Adept666/stompboxes/graphics/source_images/denis_belov.jpg

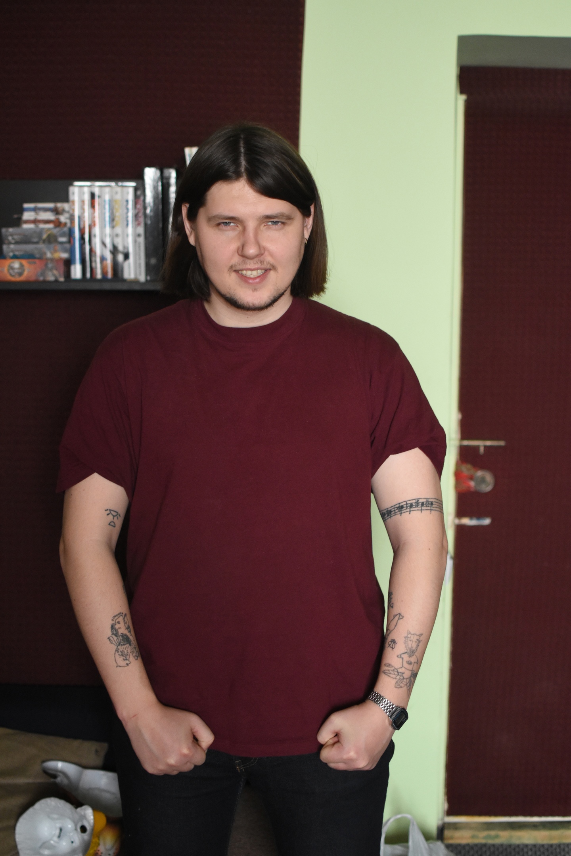
graphics/source_images/denis_belov.jpg
