Adept666/stompboxes/graphics/source_images/sasha_ogorodnikov.jpg

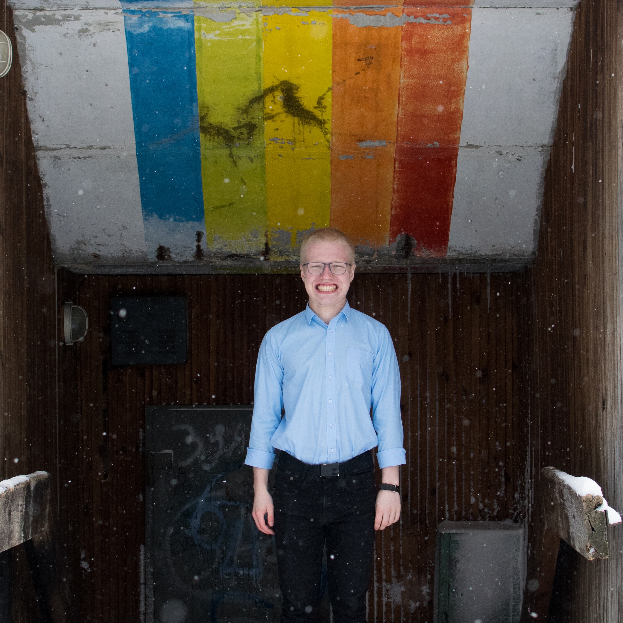
graphics/source_images/sasha_ogorodnikov.jpg
