Adept666/stompboxes/README.md

# -ТТКРЧПДЛ- / Тут короче педали

Здесь хранятся схемы и чертежи гитарных педалек *-ТТКРЧПДЛ-* (штаб-квартира: Омск, Сибирь). Купить педальки и задать вопросы можно через группу [ВКонтакте](https://vk.com/stompboxes), [Telegram-канал](https://t.me/stompboxes) или [Авито](https://www.avito.ru/brands/177f59860cf553edd7d790a341953521). Заценить звук можно на [YouTube-канале](https://youtube.com/channel/UCtStMn9qLL_V5MzlzgSMkUA). Поддержать можно с помощью [Boosty](https://boosty.to/stompboxes). Проект катастрофически убыточен и за семь лет съел тонну моих личных средств.

Distortion + PCBs

## Big Muff [REV3]

[Gerber](/PCBS-PCAS/ТКП-3.30.A/output/big_muff_r3a_gerber.zip)

### Bass

[Schematic](/PCBS-PCAS/ТКП-3.30.A/ТКП-1.30.A-2/output/ТКП-1.30.A-2-SCH.pdf)

[F_Fab](/PCBS-PCAS/ТКП-3.30.A/ТКП-1.30.A-2/output/ТКП-1.30.A-2-FAB-TOP.pdf)

[B_Fab](/PCBS-PCAS/ТКП-3.30.A/ТКП-1.30.A-2/output/ТКП-1.30.A-2-FAB-BOTTOM.pdf)

### Bass SM

[Schematic](/PCBS-PCAS/ТКП-3.30.A/ТКП-1.30.A-4/output/ТКП-1.30.A-4-SCH.pdf)

[F_Fab](/PCBS-PCAS/ТКП-3.30.A/ТКП-1.30.A-4/output/ТКП-1.30.A-4-FAB-TOP.pdf)

[B_Fab](/PCBS-PCAS/ТКП-3.30.A/ТКП-1.30.A-4/output/ТКП-1.30.A-4-FAB-BOTTOM.pdf)

### NYC

[Schematic](/PCBS-PCAS/ТКП-3.30.A/ТКП-1.30.A-1/output/ТКП-1.30.A-1-SCH.pdf)

[F_Fab](/PCBS-PCAS/ТКП-3.30.A/ТКП-1.30.A-1/output/ТКП-1.30.A-1-FAB-TOP.pdf)

[B_Fab](/PCBS-PCAS/ТКП-3.30.A/ТКП-1.30.A-1/output/ТКП-1.30.A-1-FAB-BOTTOM.pdf)

### NYC SM

[Schematic](/PCBS-PCAS/ТКП-3.30.A/ТКП-1.30.A-3/output/ТКП-1.30.A-3-SCH.pdf)

[F_Fab](/PCBS-PCAS/ТКП-3.30.A/ТКП-1.30.A-3/output/ТКП-1.30.A-3-FAB-TOP.pdf)

[B_Fab](/PCBS-PCAS/ТКП-3.30.A/ТКП-1.30.A-3/output/ТКП-1.30.A-3-FAB-BOTTOM.pdf)

## Big Muff [REV2]

[Gerber](/PCBS-PCAS/ТКП-3.13.A/output/big_muff_r2a_gerber.zip)

### Bass

[Schematic](/PCBS-PCAS/ТКП-3.13.A/ТКП-1.13.A-2/output/ТКП-1.13.A-2-SCH.pdf)

[F_Fab](/PCBS-PCAS/ТКП-3.13.A/ТКП-1.13.A-2/output/ТКП-1.13.A-2-FAB-TOP.pdf)

[B_Fab](/PCBS-PCAS/ТКП-3.13.A/ТКП-1.13.A-2/output/ТКП-1.13.A-2-FAB-BOTTOM.pdf)

### NYC

[Schematic](/PCBS-PCAS/ТКП-3.13.A/ТКП-1.13.A-1/output/ТКП-1.13.A-1-SCH.pdf)

[F_Fab](/PCBS-PCAS/ТКП-3.13.A/ТКП-1.13.A-1/output/ТКП-1.13.A-1-FAB-TOP.pdf)

[B_Fab](/PCBS-PCAS/ТКП-3.13.A/ТКП-1.13.A-1/output/ТКП-1.13.A-1-FAB-BOTTOM.pdf)

## Crumbwave Multiplexer [REV1]

[Schematic](/PCBS-PCAS/ТКП-3.32.A/ТКП-1.32.A-1/output/ТКП-1.32.A-1-SCH.pdf)

[F_Fab](/PCBS-PCAS/ТКП-3.32.A/ТКП-1.32.A-1/output/ТКП-1.32.A-1-FAB-TOP.pdf)

[B_Fab](/PCBS-PCAS/ТКП-3.32.A/ТКП-1.32.A-1/output/ТКП-1.32.A-1-FAB-BOTTOM.pdf)

[Gerber](/PCBS-PCAS/ТКП-3.32.A/output/crumbwave_multiplexer_r1a_gerber.zip)

## Deep Blue Delay [REV3]

### [REV3C]

[Gerber](/PCBS-PCAS/ТКП-3.17.C/output/deep_blue_delay_r3c_gerber.zip)

### [C]

[Schematic](/PCBS-PCAS/ТКП-3.17.C/ТКП-1.17.C-1/output/ТКП-1.17.C-1-SCH.pdf)

[F_Fab](/PCBS-PCAS/ТКП-3.17.C/ТКП-1.17.C-1/output/ТКП-1.17.C-1-FAB-TOP.pdf)

### [C] SM

[Schematic](/PCBS-PCAS/ТКП-3.17.C/ТКП-1.17.C-2/output/ТКП-1.17.C-2-SCH.pdf)

[F_Fab](/PCBS-PCAS/ТКП-3.17.C/ТКП-1.17.C-2/output/ТКП-1.17.C-2-FAB-TOP.pdf)

### [REV3B]

[Gerber](/PCBS-PCAS/ТКП-3.17.B/output/deep_blue_delay_r3b_gerber.zip)

### [B]

[Schematic](/PCBS-PCAS/ТКП-3.17.B/ТКП-1.17.B-1/output/ТКП-1.17.B-1-SCH.pdf)

[F_Fab](/PCBS-PCAS/ТКП-3.17.B/ТКП-1.17.B-1/output/ТКП-1.17.B-1-FAB-TOP.pdf)

[B_Fab](/PCBS-PCAS/ТКП-3.17.B/ТКП-1.17.B-1/output/ТКП-1.17.B-1-FAB-BOTTOM.pdf)

### [B] SM

[Schematic](/PCBS-PCAS/ТКП-3.17.B/ТКП-1.17.B-2/output/ТКП-1.17.B-2-SCH.pdf)

[F_Fab](/PCBS-PCAS/ТКП-3.17.B/ТКП-1.17.B-2/output/ТКП-1.17.B-2-FAB-TOP.pdf)

[B_Fab](/PCBS-PCAS/ТКП-3.17.B/ТКП-1.17.B-2/output/ТКП-1.17.B-2-FAB-BOTTOM.pdf)

## Distortion + [REV2]

[Schematic](/PCBS-PCAS/ТКП-3.11.A/ТКП-1.11.A-1/output/ТКП-1.11.A-1-SCH.pdf)

[F_Fab](/PCBS-PCAS/ТКП-3.11.A/ТКП-1.11.A-1/output/ТКП-1.11.A-1-FAB-TOP.pdf)

[Gerber](/PCBS-PCAS/ТКП-3.11.A/output/distortion_+_r2a_gerber.zip)

## Edamamer [REV1]

[Schematic](/PCBS-PCAS/ТКП-3.28.A/ТКП-1.28.A-1/output/ТКП-1.28.A-1-SCH.pdf)

[F_Fab](/PCBS-PCAS/ТКП-3.28.A/ТКП-1.28.A-1/output/ТКП-1.28.A-1-FAB-TOP.pdf)

[B_Fab](/PCBS-PCAS/ТКП-3.28.A/ТКП-1.28.A-1/output/ТКП-1.28.A-1-FAB-BOTTOM.pdf)

[Gerber](/PCBS-PCAS/ТКП-3.28.A/output/edamamer_r1a_gerber.zip)

## Fishtaur [REV1]

### [REV1A]

[Gerber](/PCBS-PCAS/ТКП-3.21.A/output/fishtaur_r1a_gerber.zip)

### [A]

[Schematic](/PCBS-PCAS/ТКП-3.21.A/ТКП-1.21.A-1/output/ТКП-1.21.A-1-SCH.pdf)

[F_Fab](/PCBS-PCAS/ТКП-3.21.A/ТКП-1.21.A-1/output/ТКП-1.21.A-1-FAB-TOP.pdf)

### [A] SM

[Schematic](/PCBS-PCAS/ТКП-3.21.A/ТКП-1.21.A-2/output/ТКП-1.21.A-2-SCH.pdf)

[F_Fab](/PCBS-PCAS/ТКП-3.21.A/ТКП-1.21.A-2/output/ТКП-1.21.A-2-FAB-TOP.pdf)

## Fuzz Factory [REV1]

### Main Board [REV1D] / Potentiometer Board [REV1C]

[Schematic](/PCBS-PCAS/ТКП-3.14.D-ТКП-3.15.C/ТКП-1.14.D-1-ТКП-1.15.C-1/output/ТКП-1.14.D-1-ТКП-1.15.C-1-SCH.pdf)

[F_Fab](/PCBS-PCAS/ТКП-3.14.D-ТКП-3.15.C/ТКП-1.14.D-1-ТКП-1.15.C-1/output/ТКП-1.14.D-1-ТКП-1.15.C-1-FAB-TOP.pdf)

[Gerber (Main Board)](/PCBS-PCAS/ТКП-3.14.D-ТКП-3.15.C/output/fuzz_factory_main_board_r1d_gerber.zip)

[Gerber (Potentiometer Board)](/PCBS-PCAS/ТКП-3.14.D-ТКП-3.15.C/output/fuzz_factory_potentiometer_board_r1c_gerber.zip)

### Main Board [REV1C] / Potentiometer Board [REV1B]

[Schematic](/PCBS-PCAS/ТКП-3.14.C-ТКП-3.15.B/ТКП-1.14.C-1-ТКП-1.15.B-1/output/ТКП-1.14.C-1-ТКП-1.15.B-1-SCH.pdf)

[F_Fab](/PCBS-PCAS/ТКП-3.14.C-ТКП-3.15.B/ТКП-1.14.C-1-ТКП-1.15.B-1/output/ТКП-1.14.C-1-ТКП-1.15.B-1-FAB-TOP.pdf)

[Gerber (Main Board)](/PCBS-PCAS/ТКП-3.14.C-ТКП-3.15.B/output/fuzz_factory_main_board_r1c_gerber.zip)

[Gerber (Potentiometer Board)](/PCBS-PCAS/ТКП-3.14.B-ТКП-3.15.B/output/fuzz_factory_potentiometer_board_r1b_gerber.zip)

### Main Board [REV1B] / Potentiometer Board [REV1B]

[Schematic](/PCBS-PCAS/ТКП-3.14.B-ТКП-3.15.B/ТКП-1.14.B-1-ТКП-1.15.B-1/output/ТКП-1.14.B-1-ТКП-1.15.B-1-SCH.pdf)

[F_Fab](/PCBS-PCAS/ТКП-3.14.B-ТКП-3.15.B/ТКП-1.14.B-1-ТКП-1.15.B-1/output/ТКП-1.14.B-1-ТКП-1.15.B-1-FAB-TOP.pdf)

[B_Cuts](/PCBS-PCAS/ТКП-3.14.B-ТКП-3.15.B/ТКП-1.14.B-1-ТКП-1.15.B-1/output/ТКП-1.14.B-1-ТКП-1.15.B-1-CUTS-BOTTOM.pdf)

[B_Jumpers](/PCBS-PCAS/ТКП-3.14.B-ТКП-3.15.B/ТКП-1.14.B-1-ТКП-1.15.B-1/output/ТКП-1.14.B-1-ТКП-1.15.B-1-JUMPERS-BOTTOM.pdf)

[Gerber (Main Board)](/PCBS-PCAS/ТКП-3.14.B-ТКП-3.15.B/output/fuzz_factory_main_board_r1b_gerber.zip)

[Gerber (Potentiometer Board)](/PCBS-PCAS/ТКП-3.14.B-ТКП-3.15.B/output/fuzz_factory_potentiometer_board_r1b_gerber.zip)

## Good Grief Overdrive [REV1]

### [REV1B]

[Gerber](/PCBS-PCAS/ТКП-3.19.B/output/good_grief_overdrive_r1b_gerber.zip)

### [B]

[Schematic](/PCBS-PCAS/ТКП-3.19.B/ТКП-1.19.B-1/output/ТКП-1.19.B-1-SCH.pdf)

[F_Fab](/PCBS-PCAS/ТКП-3.19.B/ТКП-1.19.B-1/output/ТКП-1.19.B-1-FAB-TOP.pdf)

### [B] SM

[Schematic](/PCBS-PCAS/ТКП-3.19.B/ТКП-1.19.B-2/output/ТКП-1.19.B-2-SCH.pdf)

[F_Fab](/PCBS-PCAS/ТКП-3.19.B/ТКП-1.19.B-2/output/ТКП-1.19.B-2-FAB-TOP.pdf)

### [REV1A]

[Schematic](/PCBS-PCAS/ТКП-3.19.A/ТКП-1.19.A-1/output/ТКП-1.19.A-1-SCH.pdf)

[F_Fab](/PCBS-PCAS/ТКП-3.19.A/ТКП-1.19.A-1/output/ТКП-1.19.A-1-FAB-TOP.pdf)

[Gerber](/PCBS-PCAS/ТКП-3.19.A/output/good_grief_overdrive_r1a_gerber.zip)

## Great Depression Phaser [REV1]

[Schematic](/PCBS-PCAS/ТКП-3.40.A/ТКП-1.38.A-1/output/ТКП-1.38.A-1-SCH.pdf)

[F_Fab](/PCBS-PCAS/ТКП-3.40.A/ТКП-1.38.A-1/output/ТКП-1.38.A-1-FAB-TOP.pdf)

[B_Fab](/PCBS-PCAS/ТКП-3.40.A/ТКП-1.38.A-1/output/ТКП-1.38.A-1-FAB-BOTTOM.pdf)

[Gerber](/PCBS-PCAS/ТКП-3.40.A/output/phaser_a_r1a_gerber.zip)

## Little Angel Chorus [REV1]

[Schematic](/PCBS-PCAS/ТКП-3.12.A/ТКП-1.12.A-1/output/ТКП-1.12.A-1-SCH.pdf)

[F_Fab](/PCBS-PCAS/ТКП-3.12.A/ТКП-1.12.A-1/output/ТКП-1.12.A-1-FAB-TOP.pdf)

[B_Fab](/PCBS-PCAS/ТКП-3.12.A/ТКП-1.12.A-1/output/ТКП-1.12.A-1-FAB-BOTTOM.pdf)

[Gerber](/PCBS-PCAS/ТКП-3.12.A/output/little_angel_chorus_r1a_gerber.zip)

## Salty Phaser [REV1]

[Schematic](/PCBS-PCAS/ТКП-3.23.A/ТКП-1.23.A-1/output/ТКП-1.23.A-1-SCH.pdf)

[F_Fab](/PCBS-PCAS/ТКП-3.23.A/ТКП-1.23.A-1/output/ТКП-1.23.A-1-FAB-TOP.pdf)

[B_Fab](/PCBS-PCAS/ТКП-3.23.A/ТКП-1.23.A-1/output/ТКП-1.23.A-1-FAB-BOTTOM.pdf)

[F_Cuts](/PCBS-PCAS/ТКП-3.23.A/ТКП-1.23.A-1/output/ТКП-1.23.A-1-CUTS-TOP.pdf)

[B_Cuts](/PCBS-PCAS/ТКП-3.23.A/ТКП-1.23.A-1/output/ТКП-1.23.A-1-CUTS-BOTTOM.pdf)

[F_Jumpers](/PCBS-PCAS/ТКП-3.23.A/ТКП-1.23.A-1/output/ТКП-1.23.A-1-JUMPERS-TOP.pdf)

[B_Jumpers](/PCBS-PCAS/ТКП-3.23.A/ТКП-1.23.A-1/output/ТКП-1.23.A-1-JUMPERS-BOTTOM.pdf)

[Gerber](/PCBS-PCAS/ТКП-3.23.A/output/salty_phaser_r1a_gerber.zip)

## Копка Земли [REV1]

### [REV1B]

[Gerber](/PCBS-PCAS/ТКП-3.24.B/output/копка_земли_r1b_gerber.zip)

### [B] Down-Tuned

[Schematic](/PCBS-PCAS/ТКП-3.24.B/ТКП-1.24.B-1/output/ТКП-1.24.B-1-SCH.pdf)

[F_Fab](/PCBS-PCAS/ТКП-3.24.B/ТКП-1.24.B-1/output/ТКП-1.24.B-1-FAB-TOP.pdf)

### [B] Down-Tuned SM

[Schematic](/PCBS-PCAS/ТКП-3.24.B/ТКП-1.24.B-3/output/ТКП-1.24.B-3-SCH.pdf)

[F_Fab](/PCBS-PCAS/ТКП-3.24.B/ТКП-1.24.B-3/output/ТКП-1.24.B-3-FAB-TOP.pdf)

### [B] Standard-Tuned

[Schematic](/PCBS-PCAS/ТКП-3.24.B/ТКП-1.24.B-2/output/ТКП-1.24.B-2-SCH.pdf)

[F_Fab](/PCBS-PCAS/ТКП-3.24.B/ТКП-1.24.B-2/output/ТКП-1.24.B-2-FAB-TOP.pdf)

### [B] Standard-Tuned SM

[Schematic](/PCBS-PCAS/ТКП-3.24.B/ТКП-1.24.B-4/output/ТКП-1.24.B-4-SCH.pdf)

[F_Fab](/PCBS-PCAS/ТКП-3.24.B/ТКП-1.24.B-4/output/ТКП-1.24.B-4-FAB-TOP.pdf)

### [REV1A]

[Gerber](/PCBS-PCAS/ТКП-3.24.A/output/копка_земли_r1a_gerber.zip)

### [A] Down-Tuned

[Schematic](/PCBS-PCAS/ТКП-3.24.A/ТКП-1.24.A-1/output/ТКП-1.24.A-1-SCH.pdf)

[F_Fab](/PCBS-PCAS/ТКП-3.24.A/ТКП-1.24.A-1/output/ТКП-1.24.A-1-FAB-TOP.pdf)

### [A] Standard-Tuned

[Schematic](/PCBS-PCAS/ТКП-3.24.A/ТКП-1.24.A-2/output/ТКП-1.24.A-2-SCH.pdf)

[F_Fab](/PCBS-PCAS/ТКП-3.24.A/ТКП-1.24.A-2/output/ТКП-1.24.A-2-FAB-TOP.pdf)

## Крыса [REV1]

[Schematic](/PCBS-PCAS/ТКП-3.44.A/ТКП-1.40.A-1/output/ТКП-1.40.A-1-SCH.pdf)

[F_Fab](/PCBS-PCAS/ТКП-3.44.A/ТКП-1.40.A-1/output/ТКП-1.40.A-1-FAB-TOP.pdf)

[Gerber](/PCBS-PCAS/ТКП-3.44.A/output/clipper_a_r1a_gerber.zip)

## Тремоло Саши Огородникова [REV1]

### [REV1B]

[Schematic](/PCBS-PCAS/ТКП-3.25.B/ТКП-1.25.B-1/output/ТКП-1.25.B-1-SCH.pdf)

[F_Fab](/PCBS-PCAS/ТКП-3.25.B/ТКП-1.25.B-1/output/ТКП-1.25.B-1-FAB-TOP.pdf)

[B_Fab](/PCBS-PCAS/ТКП-3.25.B/ТКП-1.25.B-1/output/ТКП-1.25.B-1-FAB-BOTTOM.pdf)

[Gerber](/PCBS-PCAS/ТКП-3.25.B/output/тремоло_саши_огородникова_r1b_gerber.zip)

### [REV1A]

[Schematic](/PCBS-PCAS/ТКП-3.25.A/ТКП-1.25.A-1/output/ТКП-1.25.A-1-SCH.pdf)

[F_Fab](/PCBS-PCAS/ТКП-3.25.A/ТКП-1.25.A-1/output/ТКП-1.25.A-1-FAB-TOP.pdf)

[B_Fab](/PCBS-PCAS/ТКП-3.25.A/ТКП-1.25.A-1/output/ТКП-1.25.A-1-FAB-BOTTOM.pdf)

[F_Cuts](/PCBS-PCAS/ТКП-3.25.A/ТКП-1.25.A-1/output/ТКП-1.25.A-1-CUTS-TOP.pdf)

[B_Cuts](/PCBS-PCAS/ТКП-3.25.A/ТКП-1.25.A-1/output/ТКП-1.25.A-1-CUTS-BOTTOM.pdf)

[B_Jumpers](/PCBS-PCAS/ТКП-3.25.A/ТКП-1.25.A-1/output/ТКП-1.25.A-1-JUMPERS-BOTTOM.pdf)

[Gerber](/PCBS-PCAS/ТКП-3.25.A/output/тремоло_саши_огородникова_r1a_gerber.zip)

## Требования

Работа с исходными файлами осуществляется в программе [KiCad](https://kicad.org).

Для просмотра и редактирования принципиальных схем необходимо подключить следующие библиотеки символов:
* [KCL](https://github.com/Adept666/KCL)
* [SBKCL](/SBKCL)

Для работы с чертежами печатных узлов подключение библиотек не требуется, так как все использованные футпринты вшиты в файлы *.kicad_pcb. При необходимости футпринты могут быть найдены в библиотеках [KCL](https://github.com/Adept666/KCL) и [SBKCL](/SBKCL).

## Авторы

Основной разработчик: *Igor Ivanov* (*Игорь Иванов*).  
Связь: adept.666.1993@gmail.com • [Telegram](https://t.me/adept666_2) • [ВКонтакте](https://vk.com/igor_ivanov_93) • [Google Scholar](https://scholar.google.com/citations?user=dhN1LfkAAAAJ).

Репозиторий также содержит сторонние открытые изображения и шрифты, использованные при создании макетов рисунков, наносимых на корпуса педалей. Информация об авторах и лицензиях представлена в сопроводительных текстовых файлах, размещённых в соответствующих директориях.

## Лицензии

Настоящий репозиторий использует раздельное лицензирование:

* Основная часть файлов распространяется на условиях *GNU General Public License v3.0 or later*, если не указано иное.

* Проекты печатных плат [Clipper A](/PCBS-PCAS/ТКП-3.44.A) и [OCD](/PCBS-PCAS/ТКП-3.45.A) распространяются на условиях *CERN Open Hardware Licence Version 2 - Strongly Reciprocal*.

* Сторонние [изображения](/graphics/source_images) и [шрифты](/graphics/source_fonts) распространяются на условиях иных лицензий, указанных в соответствующих файлах.
