Adept666/stompboxes/SILKSCREEN/pdf_clean_white/big_muff_r2_bass_1.pdf

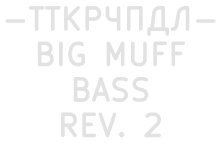
[picture p3: figure]
