Adept666/stompboxes/SILKSCREEN/pdf_clean_white/big_muff_r2_nyc_1.pdf

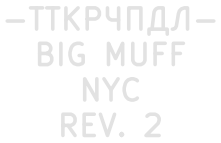
[picture p4: figure]
