Adept666/stompboxes/graphics/source_images/dima.jpg

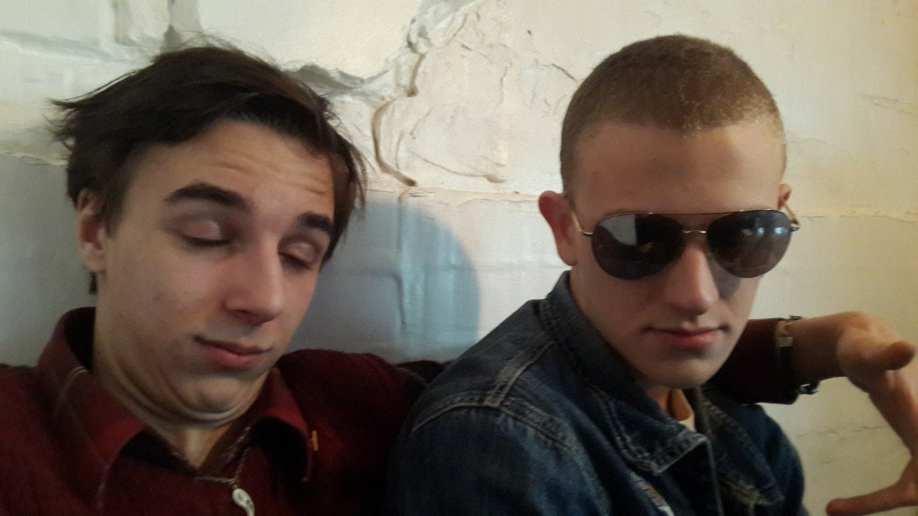
graphics/source_images/dima.jpg
