Adept666/stompboxes/graphics/source_images/dima_crumb.jpg

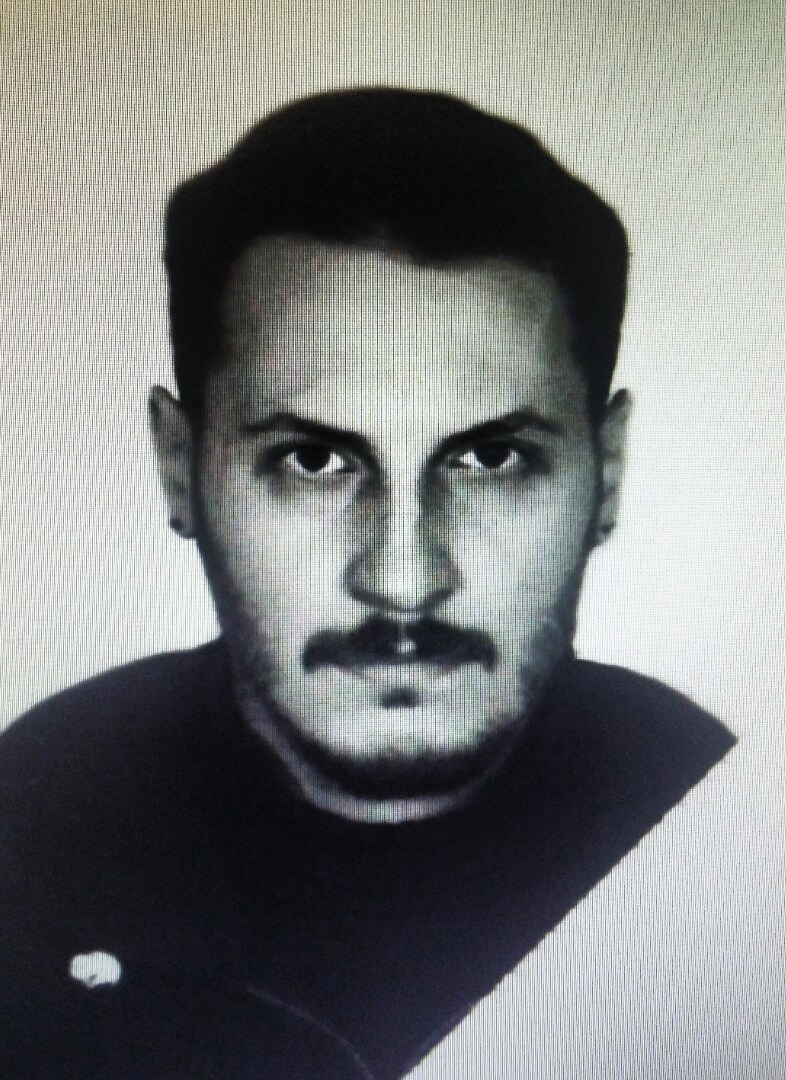
graphics/source_images/dima_crumb.jpg
