Adept666/stompboxes/graphics/source_images/dima_osipkin.jpg

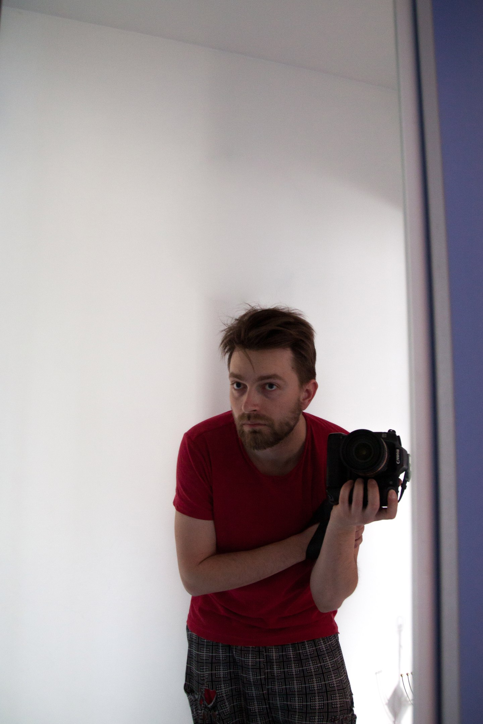
graphics/source_images/dima_osipkin.jpg
