Adept666/stompboxes/graphics/source_images/egor.jpg

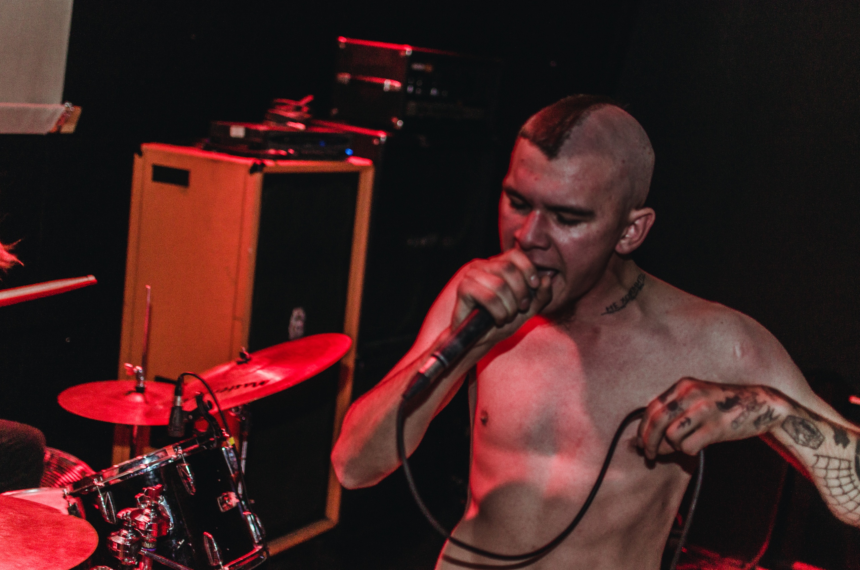
graphics/source_images/egor.jpg
