Adept666/stompboxes/graphics/source_images/gosha.jpg

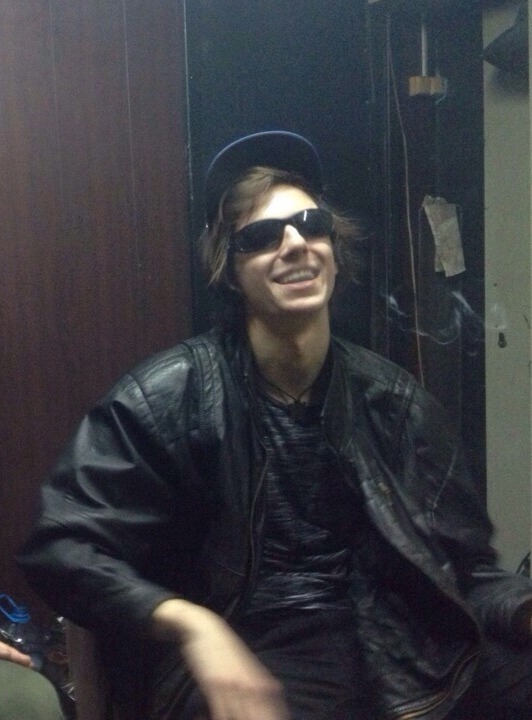
graphics/source_images/gosha.jpg
