Adept666/stompboxes/graphics/source_images/mole.png

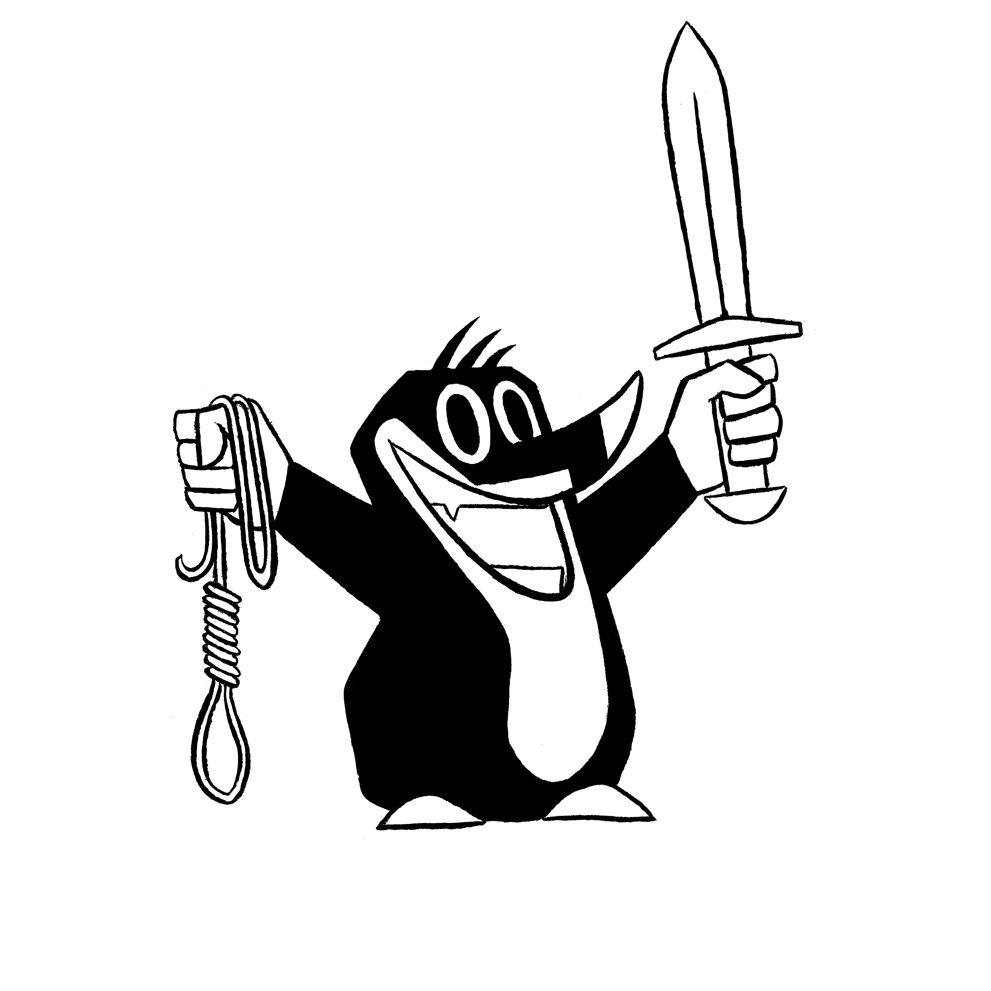
graphics/source_images/mole.png
