Adept666/stompboxes/graphics/source_images/salty_cracker.jpg

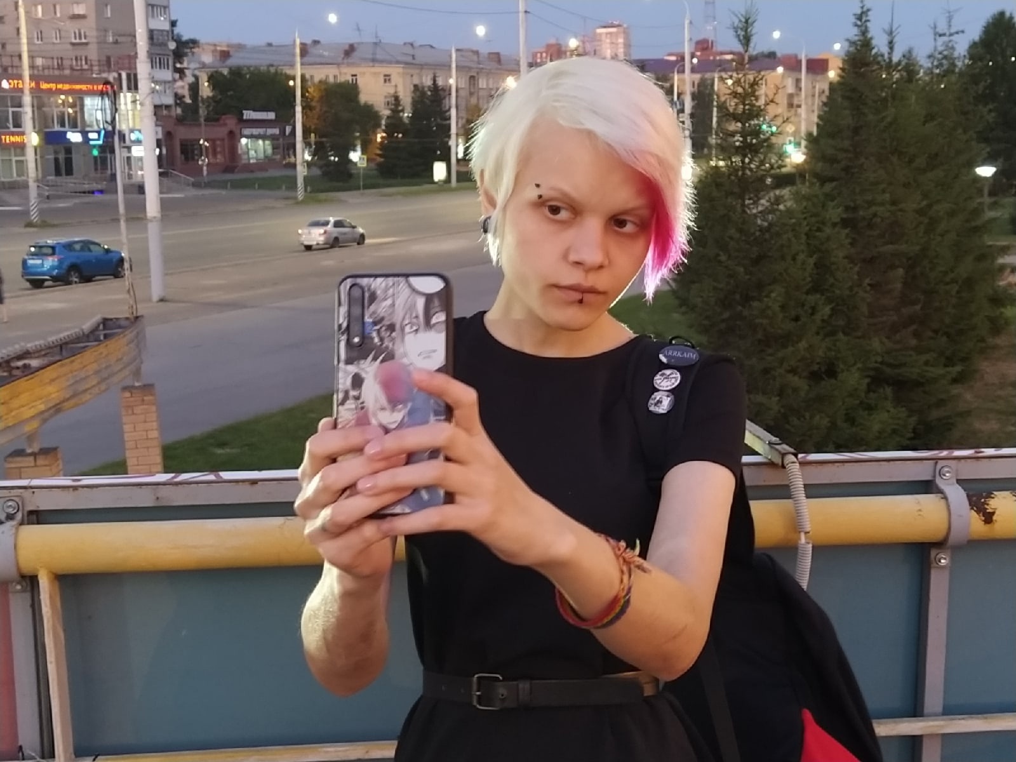
graphics/source_images/salty_cracker.jpg
