Adept666/stompboxes/graphics/source_images/stargazer.jpg

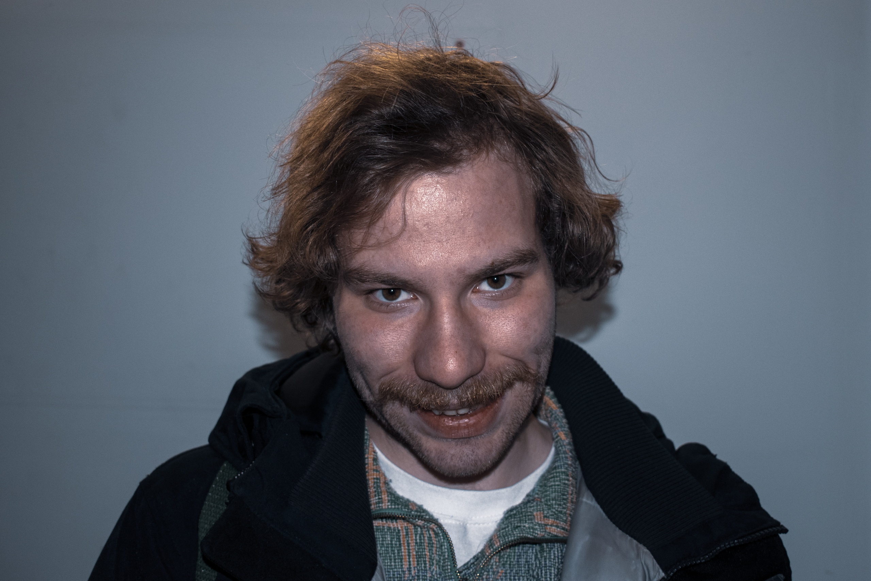
graphics/source_images/stargazer.jpg
