Adept666/stompboxes/ENCLOSURE_PARTS/ТКП-6.1.1.A1/ТКП-6.1.1.A1_1590BB_Box_A_V1.FCStd

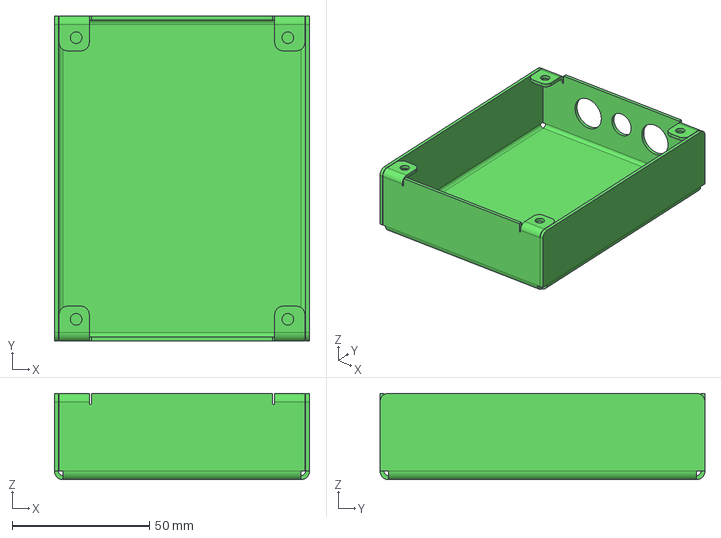
[picture p13: CAD file, 2023-07-02]
ENCLOSURE_PARTS/ТКП-6.1.1.A1/ТКП-6.1.1.A1_1590BB_Box_A_V1.FCStd
93.0 x 118.5 x 31.5 mm
