Adept666/stompboxes/ENCLOSURE_PARTS/ТКП-6.1.2.A1/ТКП-6.1.2.A1_1590BB_Spacer_A_V1.FCStd

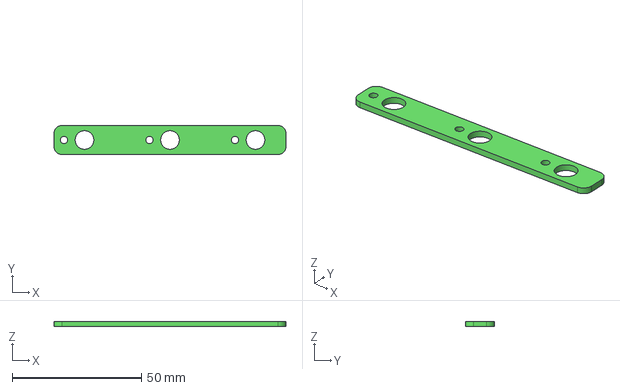
[picture p14: CAD file, 2023-07-02]
ENCLOSURE_PARTS/ТКП-6.1.2.A1/ТКП-6.1.2.A1_1590BB_Spacer_A_V1.FCStd
89.6 x 11.2 x 2.00 mm
