Adept666/stompboxes/ENCLOSURE_PARTS/ТКП-6.1.3.A1/ТКП-6.1.3.A1_1590BB_Panel_A_V1.FCStd

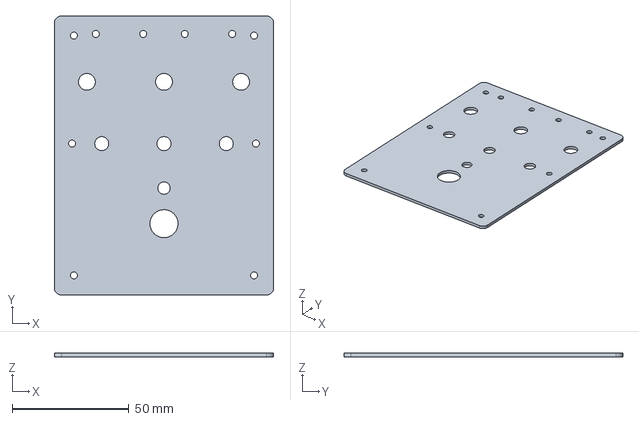
[picture p15: CAD file, 2023-07-02]
ENCLOSURE_PARTS/ТКП-6.1.3.A1/ТКП-6.1.3.A1_1590BB_Panel_A_V1.FCStd
94.0 x 119.5 x 1.50 mm
