Adept666/stompboxes/ENCLOSURE_PARTS/ТКП-6.1.4.A1/ТКП-6.1.4.A1_1590BB_Plate_A_V1.FCStd

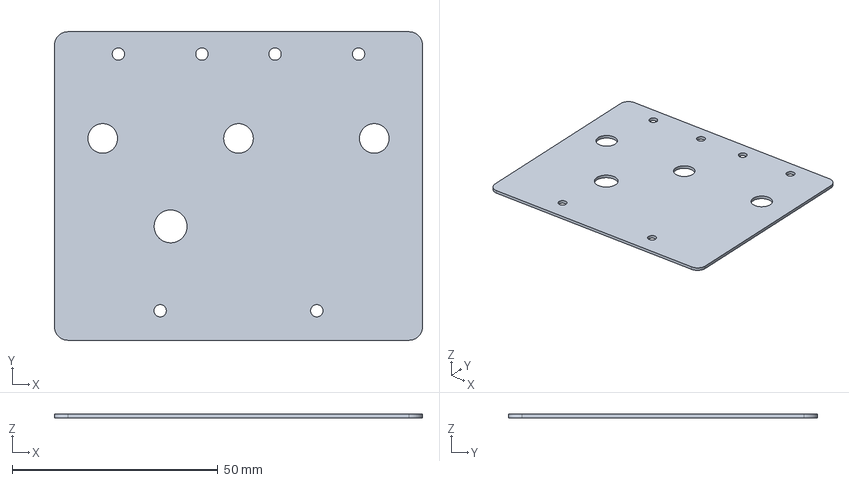
[picture p16: CAD file, 2023-07-02]
ENCLOSURE_PARTS/ТКП-6.1.4.A1/ТКП-6.1.4.A1_1590BB_Plate_A_V1.FCStd
89.5 x 75.0 x 1.00 mm
