Adept666/stompboxes/ENCLOSURE_PARTS/ТКП-6.2.1.A1/ТКП-6.2.1.A1_1590N1_Box_A_V1.FCStd

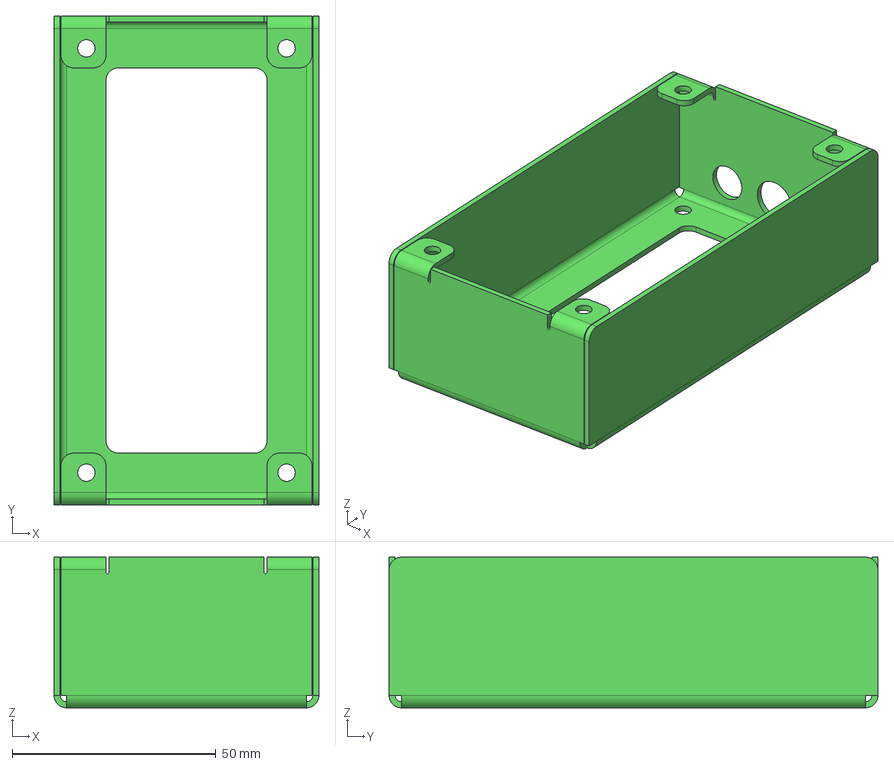
[picture p17: CAD file, 2023-07-02]
ENCLOSURE_PARTS/ТКП-6.2.1.A1/ТКП-6.2.1.A1_1590N1_Box_A_V1.FCStd
65.0 x 120.0 x 37.0 mm
