Adept666/stompboxes/ENCLOSURE_PARTS/ТКП-6.2.2.A1/ТКП-6.2.2.A1_1590N1_Panel_bottom_A_V1.FCStd

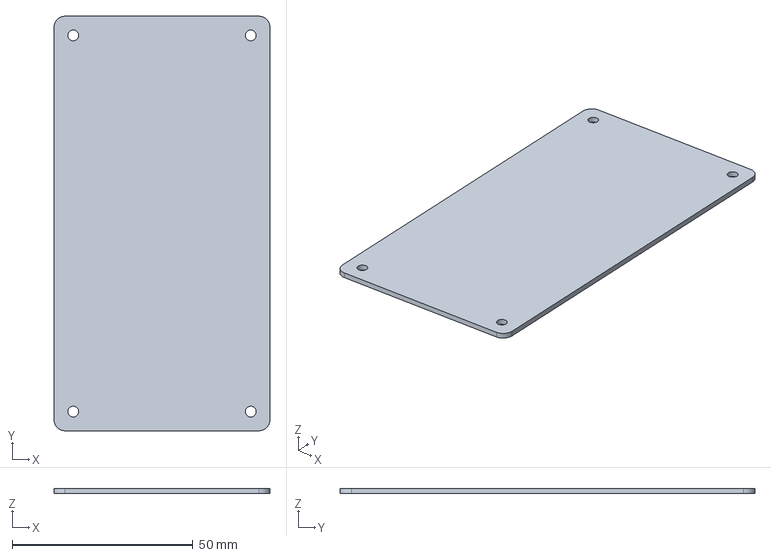
[picture p18: CAD file, 2023-07-02]
ENCLOSURE_PARTS/ТКП-6.2.2.A1/ТКП-6.2.2.A1_1590N1_Panel_bottom_A_V1.FCStd
59.8 x 114.8 x 1.50 mm
