Adept666/stompboxes/ENCLOSURE_PARTS/ТКП-6.2.3.A1/ТКП-6.2.3.A1_1590N1_Spacer_A_V1.FCStd

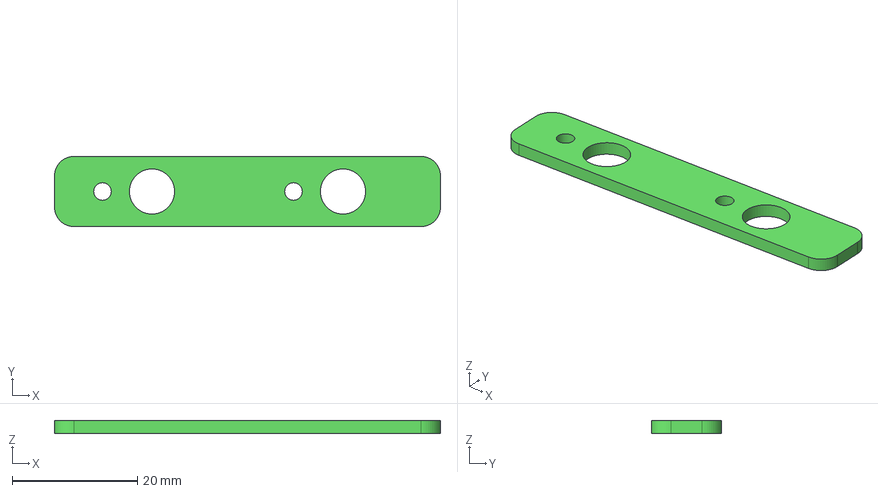
[picture p19: CAD file, 2023-07-02]
ENCLOSURE_PARTS/ТКП-6.2.3.A1/ТКП-6.2.3.A1_1590N1_Spacer_A_V1.FCStd
61.6 x 11.2 x 2.00 mm
