Adept666/stompboxes/ENCLOSURE_PARTS/ТКП-6.2.4.A1/ТКП-6.2.4.A1_1590N1_Panel_top_A_V1.FCStd

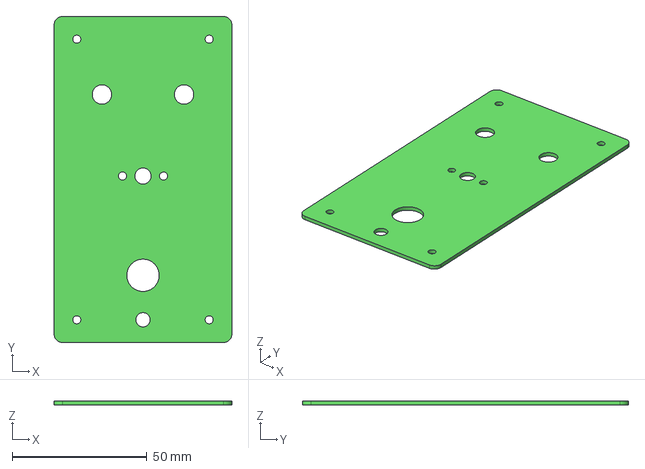
[picture p20: CAD file, 2023-07-02]
ENCLOSURE_PARTS/ТКП-6.2.4.A1/ТКП-6.2.4.A1_1590N1_Panel_top_A_V1.FCStd
66.0 x 121.0 x 1.50 mm
