Adept666/stompboxes/ENCLOSURE_PARTS/ТКП-6.3.1.A1/ТКП-6.3.1.A1_B013_Base_A_V1.FCStd

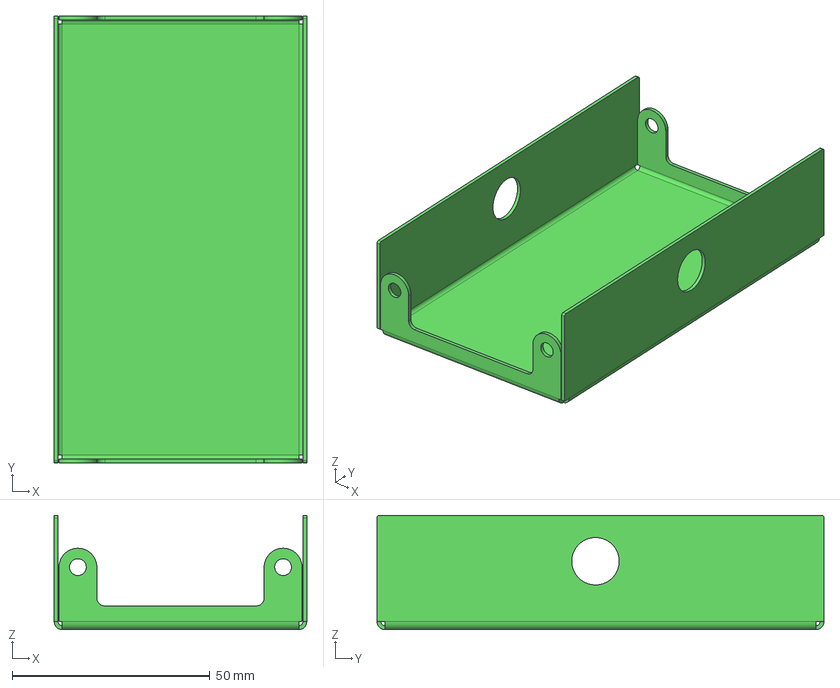
[picture p21: CAD file, 2023-09-24]
ENCLOSURE_PARTS/ТКП-6.3.1.A1/ТКП-6.3.1.A1_B013_Base_A_V1.FCStd
63.9 x 113.2 x 28.9 mm
