Adept666/stompboxes/ENCLOSURE_PARTS/ТКП-6.3.2.A1/ТКП-6.3.2.A1_B013_Spacer_A_V1.FCStd

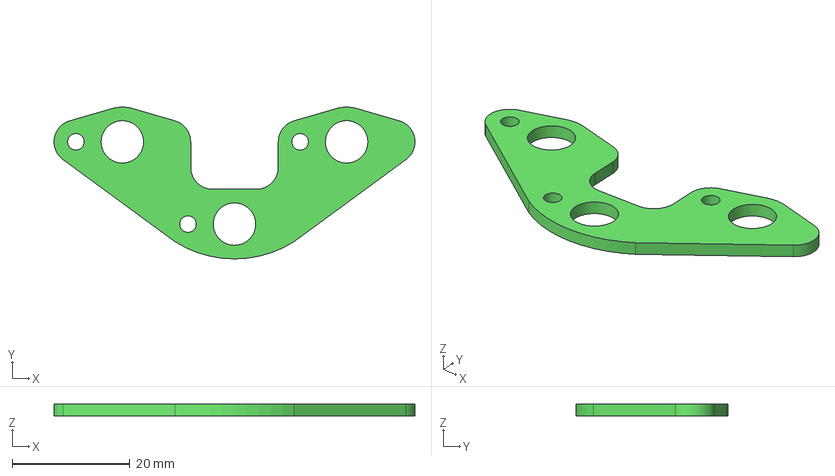
[picture p22: CAD file, 2023-09-18]
ENCLOSURE_PARTS/ТКП-6.3.2.A1/ТКП-6.3.2.A1_B013_Spacer_A_V1.FCStd
61.3 x 25.8 x 2.00 mm
