Adept666/stompboxes/ENCLOSURE_PARTS/ТКП-6.3.3.A1/ТКП-6.3.3.A1_B013_Cover_A_V1.FCStd

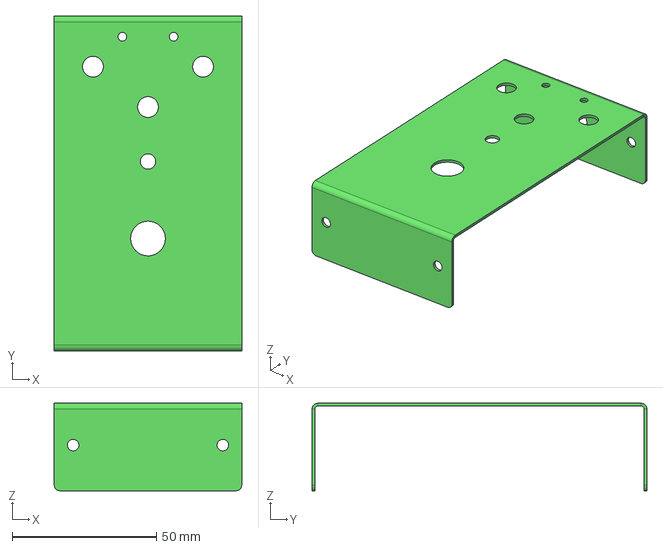
[picture p23: CAD file, 2023-11-25]
ENCLOSURE_PARTS/ТКП-6.3.3.A1/ТКП-6.3.3.A1_B013_Cover_A_V1.FCStd
64.9 x 116.0 x 30.3 mm
