Adept666/stompboxes/ENCLOSURE_PARTS/ТКП-6.4.1.A1/ТКП-6.4.1.A1_B013-H_Base_A1.FCStd

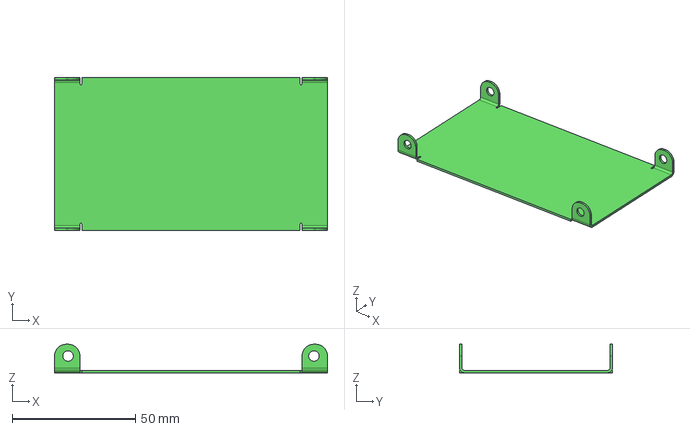
[picture p24: CAD file, 2024-03-02]
ENCLOSURE_PARTS/ТКП-6.4.1.A1/ТКП-6.4.1.A1_B013-H_Base_A1.FCStd
110.7 x 62.0 x 11.6 mm
