Adept666/stompboxes/ENCLOSURE_PARTS/ТКП-6.4.2.A1.A1/ТКП-6.4.2.A1.A1_B013-H_Box_A1-A1.FCStd

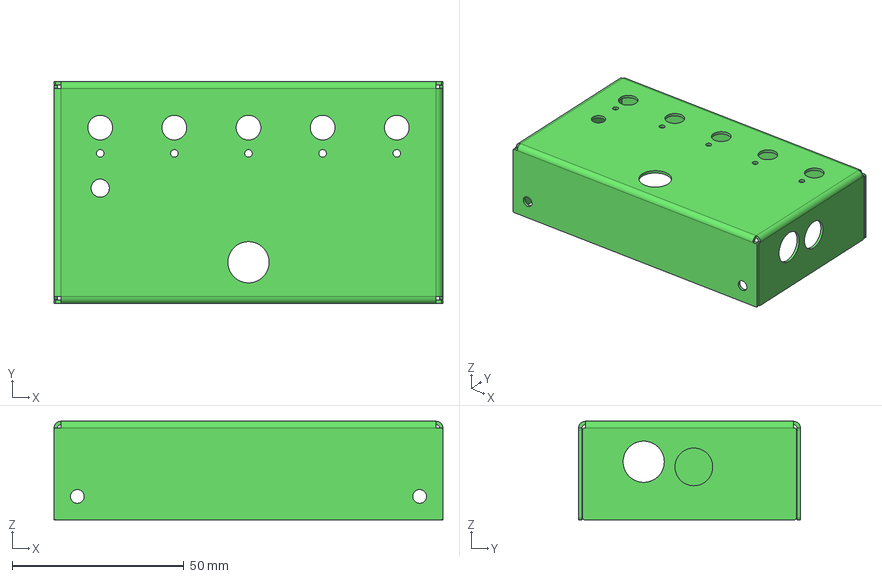
[picture p25: CAD file, 2024-03-02]
ENCLOSURE_PARTS/ТКП-6.4.2.A1.A1/ТКП-6.4.2.A1.A1_B013-H_Box_A1-A1.FCStd
113.3 x 64.6 x 28.7 mm
