Adept666/stompboxes/graphics/engraving_layouts/ТКП-6.1.3-BOTTOM/A1/ТКП-6.1.3-B-A1.3_dxf_outline.dxf

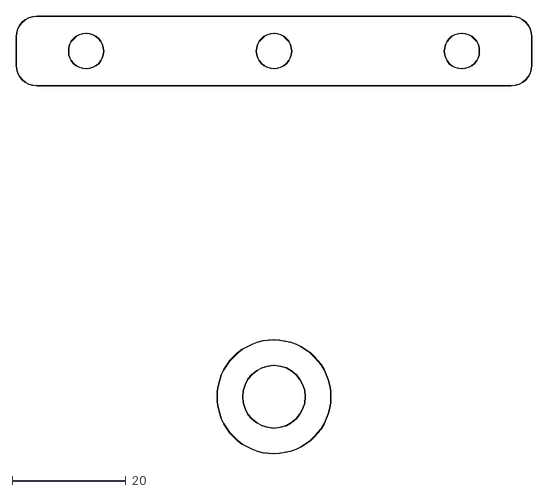
[picture p26: CAD file, 2023-06-22]
graphics/engraving_layouts/ТКП-6.1.3-BOTTOM/A1/ТКП-6.1.3-B-A1.3_dxf_outline.dxf
90.6 x 76.9
