Adept666/stompboxes/graphics/engraving_layouts/ТКП-6.1.3-BOTTOM/A2/ТКП-6.1.3-B-A2.3_dxf_outline.dxf

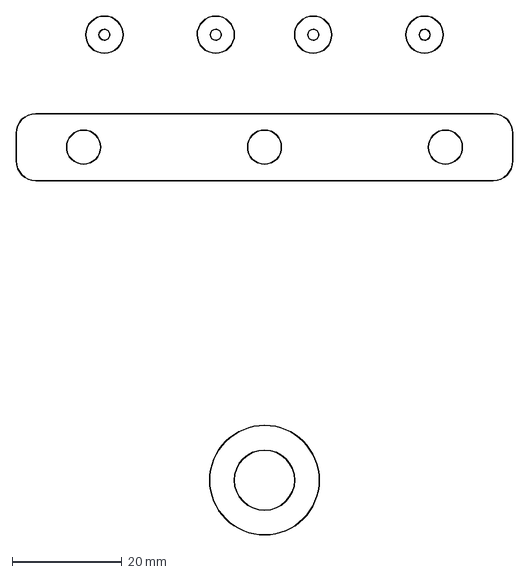
[picture p27: CAD file, 2024-08-10]
graphics/engraving_layouts/ТКП-6.1.3-BOTTOM/A2/ТКП-6.1.3-B-A2.3_dxf_outline.dxf
90.6 x 94.7 mm
