Adept666/stompboxes/graphics/engraving_layouts/ТКП-6.1.3-BOTTOM/B1/ТКП-6.1.3-B-B1.3_dxf_outline.dxf

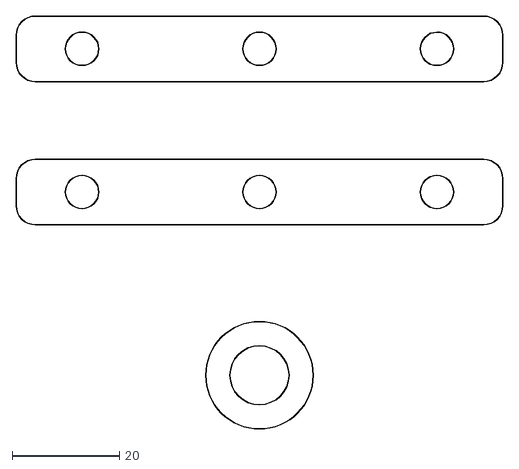
[picture p28: CAD file, 2023-06-22]
graphics/engraving_layouts/ТКП-6.1.3-BOTTOM/B1/ТКП-6.1.3-B-B1.3_dxf_outline.dxf
90.6 x 76.9
