Adept666/stompboxes/graphics/engraving_layouts/ТКП-6.1.3-BOTTOM/B2/ТКП-6.1.3-B-B2.3_dxf_outline.dxf

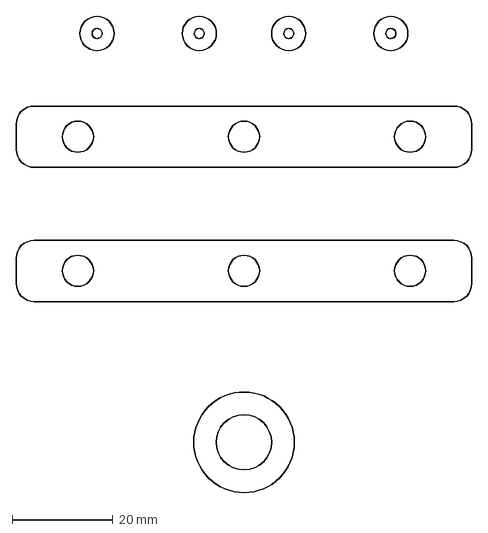
[picture p29: CAD file, 2024-06-06]
graphics/engraving_layouts/ТКП-6.1.3-BOTTOM/B2/ТКП-6.1.3-B-B2.3_dxf_outline.dxf
90.6 x 94.7 mm
