Adept666/stompboxes/graphics/engraving_layouts/ТКП-6.1.3-BOTTOM/C1/ТКП-6.1.3-B-C1.3_dxf_outline.dxf

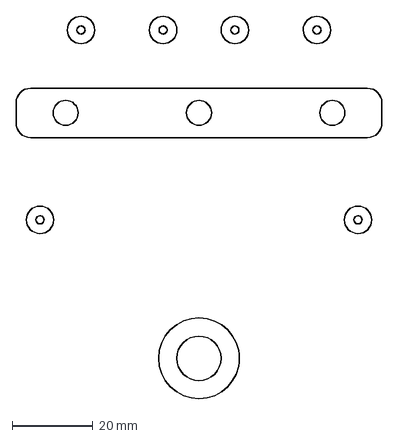
[picture p30: CAD file, 2024-06-06]
graphics/engraving_layouts/ТКП-6.1.3-BOTTOM/C1/ТКП-6.1.3-B-C1.3_dxf_outline.dxf
90.6 x 94.7 mm
