Adept666/stompboxes/graphics/engraving_layouts/ТКП-6.1.3-BOTTOM/D1/ТКП-6.1.3-B-D1.3_dxf_outline.dxf

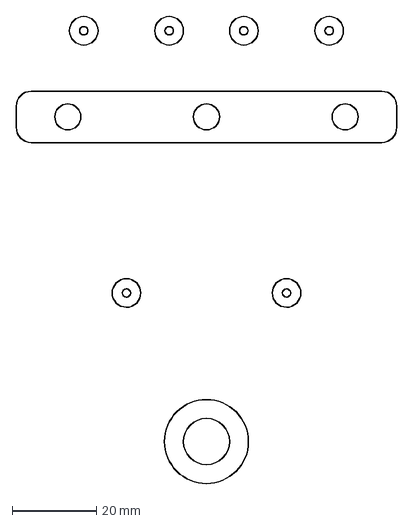
[picture p31: CAD file, 2023-12-24]
graphics/engraving_layouts/ТКП-6.1.3-BOTTOM/D1/ТКП-6.1.3-B-D1.3_dxf_outline.dxf
90.6 x 111.2 mm
