Adept666/stompboxes/graphics/engraving_layouts/ТКП-6.1.3-TOP/A1/ТКП-6.1.3-T-A1.4_dxf_outline.dxf

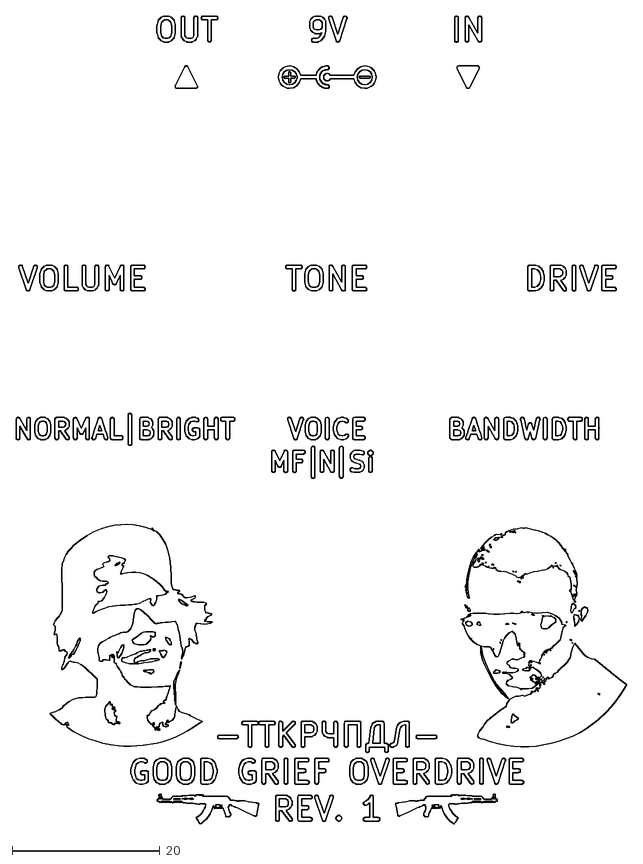
[picture p32: CAD file, 2023-06-21]
graphics/engraving_layouts/ТКП-6.1.3-TOP/A1/ТКП-6.1.3-T-A1.4_dxf_outline.dxf
82.6 x 109.2
