Adept666/stompboxes/graphics/engraving_layouts/ТКП-6.1.3-TOP/B1/ТКП-6.1.3-T-B1.4_dxf_outline.dxf

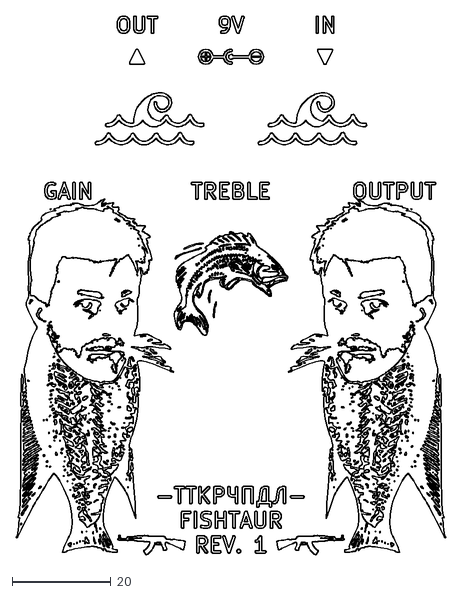
[picture p33: CAD file, 2023-06-22]
graphics/engraving_layouts/ТКП-6.1.3-TOP/B1/ТКП-6.1.3-T-B1.4_dxf_outline.dxf
87.0 x 109.2
