Adept666/stompboxes/graphics/engraving_layouts/ТКП-6.1.3-TOP/C1/ТКП-6.1.3-T-C1.4_dxf_outline.dxf

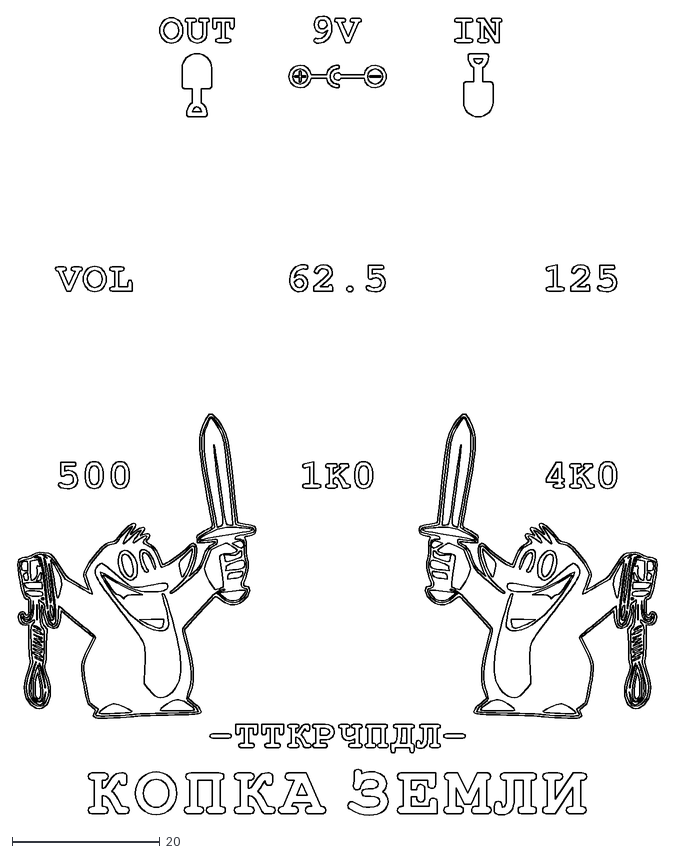
[picture p34: CAD file, 2023-06-22]
graphics/engraving_layouts/ТКП-6.1.3-TOP/C1/ТКП-6.1.3-T-C1.4_dxf_outline.dxf
87.0 x 108.2
