Adept666/stompboxes/graphics/engraving_layouts/ТКП-6.1.3-TOP/E1/ТКП-6.1.3-T-E1.4_dxf_outline.dxf

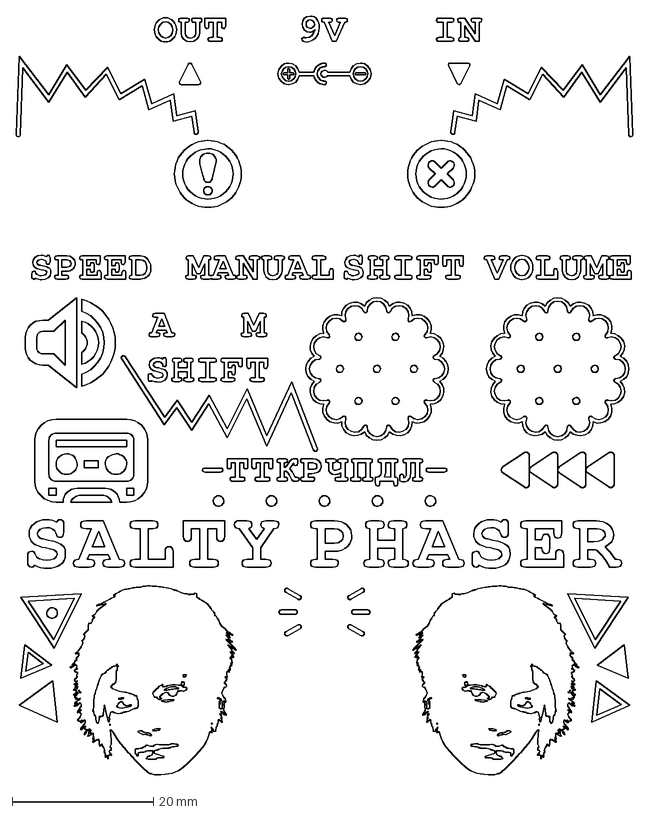
[picture p36: CAD file, 2024-02-10]
graphics/engraving_layouts/ТКП-6.1.3-TOP/E1/ТКП-6.1.3-T-E1.4_dxf_outline.dxf
87.4 x 107.5 mm
