Adept666/stompboxes/graphics/engraving_layouts/ТКП-6.1.4-TOP/A1/ТКП-6.1.4-T-A1.4_dxf_outline.dxf

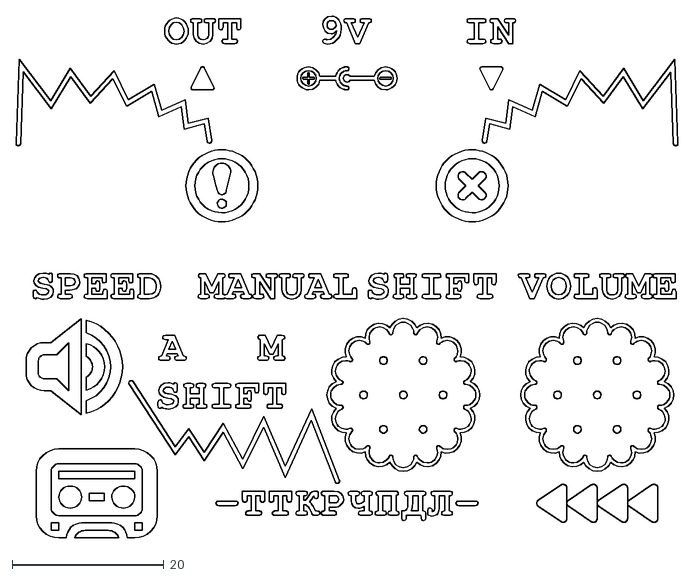
[picture p37: CAD file, 2023-06-25]
graphics/engraving_layouts/ТКП-6.1.4-TOP/A1/ТКП-6.1.4-T-A1.4_dxf_outline.dxf
87.4 x 68.8
