Adept666/stompboxes/graphics/engraving_layouts/ТКП-6.2.4-BOTTOM/A1/ТКП-6.2.4-B-A1.3_dxf_outline.dxf

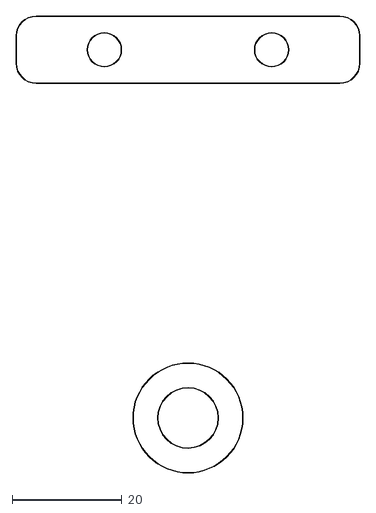
[picture p38: CAD file, 2023-06-22]
graphics/engraving_layouts/ТКП-6.2.4-BOTTOM/A1/ТКП-6.2.4-B-A1.3_dxf_outline.dxf
62.6 x 83.2
