Adept666/stompboxes/graphics/engraving_layouts/ТКП-6.2.4-BOTTOM/A2/ТКП-6.2.4-B-A2.3_dxf_outline.dxf

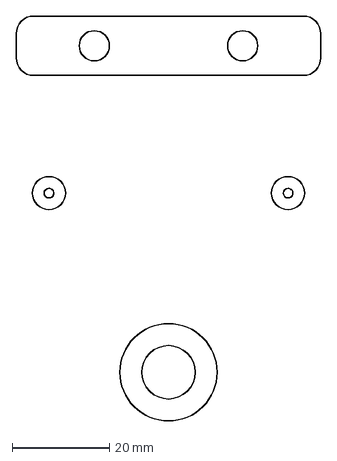
[picture p39: CAD file, 2025-01-23]
graphics/engraving_layouts/ТКП-6.2.4-BOTTOM/A2/ТКП-6.2.4-B-A2.3_dxf_outline.dxf
62.6 x 83.2 mm
