Adept666/stompboxes/graphics/engraving_layouts/ТКП-6.2.4-TOP/A1/ТКП-6.2.4-T-A1.4_dxf_outline.dxf

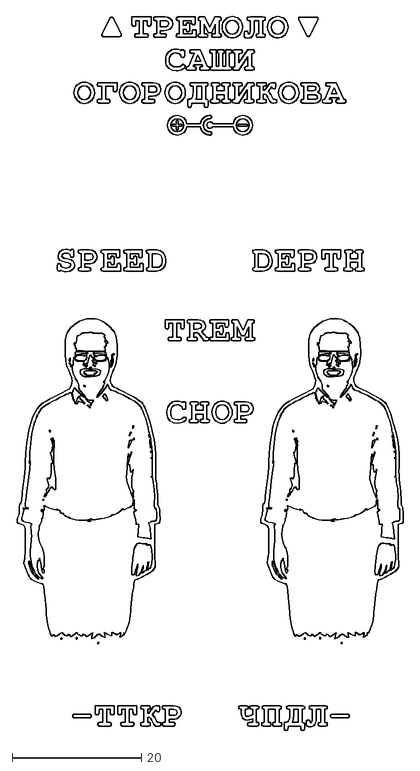
[picture p40: CAD file, 2023-06-11]
graphics/engraving_layouts/ТКП-6.2.4-TOP/A1/ТКП-6.2.4-T-A1.4_dxf_outline.dxf
60.0 x 110.6
