Adept666/stompboxes/graphics/engraving_layouts/ТКП-6.2.4-TOP/B1/ТКП-6.2.4-T-B1.4_dxf_outline.dxf

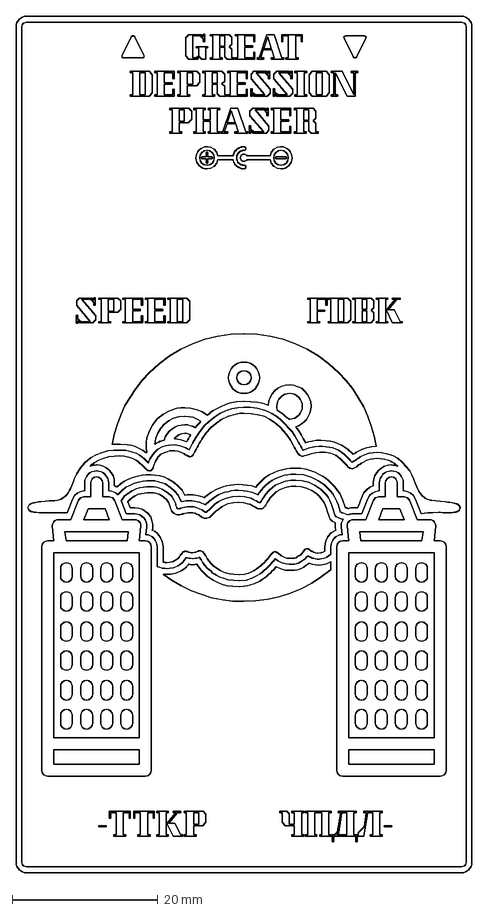
[picture p41: CAD file, 2025-02-19]
graphics/engraving_layouts/ТКП-6.2.4-TOP/B1/ТКП-6.2.4-T-B1.4_dxf_outline.dxf
62.6 x 117.6 mm
