Adept666/stompboxes/graphics/engraving_layouts/ТКП-6.3.3-BOTTOM/A1/ТКП-6.3.3-B-A1.3_dxf_outline.dxf

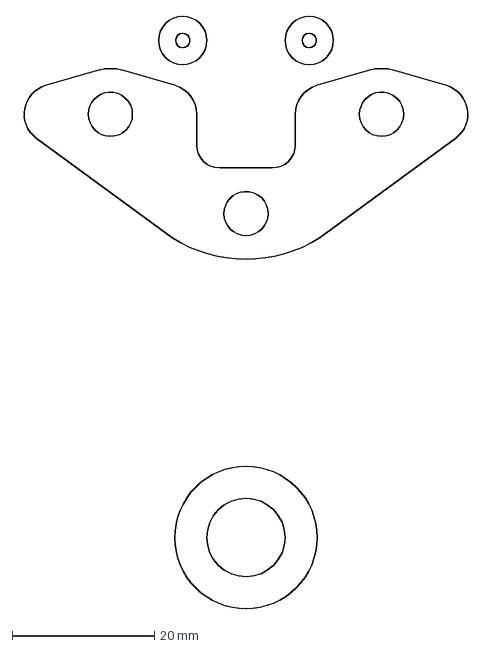
[picture p42: CAD file, 2023-11-24]
graphics/engraving_layouts/ТКП-6.3.3-BOTTOM/A1/ТКП-6.3.3-B-A1.3_dxf_outline.dxf
64.5 x 83.3 mm
