Adept666/stompboxes/graphics/engraving_layouts/ТКП-6.3.3-BOTTOM/B1/ТКП-6.3.3-B-B1.3_dxf_outline.dxf

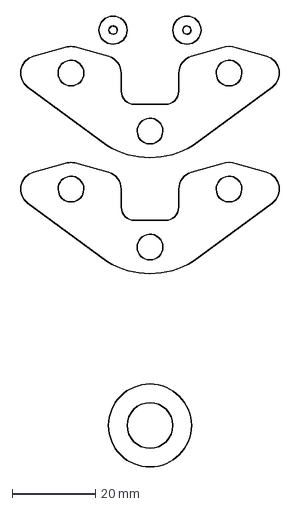
[picture p43: CAD file, 2024-08-04]
graphics/engraving_layouts/ТКП-6.3.3-BOTTOM/B1/ТКП-6.3.3-B-B1.3_dxf_outline.dxf
64.5 x 108.7 mm
