Adept666/stompboxes/graphics/engraving_layouts/ТКП-6.3.3-TOP/A1/ТКП-6.3.3-T-A1.4_dxf_outline.dxf

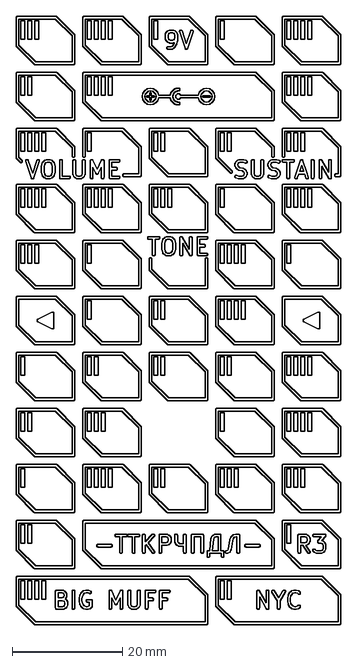
[picture p44: CAD file, 2025-06-07]
graphics/engraving_layouts/ТКП-6.3.3-TOP/A1/ТКП-6.3.3-T-A1.4_dxf_outline.dxf
58.9 x 110.4 mm
