Adept666/stompboxes/graphics/engraving_layouts/ТКП-6.3.3-TOP/B1/ТКП-6.3.3-T-B1.4_dxf_outline.dxf

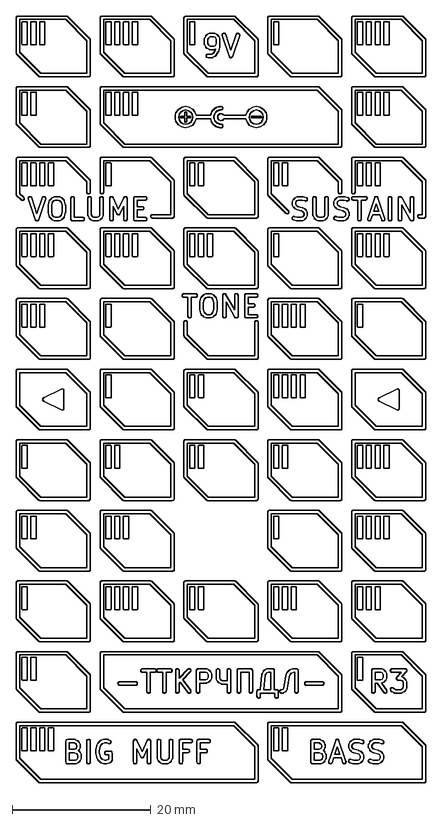
[picture p45: CAD file, 2025-06-07]
graphics/engraving_layouts/ТКП-6.3.3-TOP/B1/ТКП-6.3.3-T-B1.4_dxf_outline.dxf
58.9 x 110.4 mm
