Adept666/stompboxes/graphics/engraving_layouts/ТКП-6.3.3-TOP/C1/ТКП-6.3.3-T-C1.4_dxf_outline.dxf

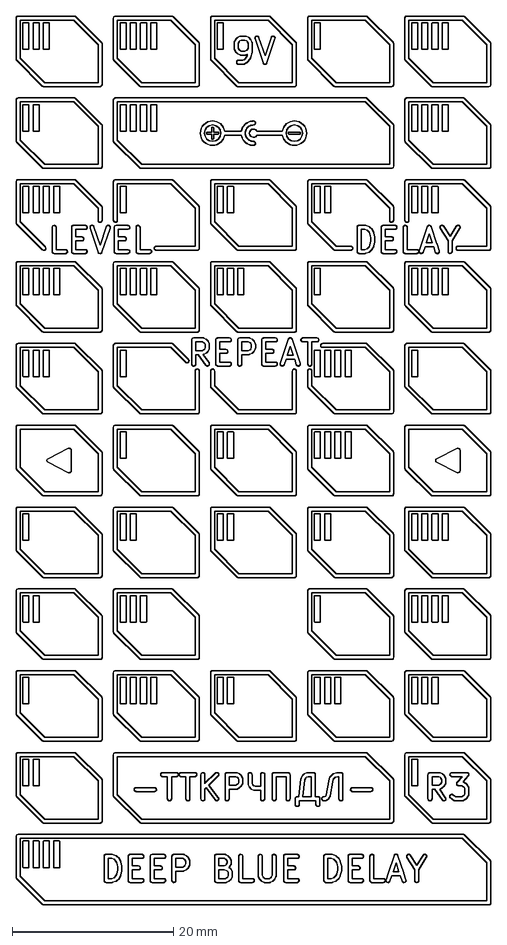
[picture p46: CAD file, 2025-06-12]
graphics/engraving_layouts/ТКП-6.3.3-TOP/C1/ТКП-6.3.3-T-C1.4_dxf_outline.dxf
58.9 x 110.4 mm
