Adept666/stompboxes/graphics/engraving_layouts/ТКП-6.3.3-TOP/D1/ТКП-6.3.3-T-D1.4_dxf_outline.dxf

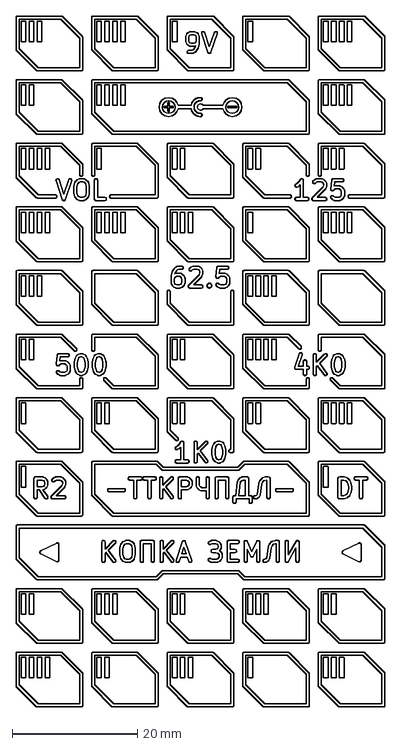
[picture p47: CAD file, 2024-08-04]
graphics/engraving_layouts/ТКП-6.3.3-TOP/D1/ТКП-6.3.3-T-D1.4_dxf_outline.dxf
58.9 x 110.4 mm
