Adept666/stompboxes/graphics/engraving_layouts/ТКП-6.4.2-BOTTOM/A1/ТКП-6.4.2-B-A1.3_dxf_outline.dxf

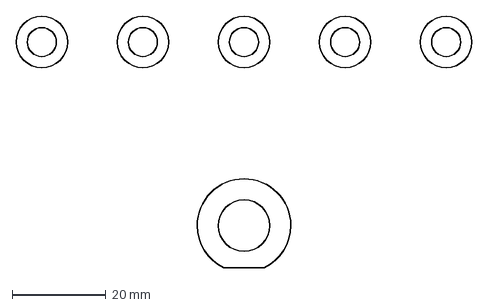
[picture p48: CAD file, 2024-02-15]
graphics/engraving_layouts/ТКП-6.4.2-BOTTOM/A1/ТКП-6.4.2-B-A1.3_dxf_outline.dxf
97.4 x 53.7 mm
