Adept666/stompboxes/graphics/engraving_layouts/ТКП-6.4.2-TOP/A1/ТКП-6.4.2-T-A1.4_dxf_outline.dxf

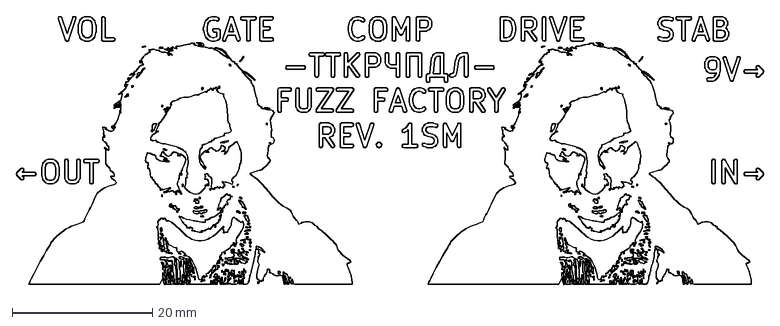
[picture p49: CAD file, 2024-02-05]
graphics/engraving_layouts/ТКП-6.4.2-TOP/A1/ТКП-6.4.2-T-A1.4_dxf_outline.dxf
106.4 x 38.4 mm
