Adept666/stompboxes/(list of files, cad)

Other CAD files:
ENCLOSURE_PARTS/ТКП-6.1.1.B1/ТКП-6.1.1.B1_1590BB_Box_B_V1.FCStd
ENCLOSURE_PARTS/ТКП-6.1.3.B1/ТКП-6.1.3.B1_1590BB_Panel_B_V1.FCStd
ENCLOSURE_PARTS/ТКП-6.1.3.C1/ТКП-6.1.3.C1_1590BB_Panel_C_V1.FCStd
ENCLOSURE_PARTS/ТКП-6.1.5.A1/ТКП-6.1.5.A1_1590BB_Panel_A_V1.FCStd
ENCLOSURE_PARTS/ТКП-6.1.5.B1/ТКП-6.1.5.B1_1590BB_Panel_B_V1.FCStd
ENCLOSURE_PARTS/ТКП-6.1.5.C1/ТКП-6.1.5.C1_1590BB_Panel_C_V1.FCStd
ENCLOSURE_PARTS/ТКП-6.1.5.D1/ТКП-6.1.5.D1_1590BB_Panel_D_V1.FCStd
ENCLOSURE_PARTS/ТКП-6.3.1.B1/ТКП-6.3.1.B1_B013_Base_B_V1.FCStd
ENCLOSURE_PARTS/ТКП-6.3.3.B1/ТКП-6.3.3.B1_B013_Cover_B_V1.FCStd
