Adept666/stompboxes/SILKSCREEN/sources_kicad/little_angel_chorus-vibrato_r2_collision.pdf

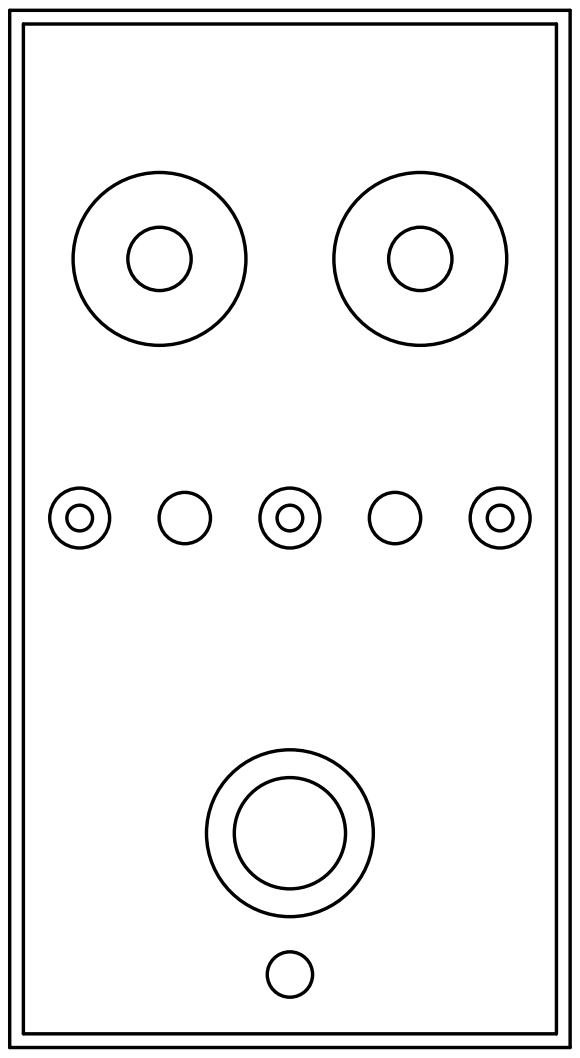
[picture p50: page 1]
