Adept666/stompboxes/SILKSCREEN/pdf_clean_white/great_depression_phaser_r1_1.pdf

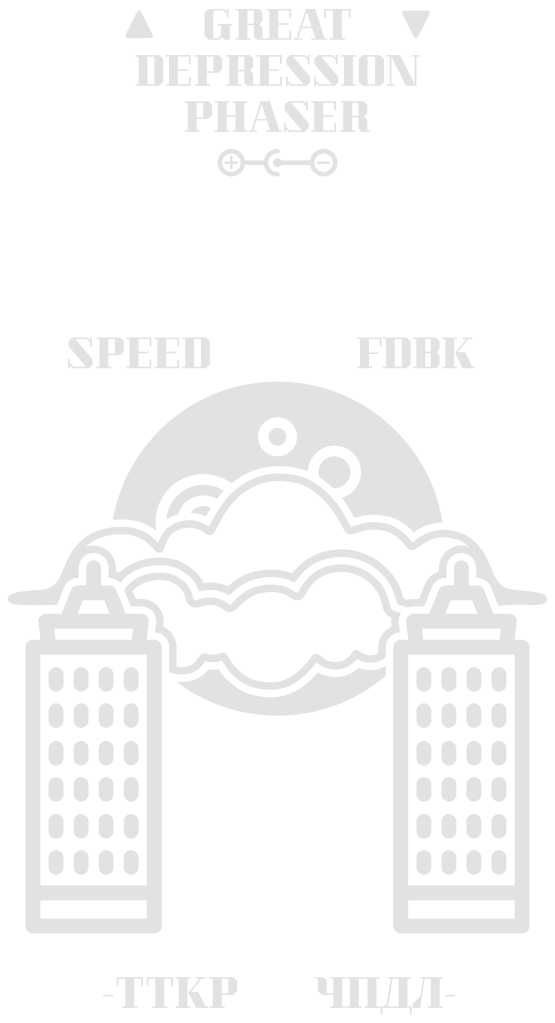
[picture p51: page 1]
