Adept666/stompboxes/SILKSCREEN/sources_kicad/great_depression_phaser_r1_collision.pdf

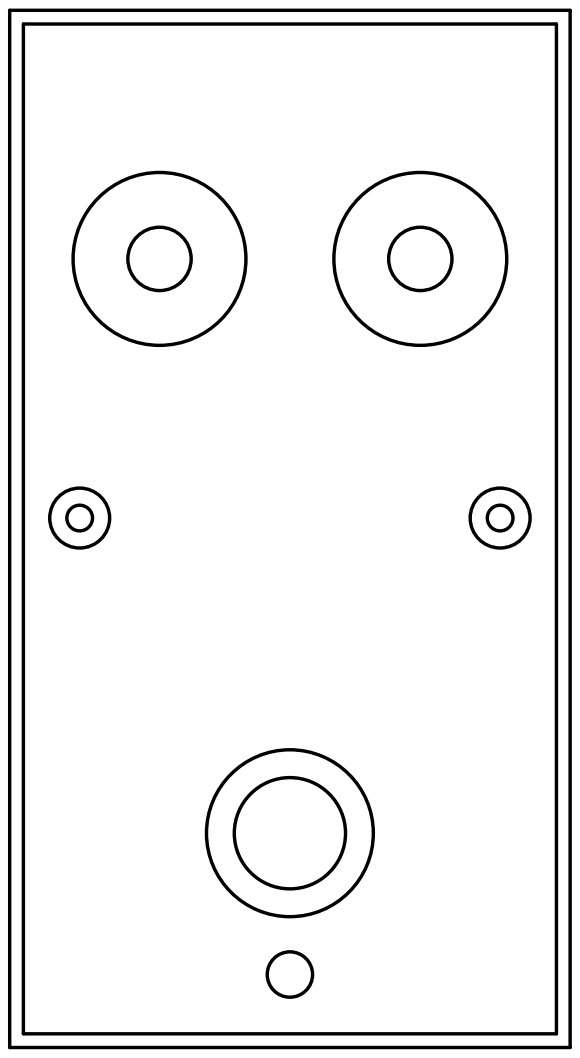
[picture p52: page 1]
