Adept666/stompboxes/SILKSCREEN/pdf_clean_white/salty_phaser_r1_1.pdf

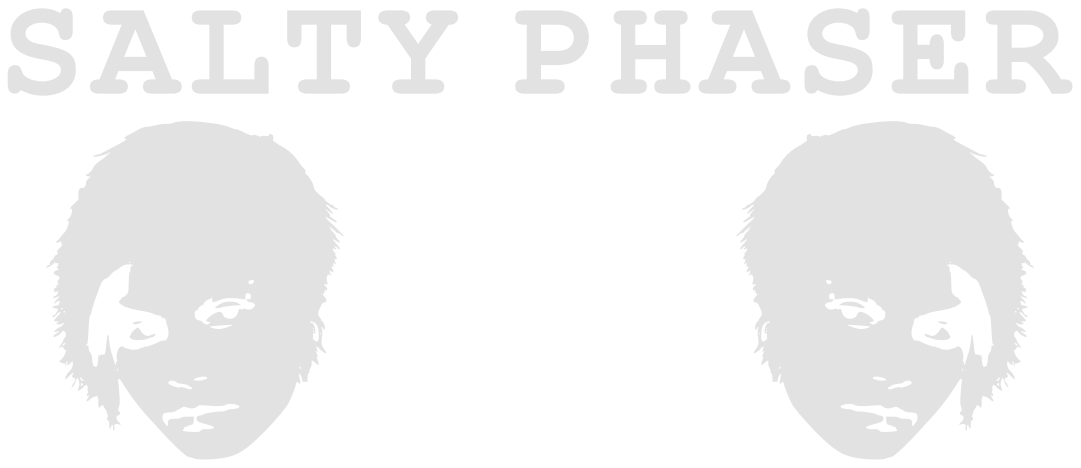
[picture p53: page 1]
