Adept666/stompboxes/SILKSCREEN/sources_kicad/salty_phaser_r1_collision.pdf

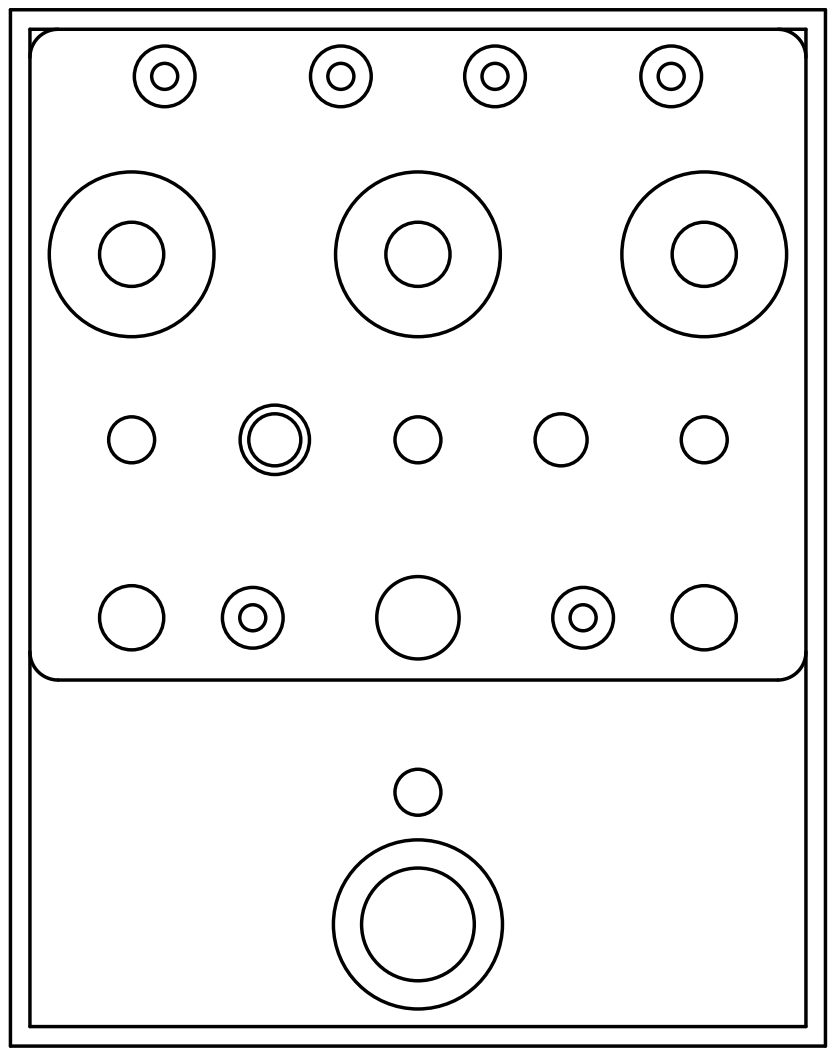
[picture p54: page 1]
