Adept666/stompboxes/SILKSCREEN/pdf_clean_multicolor/копка_земли_r2_down-tuned_1.pdf

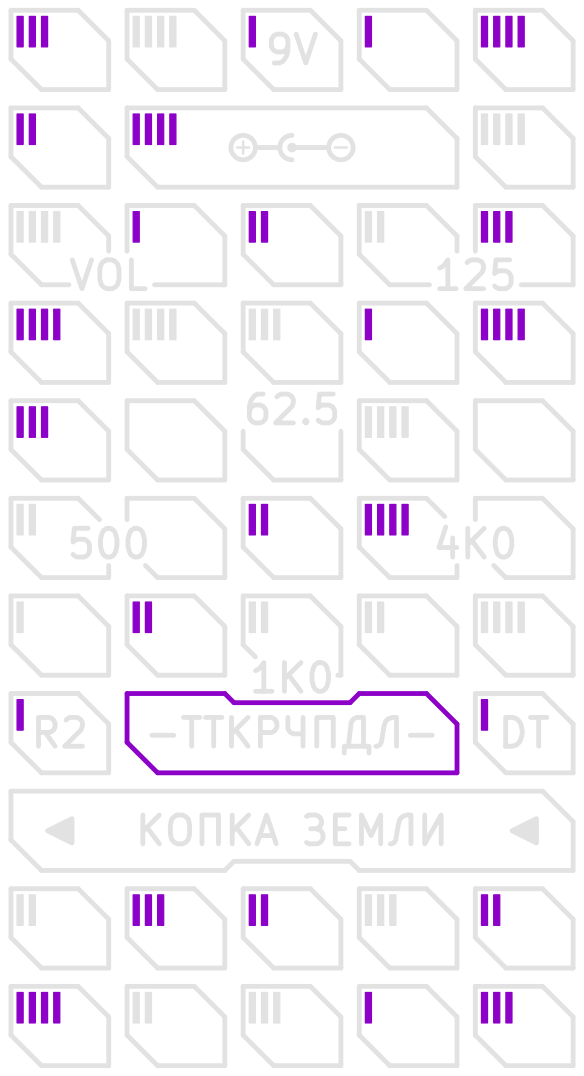
[picture p55: page 1]
