Adept666/stompboxes/SILKSCREEN/pdf_clean_multicolor/копка_земли_r2_standard-tuned_1.pdf

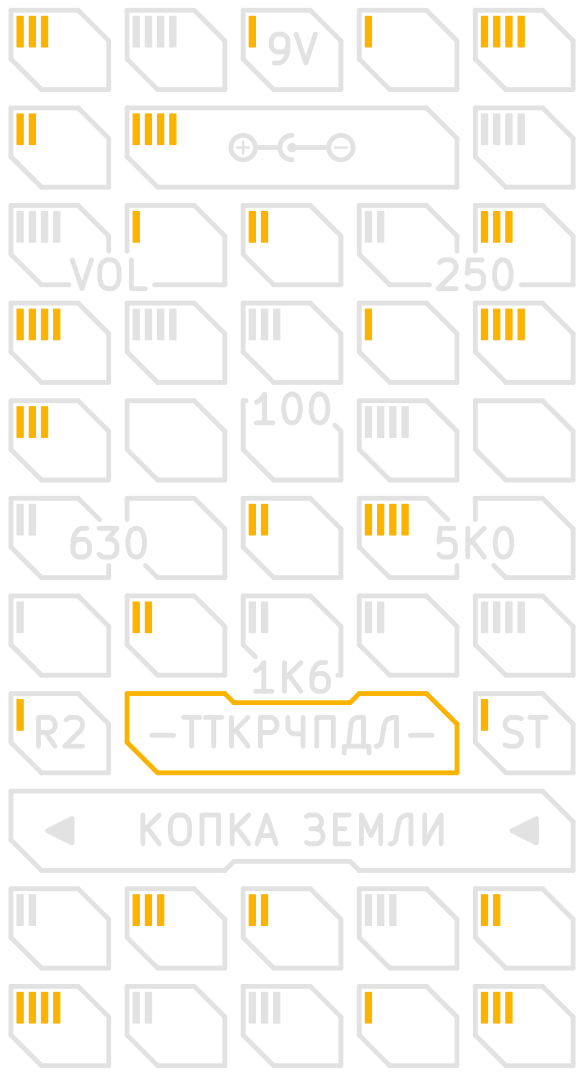
[picture p56: page 1]
