Adept666/stompboxes/SILKSCREEN/sources_kicad/копка_земли_r2_collision.pdf

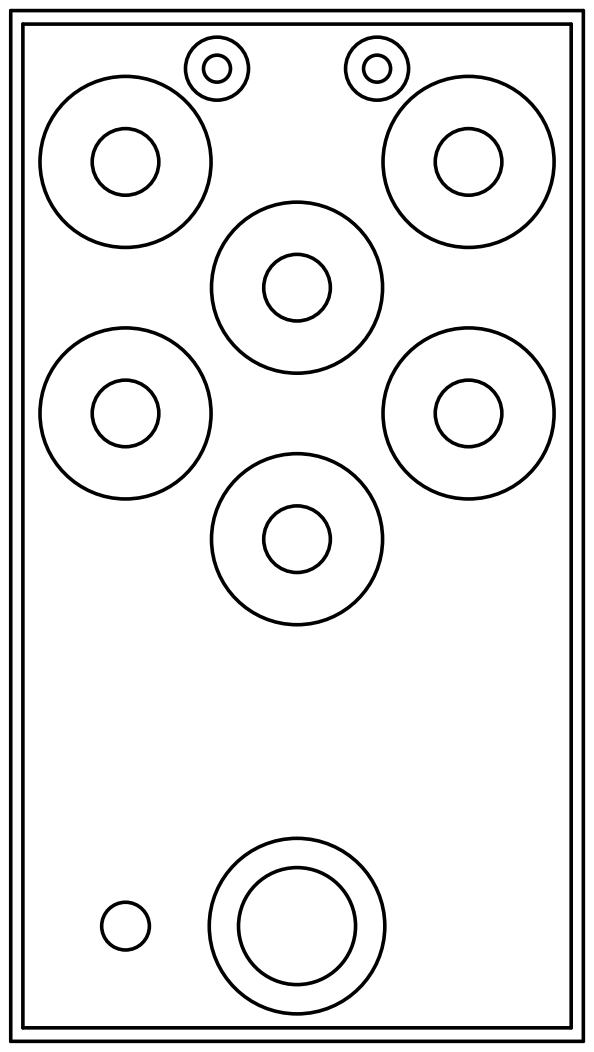
[picture p57: page 1]
