Adept666/stompboxes/SILKSCREEN/sources_kicad/копка_земли_r2_down-tuned_1_purple.pdf

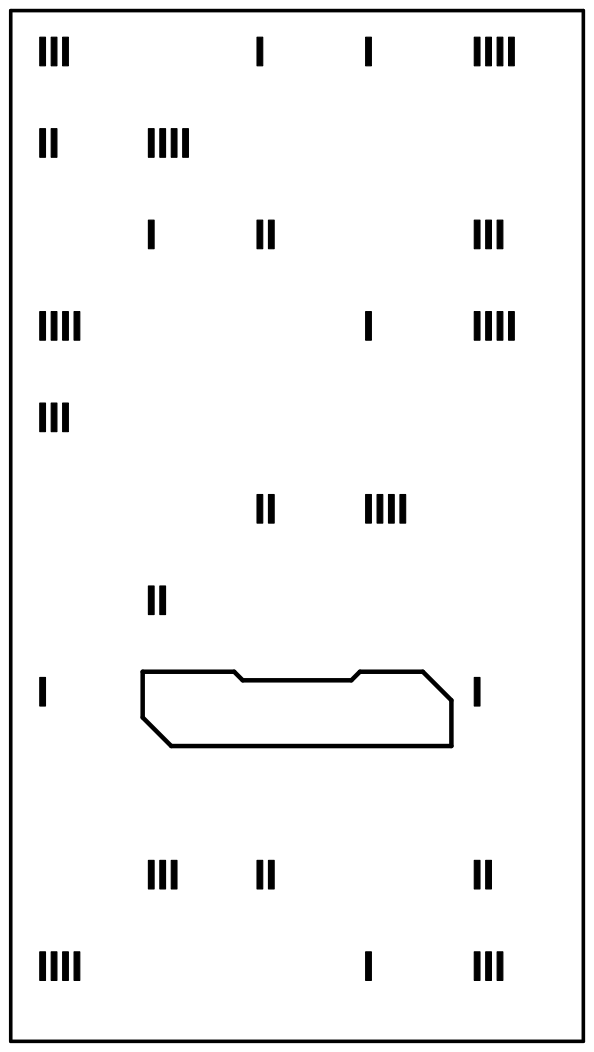
[picture p58: page 1]
