Adept666/stompboxes/SILKSCREEN/sources_kicad/копка_земли_r2_down-tuned_1_white.pdf

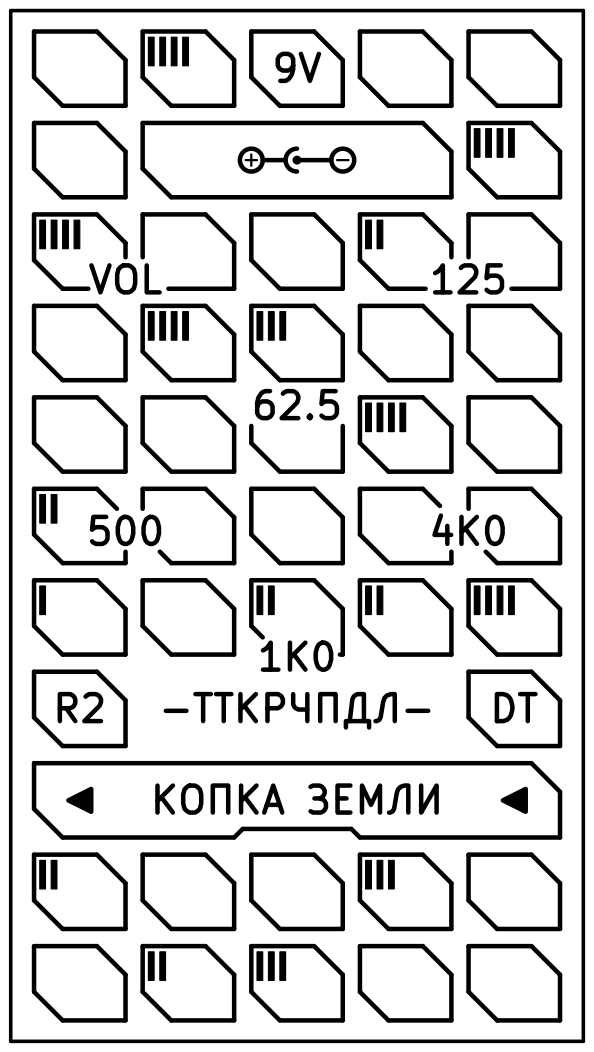
[picture p59: page 1]
