Adept666/stompboxes/SILKSCREEN/sources_kicad/копка_земли_r2_standard-tuned_1_white.pdf

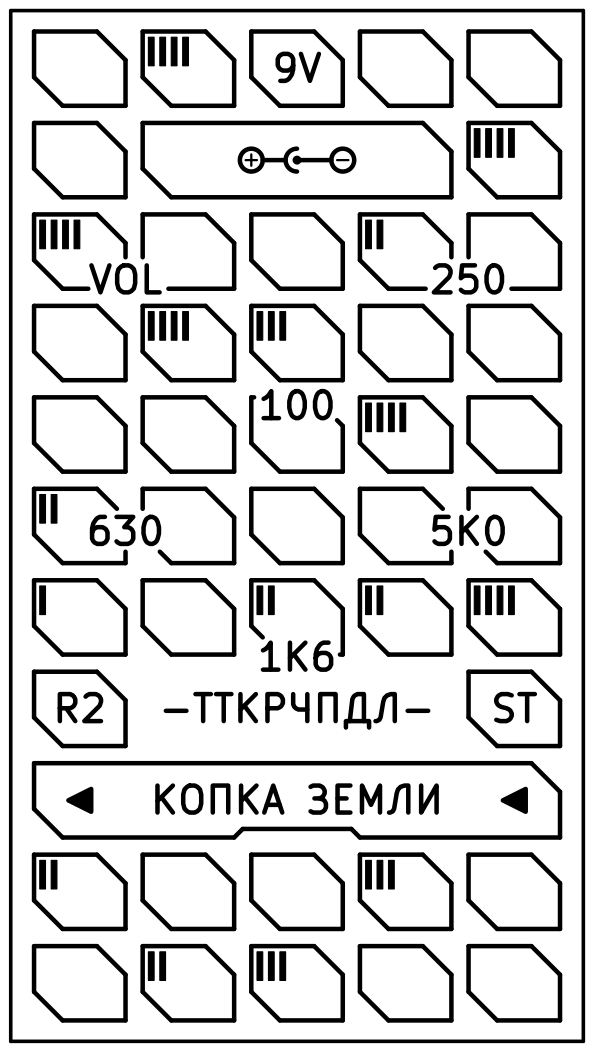
[picture p60: page 1]
