Adept666/stompboxes/SILKSCREEN/pdf_clean_black/crumbwave_multiplexer_r1_1.pdf

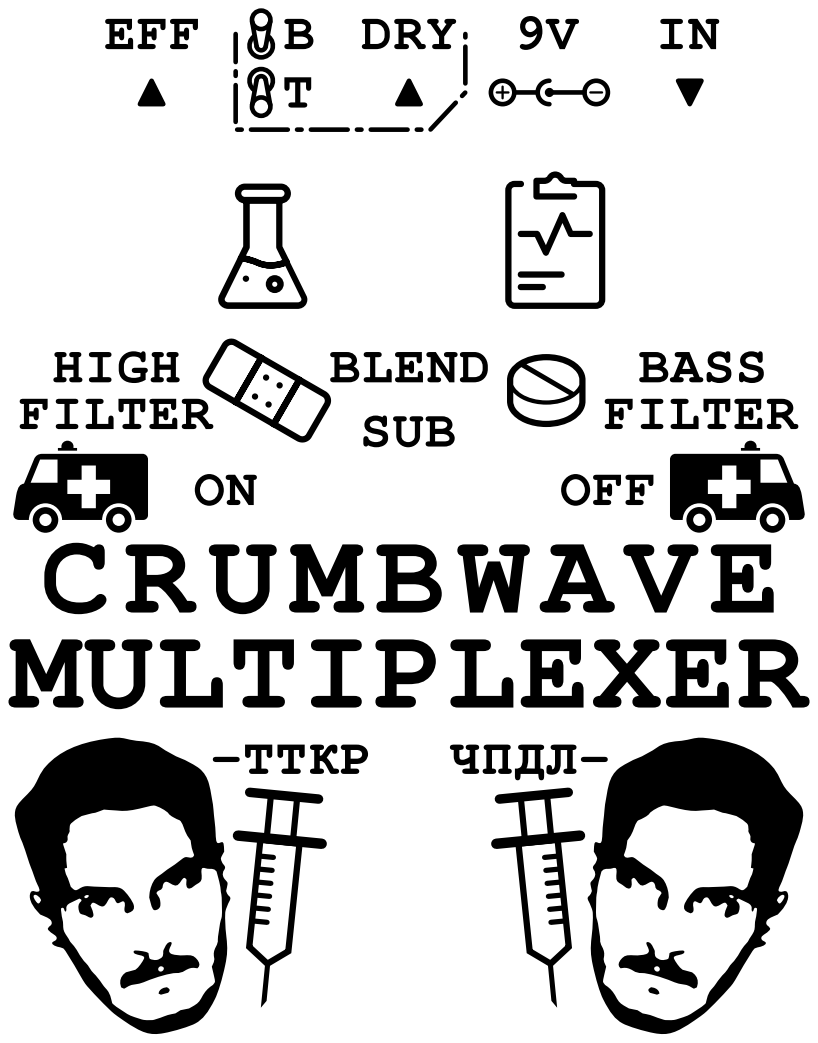
[picture p61: page 1]
