Adept666/stompboxes/SILKSCREEN/sources_kicad/crumbwave_multiplexer_r1_collision.pdf

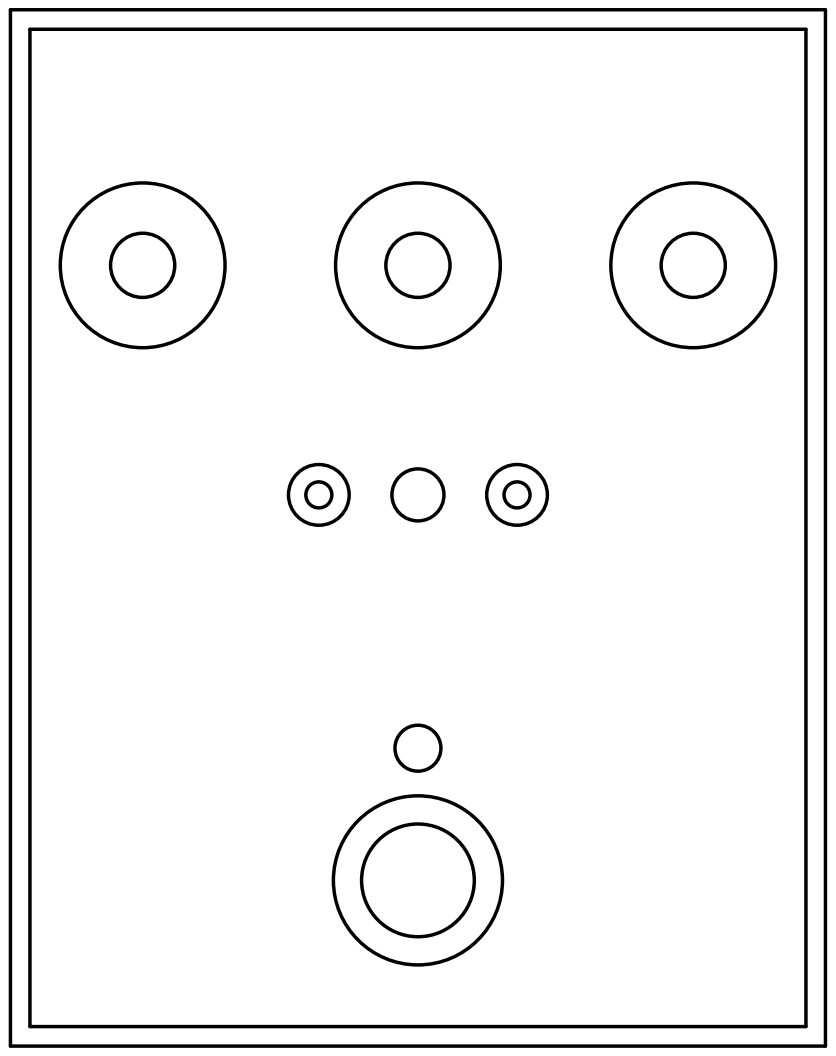
[picture p62: page 1]
