Adept666/stompboxes/SILKSCREEN/pdf_clean_multicolor/big_muff_r3_bass_1.pdf

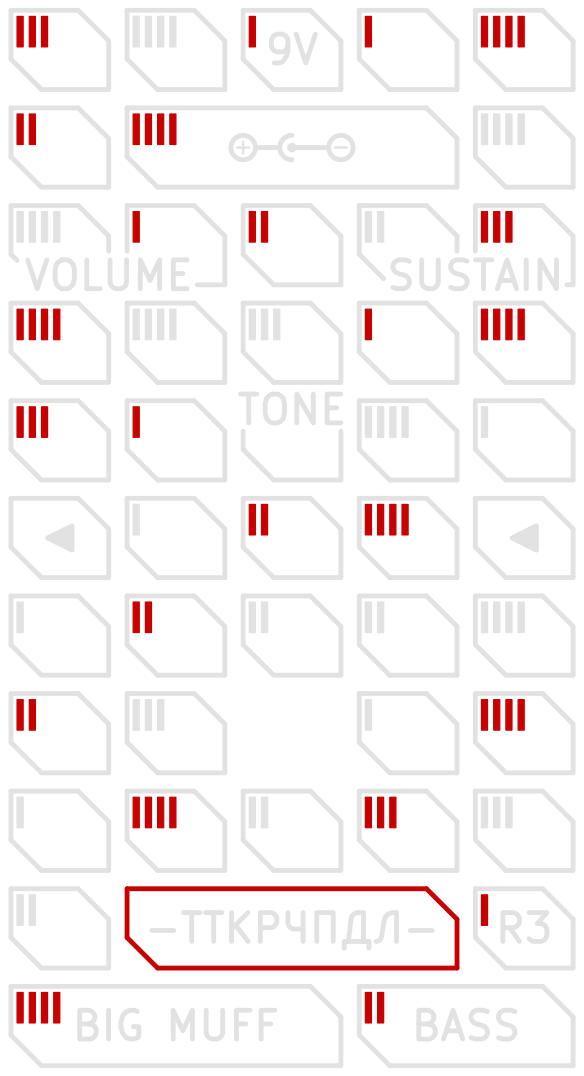
[picture p63: page 1]
