Adept666/stompboxes/SILKSCREEN/pdf_clean_multicolor/big_muff_r3_nyc_1.pdf

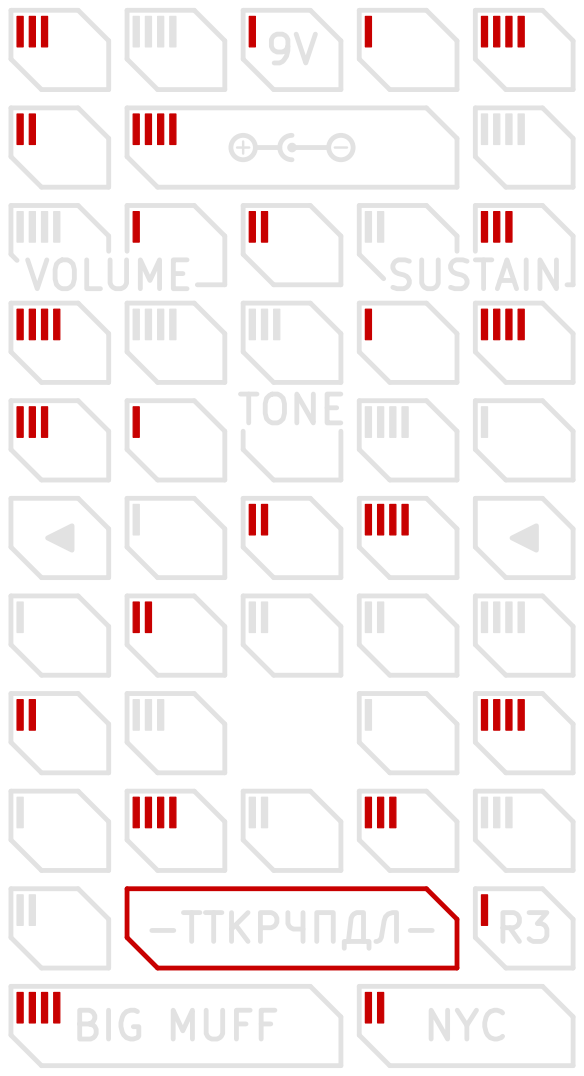
[picture p64: page 1]
