Adept666/stompboxes/SILKSCREEN/sources_kicad/big_muff_r3_bass_1_red.pdf

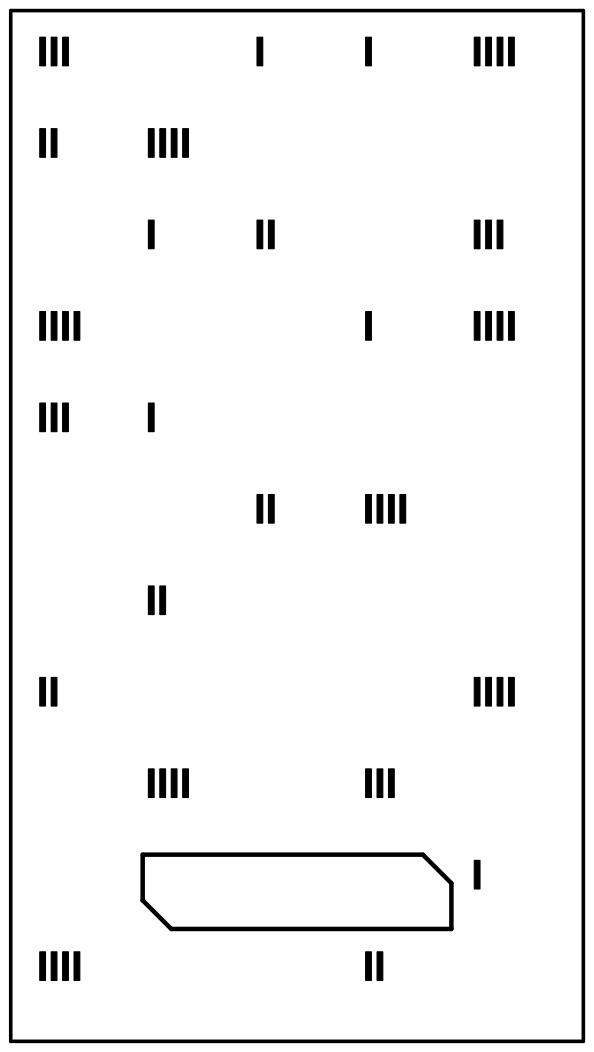
[picture p65: page 1]
