Adept666/stompboxes/SILKSCREEN/sources_kicad/big_muff_r3_bass_1_white.pdf

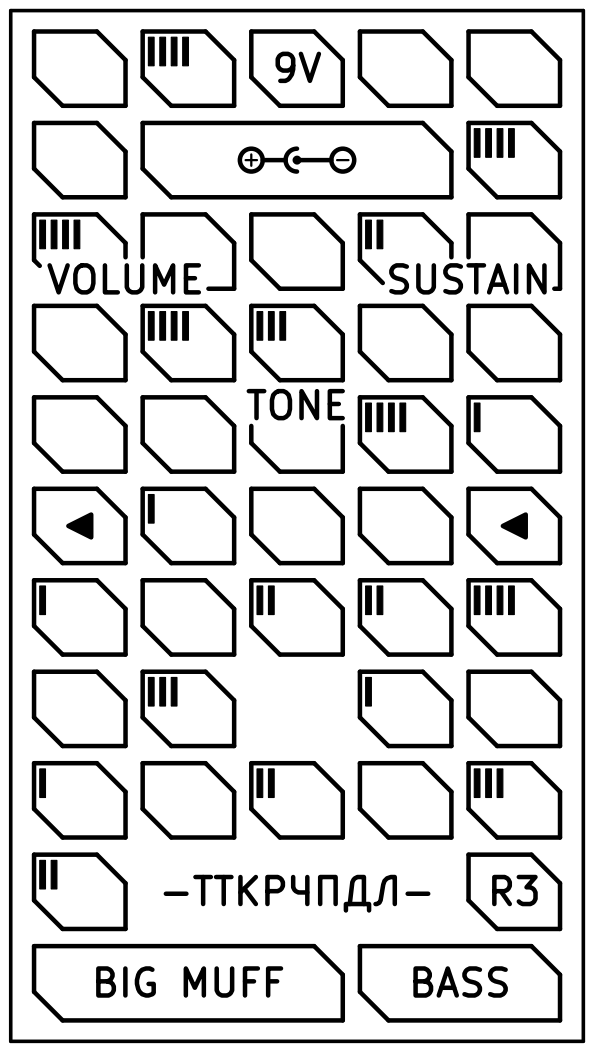
[picture p66: page 1]
