Adept666/stompboxes/SILKSCREEN/sources_kicad/big_muff_r3_collision.pdf

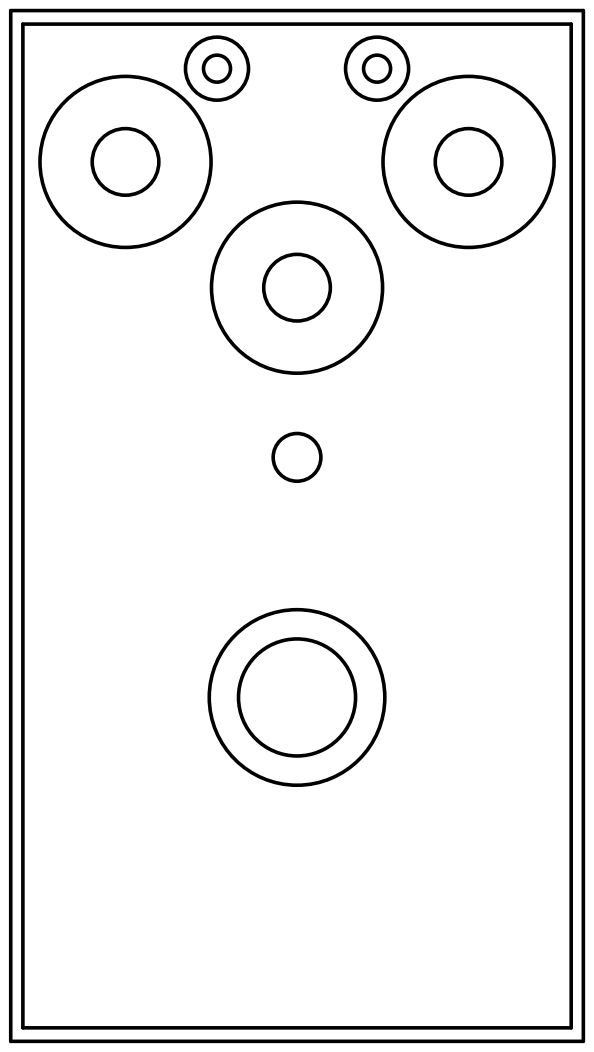
[picture p67: page 1]
