Adept666/stompboxes/SILKSCREEN/sources_kicad/big_muff_r3_nyc_1_white.pdf

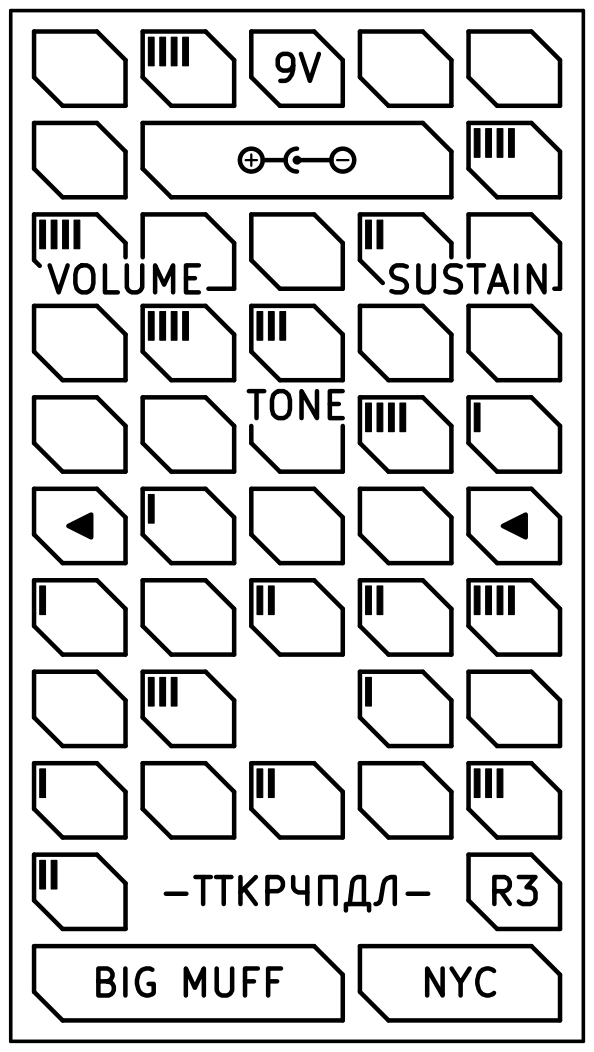
[picture p68: page 1]
