Adept666/stompboxes/SILKSCREEN/pdf_clean_multicolor/deep_blue_delay_r3_2.pdf

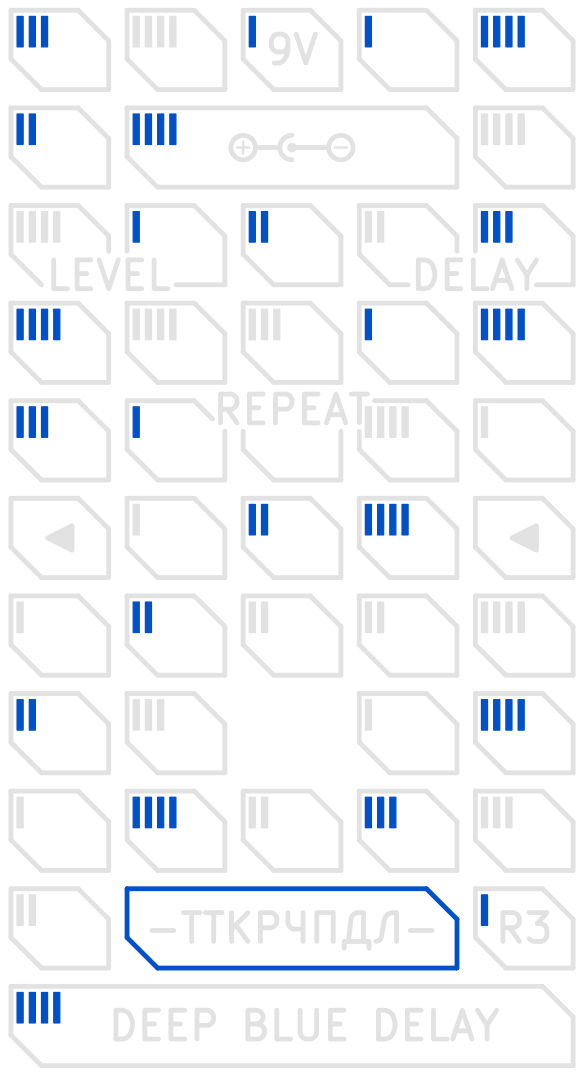
[picture p69: page 1]
