Adept666/stompboxes/SILKSCREEN/sources_kicad/deep_blue_delay_r3_2_blue.pdf

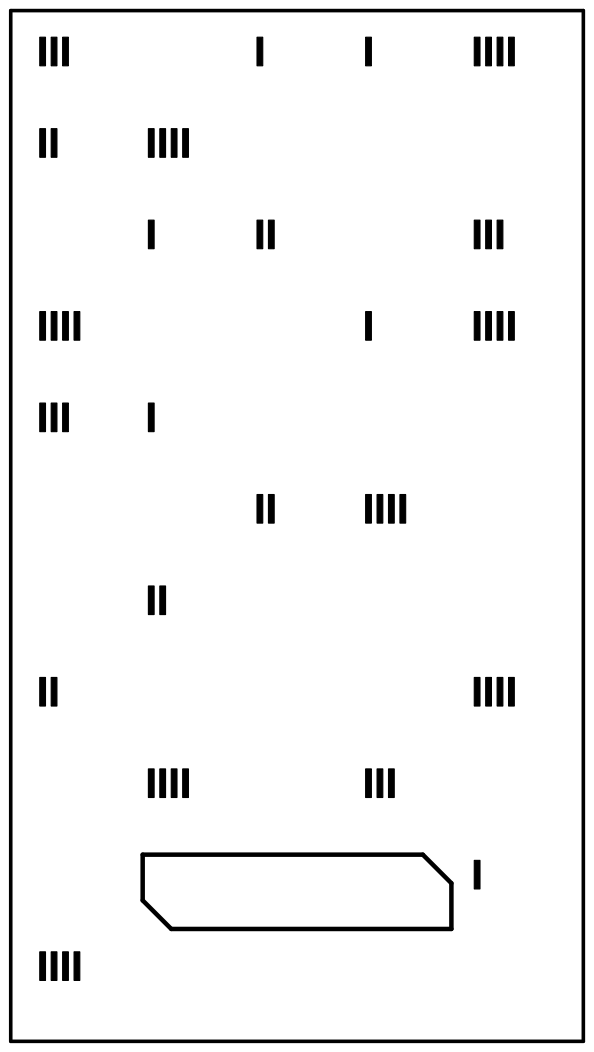
[picture p70: page 1]
