Adept666/stompboxes/SILKSCREEN/sources_kicad/deep_blue_delay_r3_2_white.pdf

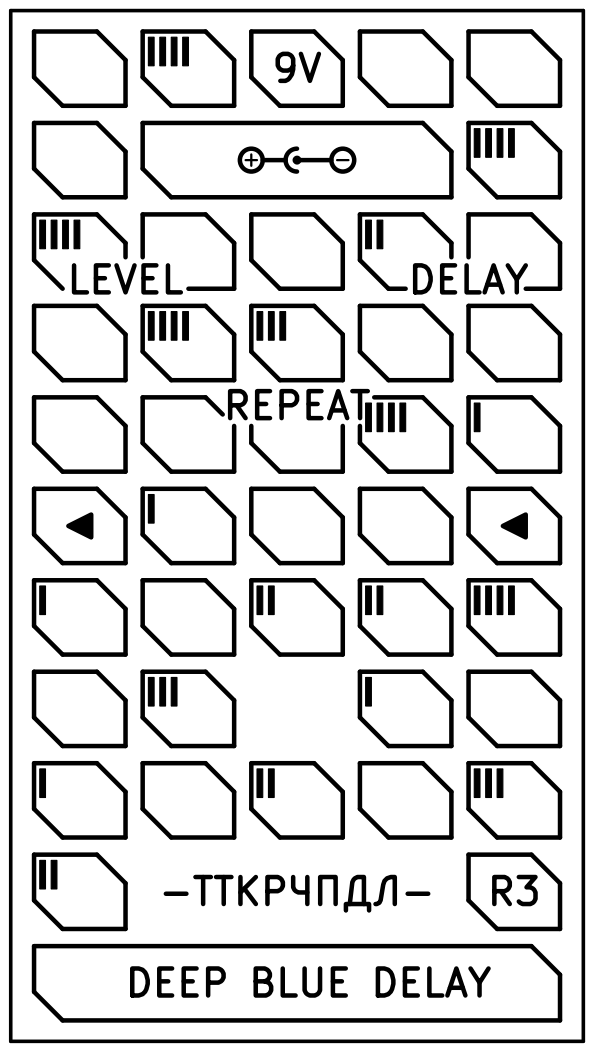
[picture p71: page 1]
