Adept666/stompboxes/SILKSCREEN/pdf_clean_multicolor/big_muff_r2_bass_2.pdf

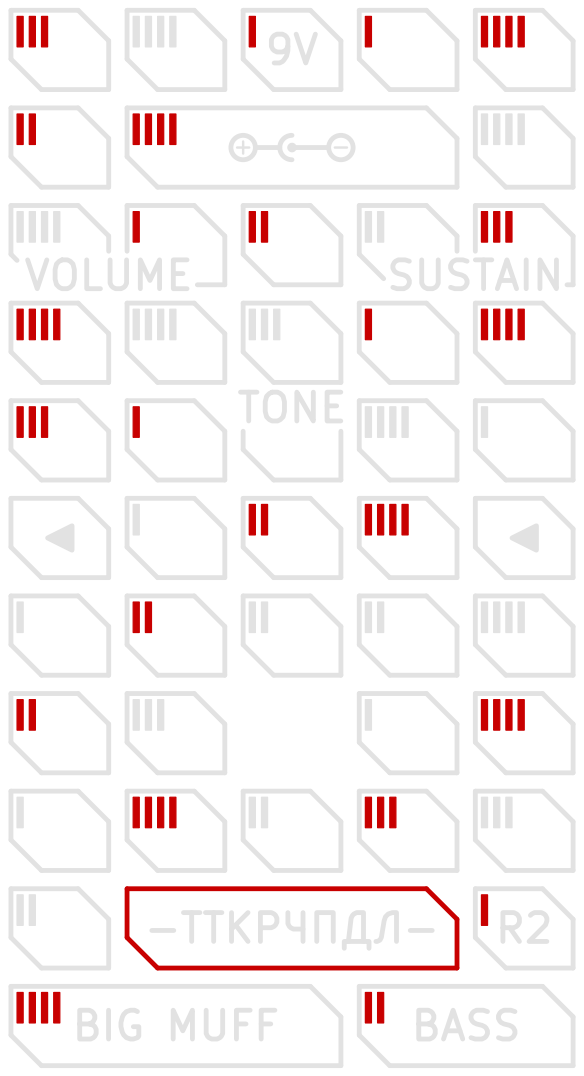
[picture p72: page 1]
