Adept666/stompboxes/SILKSCREEN/pdf_clean_multicolor/big_muff_r2_nyc_2.pdf

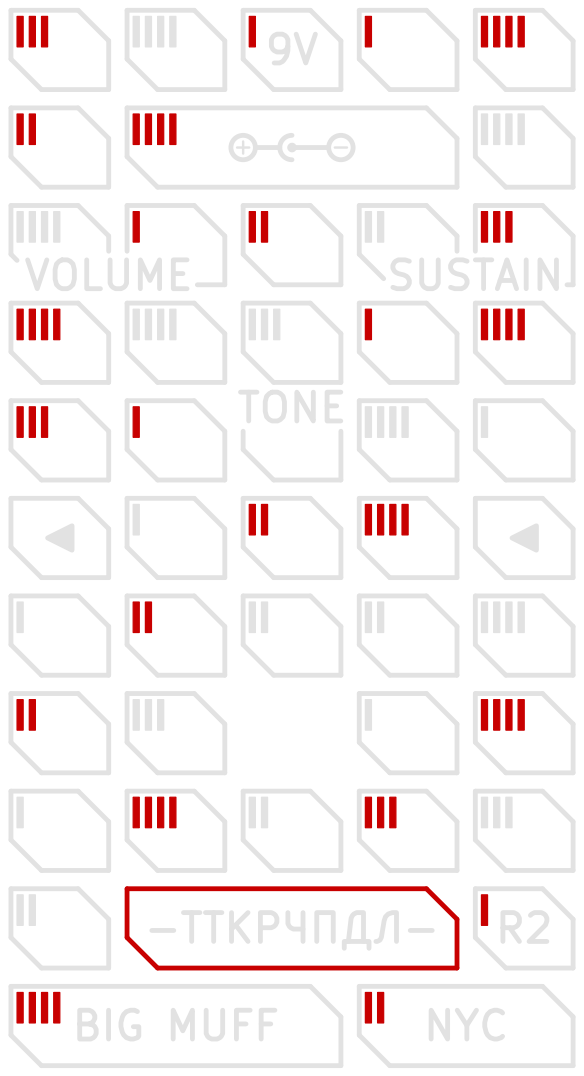
[picture p73: page 1]
