Adept666/stompboxes/SILKSCREEN/sources_kicad/big_muff_r2_bass_2_white.pdf

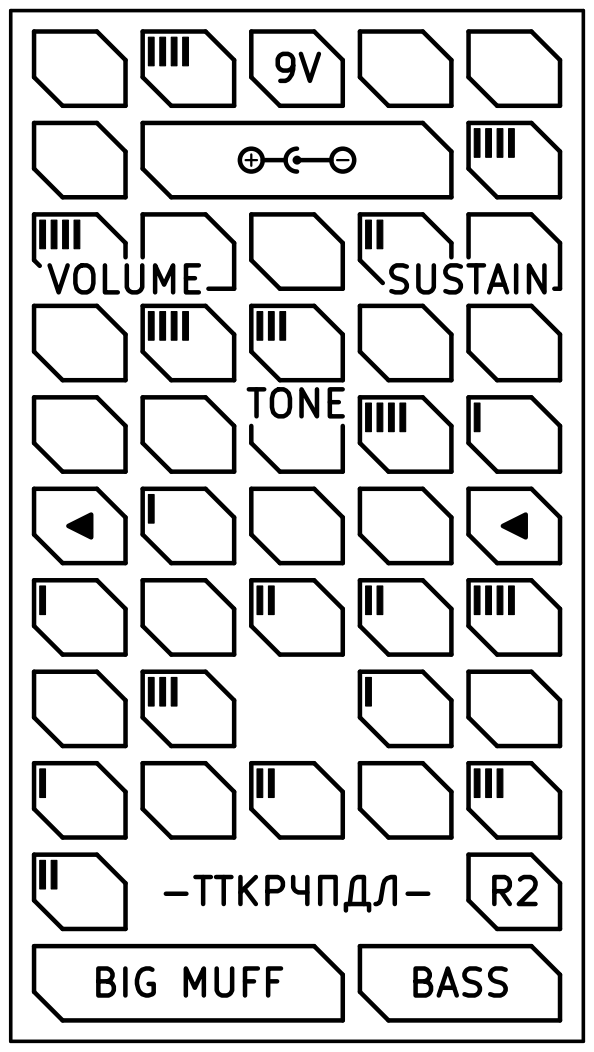
[picture p74: page 1]
