Adept666/stompboxes/SILKSCREEN/sources_kicad/big_muff_r2_nyc_2_white.pdf

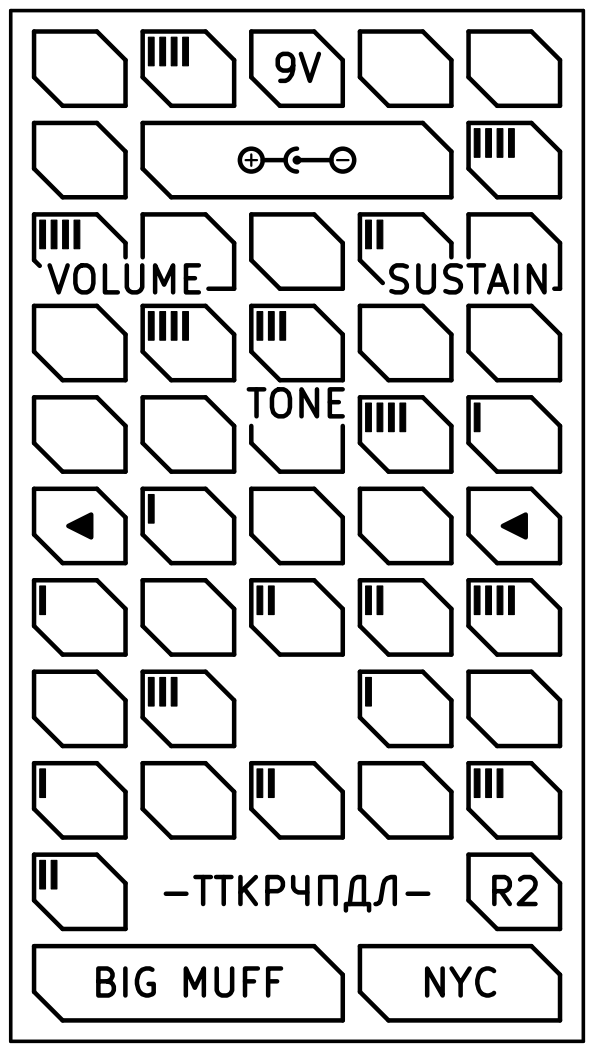
[picture p75: page 1]
