Adept666/stompboxes/SILKSCREEN/pdf_clean_black/good_grief_overdrive_r1_2.pdf

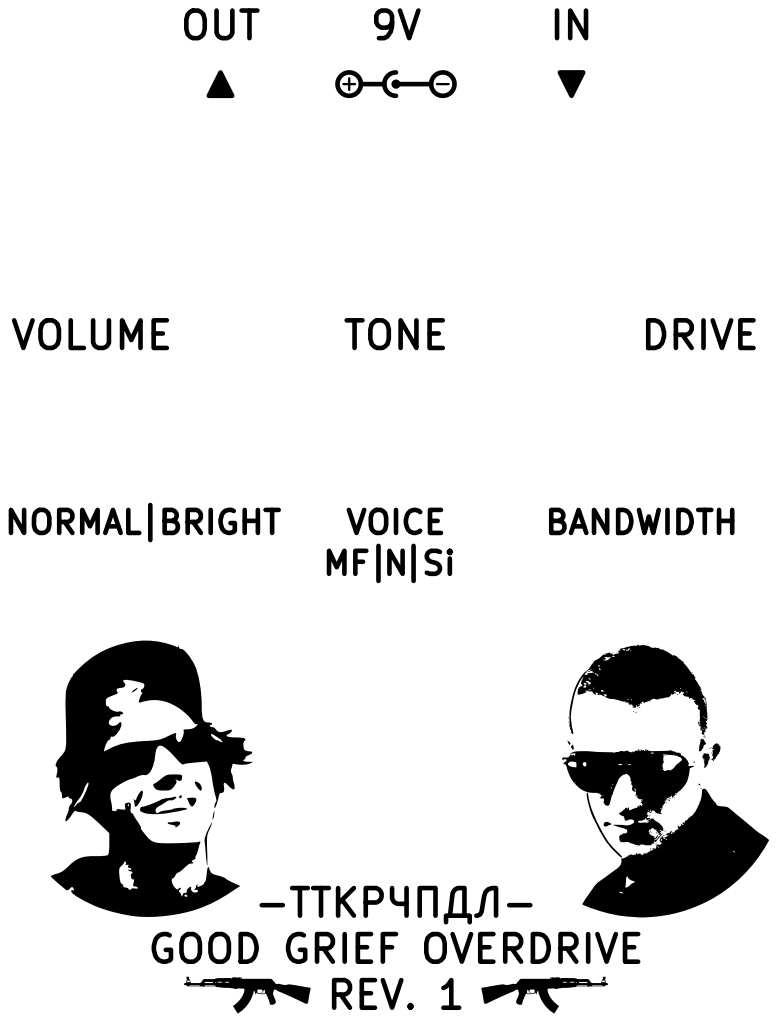
[picture p76: page 1]
