Adept666/stompboxes/SILKSCREEN/pdf_clean_black/edamamer_r1_1.pdf

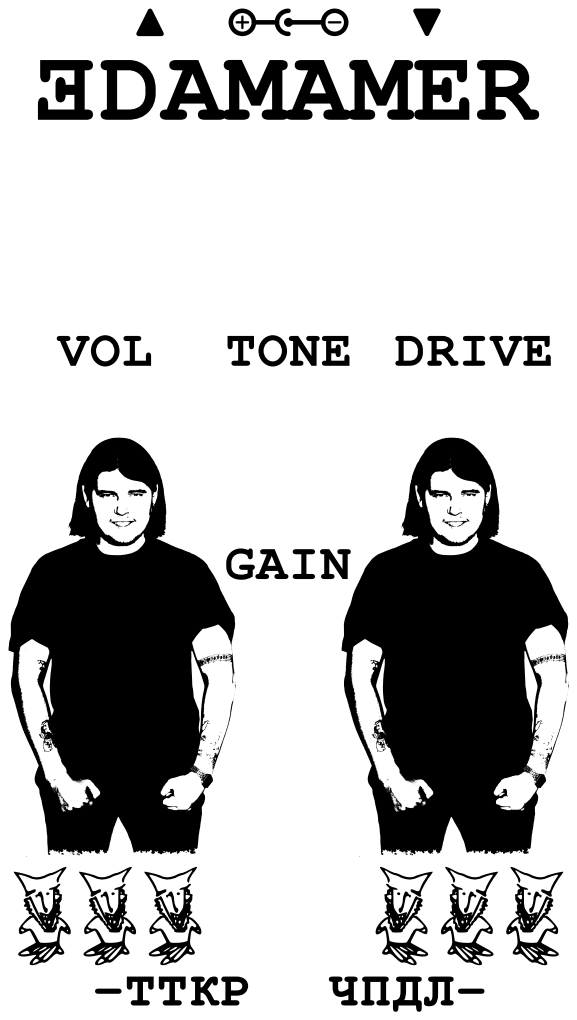
[picture p77: page 1]
