Adept666/stompboxes/SILKSCREEN/sources_kicad/edamamer_r1_1.pdf

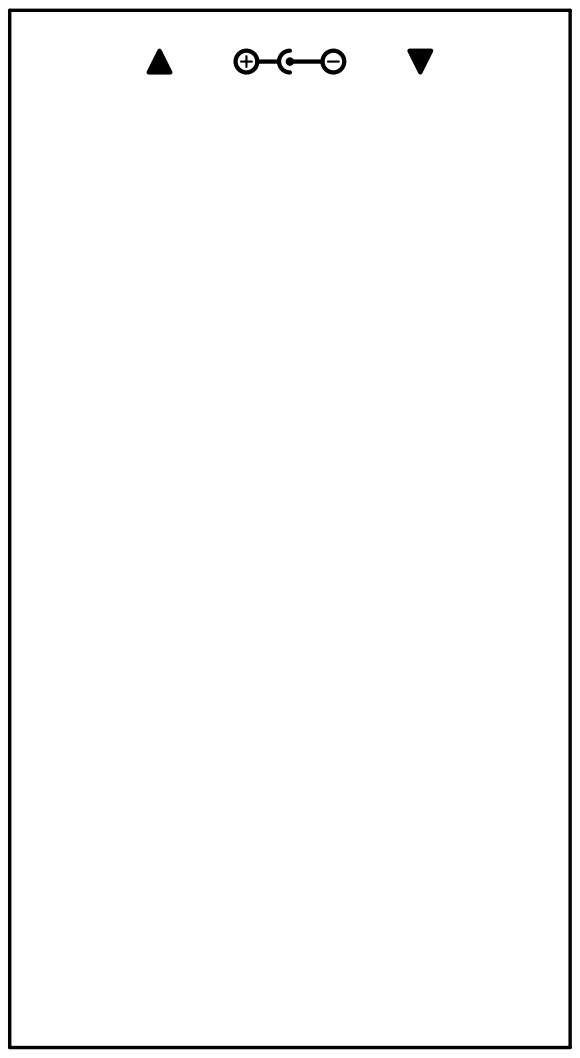
[picture p78: page 1]
