Adept666/stompboxes/SILKSCREEN/sources_kicad/edamamer_r1_collision.pdf

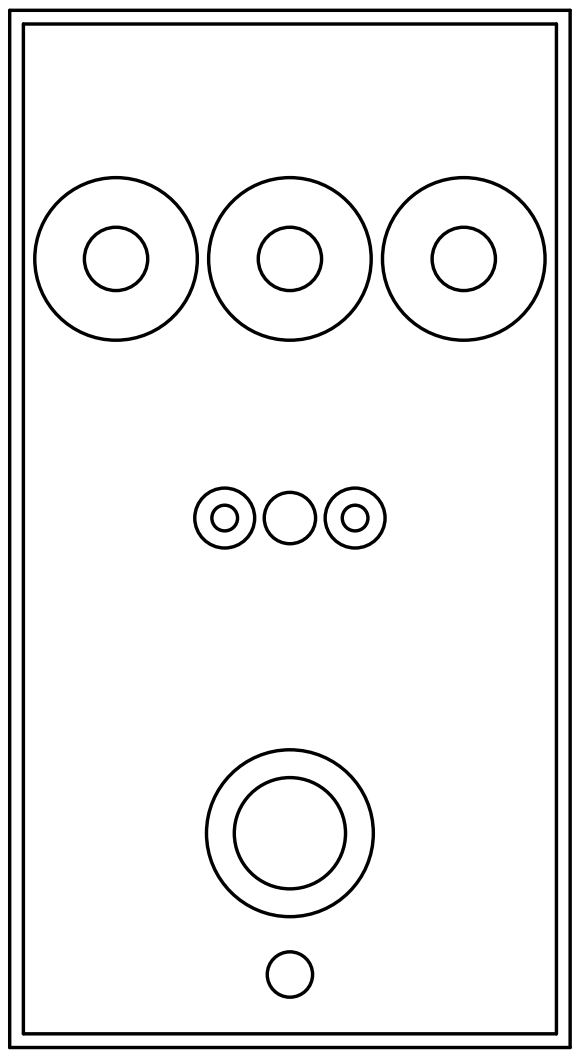
[picture p79: page 1]
