Adept666/stompboxes/SILKSCREEN/pdf_clean_black/тремоло_саши_огородникова_r1_1.pdf

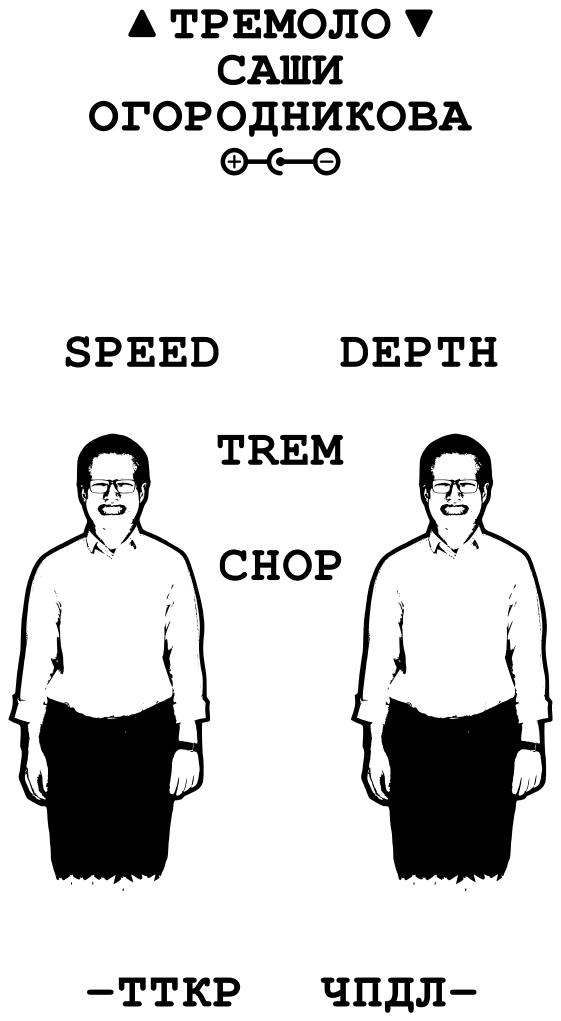
[picture p80: page 1]
