Adept666/stompboxes/SILKSCREEN/sources_kicad/тремоло_саши_огородникова_r1_1.pdf

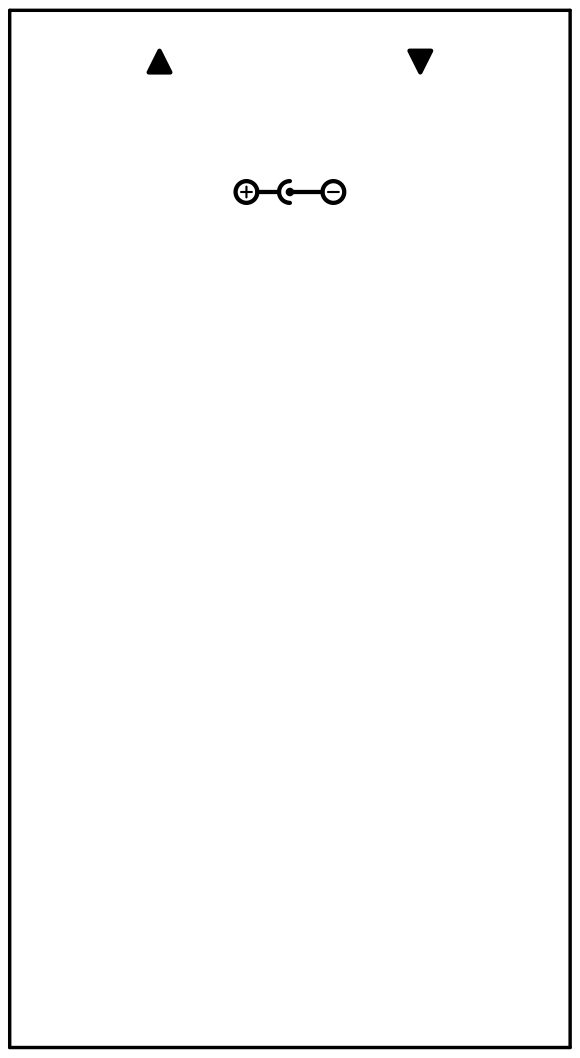
[picture p81: page 1]
