Adept666/stompboxes/SILKSCREEN/sources_kicad/тремоло_саши_огородникова_r1_collision.pdf

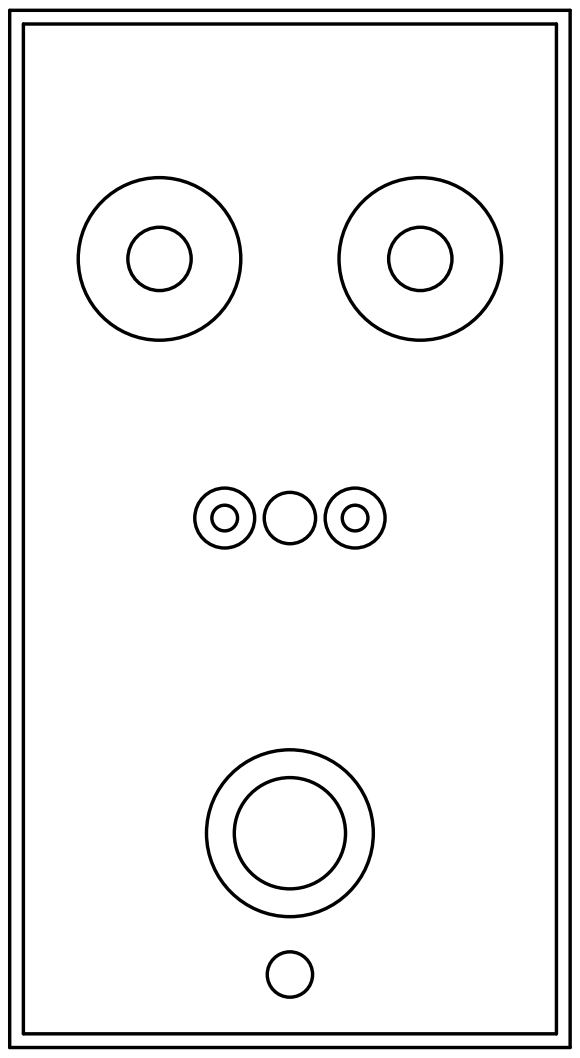
[picture p82: page 1]
