Adept666/stompboxes/SILKSCREEN/pdf_clean_white/копка_земли_r1_down-tuned_1.pdf

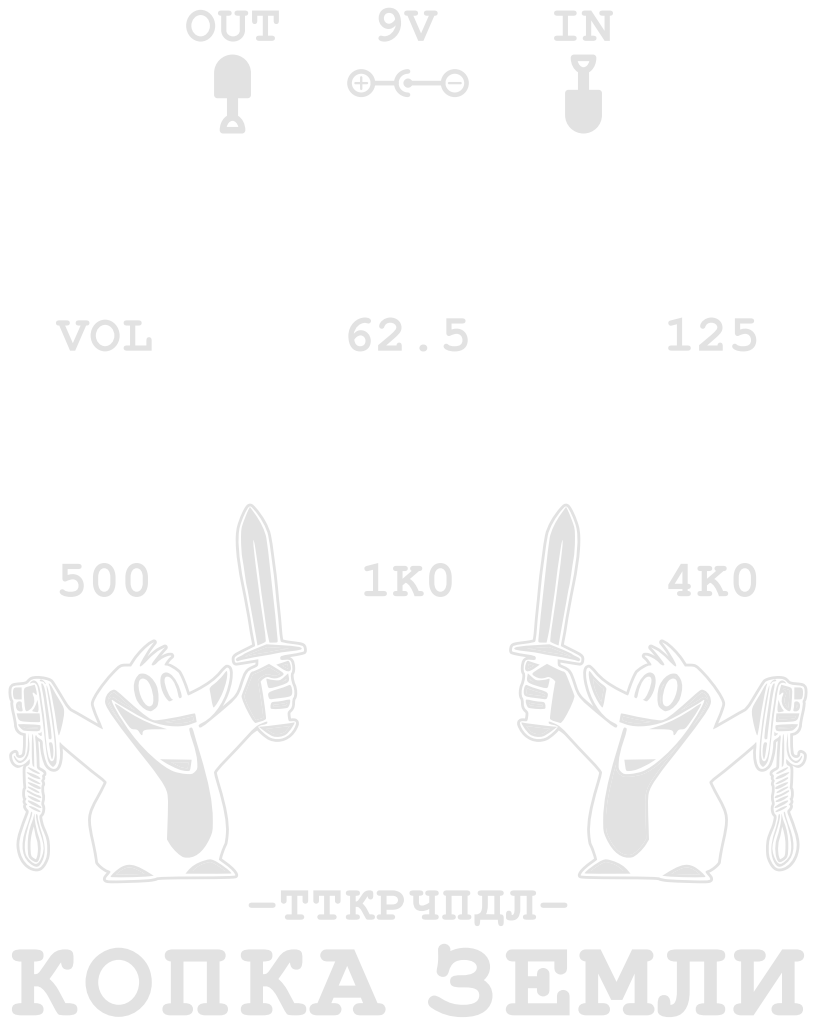
[picture p83: page 1]
