Adept666/stompboxes/SILKSCREEN/pdf_clean_white/копка_земли_r1_standard-tuned_1.pdf

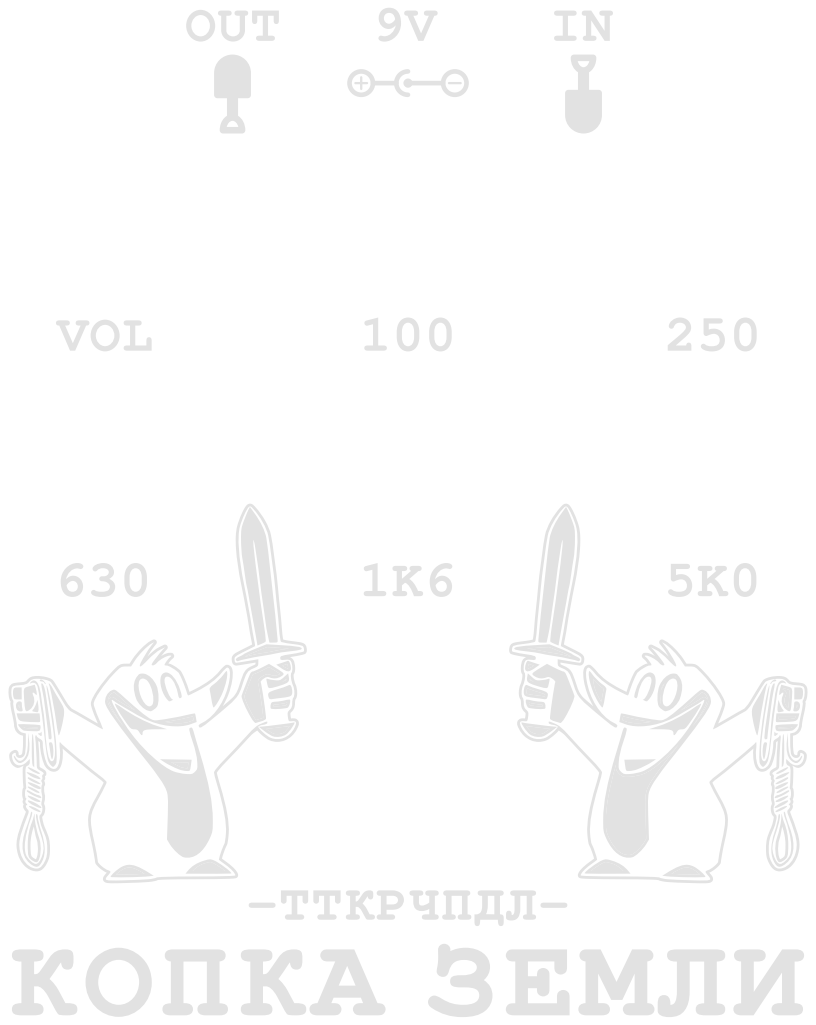
[picture p84: page 1]
