Adept666/stompboxes/SILKSCREEN/sources_kicad/копка_земли_r1_1.pdf

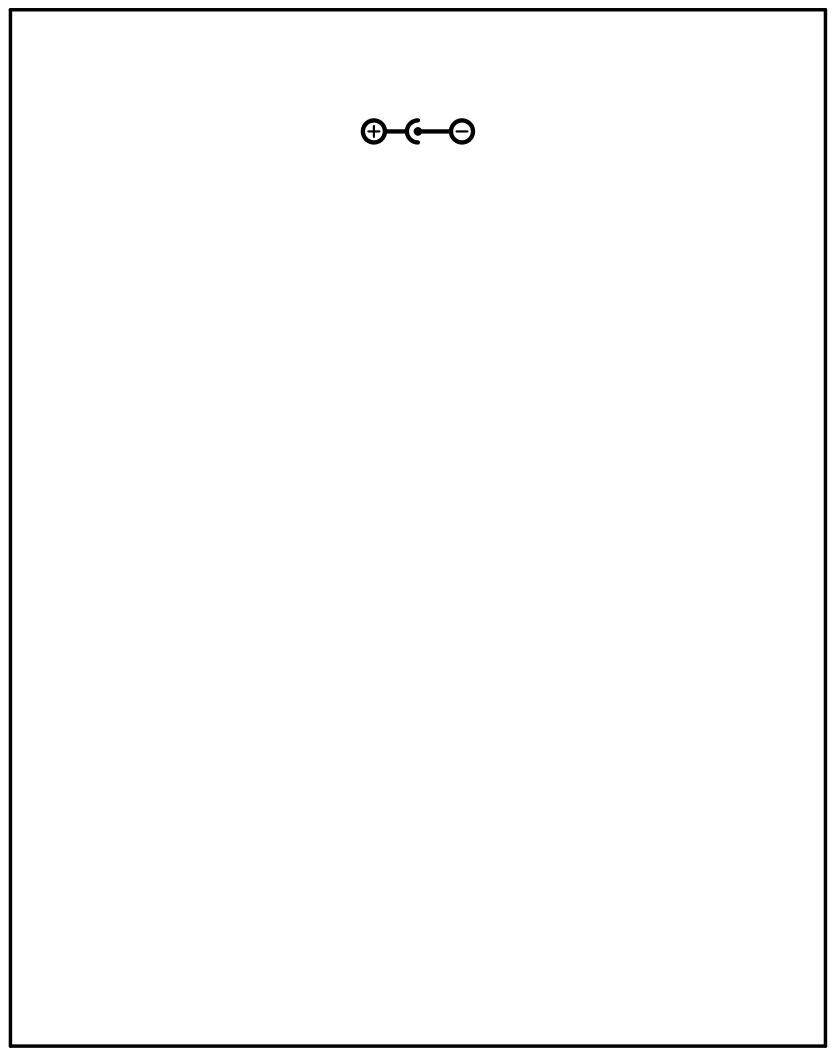
[picture p85: page 1]
