Adept666/stompboxes/SILKSCREEN/sources_kicad/копка_земли_r1_collision.pdf

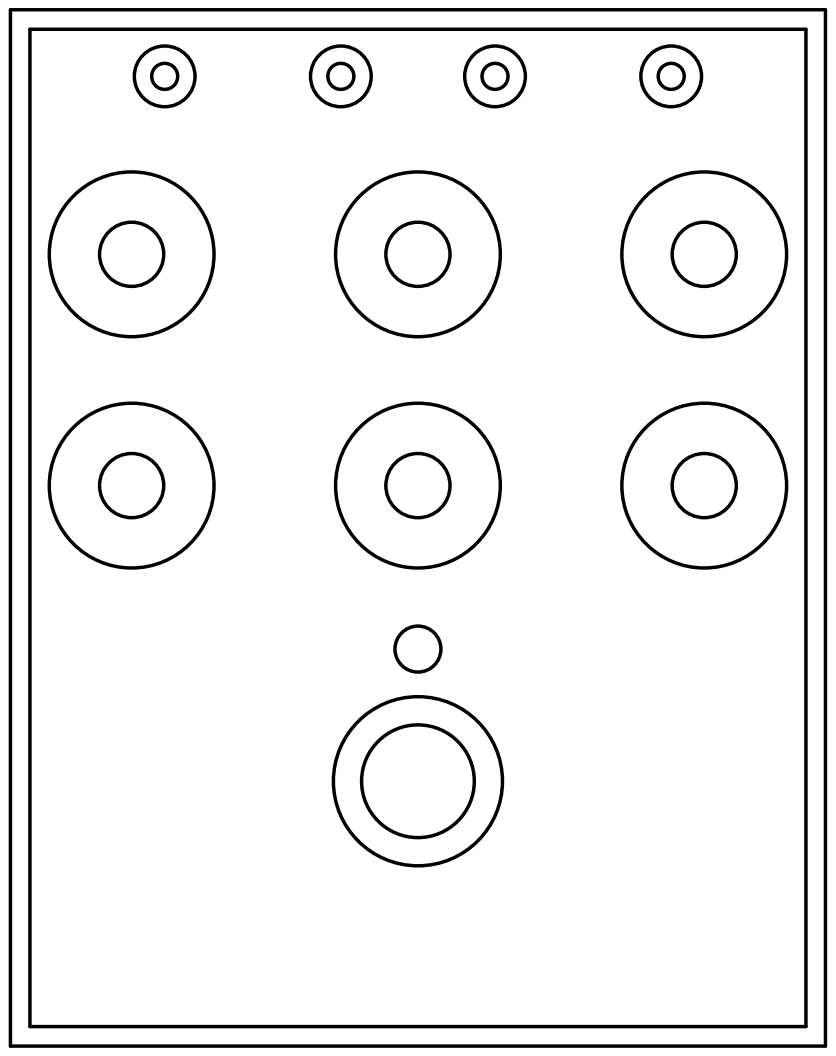
[picture p86: page 1]
