Adept666/stompboxes/SILKSCREEN/pdf_clean_white/fishtaur_r1_1.pdf

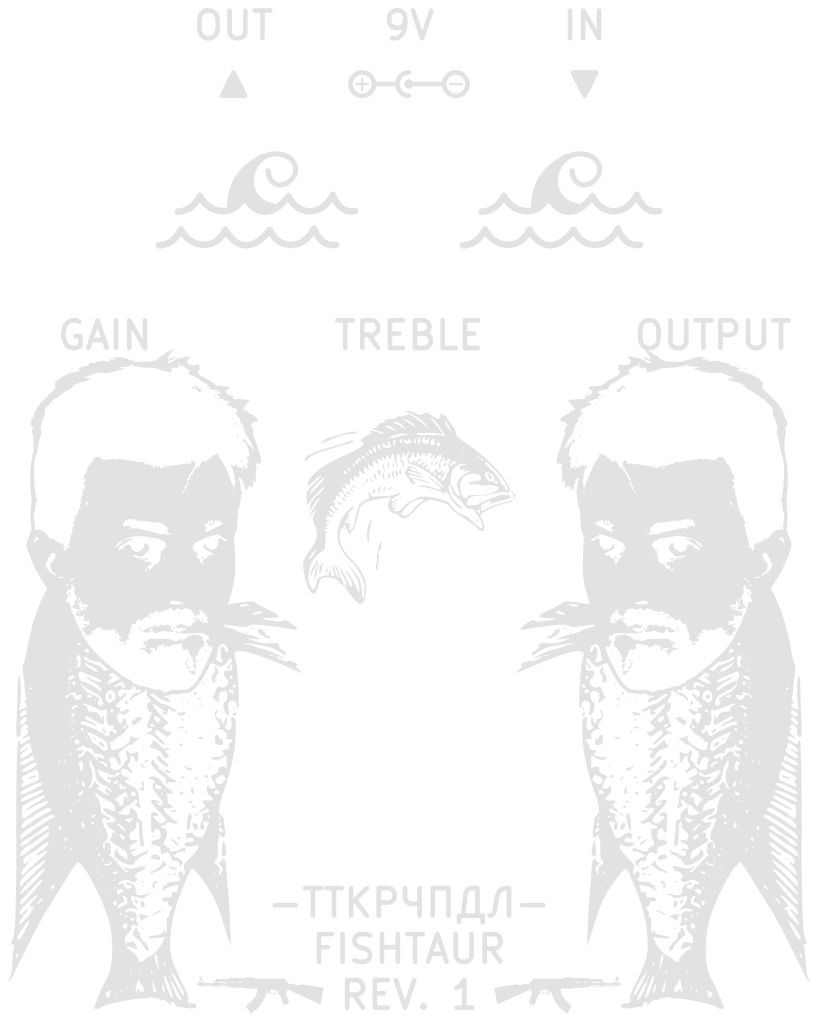
[picture p87: page 1]
