Adept666/stompboxes/SILKSCREEN/sources_kicad/fishtaur_r1_1.pdf

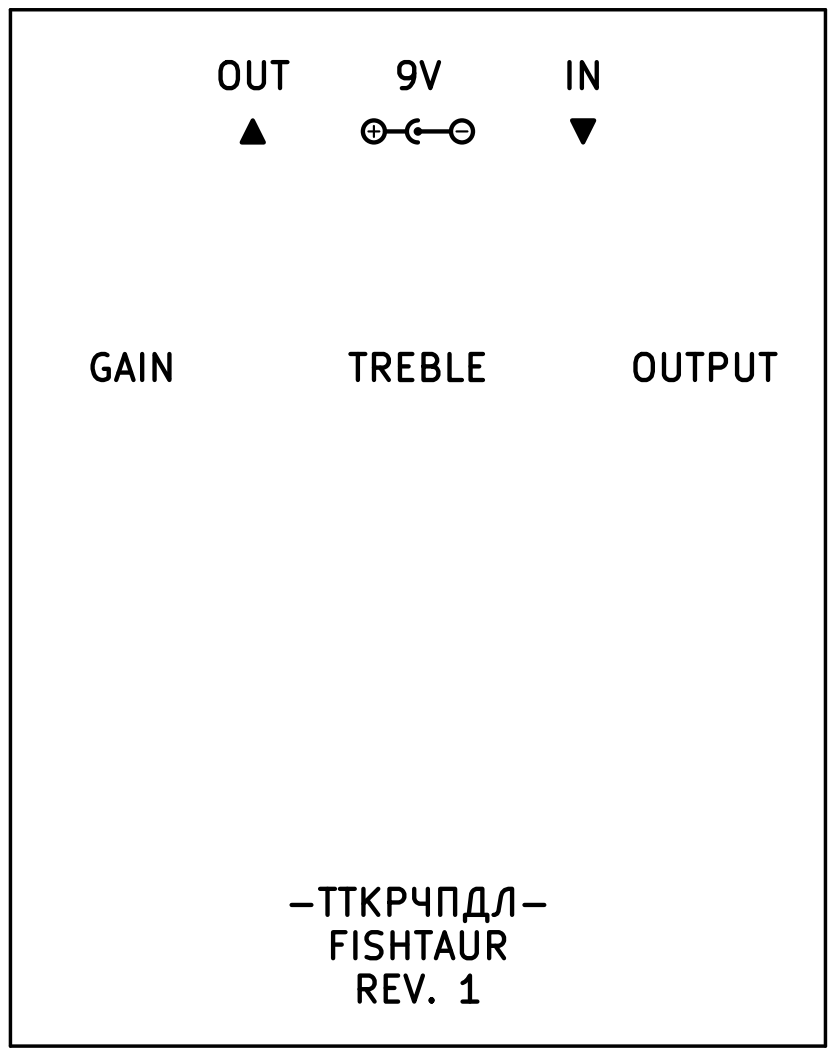
[picture p88: page 1]
