Adept666/stompboxes/SILKSCREEN/sources_kicad/fishtaur_r1_collision.pdf

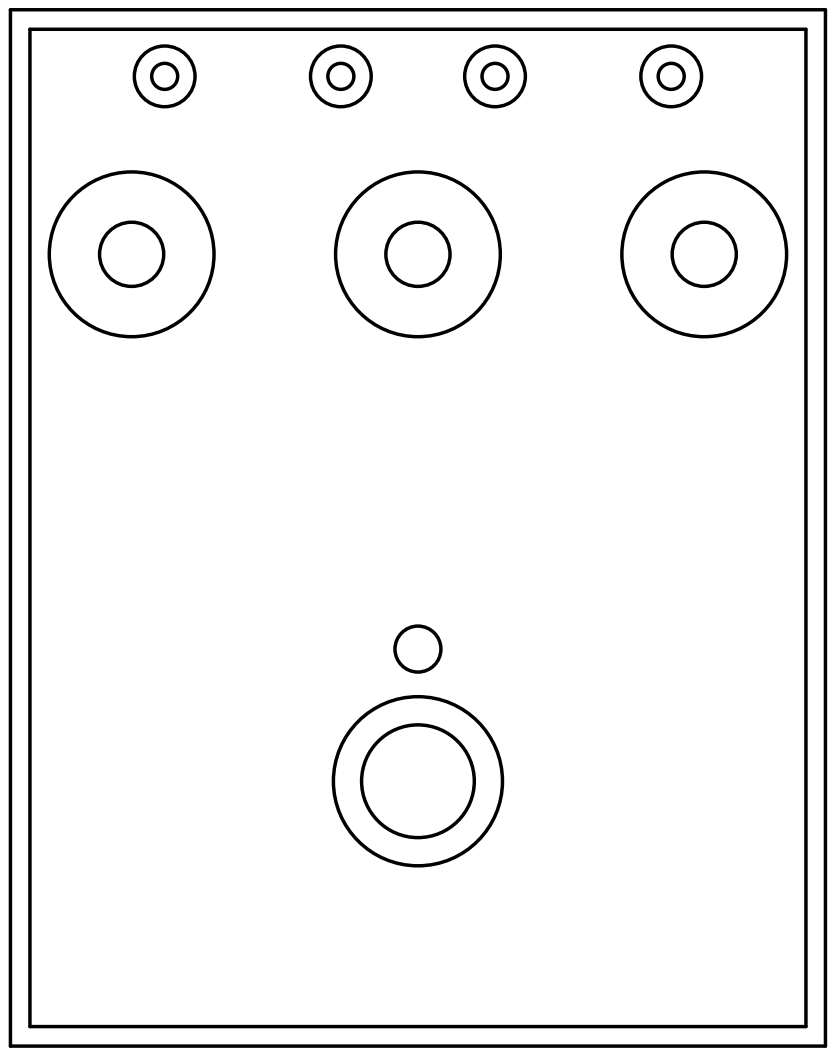
[picture p89: page 1]
