Adept666/stompboxes/SILKSCREEN/pdf_clean_white/xlr_ab_footswitch_r1_1.pdf

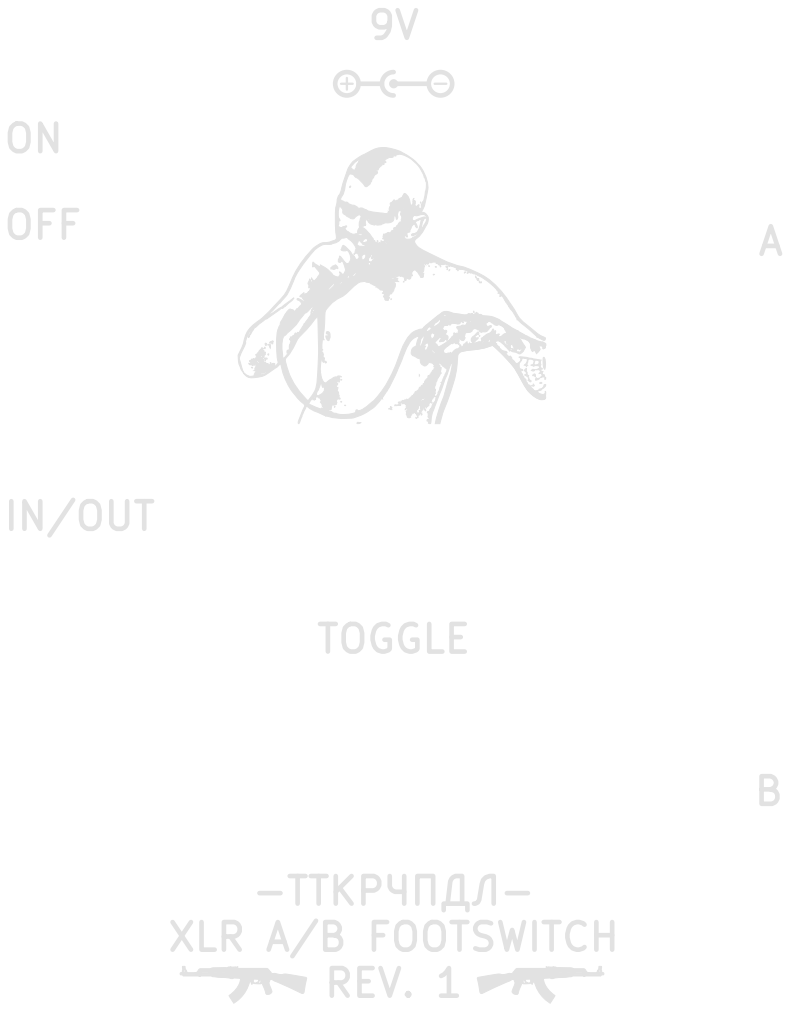
[picture p90: page 1]
