Adept666/stompboxes/SILKSCREEN/sources_kicad/xlr_ab_footswitch_r1_1.pdf

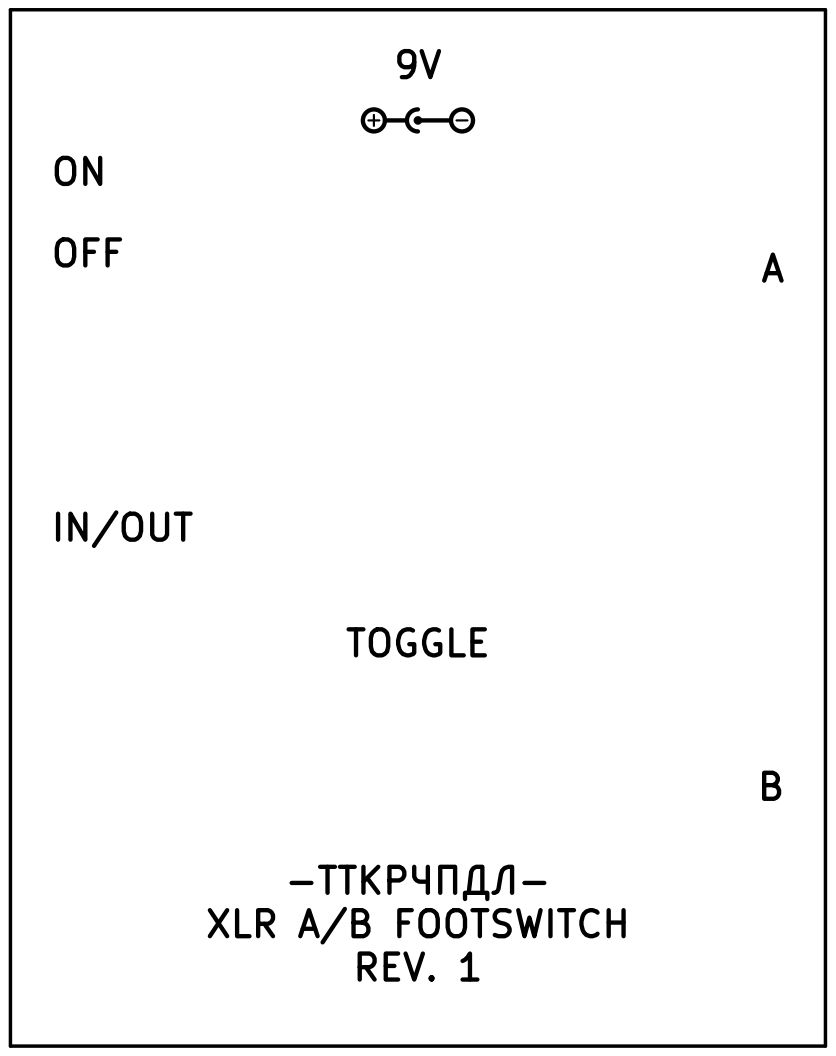
[picture p91: page 1]
