Adept666/stompboxes/SILKSCREEN/sources_kicad/xlr_ab_footswitch_r1_collision.pdf

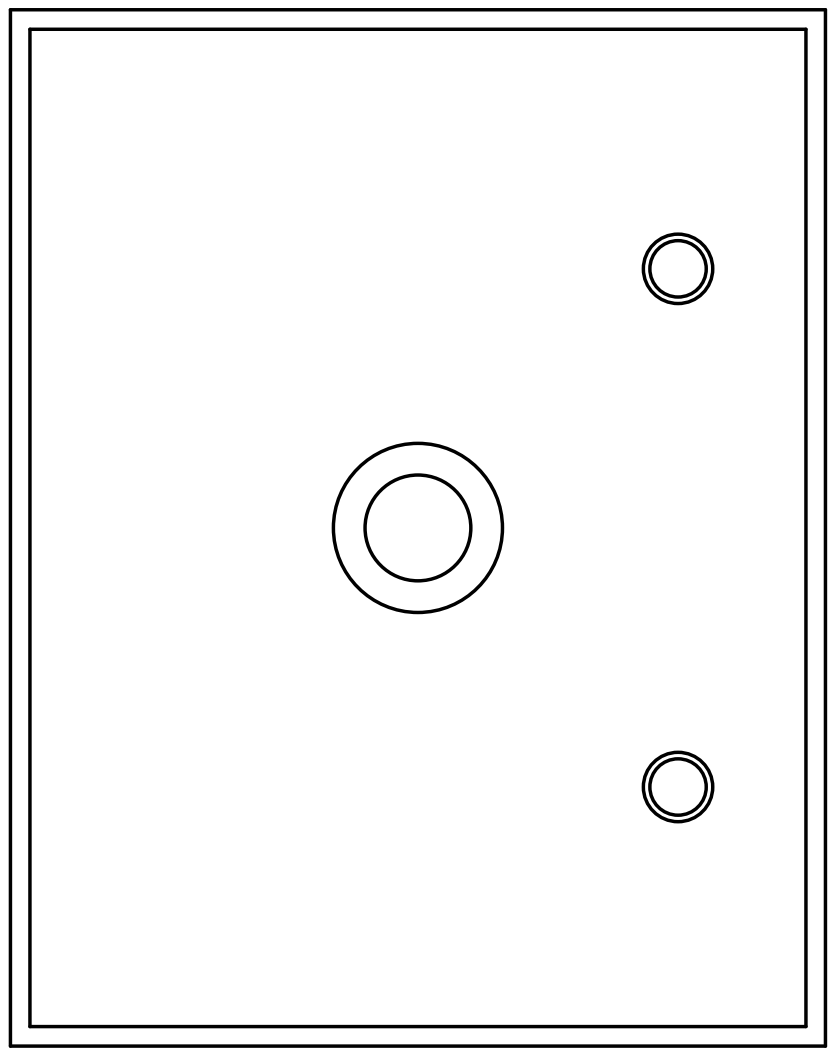
[picture p92: page 1]
