Adept666/stompboxes/SILKSCREEN/pdf_clean_white/fuzz_factory_r1_1.pdf

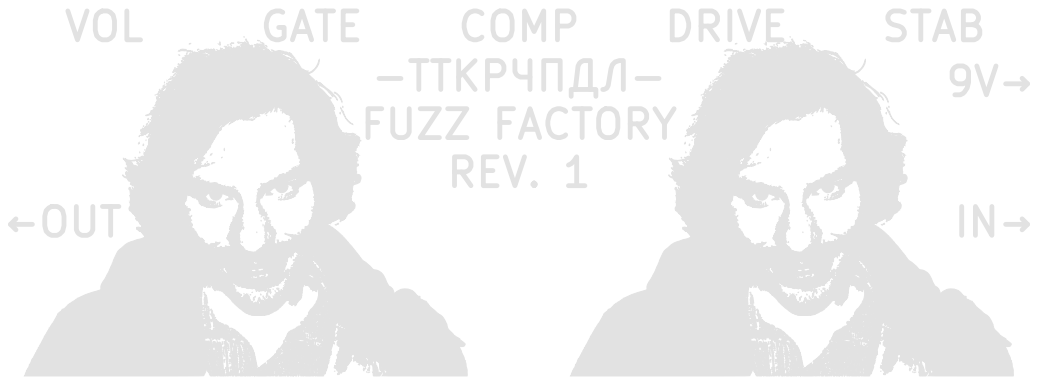
[picture p93: page 1]
