Adept666/stompboxes/SILKSCREEN/pdf_clean_white/good_grief_overdrive_r1_1.pdf

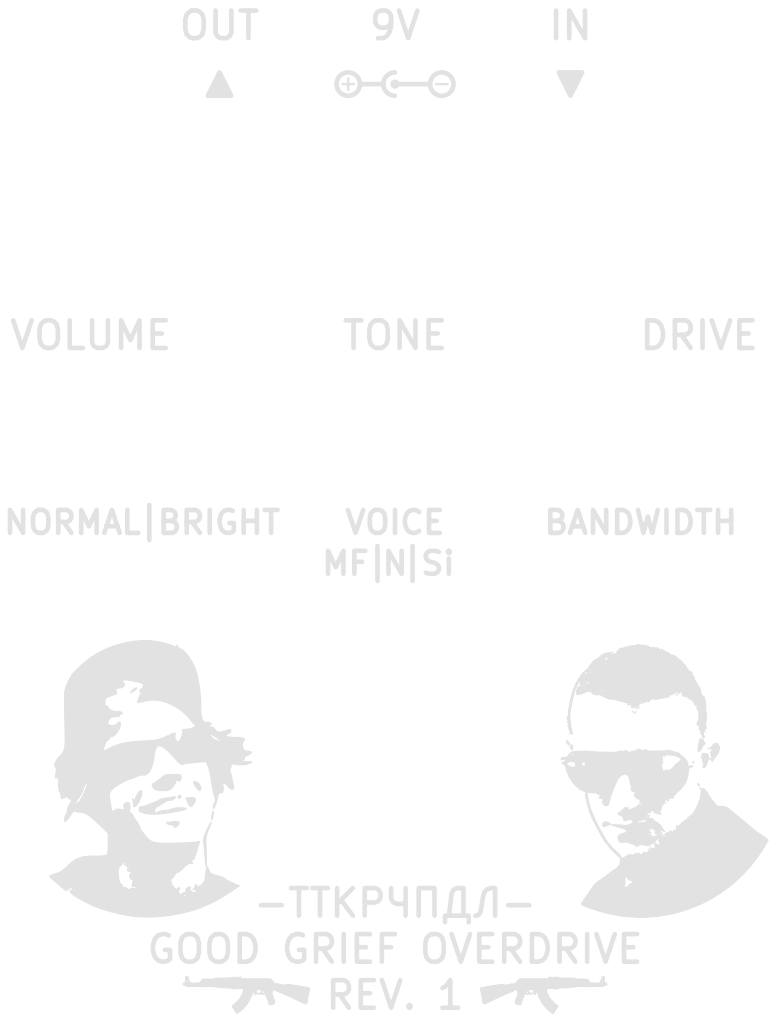
[picture p94: page 1]
