Adept666/stompboxes/SILKSCREEN/pdf_clean_white/little_angel_chorus_r1_1.pdf

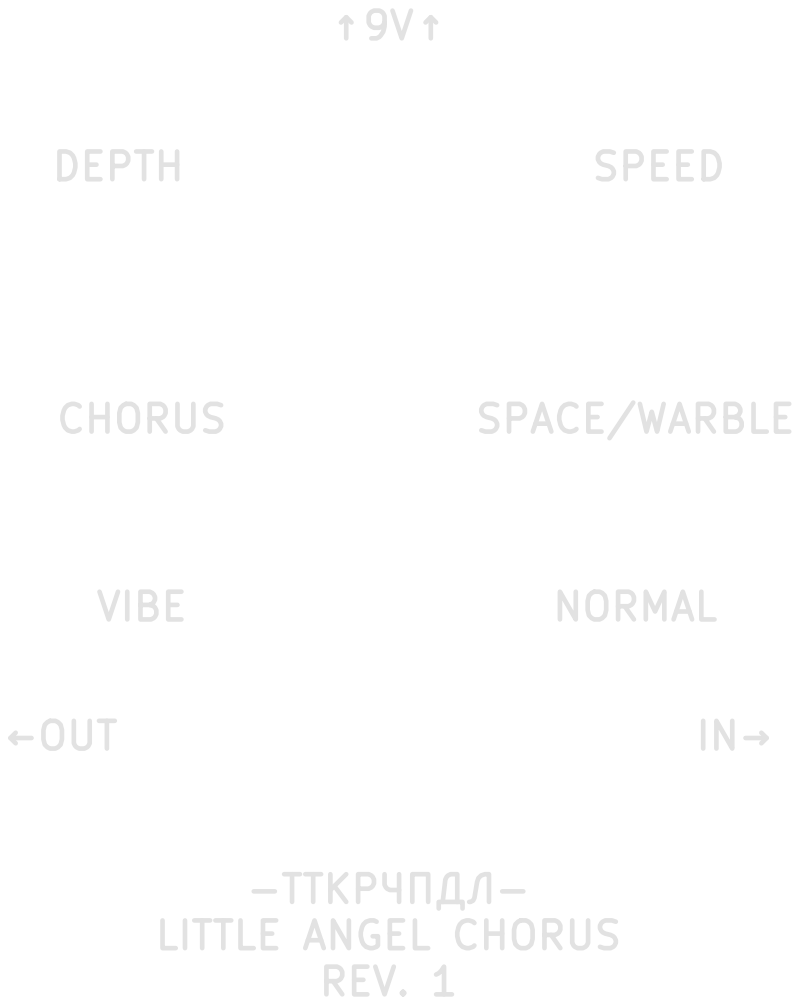
[picture p95: page 1]
