Adept666/stompboxes/SILKSCREEN/sources_kicad/big_muff_r2_bass_1.pdf

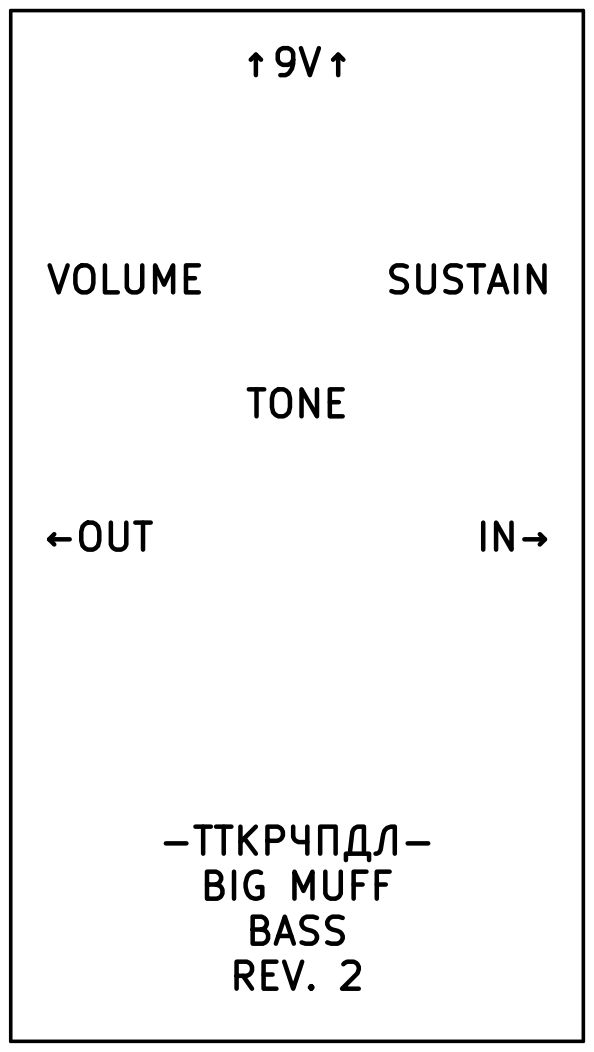
[picture p96: page 1]
