Adept666/stompboxes/SILKSCREEN/sources_kicad/big_muff_r2_collision.pdf

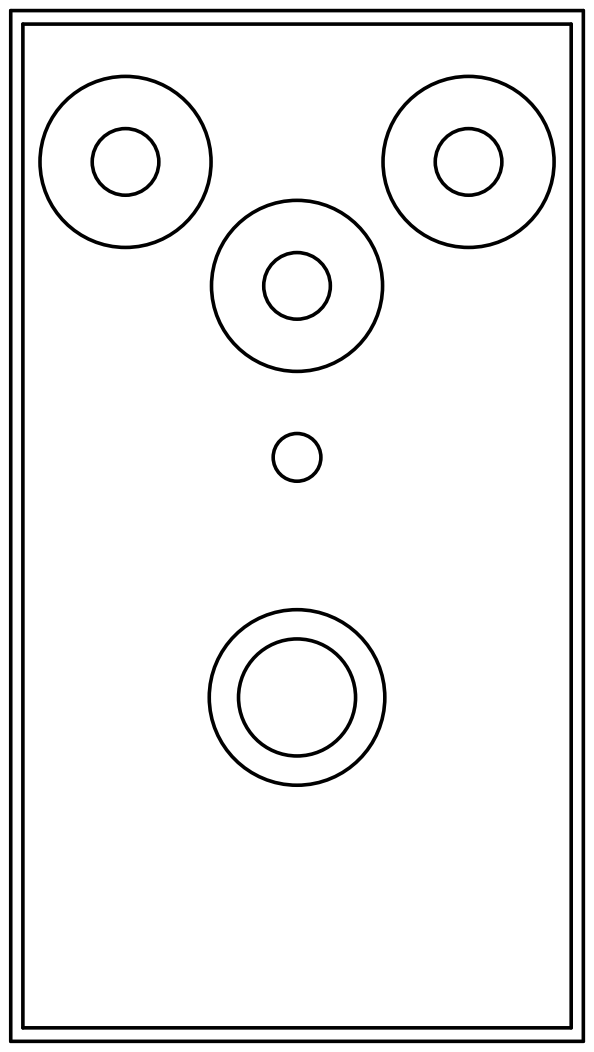
[picture p97: page 1]
