Adept666/stompboxes/SILKSCREEN/sources_kicad/big_muff_r2_nyc_1.pdf

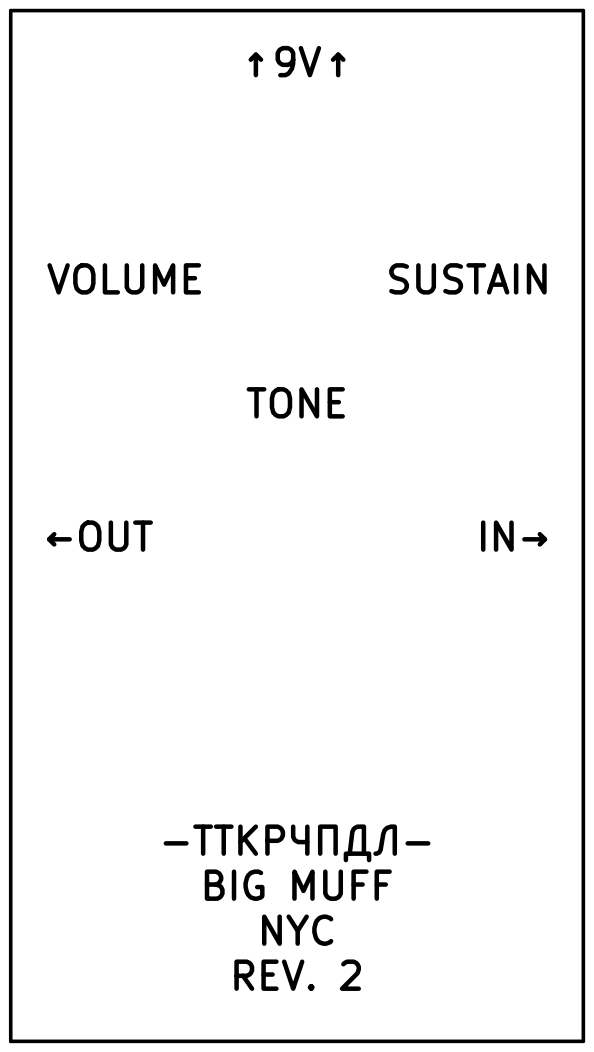
[picture p98: page 1]
