Adept666/stompboxes/SILKSCREEN/sources_kicad/deep_blue_delay_r3_1.pdf

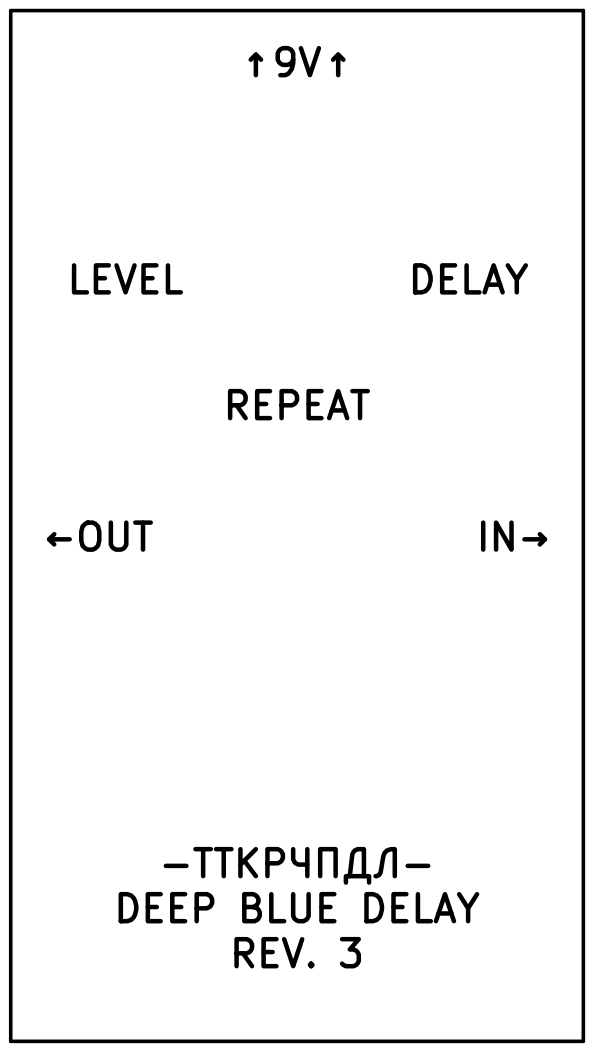
[picture p99: page 1]
