Adept666/stompboxes/SILKSCREEN/sources_kicad/distortion_+_r2_1.pdf

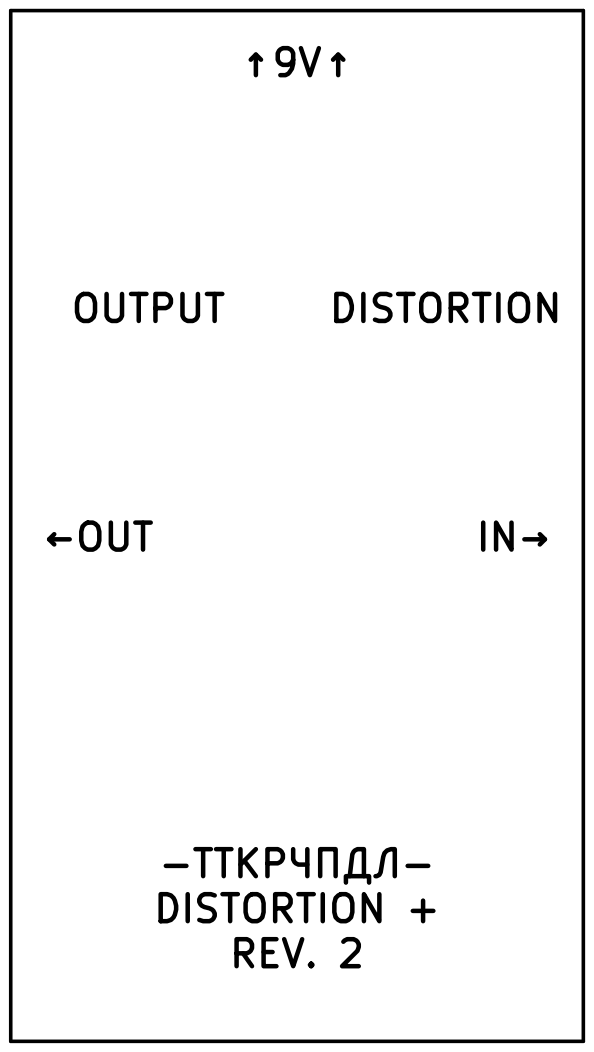
[picture p100: page 1]
