Adept666/stompboxes/SILKSCREEN/sources_kicad/distortion_+_r2_collision.pdf

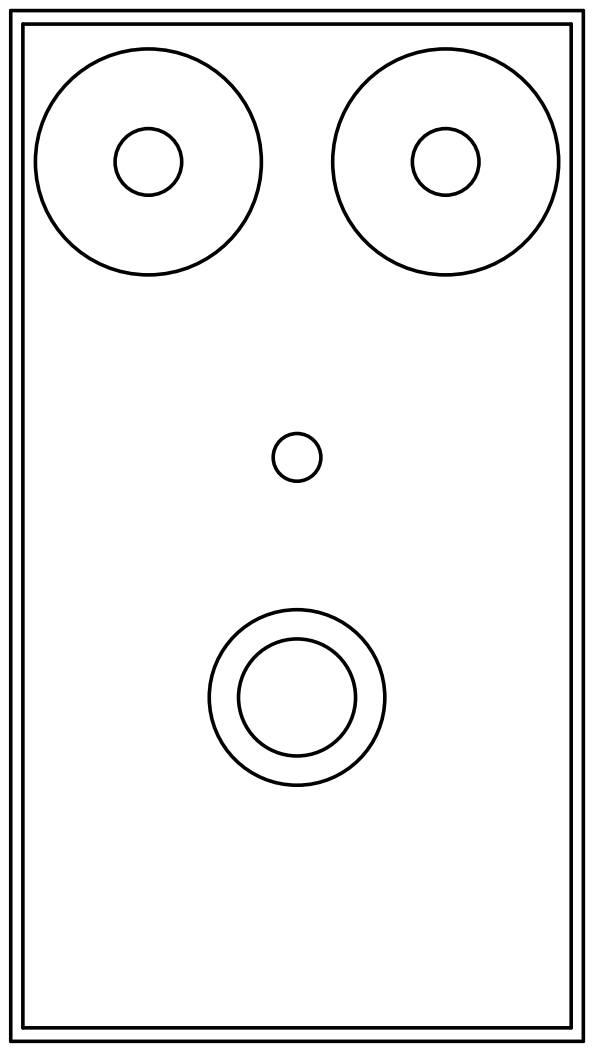
[picture p101: page 1]
