Adept666/stompboxes/SILKSCREEN/sources_kicad/fuzz_factory_r1_1.pdf

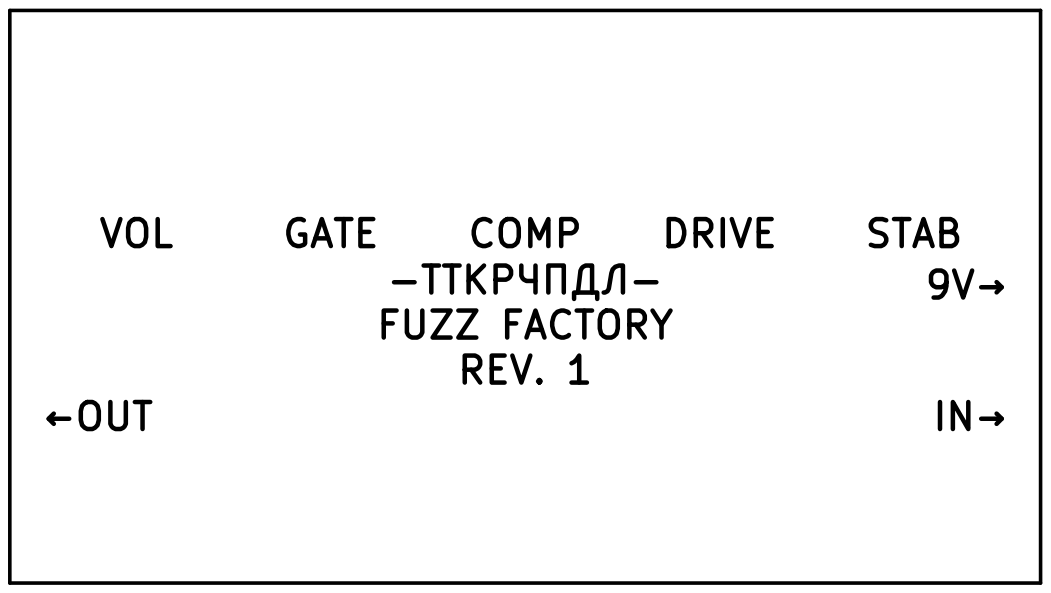
[picture p102: page 1]
