Adept666/stompboxes/SILKSCREEN/sources_kicad/fuzz_factory_r1_collision.pdf

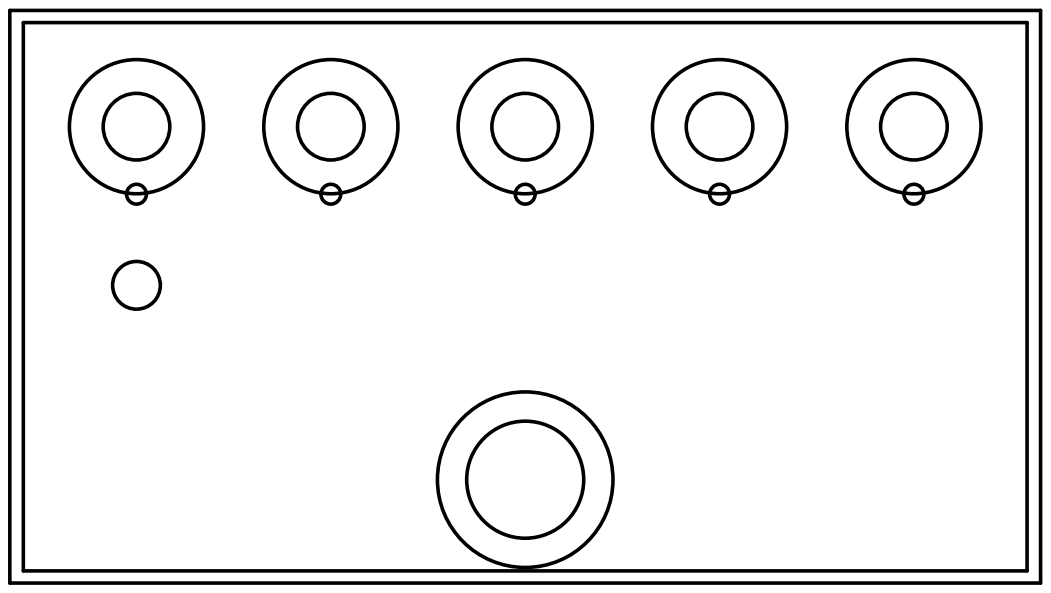
[picture p103: page 1]
