Adept666/stompboxes/SILKSCREEN/sources_kicad/good_grief_overdrive_r1_1.pdf

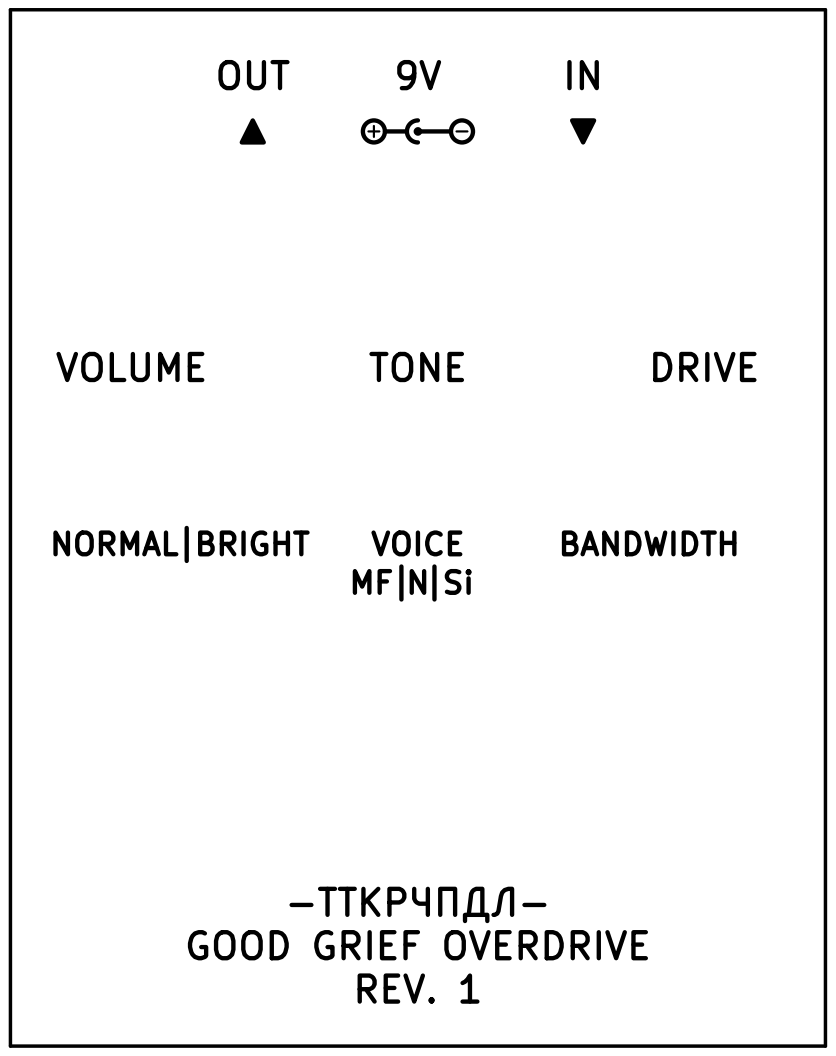
[picture p104: page 1]
