Adept666/stompboxes/SILKSCREEN/sources_kicad/good_grief_overdrive_r1_collision.pdf

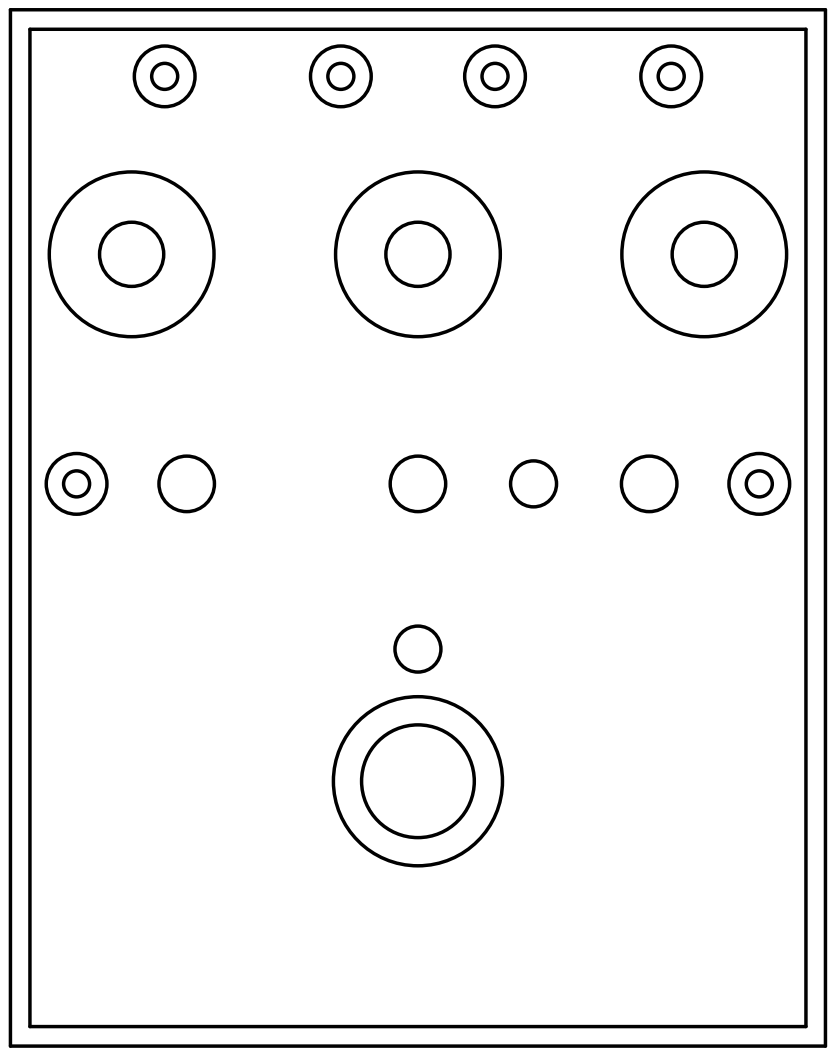
[picture p105: page 1]
