Adept666/stompboxes/SILKSCREEN/sources_kicad/little_angel_chorus_r1_1.pdf

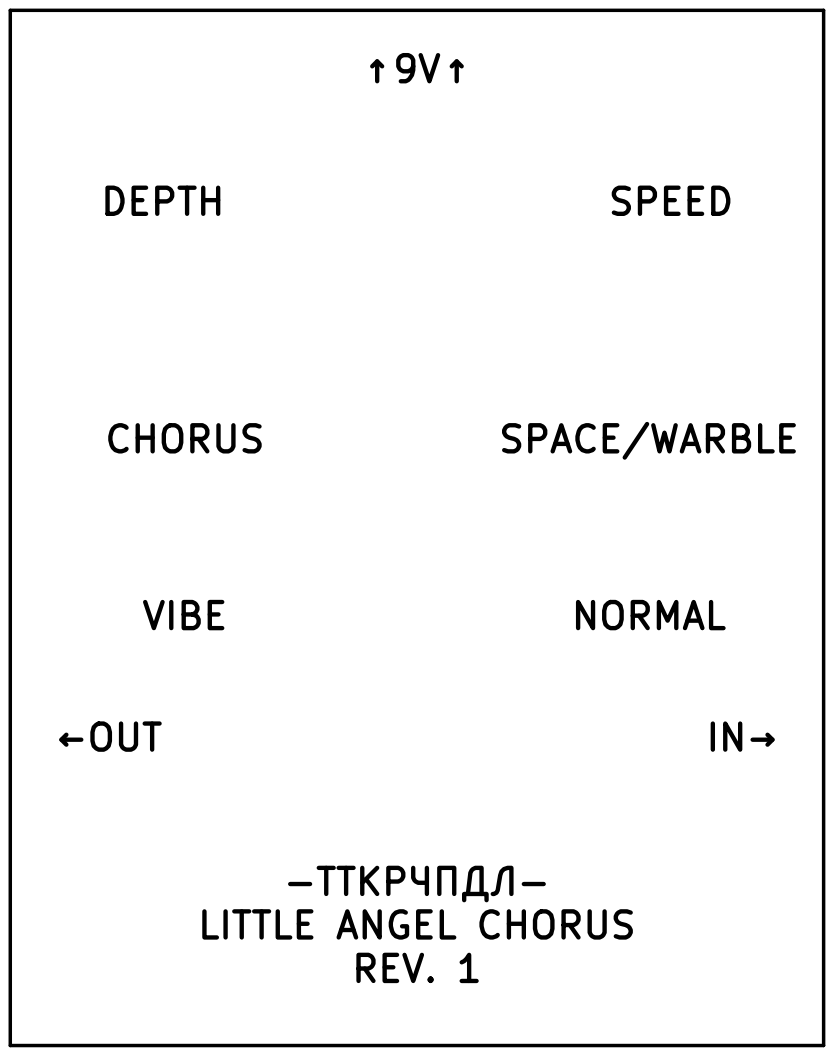
[picture p106: page 1]
