Adept666/stompboxes/SILKSCREEN/sources_kicad/little_angel_chorus_r1_collision.pdf

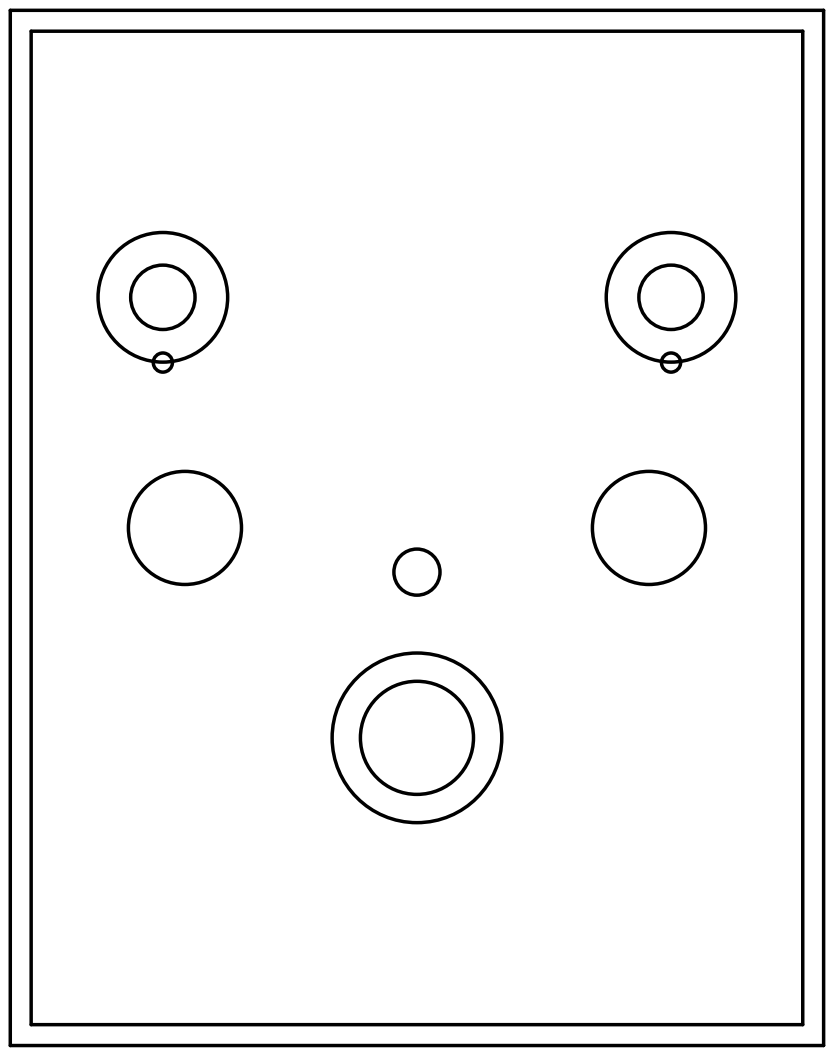
[picture p107: page 1]
