Adept666/stompboxes/PCBS-PCAS/ТКП-3.44.A/ТКП-1.40.A-1/output/ТКП-1.40.A-1-FAB-TOP.pdf

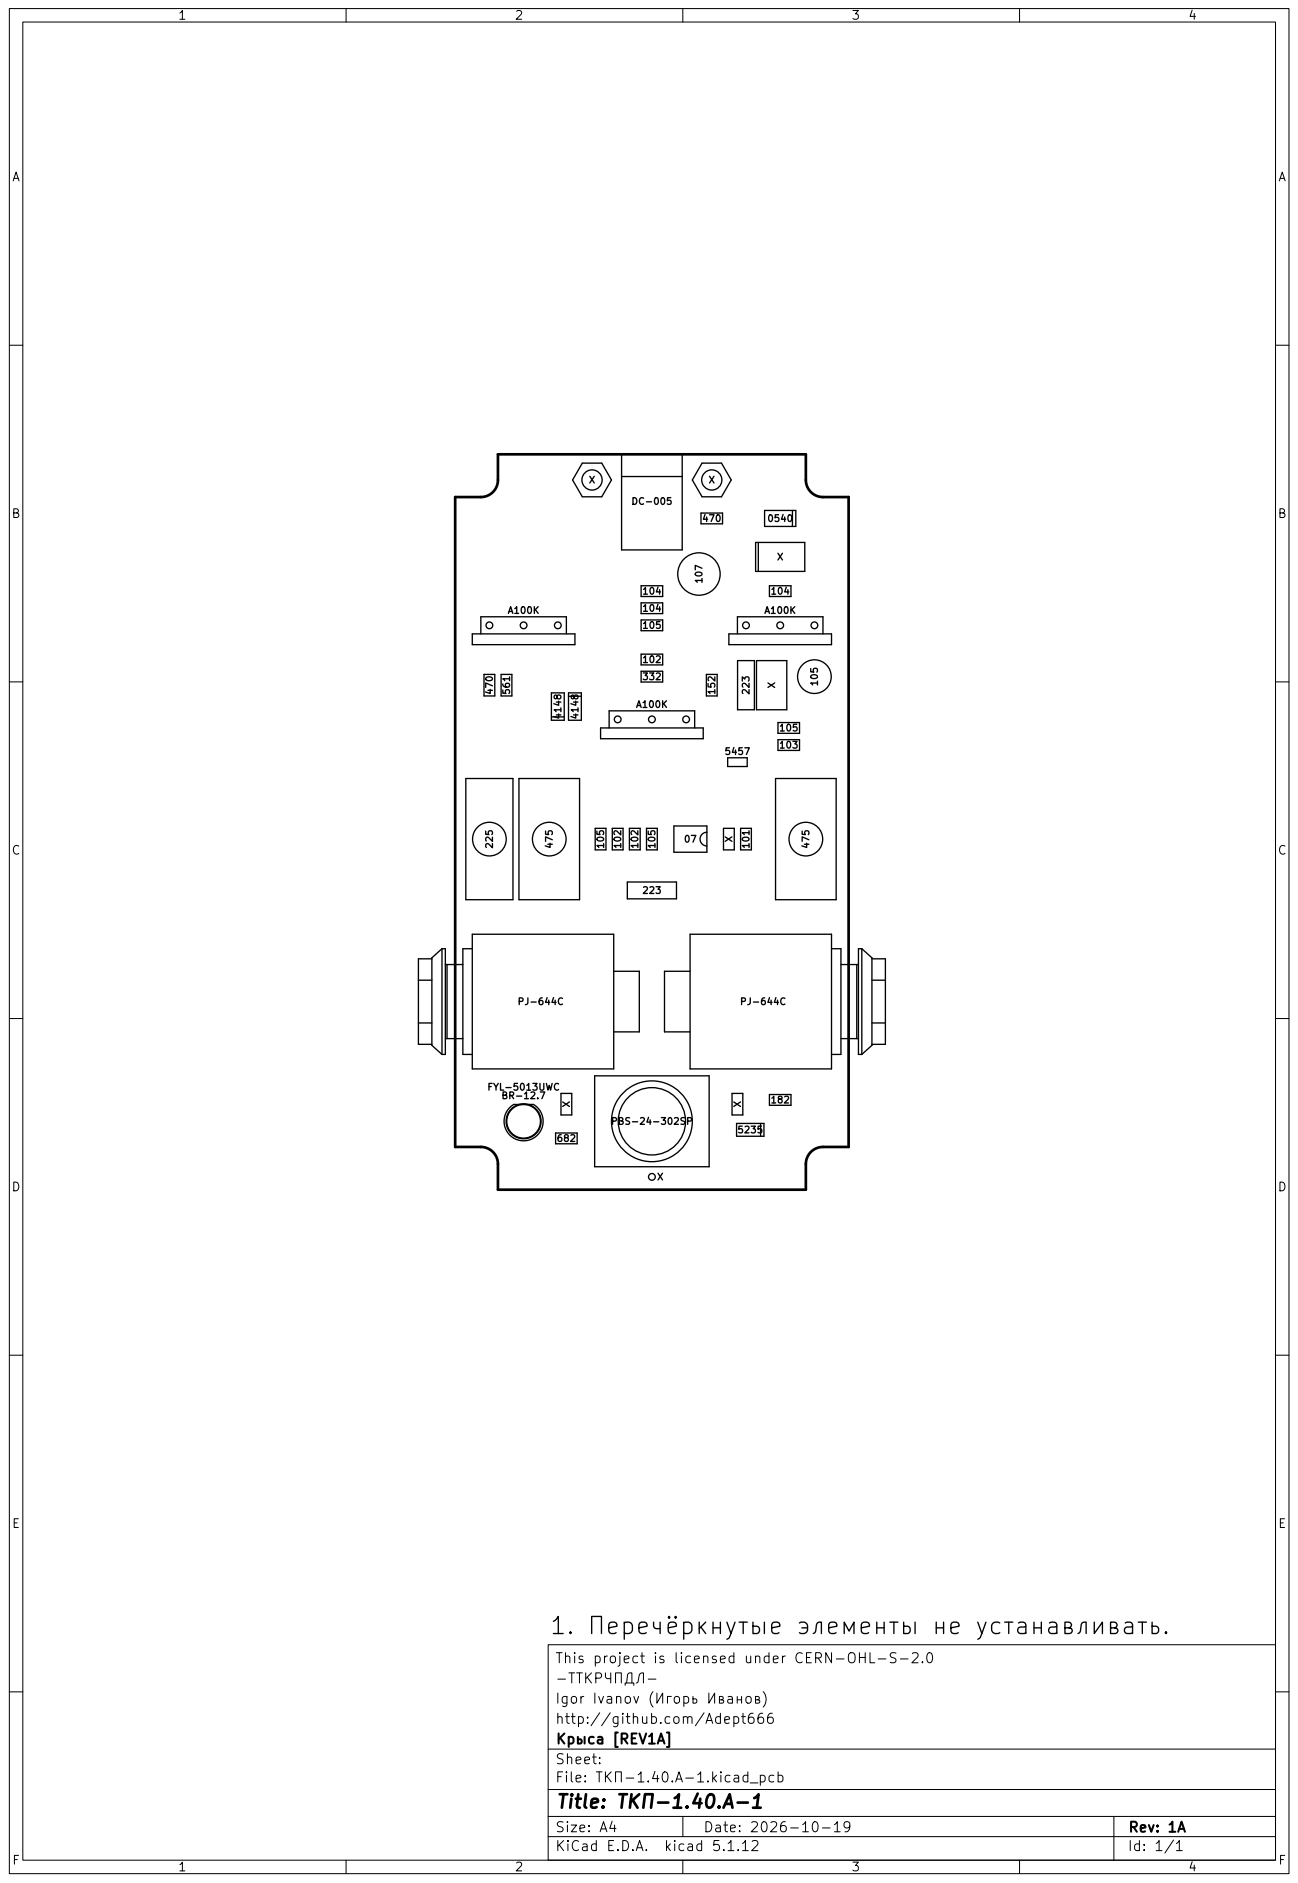
[picture p108: page 1]

--This project is licensed under CERN-OHL-S-2.0
