Adept666/stompboxes/PCBS-PCAS/ТКП-3.45.A/ТКП-1.41.A-1/output/ТКП-1.41.A-1-FAB-TOP.pdf

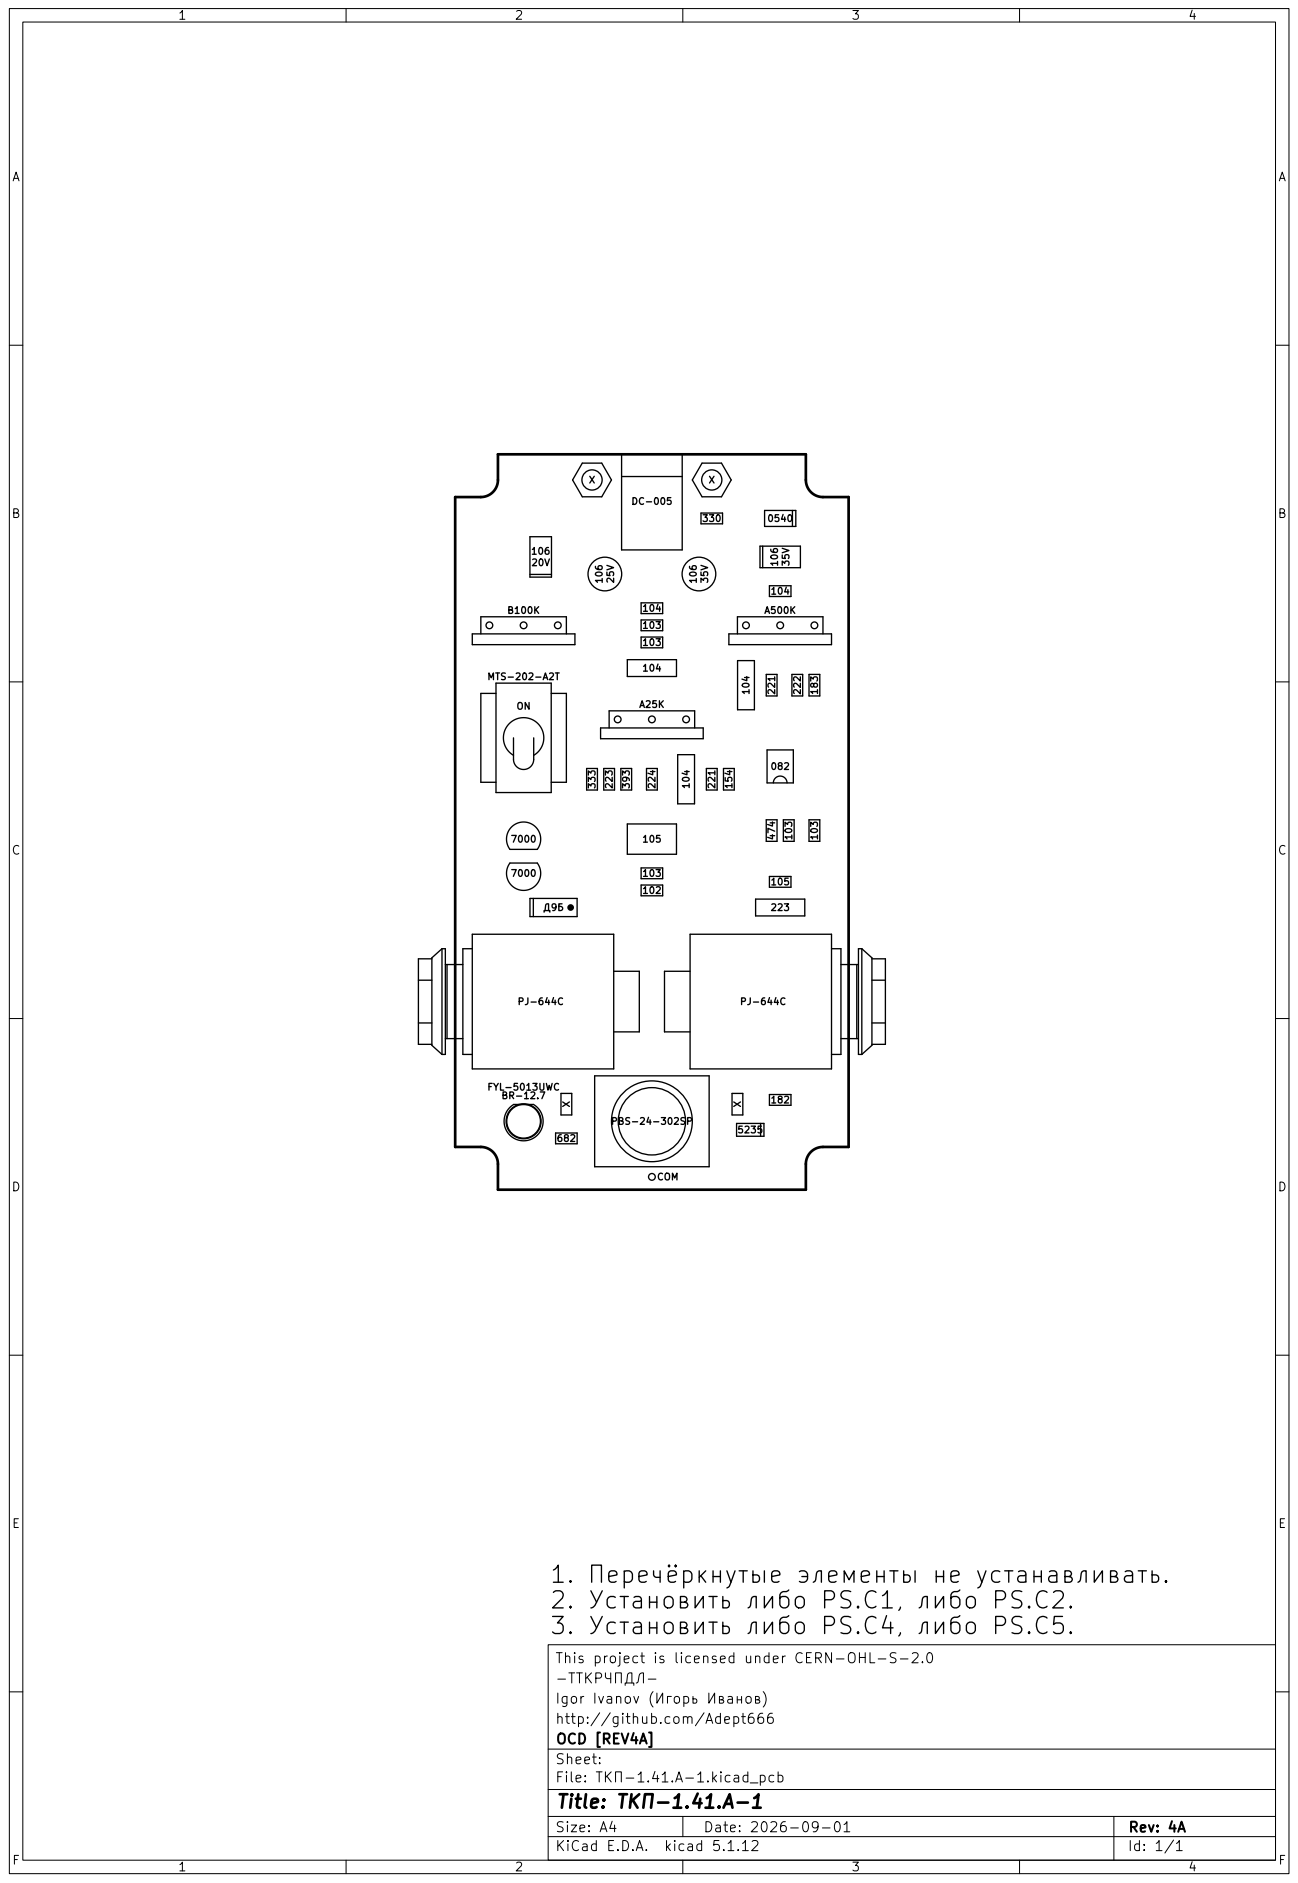
[picture p110: page 1]

--This project is licensed under CERN-OHL-S-2.0
