Adept666/stompboxes/PCBS-PCAS/ТКП-3.45.A/ТКП-1.41.A-1/output/ТКП-1.41.A-1-SCH.pdf

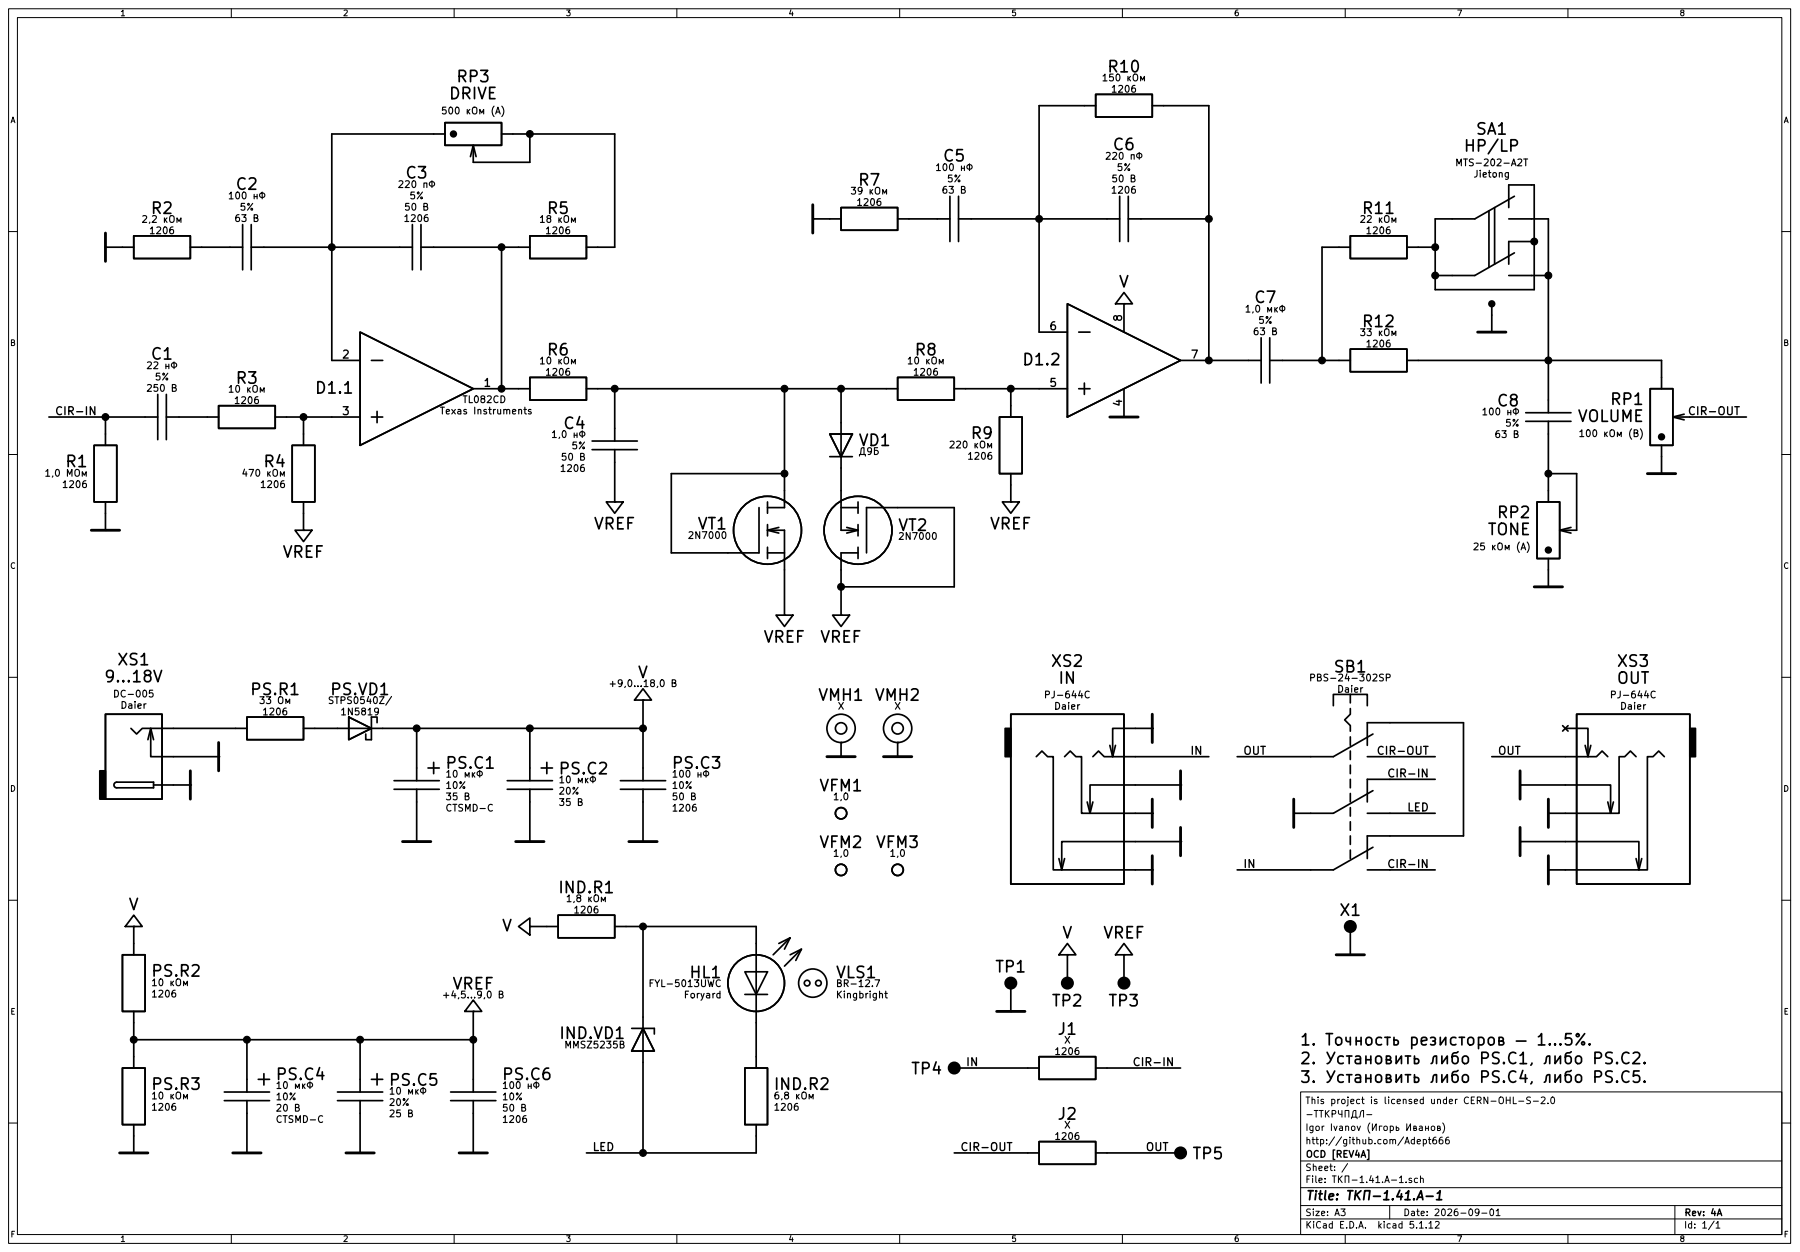
[picture p111: page 1]

--This project is licensed under CERN-OHL-S-2.0

Igor Ivanov ( )
http://github.com/Adept666
File: -1.41.A-1.sch Sheet: / OCD [REV4A]
