Adept666/stompboxes/PCBS-PCAS/ТКП-3.38.A/ТКП-1.36.A-5/output/ТКП-1.36.A-5-SCH.pdf

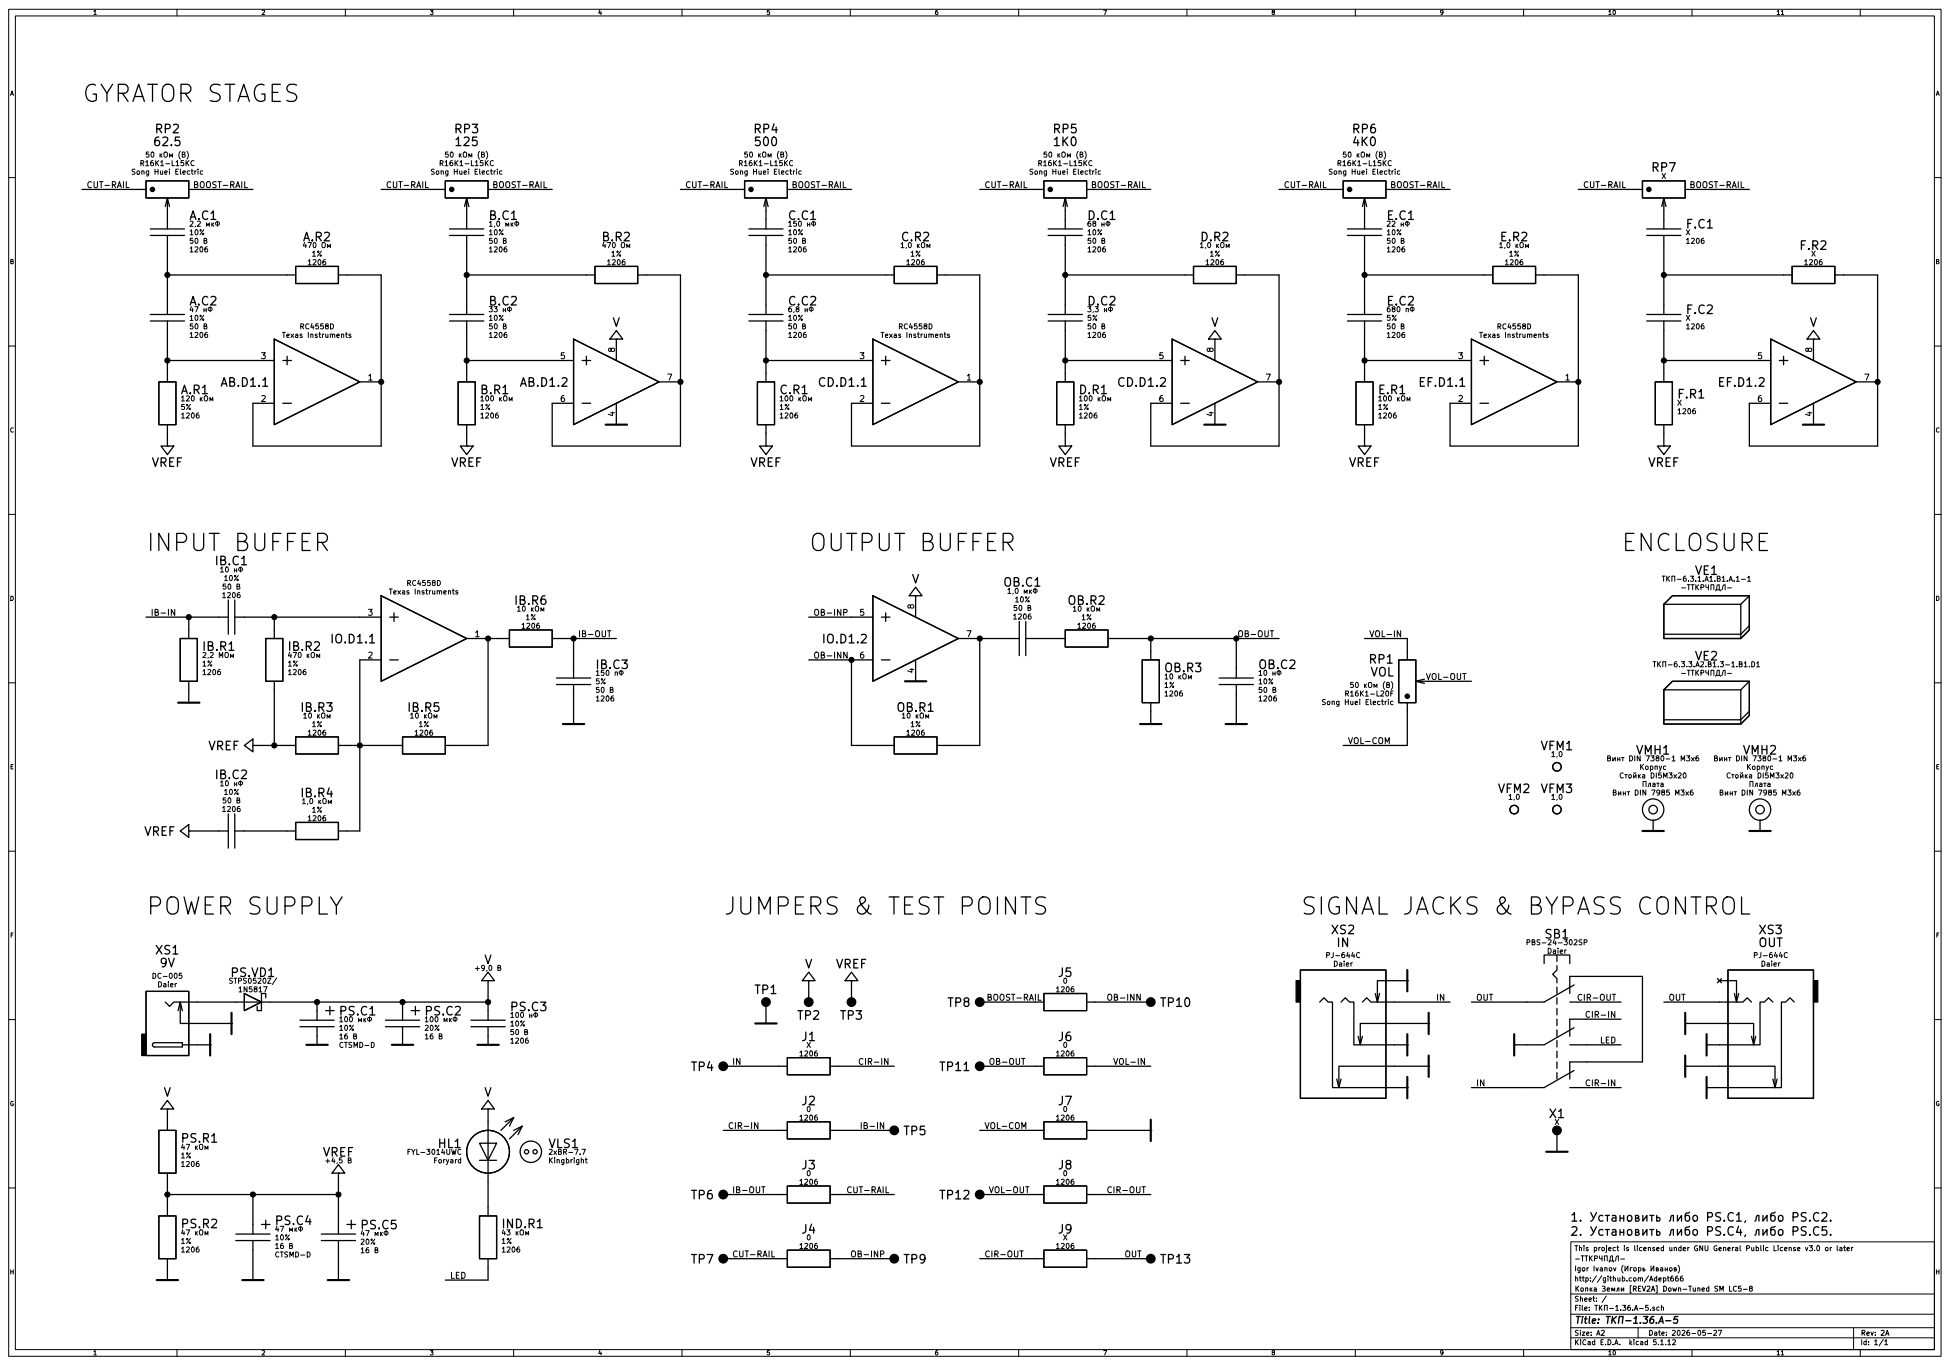
[picture p113: page 1]

SIGNAL JACKS & BYPASS CONTROL

--This project is licensed under GNU General Public License v3.0 or later
