Adept666/stompboxes/PCBS-PCAS/ТКП-3.12.A/ТКП-1.12.A-1/output/ТКП-1.12.A-1-SCH.pdf

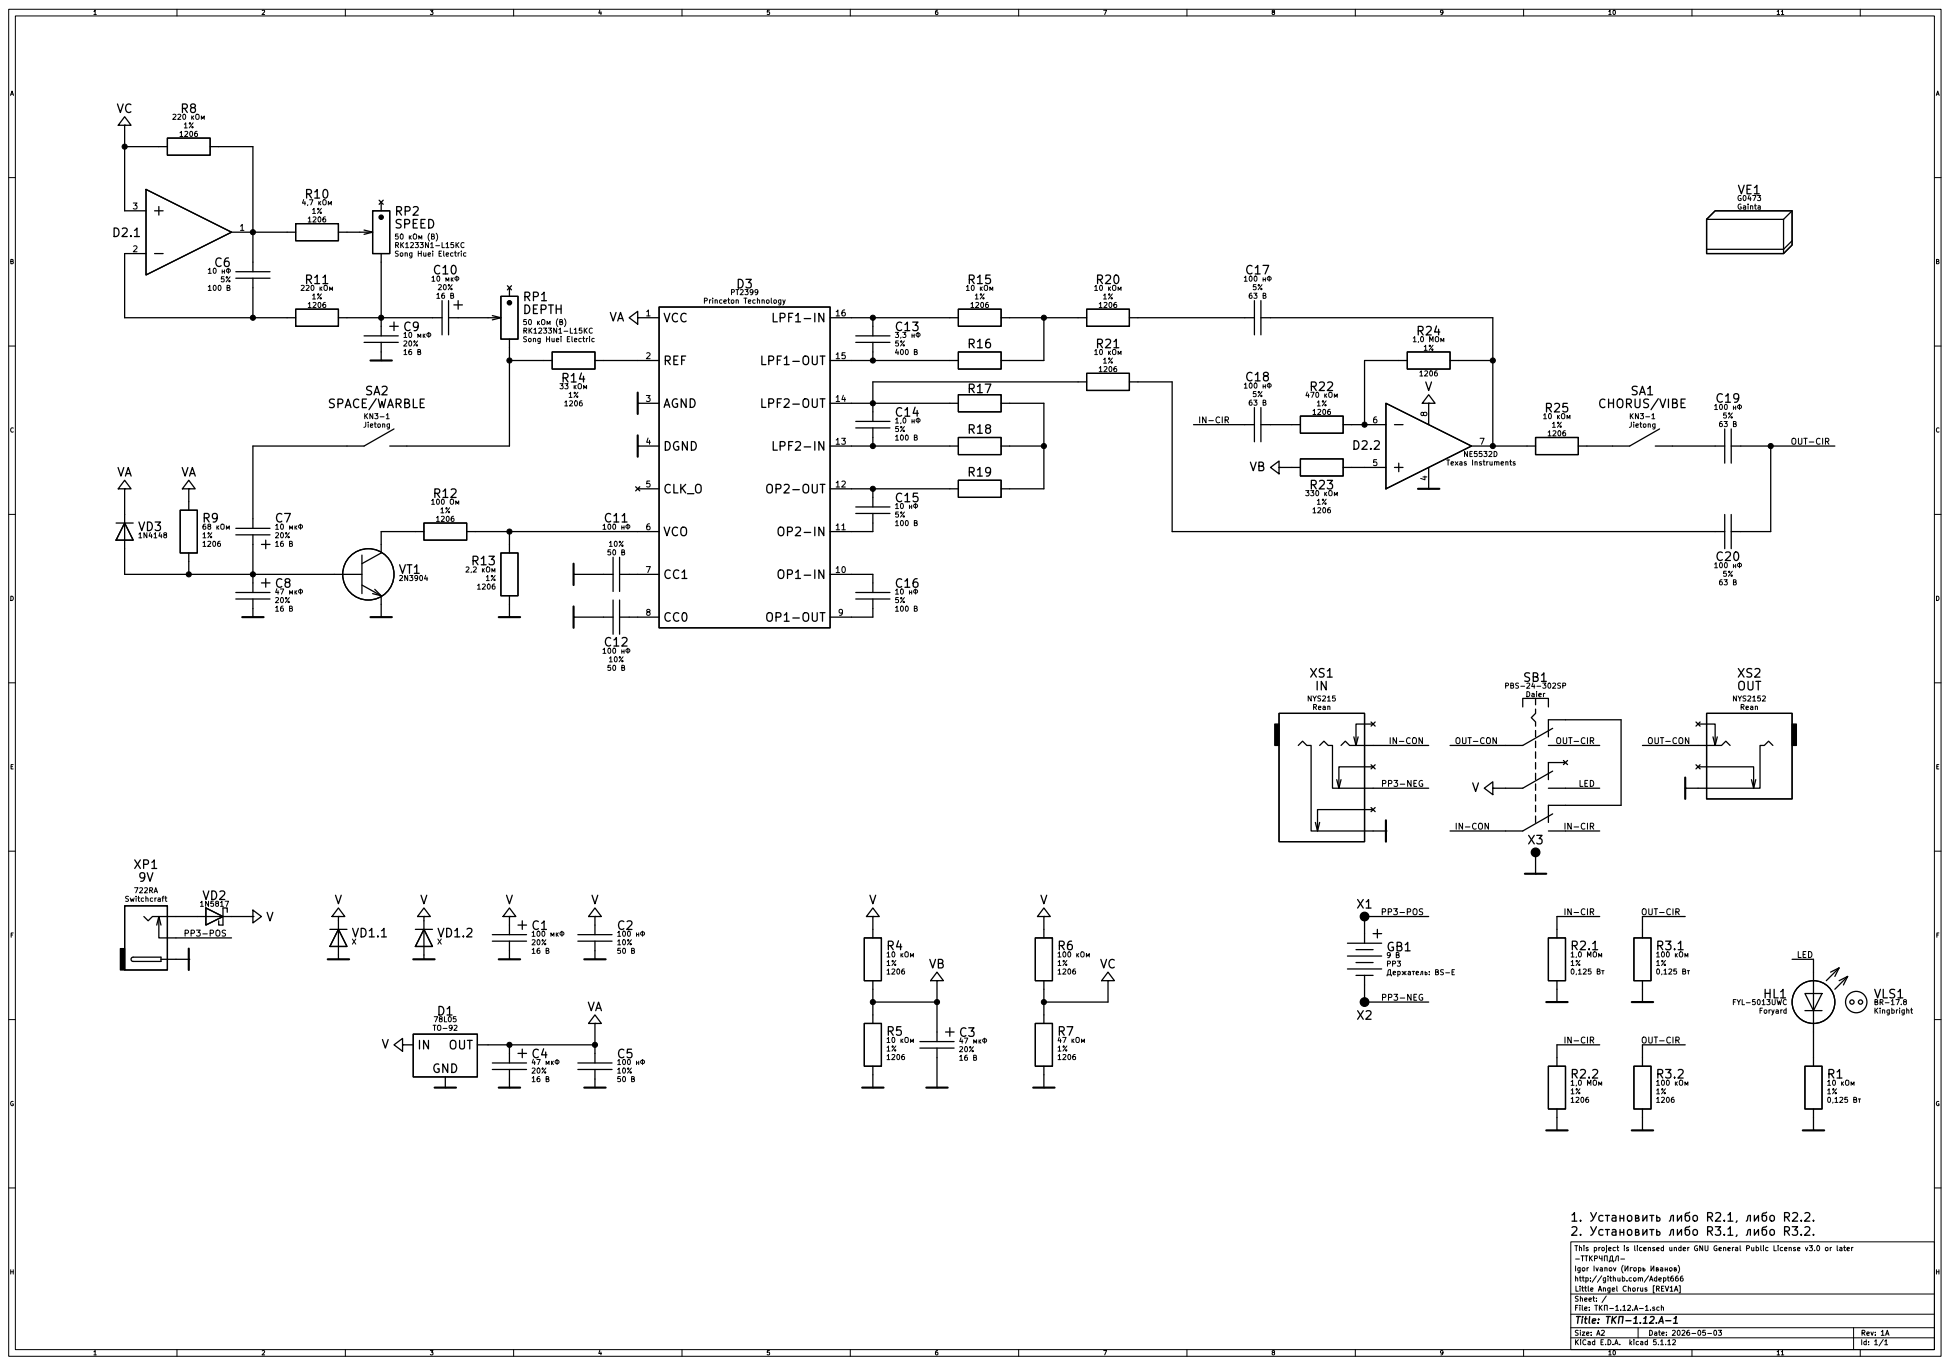
[picture p114: page 1]

--This project is licensed under GNU General Public License v3.0 or later

Igor Ivanov ( )
http://github.com/Adept666
File: -1.12.A-1.sch Sheet: / Little Angel Chorus [REV1A]
