Adept666/stompboxes/PCBS-PCAS/ТКП-3.30.B/ТКП-1.30.B-6/output/ТКП-1.30.B-6-SCH.pdf

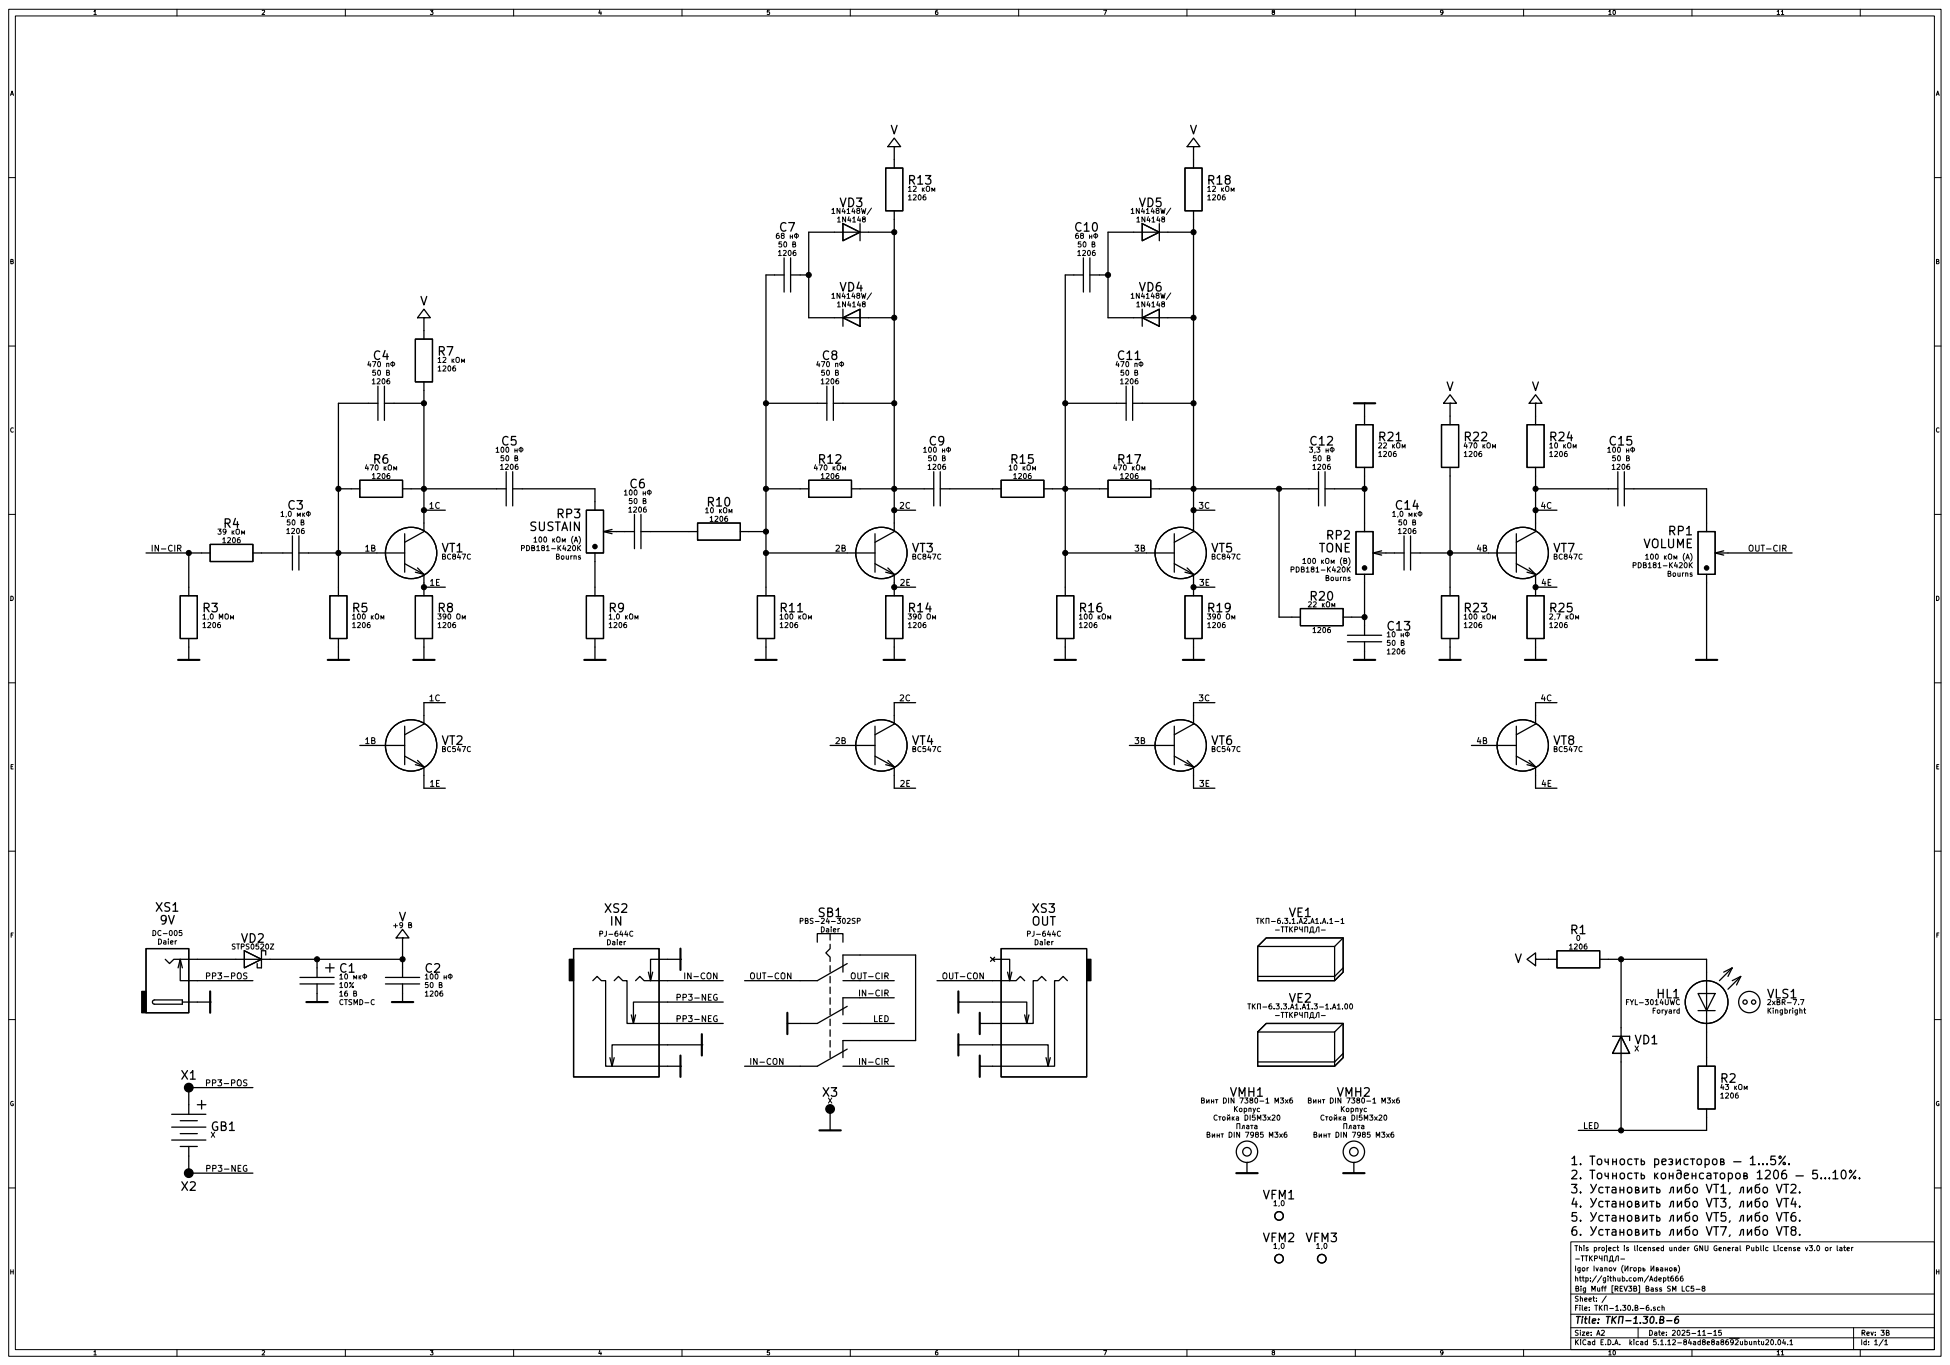
[picture p115: page 1]

--This project is licensed under GNU General Public License v3.0 or later

Igor Ivanov ( )
http://github.com/Adept666
File: -1.30.B-6.sch Sheet: / Big Muff [REV3B] Bass SM LC5-8
