Adept666/stompboxes/PCBS-PCAS/ТКП-3.30.B/ТКП-1.30.B-5/output/ТКП-1.30.B-5-SCH.pdf

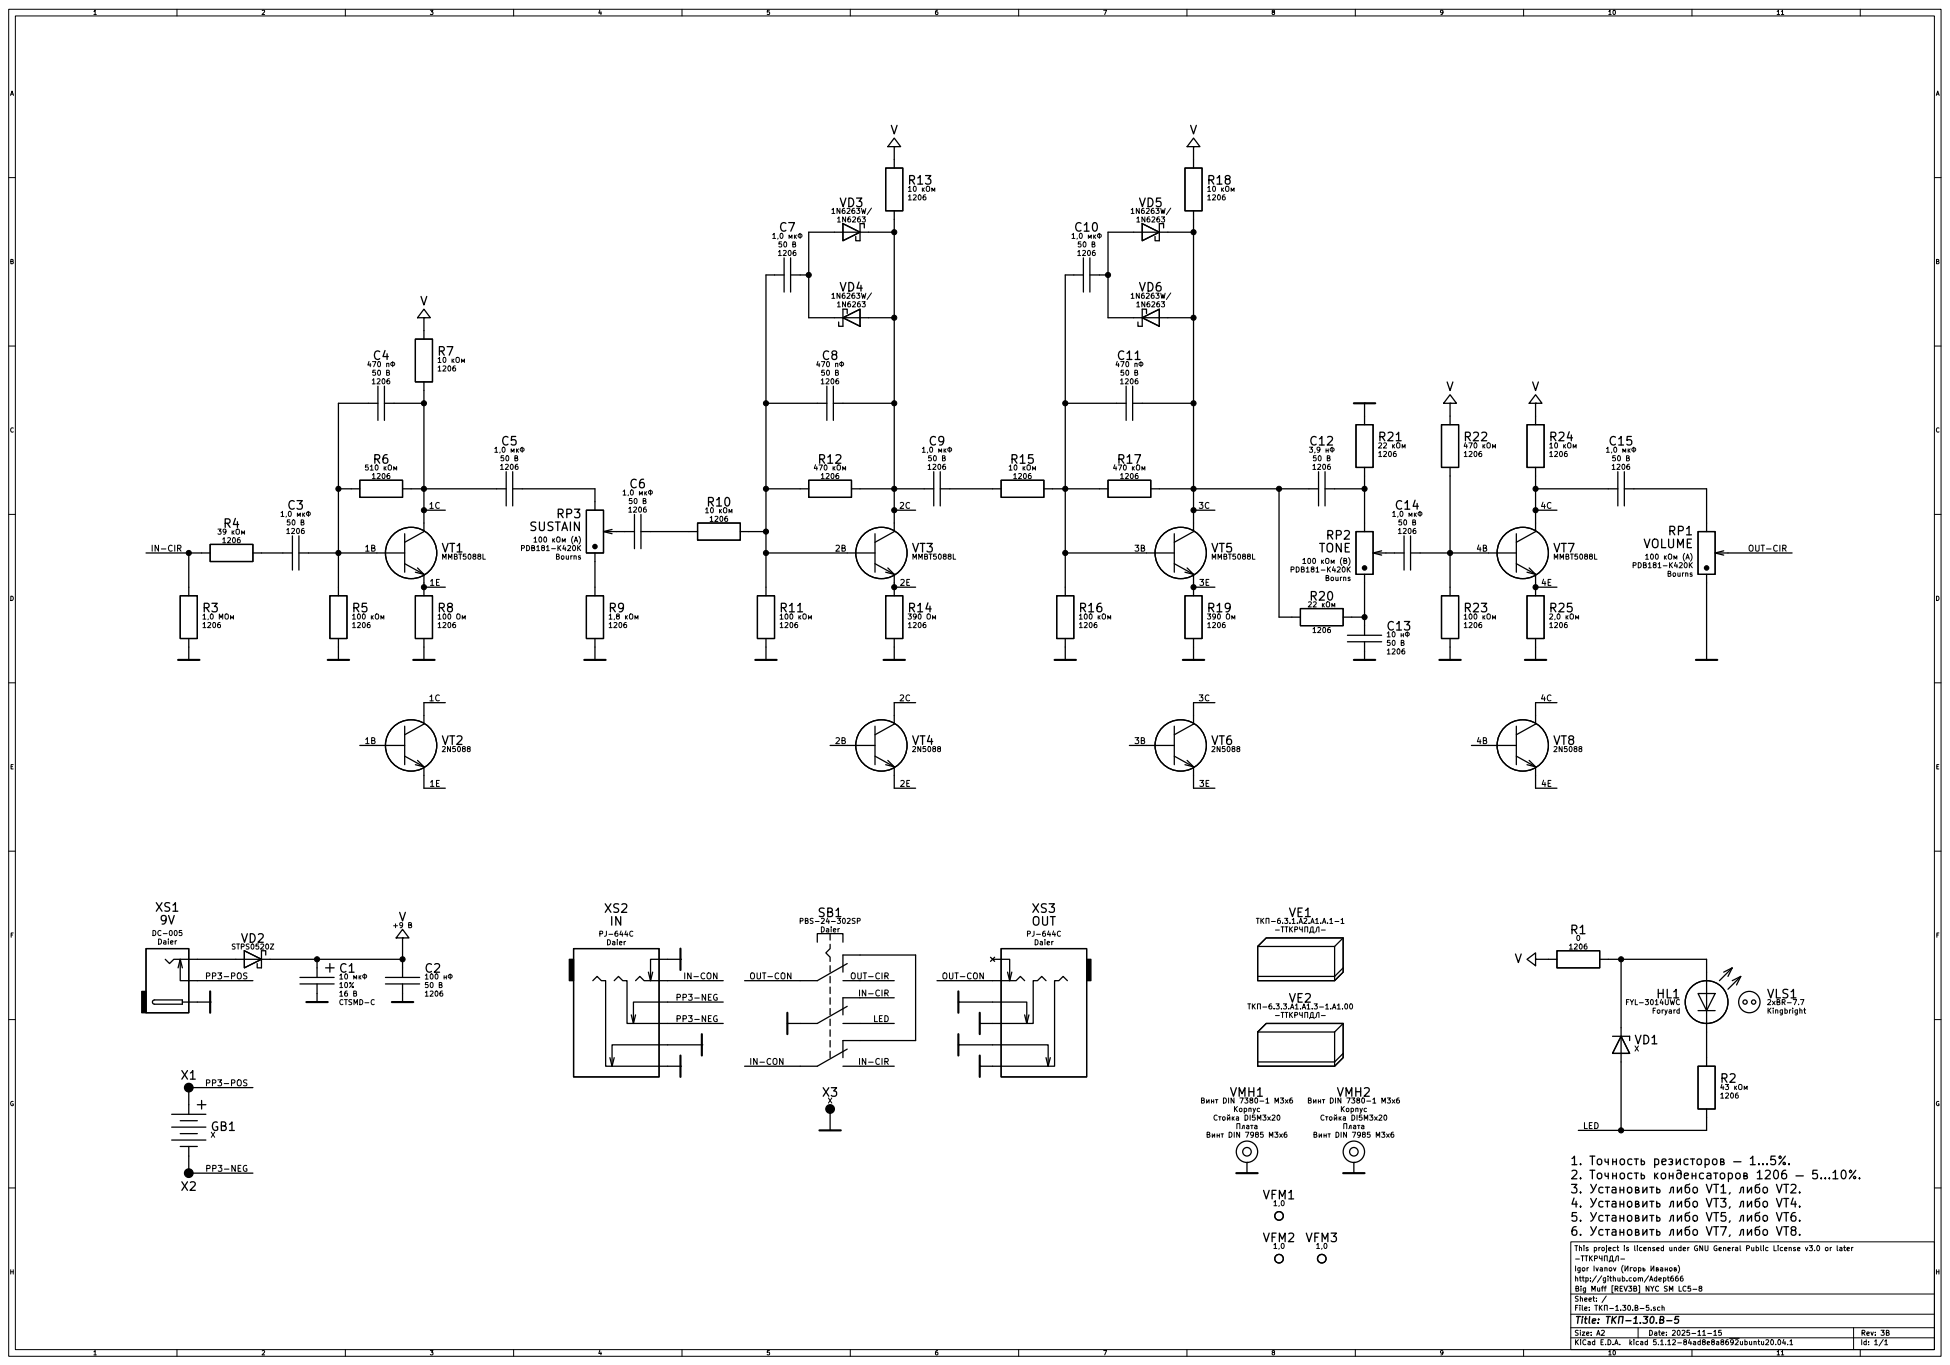
[picture p116: page 1]

--This project is licensed under GNU General Public License v3.0 or later

Igor Ivanov ( )
http://github.com/Adept666
File: -1.30.B-5.sch Sheet: / Big Muff [REV3B] NYC SM LC5-8
