Adept666/stompboxes/PCBS-PCAS/ТКП-3.30.A/ТКП-1.30.A-6/output/ТКП-1.30.A-6-SCH.pdf

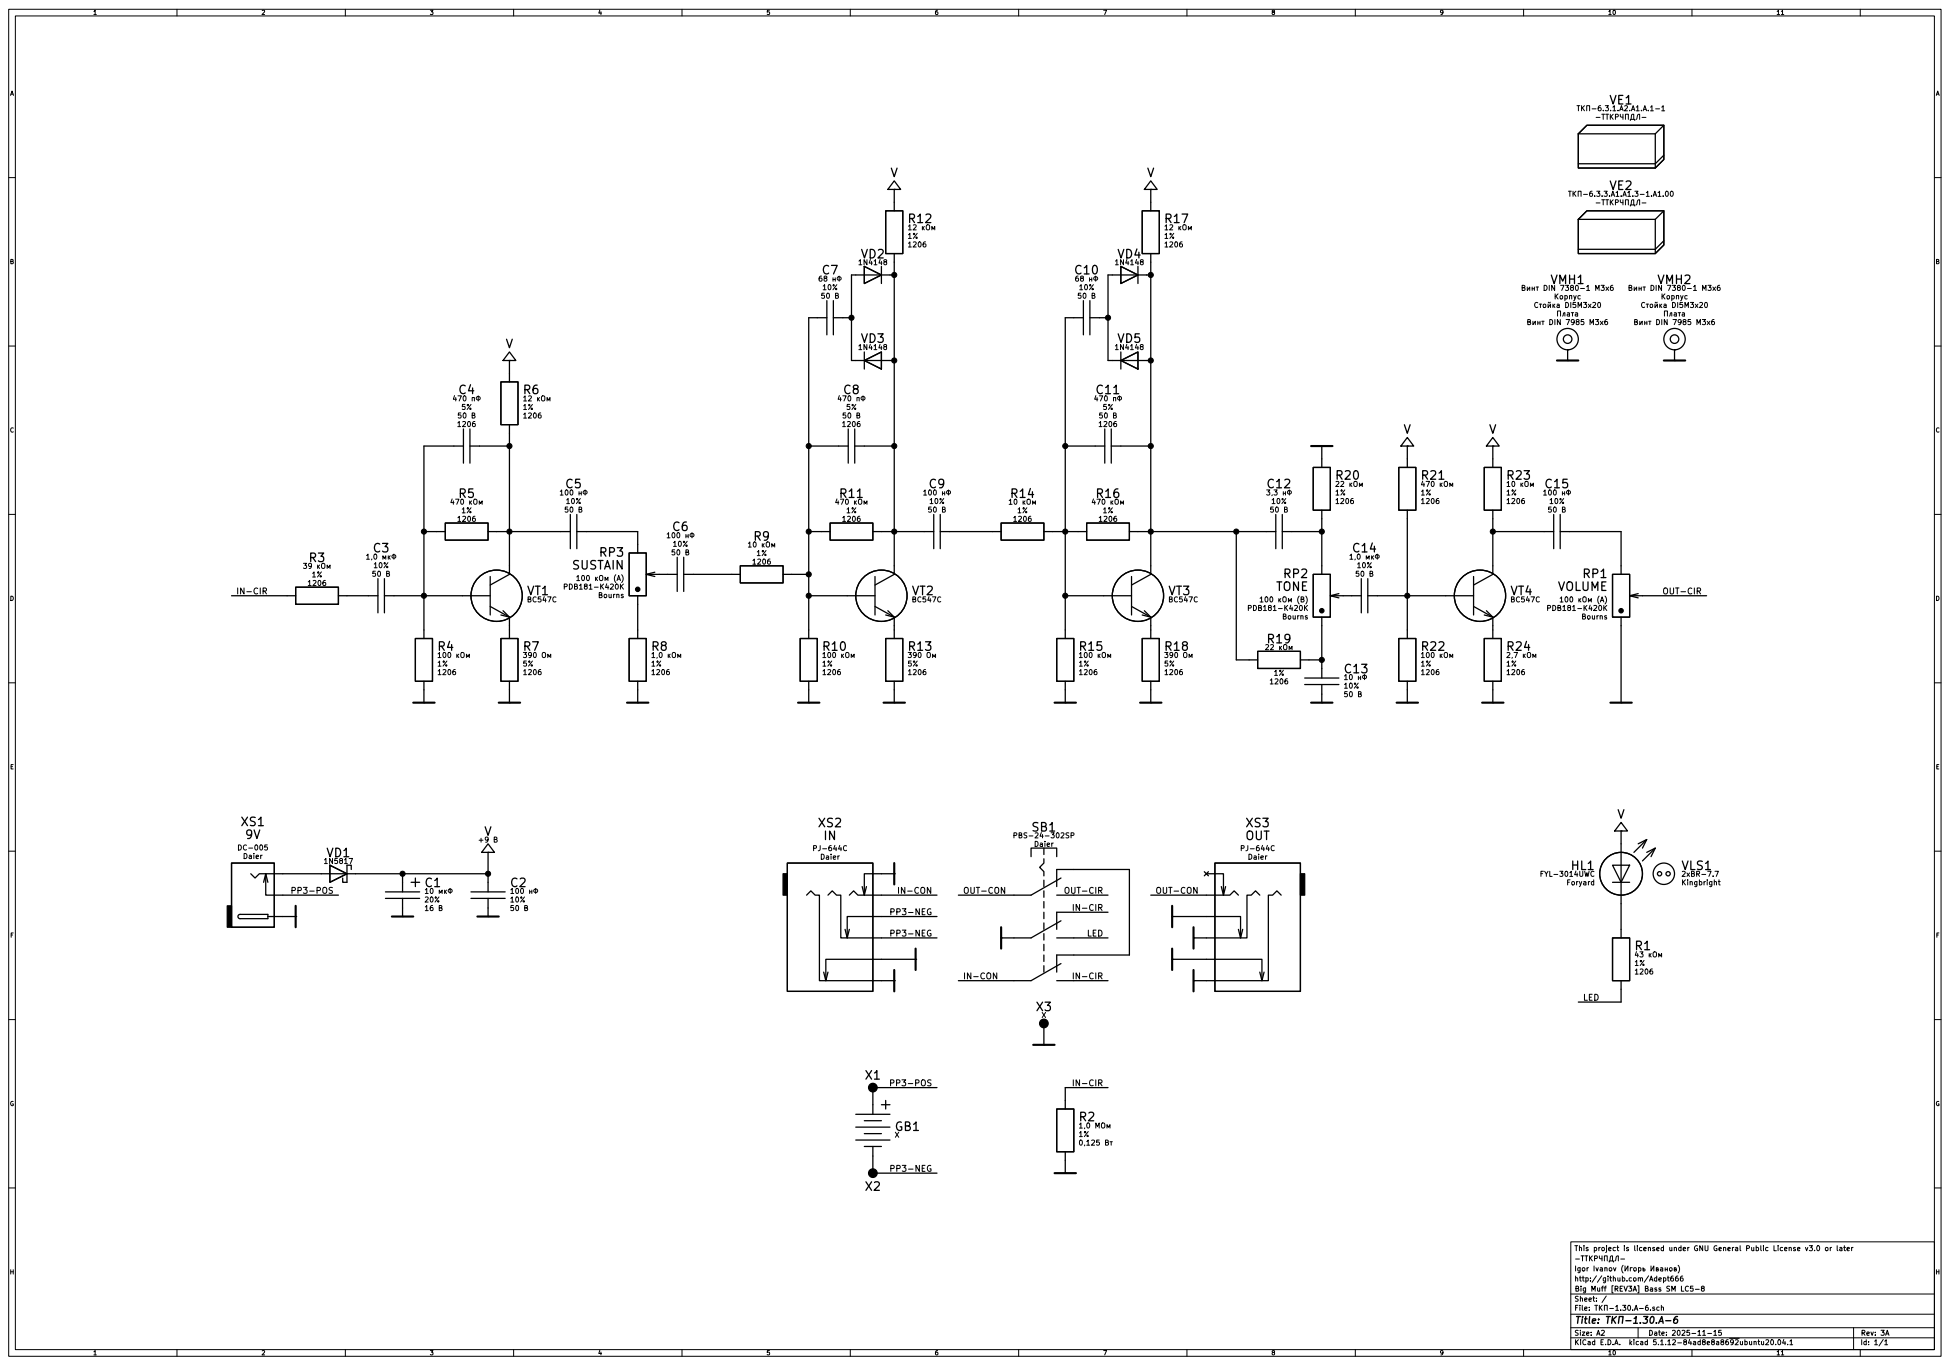
[picture p117: page 1]

--This project is licensed under GNU General Public License v3.0 or later

Igor Ivanov ( )
http://github.com/Adept666
File: -1.30.A-6.sch Sheet: / Big Muff [REV3A] Bass SM LC5-8
