Adept666/stompboxes/PCBS-PCAS/ТКП-3.30.A/ТКП-1.30.A-5/output/ТКП-1.30.A-5-SCH.pdf

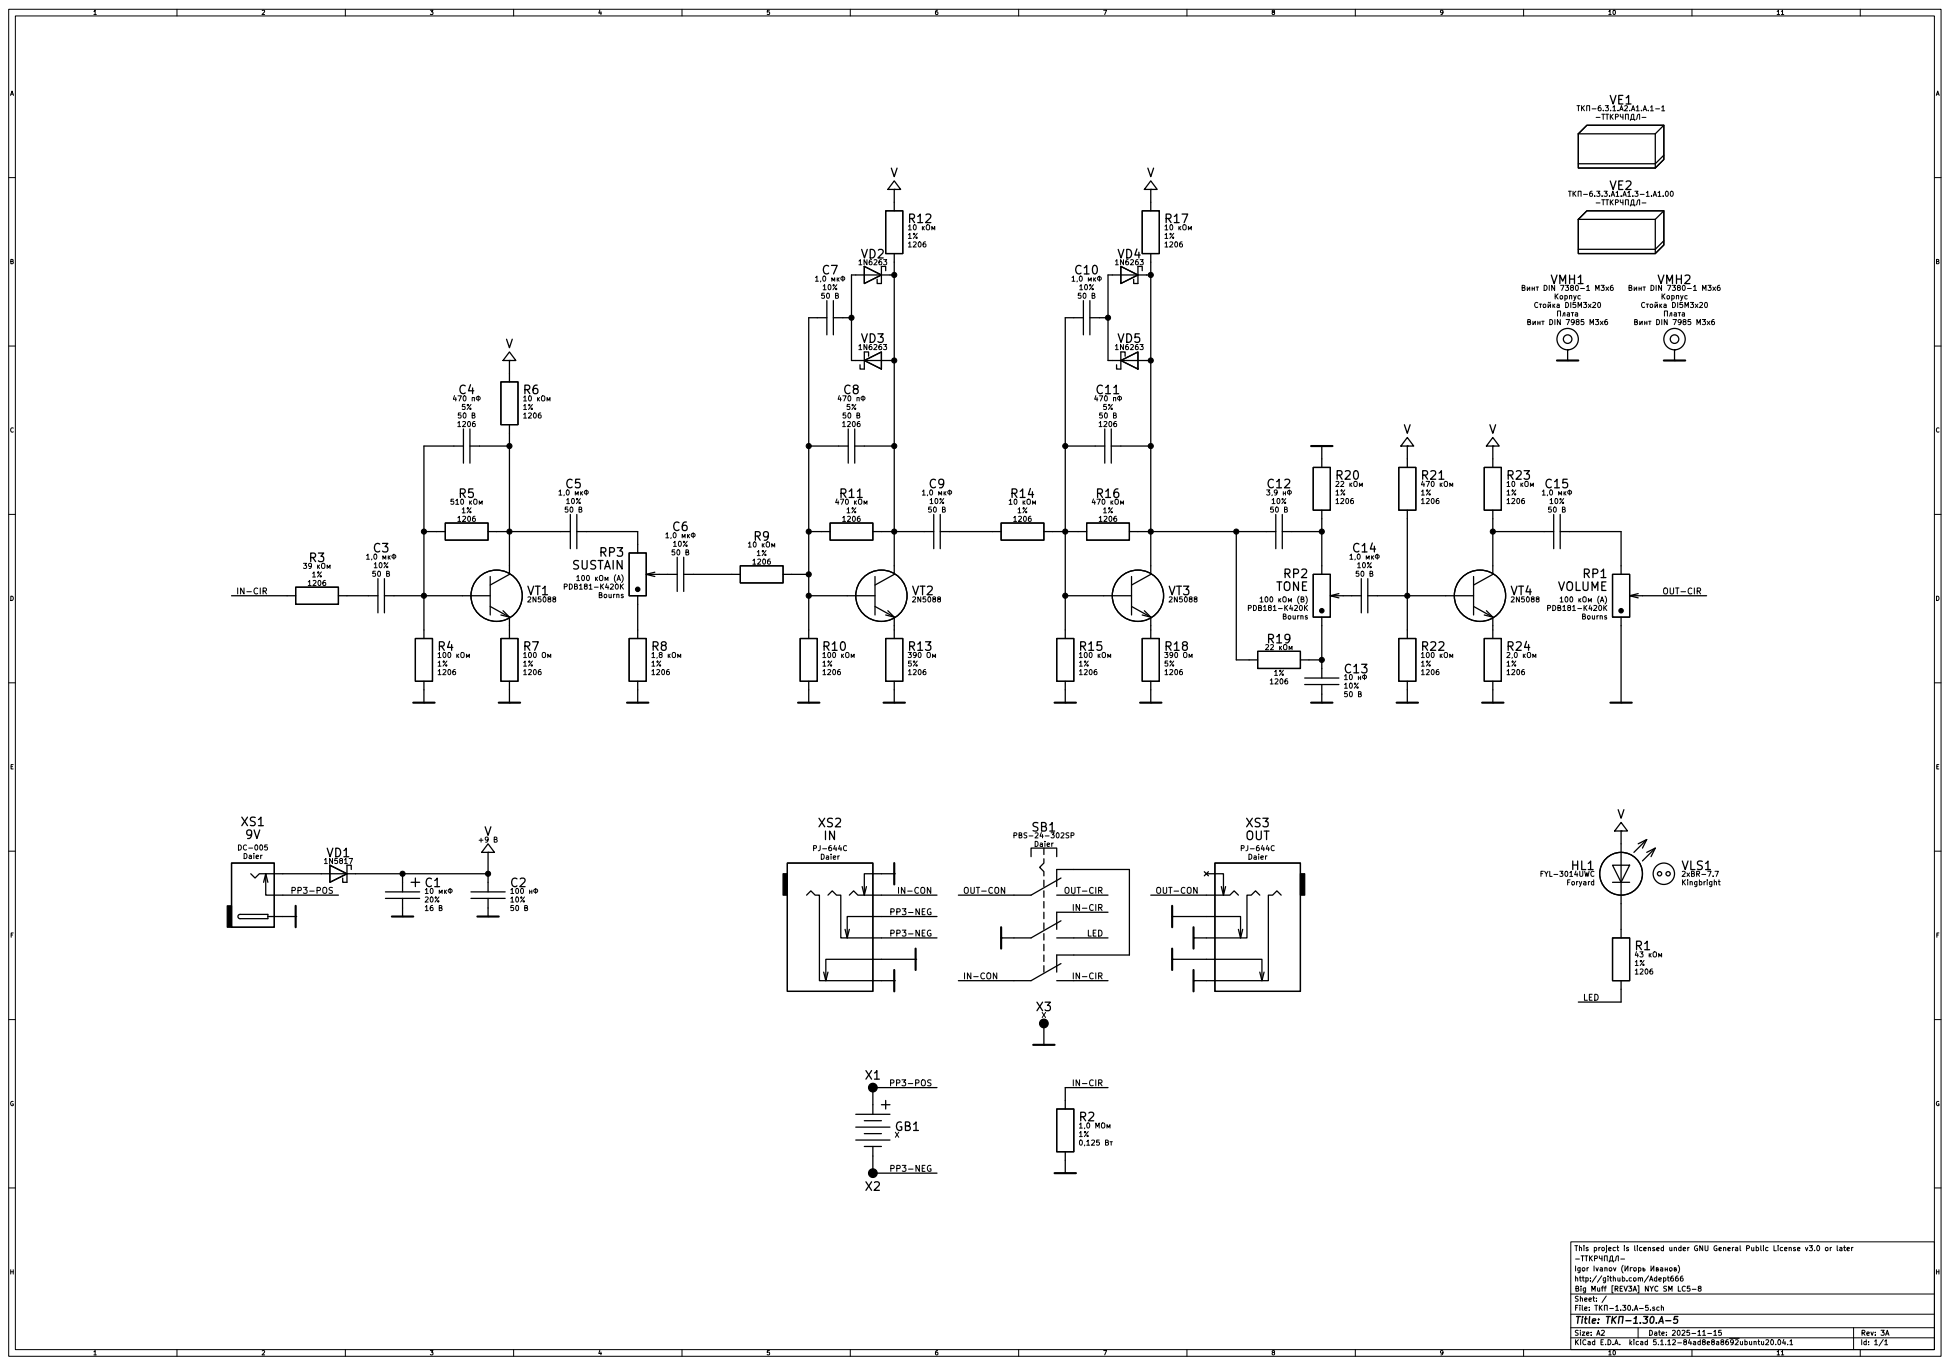
[picture p118: page 1]

--This project is licensed under GNU General Public License v3.0 or later

Igor Ivanov ( )
http://github.com/Adept666
File: -1.30.A-5.sch Sheet: / Big Muff [REV3A] NYC SM LC5-8
