Adept666/stompboxes/PCBS-PCAS/ТКП-3.44.A/ТКП-1.40.A-1/ТКП-1.40.A-1.kicad_pcb

## KiCad design PCBS-PCAS/ТКП-3.44.A/ТКП-1.40.A-1/ТКП-1.40.A-1.kicad_pcb (2026-10-19)

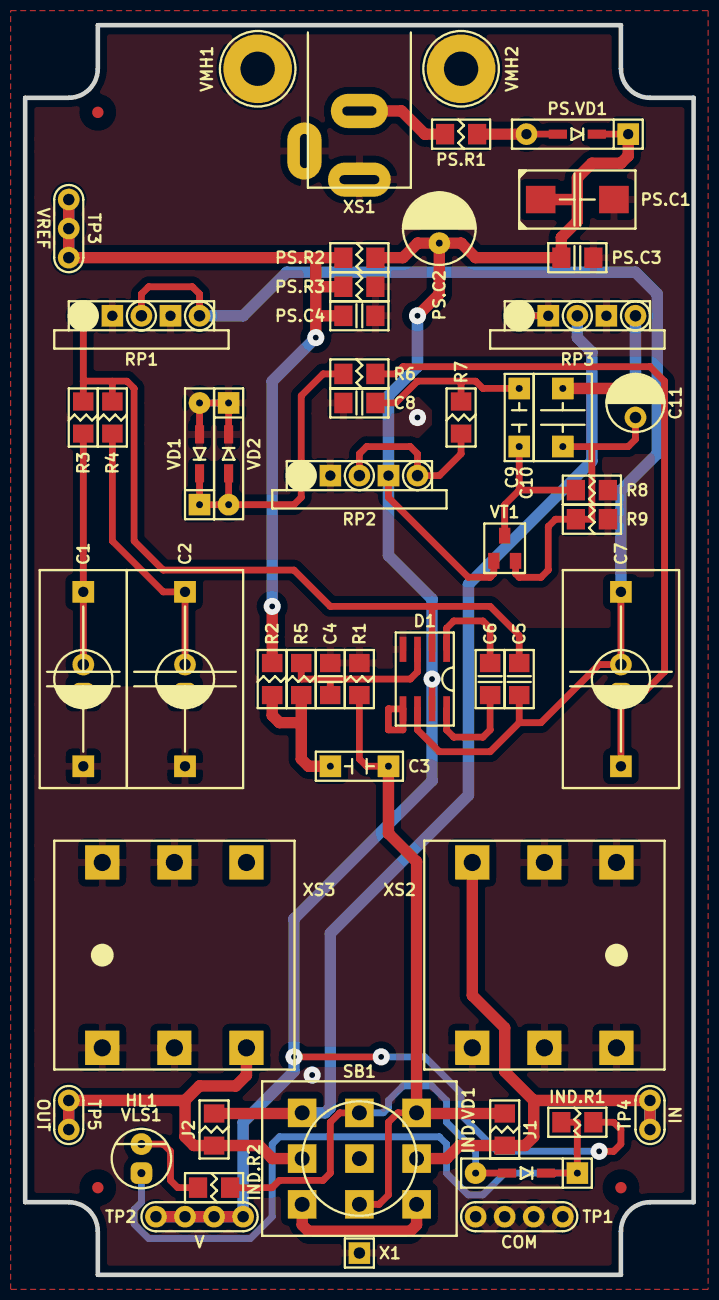
[picture p121: board ТКП-1.40.A-1.kicad_pcb from above]

Board: 2 copper layers, 58.4 x 109.2 mm, 57 parts (0 on the bottom side), 28 nets.

Parts:
C1: 225; C-RECT-L18.0-W07.0-P15.24-d0.8-OR-CP-RADIAL-D05.0-P02.0-CLS
C2, C7: 475; C-RECT-L18.0-W09.0-P15.24-d0.8-OR-CP-RADIAL-D05.0-P02.0-CLS
C3, C9: 223; C-RECT-L07.3-W02.5-P05.08-d0.5
C4: 102; C-SM-1206
C5: 101; C-SM-1206
C6: X; C-SM-1206
C8: 332; C-SM-1206
C10: X; C-RECT-L07.3-W04.5-P05.08-d0.5
C11: 105; CP-RADIAL-D05.0-P02.0-CLS
D1: 07; P-SO-08
HL1: FYL-5013UWC; LED-ROUND-05.0-UNI-SH-SPACER
IND.R1: 182; R-SM-1206
IND.R2: 682; R-SM-1206
IND.VD1: 5235; P-SOD-123-OR-DO-35-V2
J1, J2: X; R-SM-1206
PS.C1: X; CP-CTSMD-D
PS.C2: 107; CP-RADIAL-D06.3-P02.5-d0.5-CLS
PS.C3: 104; C-SM-1206
PS.C4: 105; C-SM-1206
PS.R1: 470; R-SM-1206
PS.R2, PS.R3: 104; R-SM-1206
PS.VD1: 0540; P-SOD-123-OR-DO-41
R1, R2, R8: 105; R-SM-1206
R3: 470; R-SM-1206
R4: 561; R-SM-1206
R5, R6: 102; R-SM-1206
R7: 152; R-SM-1206
R9: 103; R-SM-1206
RP1, RP2, RP3: A100K; RPB-18-1x17-1.6
SB1: PBS-24-302SP; SW-PBS-24-302SP-2.5
TP1: COM; TP-4-1.0-1.9
TP2: V; TP-4-1.0-1.9
TP3: VREF; TP-3-1.0-1.9
TP4: IN; TP-2-1.0-1.9
TP5: OUT; TP-2-1.0-1.9
VD1, VD2: 4148; P-SOD-123-OR-DO-35-V2
VFM1, VFM2, VFM3: 1.0; VFM-1.0-3.0-SL
VLS1: BR-12.7; VLS-BR-P
VMH1, VMH2: X; VMH-STA-DA5
VT1: 5457; P-SOT-23-D-S-G
X1: X; CON-PAD-S-1.0-1.9
XS1: DC-005; CON-DC-005-9V-OVAL
XS2, XS3: PJ-644C; CON-PJ-644C-IN-OR-OUT

Connections:
/CIR-IN: C3.1, J1.2, R1.2, SB1.NC2, SB1.NO3
/CIR-OUT: J2.1, RP3.2, SB1.NO1
/IN: J1.1, SB1.COM3, TP4.1, XS2.T
/LED: IND.R2.1, IND.VD1.A, SB1.NO2
/OUT: J2.2, SB1.COM1, TP5.1, XS3.T
COM: C1.-, C2.-, C4.2, C8.2, D1.4, PS.C1.-, PS.C2.-, PS.C3.2, PS.C4.2, PS.R3.1, R1.1, R8.1, R9.1, RP1.NC1, RP1.NC2, RP2.NC1, RP3.1, RP3.NC1, RP3.NC2, SB1.COM2, TP1.1, VD1.A, VD2.C, VMH1.0, VMH2.0, X1.1, XS1.C, XS1.SN, XS2.R, XS2.RN, XS2.S, XS2.SN, XS2.TN, XS3.R, XS3.RN, XS3.S, XS3.SN
unnamed: C1.+, R3.1
unnamed: C2.+, R4.1
unnamed: C3.2, R2.2, R5.1
unnamed: C4.1, D1.3, R5.2
unnamed: C5.1, D1.2, R3.2, R4.2, RP1.1
unnamed: C5.2, C7.+, D1.6, RP1.2, RP1.3
unnamed: C6.1, D1.1
unnamed: C6.2, D1.8
unnamed: C7.-, R6.1
unnamed: C8.1, C9.1, R7.2
unnamed: C9.2, R8.2, VT1.G
unnamed: C10.1, C11.+, R9.2, VT1.S
unnamed: C10.2, C11.-, RP3.3
unnamed: HL1.A, IND.R1.2, IND.VD1.C
unnamed: HL1.C, IND.R2.2
unnamed: PS.R1.1, XS1.S
unnamed: PS.R1.2, PS.VD1.A
unnamed: R6.2, RP2.1, VD1.C, VD2.A
unnamed: R7.1, RP2.2, RP2.3
unnamed: SB1.NC1, SB1.NC3
V: D1.7, IND.R1.1, PS.C1.+, PS.C2.+, PS.C3.1, PS.R2.2, PS.VD1.C, RP2.NC2, TP2.1, VT1.D
VREF: PS.C4.1, PS.R2.1, PS.R3.2, R2.1, TP3.1
