Adept666/stompboxes/PCBS-PCAS/ТКП-3.45.A/ТКП-1.41.A-1/ТКП-1.41.A-1.kicad_pcb

## KiCad design PCBS-PCAS/ТКП-3.45.A/ТКП-1.41.A-1/ТКП-1.41.A-1.kicad_pcb (2026-08-31)

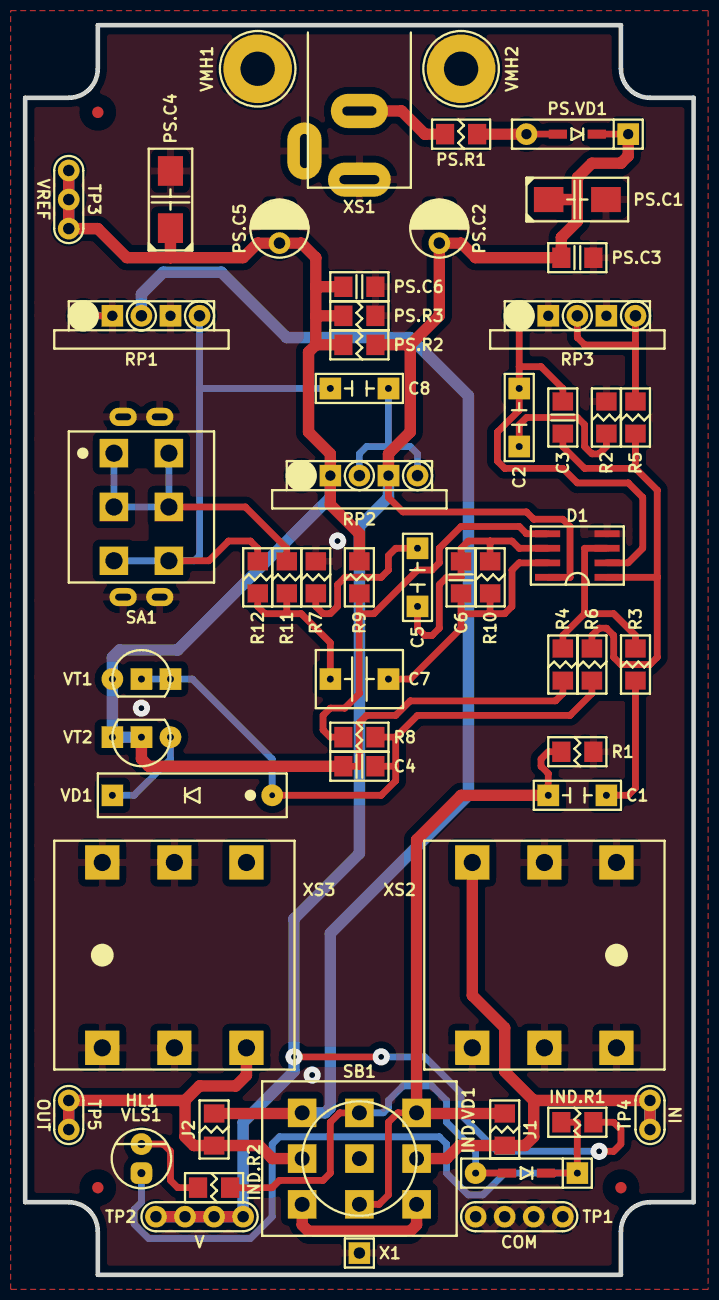
[picture p122: board ТКП-1.41.A-1.kicad_pcb from above]

Board: 2 copper layers, 58.4 x 109.2 mm, 60 parts (0 on the bottom side), 29 nets.

Parts:
C1: 223; C-RECT-L07.3-W02.5-P05.08-d0.5
C2, C5, C8: 104; C-RECT-L07.3-W02.5-P05.08-d0.5
C3, C6: 221; C-SM-1206
C4: 102; C-SM-1206
C7: 105; C-RECT-L07.3-W04.5-P05.08-d0.5
D1: 082; P-SO-08
HL1: FYL-5013UWC; LED-ROUND-05.0-UNI-SH-SPACER
IND.R1: 182; R-SM-1206
IND.R2: 682; R-SM-1206
IND.VD1: 5235; P-SOD-123-OR-DO-35-V2
J1, J2: X; R-SM-1206
PS.C1: 106 35V; CP-CTSMD-C
PS.C2: 106 35V; CP-RADIAL-D05.0-P02.0-CLS
PS.C3, PS.C6: 104; C-SM-1206
PS.C4: 106 20V; CP-CTSMD-C
PS.C5: 106 25V; CP-RADIAL-D05.0-P02.0-CLS
PS.R1: 330; R-SM-1206
PS.R2, PS.R3: 103; R-SM-1206
PS.VD1: 0540; P-SOD-123-OR-DO-41
R1: 105; R-SM-1206
R2: 222; R-SM-1206
R3, R6, R8: 103; R-SM-1206
R4: 474; R-SM-1206
R5: 183; R-SM-1206
R7: 393; R-SM-1206
R9: 224; R-SM-1206
R10: 154; R-SM-1206
R11: 223; R-SM-1206
R12: 333; R-SM-1206
RP1: B100K; RPB-18-1x17-1.6
RP2: A25K; RPB-18-1x17-1.6
RP3: A500K; RPB-18-1x17-1.6
SA1: MTS-202-A2T; SW-MTS-202-A2T-2.5
SB1: PBS-24-302SP; SW-PBS-24-302SP-2.5
TP1: COM; TP-4-1.0-1.9
TP2: V; TP-4-1.0-1.9
TP3: VREF; TP-3-1.0-1.9
TP4: IN; TP-2-1.0-1.9
TP5: OUT; TP-2-1.0-1.9
VD1: Д9Б; P-Д-9
VFM1, VFM2, VFM3: 1.0; VFM-1.0-3.0-SL
VLS1: BR-12.7; VLS-BR-P
VMH1, VMH2: X; VMH-STA-DA5
VT1, VT2: 7000; P-TO-92-S-G-D
X1: COM; CON-PAD-S-1.0-1.9
XS1: DC-005; CON-DC-005-9V-OVAL
XS2, XS3: PJ-644C; CON-PJ-644C-IN-OR-OUT

Connections:
/CIR-IN: C1.1, J1.2, R1.2, SB1.NC2, SB1.NO3
/CIR-OUT: J2.1, RP1.2, SB1.NO1
/IN: J1.1, SB1.COM3, TP4.1, XS2.T
/LED: IND.R2.1, IND.VD1.A, SB1.NO2
/OUT: J2.2, SB1.COM1, TP5.1, XS3.T
COM: D1.4, PS.C1.-, PS.C2.-, PS.C3.2, PS.C4.-, PS.C5.-, PS.C6.2, PS.R3.1, R1.1, R2.1, R7.1, RP1.1, RP1.NC1, RP1.NC2, RP2.1, RP3.NC1, RP3.NC2, SA1.0, SB1.COM2, TP1.1, VMH1.0, VMH2.0, X1.1, XS1.C, XS1.SN, XS2.R, XS2.RN, XS2.S, XS2.SN, XS2.TN, XS3.R, XS3.RN, XS3.S, XS3.SN
unnamed: C1.2, R3.1
unnamed: C2.1, R2.2
unnamed: C2.2, C3.1, D1.2, RP3.1
unnamed: C3.2, D1.1, R5.1, R6.1
unnamed: C4.1, R6.2, R8.1, VD1.A, VT1.D, VT1.G
unnamed: C5.1, R7.2
unnamed: C5.2, C6.1, D1.6, R10.1
unnamed: C6.2, C7.1, D1.7, R10.2
unnamed: C7.2, R11.1, R12.1
unnamed: C8.1, R12.2, RP1.3, SA1.NO1, SA1.NO2
unnamed: C8.2, RP2.2, RP2.3
unnamed: D1.3, R3.2, R4.2
unnamed: D1.5, R8.2, R9.2
unnamed: HL1.A, IND.R1.2, IND.VD1.C
unnamed: HL1.C, IND.R2.2
unnamed: PS.R1.1, XS1.S
unnamed: PS.R1.2, PS.VD1.A
unnamed: R5.2, RP3.2, RP3.3
unnamed: R11.2, SA1.COM1, SA1.COM2, SA1.NC1, SA1.NC2
unnamed: SB1.NC1, SB1.NC3
unnamed: VD1.C, VT2.S
V: D1.8, IND.R1.1, PS.C1.+, PS.C2.+, PS.C3.1, PS.R2.2, PS.VD1.C, RP2.NC2, TP2.1
VREF: C4.2, PS.C4.+, PS.C5.+, PS.C6.1, PS.R2.1, PS.R3.2, R4.1, R9.1, RP2.NC1, TP3.1, VT1.S, VT2.D, VT2.G
