Adept666/stompboxes/PCBS-PCAS/ТКП-3.38.A/ТКП-1.36.A-5/ТКП-1.36.A-5.kicad_pcb

## KiCad design PCBS-PCAS/ТКП-3.38.A/ТКП-1.36.A-5/ТКП-1.36.A-5.kicad_pcb (2026-05-27)

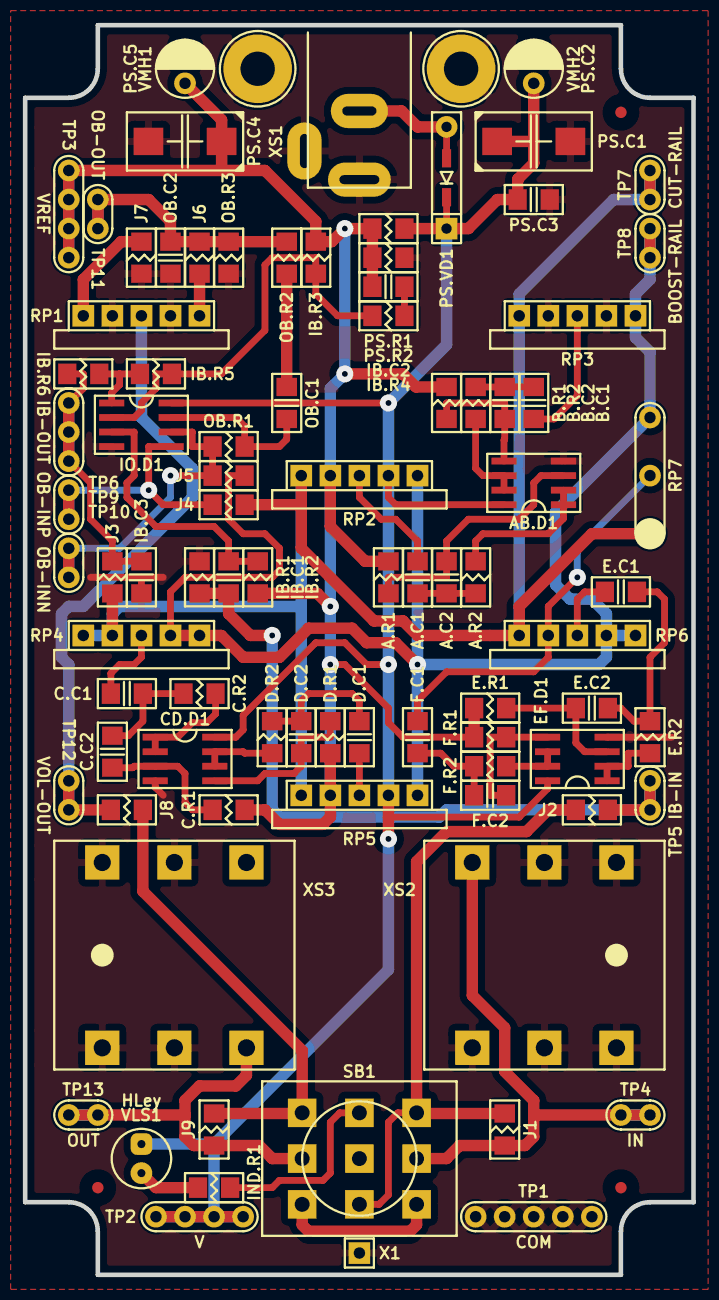
[picture p123: board ТКП-1.36.A-5.kicad_pcb from above]

Board: 2 copper layers, 58.4 x 109.2 mm, 94 parts (0 on the bottom side), 51 nets.

Parts:
A.C1: 225; C-SM-1206
A.C2: 473; C-SM-1206
A.R1: 124; R-SM-1206
A.R2: 471; R-SM-1206
AB.D1: 4558; P-SO-08
B.C1: 105; C-SM-1206
B.C2: 333; C-SM-1206
B.R1: 104; R-SM-1206
B.R2: 471; R-SM-1206
C.C1: 154; C-SM-1206
C.C2: 682; C-SM-1206
C.R1: 104; R-SM-1206
C.R2: 102; R-SM-1206
CD.D1: 4558; P-SO-08
D.C1: 683; C-SM-1206
D.C2: 332; C-SM-1206
D.R1: 104; R-SM-1206
D.R2: 102; R-SM-1206
E.C1: 223; C-SM-1206
E.C2: 681; C-SM-1206
E.R1: 104; R-SM-1206
E.R2: 102; R-SM-1206
EF.D1: 4558; P-SO-08
F.C1, F.C2: X; C-SM-1206
F.R1, F.R2: X; R-SM-1206
HLeу: FYL-3014UWC; LED-ROUND-05.0-UNI-SH-SPACER-PNL-5.3
IB.C1, IB.C2: 103; C-SM-1206
IB.C3: 151; C-SM-1206
IB.R1: 225; R-SM-1206
IB.R2: 474; R-SM-1206
IB.R3, IB.R5, IB.R6: 103; R-SM-1206
IB.R4: 102; R-SM-1206
IND.R1: 433; R-SM-1206
IO.D1: 4558; P-SO-08
J1, J9: X; R-SM-1206
J2, J3, J4, J5, J6, J7, J8: 0; R-SM-1206
OB.C1: 105; C-SM-1206
OB.C2: 103; C-SM-1206
OB.R1, OB.R2, OB.R3: 103; R-SM-1206
PS.C1: 107; CP-CTSMD-D
PS.C2: 107; CP-RADIAL-D05.0-P02.0-CLS
PS.C3: 104; C-SM-1206
PS.C4: 476; CP-CTSMD-D
PS.C5: 476; CP-RADIAL-D05.0-P02.0-CLS
PS.R1, PS.R2: 473; R-SM-1206
PS.VD1: 0520; P-SOD-123-OR-DO-41
RP1, RP2, RP3, RP4, RP5, RP6: B50K; RPB-18-1x17-1.6-PNL-7.2
RP7: X; RP-EXTERNAL
SB1: PBS-24-302SP; SW-PBS-24-302SP-2.5-PNL-12.0
TP1: COM; TP-5-1.0-1.9
TP2: V; TP-4-1.0-1.9
TP3: VREF; TP-4-1.0-1.9
TP4: IN; TP-2-1.0-1.9
TP5: IB-IN; TP-2-1.0-1.9
TP6: IB-OUT; TP-3-1.0-1.9
TP7: CUT-RAIL; TP-2-1.0-1.9
TP8: BOOST-RAIL; TP-2-1.0-1.9
TP9: OB-INP; TP-2-1.0-1.9
TP10: OB-INN; TP-2-1.0-1.9
TP11: OB-OUT; TP-2-1.0-1.9
TP12: VOL-OUT; TP-2-1.0-1.9
TP13: OUT; TP-2-1.0-1.9
VE1: ТКП-6.3.1.A1.B1.A.1-1; ТКП-6.3.1.A1.B1.A
VE2: ТКП-6.3.3.A2.B1.3-1.B1.D1; ТКП-6.3.3.A2
VFM1, VFM2, VFM3: 1.0; VFM-1.0-3.0-SL
VLS1: 2xBR-7.7; VLS-BR
VMH1, VMH2: DI5M3x20; VMH-STA-DA5-PNL-3.0
X1: X; CON-PAD-S-1.0-1.9
XS1: DC-005; CON-DC-005-9V-OVAL
XS2, XS3: PJ-644C; CON-PJ-644C-IN-OR-OUT

Connections:
/BOOST-RAIL: J5.1, RP2.3, RP3.3, RP4.3, RP4.NC2, RP5.3, RP6.3, RP6.NC2, RP7.3, TP8.1
/CIR-IN: J1.2, J2.1, SB1.NC2, SB1.NO3
/CIR-OUT: J8.2, J9.1, SB1.NO1
/CUT-RAIL: J3.2, J4.1, RP2.1, RP3.1, RP4.1, RP4.NC1, RP5.1, RP6.1, RP7.1, TP7.1
/IB-IN: IB.C1.1, IB.R1.2, J2.2, TP5.1
/IB-OUT: IB.C3.1, IB.R6.2, J3.1, TP6.1
/IN: J1.1, SB1.COM3, TP4.1, XS2.T
/LED: IND.R1.1, SB1.NO2
/OB-INN: IO.D1.6, J5.2, OB.R1.1, TP10.1
/OB-INP: IO.D1.5, J4.2, TP9.1
/OB-OUT: J6.1, OB.C2.1, OB.R2.2, OB.R3.2, TP11.1
/OUT: J9.2, SB1.COM1, TP13.1, XS3.T
/VOL-COM: J7.1, RP1.1
/VOL-IN: J6.2, RP1.3
/VOL-OUT: J8.1, RP1.2, TP12.1
COM: AB.D1.4, CD.D1.4, EF.D1.4, IB.C3.2, IB.R1.1, IO.D1.4, J7.2, OB.C2.2, OB.R3.1, PS.C1.-, PS.C2.-, PS.C3.2, PS.C4.-, PS.C5.-, PS.R2.1, RP1.NC1, RP1.NC2, RP3.NC1, RP3.NC2, SB1.COM2, TP1.1, VMH1.0, VMH2.0, X1.1, XS1.C, XS1.SN, XS2.R, XS2.RN, XS2.S, XS2.SN, XS2.TN, XS3.R, XS3.RN, XS3.S, XS3.SN
unnamed: A.C1.1, RP2.2
unnamed: A.C1.2, A.C2.1, A.R2.1
unnamed: A.C2.2, A.R1.2, AB.D1.3
unnamed: A.R2.2, AB.D1.1, AB.D1.2
unnamed: AB.D1.5, B.C2.2, B.R1.2
unnamed: AB.D1.6, AB.D1.7, B.R2.2
unnamed: B.C1.1, RP3.2
unnamed: B.C1.2, B.C2.1, B.R2.1
unnamed: C.C1.1, RP4.2
unnamed: C.C1.2, C.C2.1, C.R2.1
unnamed: C.C2.2, C.R1.2, CD.D1.3
unnamed: C.R2.2, CD.D1.1, CD.D1.2
unnamed: CD.D1.5, D.C2.2, D.R1.2
unnamed: CD.D1.6, CD.D1.7, D.R2.2
unnamed: D.C1.1, RP5.2
unnamed: D.C1.2, D.C2.1, D.R2.1
unnamed: E.C1.1, RP6.2
unnamed: E.C1.2, E.C2.1, E.R2.1
unnamed: E.C2.2, E.R1.2, EF.D1.3
unnamed: E.R2.2, EF.D1.1, EF.D1.2
unnamed: EF.D1.5, F.C2.2, F.R1.2
unnamed: EF.D1.6, EF.D1.7, F.R2.2
unnamed: F.C1.1, RP6.NC1, RP7.2
unnamed: F.C1.2, F.C2.1, F.R2.1
unnamed: HLeу.C, IND.R1.2
unnamed: IB.C1.2, IB.R2.2, IO.D1.3
unnamed: IB.C2.2, IB.R4.1
unnamed: IB.R3.2, IB.R4.2, IB.R5.1, IO.D1.2
unnamed: IB.R5.2, IB.R6.1, IO.D1.1
unnamed: IO.D1.7, OB.C1.1, OB.R1.2
unnamed: OB.C1.2, OB.R2.1
unnamed: PS.VD1.A, XS1.S
unnamed: SB1.NC1, SB1.NC3
V: AB.D1.8, CD.D1.8, EF.D1.8, HLeу.A, IO.D1.8, PS.C1.+, PS.C2.+, PS.C3.1, PS.R1.2, PS.VD1.C, RP2.NC2, RP5.NC2, TP2.1
VREF: A.R1.1, B.R1.1, C.R1.1, D.R1.1, E.R1.1, F.R1.1, IB.C2.1, IB.R2.1, IB.R3.1, PS.C4.+, PS.C5.+, PS.R1.1, PS.R2.2, RP2.NC1, RP5.NC1, TP3.1
