Adept666/stompboxes/PCBS-PCAS/ТКП-3.31.A/ТКП-1.31.A-9/ТКП-1.31.A-9.kicad_pcb

## KiCad design PCBS-PCAS/ТКП-3.31.A/ТКП-1.31.A-9/ТКП-1.31.A-9.kicad_pcb (2025-11-07)

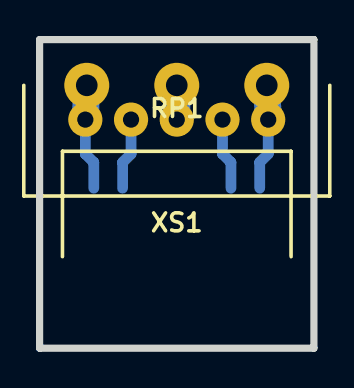
[picture p124: board ТКП-1.31.A-9.kicad_pcb from above]

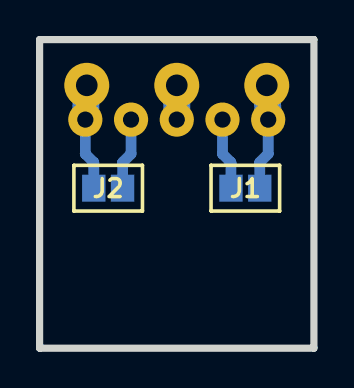
[picture p125: board ТКП-1.31.A-9.kicad_pcb from below]

Board: 2 copper layers, 15.2 x 17.1 mm, 4 parts (2 on the bottom side), 5 nets.

Parts:
J1: J1; J-SB-0805-2
J2: J2; J-SB-0805-2
RP1: B50K; RP-PDB181-K-20-P-CIRCULAR
XS1: PBS-05R; CON-PBS-05R-CIRCULAR

Connections:
unnamed: J1.1, RP1.3, XS1.1
unnamed: J1.2, XS1.2
unnamed: J2.1, XS1.4
unnamed: J2.2, RP1.1, XS1.5
unnamed: RP1.2, XS1.3
