Adept666/stompboxes/PCBS-PCAS/ТКП-3.17.C/ТКП-1.17.C-3/ТКП-1.17.C-3.kicad_pcb

## KiCad design PCBS-PCAS/ТКП-3.17.C/ТКП-1.17.C-3/ТКП-1.17.C-3.kicad_pcb (2025-08-10)

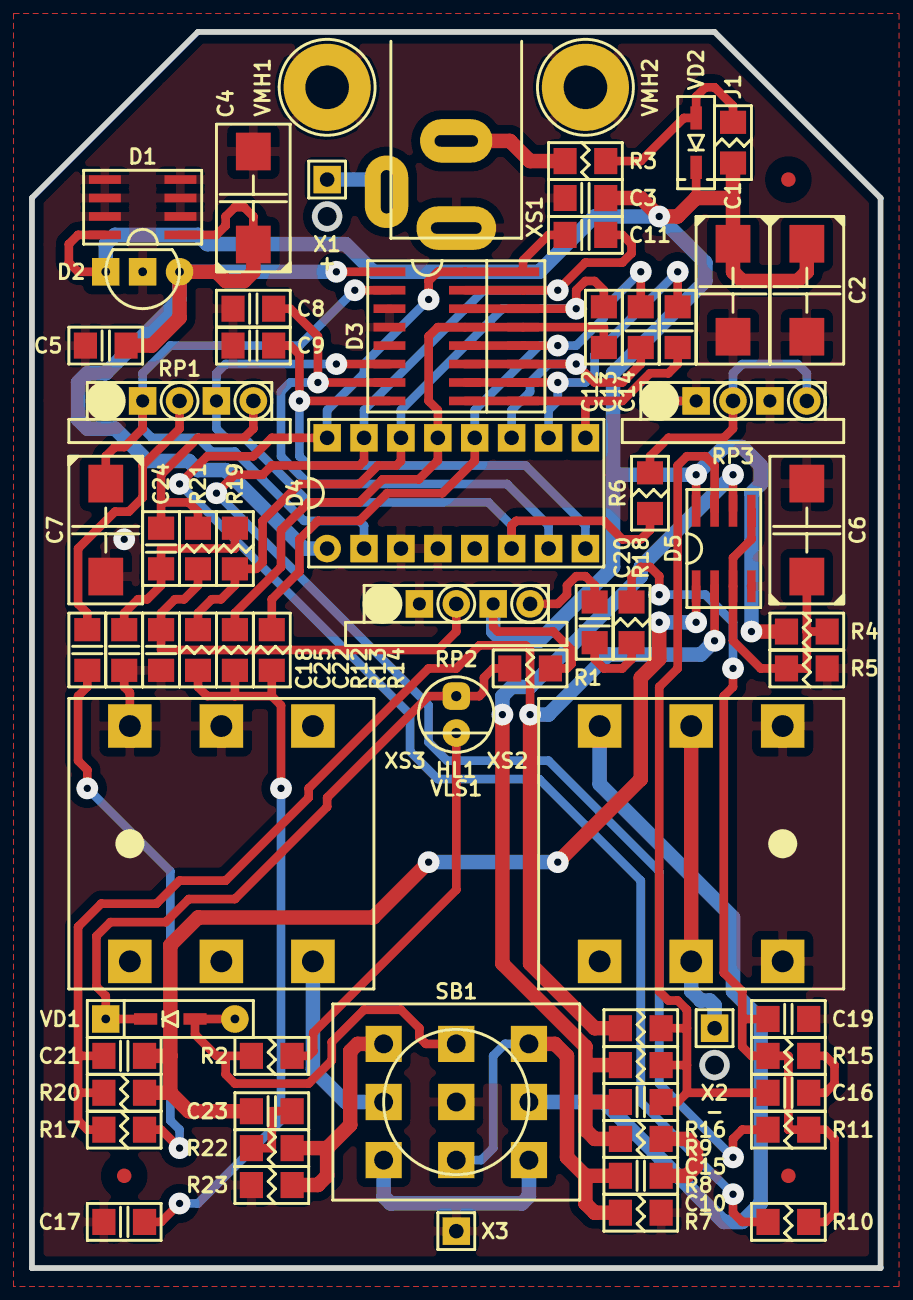
[picture p126: board ТКП-1.17.C-3.kicad_pcb from above]

Board: 2 copper layers, 58.4 x 85.1 mm, 76 parts (0 on the bottom side), 45 nets.

Parts:
C1: 107; CP-CTSMD-D
C2: X; CP-CTSMD-D
C3, C5, C8, C9, C13, C14: 104; C-SM-1206
C4, C6, C7: 476; CP-CTSMD-D
C10, C20: 223; C-SM-1206
C11, C12: 222; C-SM-1206
C15: 470; C-SM-1206
C16, C18, C23, C24: 105; C-SM-1206
C17: 153; C-SM-1206
C19: 472; C-SM-1206
C21: 101; C-SM-1206
C22: 473; C-SM-1206
C25: 103; C-SM-1206
D1: 78L05; P-SO-08-OUT-GND-GND-NC-NC-GND-GND-IN
D2: 78L05; P-TO-92-OUT-GND-IN
D3: 8970; P-SO-16-OR-SO-16W
D4: 8970; P-DIP-16
D5: 5532; P-SO-08
GB1: X; B-PP3-HV
HL1: FYL-3014UWC; LED-ROUND-05.0-UNI-SH-SPACER-PNL-5.3
J1: X; R-SM-1206
R1, R3: 0; R-SM-1206
R2: 433; R-SM-1206
R4, R5, R10, R11, R13, R14, R15: 103; R-SM-1206
R6: 272; R-SM-1206
R7: 105; R-SM-1206
R8: 184; R-SM-1206
R9: 364; R-SM-1206
R12, R17: 203; R-SM-1206
R16: 223; R-SM-1206
R18: 512; R-SM-1206
R19, R22: 102; R-SM-1206
R20: 123; R-SM-1206
R21: 202; R-SM-1206
R23: 104; R-SM-1206
RP1, RP2, RP3: B50K; RPB-18-1x17-1.6-PNL-7.2
SB1: PBS-24-302SP; SW-PBS-24-302SP-2.5-PNL-12.0
VD1: X; P-SOD-123-OR-DO-35-V2
VD2: 0520; P-SOD-123
VE1: ТКП-6.3.1.A2.A1.A.1-1; ТКП-6.3.1.A2.A1.A
VE2: ТКП-6.3.3.A1.A1.3-1.A1.00; ТКП-6.3.3.A1
VFM1, VFM2, VFM3: 1.0; VFM-1.0-3.0-SL
VLS1: 2xBR-7.7; VLS-BR-P
VMH1, VMH2: DI5M3x20; VMH-STA-DA5-PNL-3.0
X1, X2, X3: X; CON-PAD-S-1.0-1.9
XS1: DC-005; CON-DC-005-9V-OVAL
XS2, XS3: PJ-644C; CON-PJ-644C-IN-OR-OUT

Connections:
/2: C7.+, D3.2, D4.2, RP1.NC1
/6: D3.6, D4.6, R6.2, RP1.NC2
/7: C8.2, D3.7, D4.7
/8: C9.2, D3.8, D4.8
/9: C14.2, D3.9, D4.9
/10: C14.1, D3.10, D4.10
/11: C13.2, D3.11, D4.11
/12: C13.1, D3.12, D4.12, R14.1
/13: C12.2, D3.13, D4.13, R13.1
/14: C12.1, D3.14, D4.14, R12.1, R19.1
/15: C11.2, D3.15, D4.15, R11.1
/16: C11.1, D3.16, D4.16, R10.1
/IN-CIR: C10.1, R7.2, SB1.NC2, SB1.NO3
/IN-CON: SB1.COM3, XS2.T
/LED: R2.1, SB1.NO2, VD1.A
/OUT-CIR: R22.2, R23.2, SB1.NO1
/OUT-CON: SB1.COM1, XS3.T
/PP3-NEG: X2.1, XS2.R, XS2.RN
/PP3-POS: X1.1, XS1.SN
COM: C1.-, C2.-, C3.2, C4.-, C5.2, C6.-, C7.-, C8.1, C9.1, C17.2, C19.2, C22.2, C25.2, D1.GND, D1.NC, D2.GND, D3.3, D3.4, D4.3, D4.4, D5.4, R5.1, R7.1, R23.1, RP1.1, RP2.1, RP2.NC1, RP3.1, RP3.NC1, RP3.NC2, SB1.COM2, VMH1.0, VMH2.0, X3.1, XS1.C, XS2.S, XS2.SN, XS2.TN, XS3.R, XS3.RN, XS3.S, XS3.SN
unnamed: C10.2, R8.1
unnamed: C15.1, D5.6, R8.2, R9.1
unnamed: C15.2, C16.1, D5.7, R9.2, R16.1
unnamed: C16.2, R15.2
unnamed: C17.1, R12.2, R13.2, R14.2
unnamed: C18.1, R17.1
unnamed: C18.2, RP1.2
unnamed: C19.1, R10.2, R11.2, R15.1, R18.2
unnamed: C20.1, R18.1
unnamed: C20.2, RP2.3
unnamed: C21.1, D5.2, R16.2, R17.2, R20.1
unnamed: C21.2, C23.1, D5.1, R20.2
unnamed: C22.1, R21.1, RP2.2
unnamed: C23.2, R22.1
unnamed: C24.1, R21.2, RP1.3
unnamed: C24.2, C25.1, R19.2
unnamed: HL1.A, R1.2, VD1.C
unnamed: HL1.C, R2.2
unnamed: J1.1, R3.2, VD2.A
unnamed: R3.1, XS1.S
unnamed: R6.1, RP3.2, RP3.3
unnamed: SB1.NC1, SB1.NC3
V: C1.+, C2.+, C3.1, D1.IN, D2.IN, D5.8, J1.2, R1.1, R4.2, RP2.NC2, VD2.C
VA: C4.+, C5.1, D1.OUT, D2.OUT, D3.1, D4.1
VREF: C6.+, D5.3, D5.5, R4.1, R5.2
