Adept666/stompboxes/PCBS-PCAS/ТКП-3.40.A/ТКП-1.38.A-2/ТКП-1.38.A-2.kicad_pcb

## KiCad design PCBS-PCAS/ТКП-3.40.A/ТКП-1.38.A-2/ТКП-1.38.A-2.kicad_pcb (2025-08-09)

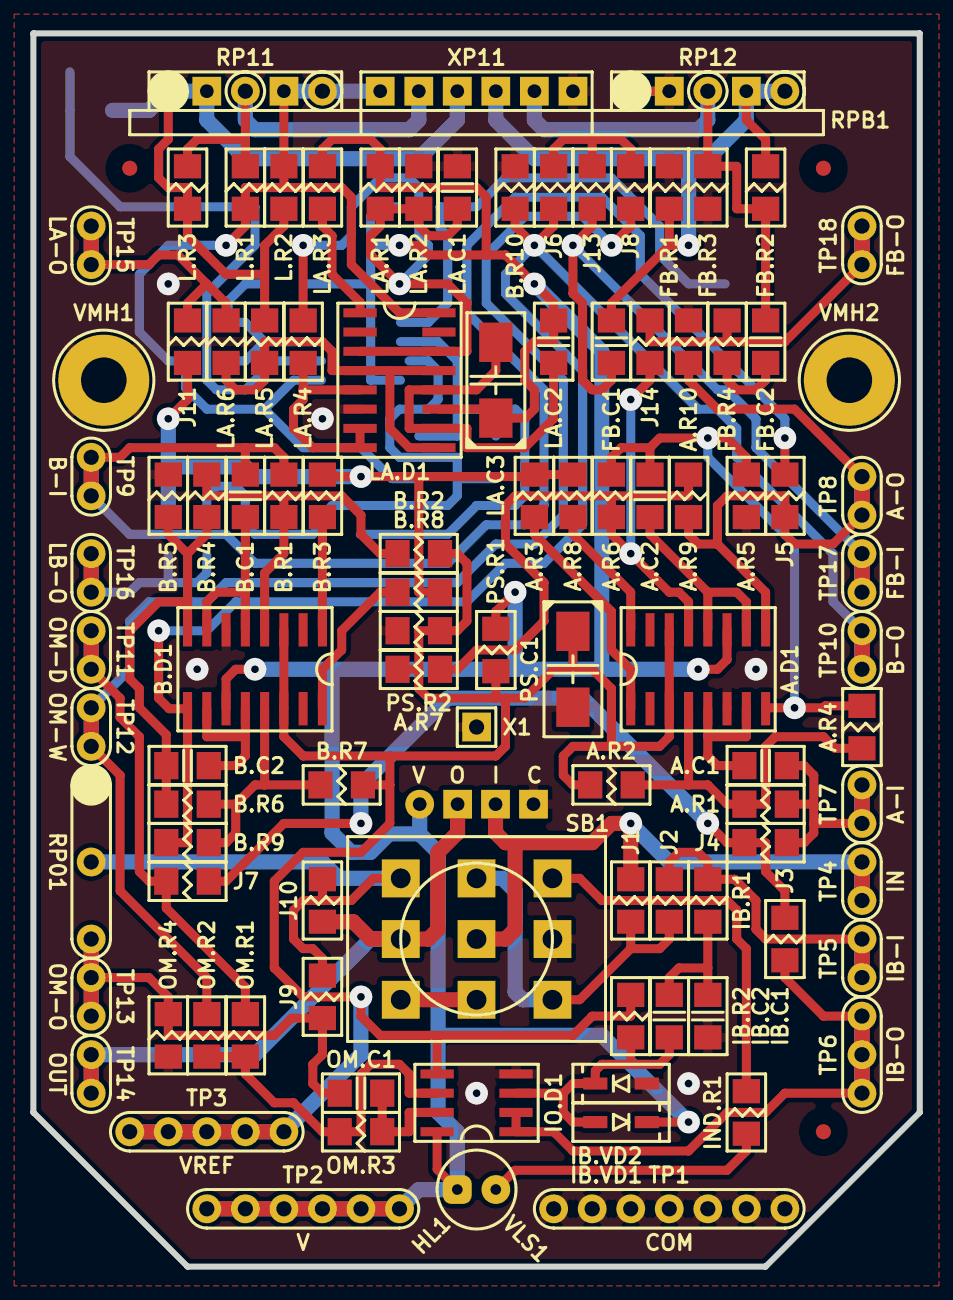
[picture p127: board ТКП-1.38.A-2.kicad_pcb from above]

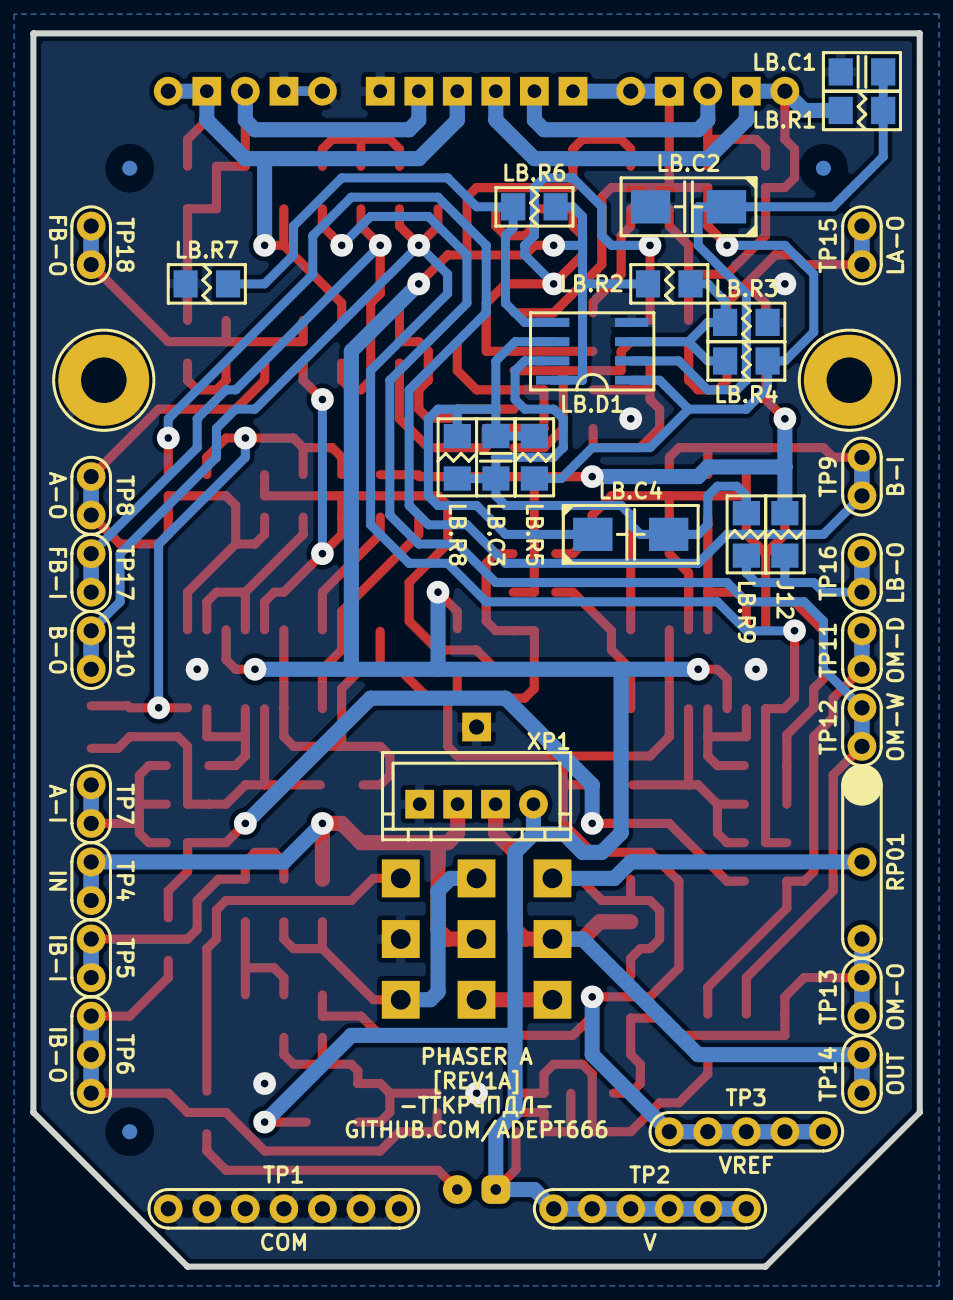
[picture p128: board ТКП-1.38.A-2.kicad_pcb from below]

Board: 2 copper layers, 58.4 x 81.3 mm, 122 parts (16 on the bottom side), 60 nets.

Parts:
A.C1, A.C2: 332; C-SM-1206
A.D1: 13700; P-SO-16
A.R1, A.R4, A.R6, A.R9: 273; R-SM-1206
A.R2, A.R7: 182; R-SM-1206
A.R3, A.R8: 0; R-SM-1206
A.R5, A.R10: 103; R-SM-1206
B.C1, B.C2: 332; C-SM-1206
B.D1: 13700; P-SO-16
B.R1, B.R4, B.R6, B.R9: 273; R-SM-1206
B.R2, B.R7: 182; R-SM-1206
B.R3, B.R8: 0; R-SM-1206
B.R5, B.R10: 103; R-SM-1206
FB.C1, FB.C2: 105; C-SM-1206
FB.R1, FB.R3: X; R-SM-1206
FB.R2, FB.R4: 273; R-SM-1206
HL1: FYL-5013UWC; LED-ROUND-05.0-UNI-SH-SPACER-PNL-6.6
IB.C1: 101; C-SM-1206
IB.C2: 103; C-SM-1206
IB.R1: 102; R-SM-1206
IB.R2: 474; R-SM-1206
IB.VD1, IB.VD2: 4148; P-SOD-123
IND.R1: 103; R-SM-1206
IO.D1: 4558; P-SO-08
J1, J10, J12: X; R-SM-1206
J2, J3, J4, J5, J6, J7, J8, J9, J11, J13, J14: 0; R-SM-1206
L.R1, L.R2: X; R-SM-1206
L.R3: 0; R-SM-1206
LA.C1: 473; C-SM-1206
LA.C2: 335; C-SM-1206
LA.C3: X; CP-CTSMD-C
LA.D1: 13700; P-SO-16
LA.R1, LA.R3: 274; R-SM-1206
LA.R2: 104; R-SM-1206
LA.R4, LA.R6: 103; R-SM-1206
LA.R5: 682; R-SM-1206
LB.C1, LB.C3: X; C-SM-1206
LB.C2, LB.C4: X; CP-CTSMD-C
LB.D1: X; P-SO-08
LB.R1, LB.R2, LB.R3, LB.R4, LB.R5, LB.R6, LB.R7, LB.R8, LB.R9: X; R-SM-1206
OM.C1: 105; C-SM-1206
OM.R1, OM.R2: 273; R-SM-1206
OM.R3: 153; R-SM-1206
OM.R4: 154; R-SM-1206
PS.C1: 106; CP-CTSMD-C
PS.R1, PS.R2: 103; R-SM-1206
RP01: X; RP-EXTERNAL
RPB1: B50K-B50K; RPB-1590N1-18-2x17-OR-2x1x17-1.6-PNL-7.2
SB1: PBS-24-302SP; SW-PBS-24-302SP-2.5-PNL-12.0
TP1: COM; TP-7-1.0-1.9
TP2: V; TP-6-1.0-1.9
TP3: VREF; TP-5-1.0-1.9
TP4: IN; TP-2-1.0-1.9
TP5: IB-I; TP-2-1.0-1.9
TP6: IB-O; TP-3-1.0-1.9
TP7: A-I; TP-2-1.0-1.9
TP8: A-O; TP-2-1.0-1.9
TP9: B-I; TP-2-1.0-1.9
TP10: B-O; TP-2-1.0-1.9
TP11: OM-D; TP-2-1.0-1.9
TP12: OM-W; TP-2-1.0-1.9
TP13: OM-O; TP-2-1.0-1.9
TP14: OUT; TP-2-1.0-1.9
TP15: LA-O; TP-2-1.0-1.9
TP16: LB-O; TP-2-1.0-1.9
TP17: FB-I; TP-2-1.0-1.9
TP18: FB-O; TP-2-1.0-1.9
VE1: ТКП-6.2.1.A1.A1.A.1-1; ТКП-6.2.1.A1.A1.A
VE2: ТКП-6.2.4.A1.B1.4-1.A2.B1; ТКП-6.2.4.A1
VFM1, VFM2, VFM3: 1.0; VFM-1.0-3.0-DL
VLS1: BR-9.52; VLS-BR
VMH1, VMH2: DI5M3x18; VMH-STA-DA5-PNL-3.0
X1: X; CON-PAD-S-1.0-1.9
XB1: 1590N1 Connector Board; XB-1590N1
XP1: B4B-XH-A; CON-XH-B4B-A

Connections:
/A-IN: A.C1.1, A.R1.1, J4.2, TP7.1
/A-OUT: A.D1.9, A.R9.2, A.R10.1, J5.1, TP8.1
/B-IN: B.C1.1, B.R1.1, J5.2, TP9.1
/B-OUT: B.D1.9, B.R9.2, B.R10.1, J6.1, TP10.1
/CIR-IN: J1.2, J2.1, SB1.NC3, SB1.NO2
/CIR-OUT: J9.2, J10.1, RP01.2, SB1.NO1
/DRY: J3.2, J4.1, J7.1
/FB: A.D1.13, A.R6.2, A.R7.1, A.R9.1, J14.2
/FB-IN: FB.C1.1, J13.2, TP17.1
/FB-OUT: FB.R4.2, J14.1, TP18.1
/IB-IN: IB.R1.1, J2.2, TP5.1
/IB-OUT: IO.D1.1, IO.D1.2, J3.1, TP6.1
/IN: J1.1, SB1.COM2, TP4.1, XP1.3
/LED: IND.R1.1, SB1.NO3
/LFO: A.R3.1, A.R8.1, B.R3.1, B.R8.1, J11.2, J12.2
/LFOA-OUT: J11.1, LA.R6.2, TP15.1
/LFOB-OUT: J12.1, LB.R9.2, TP16.1
/OM-INDRY: J7.2, OM.R1.2, TP11.1
/OM-INWET: J8.2, OM.R2.1, TP12.1
/OM-OUT: J9.1, OM.C1.2, OM.R4.2, RP01.3, TP13.1
/OUT: J10.2, SB1.COM1, TP14.1, XP1.2
/RP11-1: L.R2.2, L.R3.2, LA.R5.1, LB.R1.2, RPB1.11, RPB1.NC1
/RP11-2: L.R1.2, L.R3.1, RPB1.12
/RP11-3: L.R1.1, L.R2.1, LA.D1.16, LB.D1.1, LB.R4.2, LB.R5.1, RPB1.13, RPB1.NC2
/WET: J6.2, J8.1, J13.1
COM: A.D1.6, A.R5.2, A.R10.2, B.D1.6, B.R5.2, B.R10.2, FB.R1.1, FB.R3.1, IB.C1.2, IB.VD2.A, IO.D1.4, LA.C1.2, LA.D1.6, LA.R2.1, LB.C1.1, LB.C2.-, LB.D1.4, LB.R3.1, LB.R7.1, OM.R4.1, PS.C1.-, PS.R2.1, RP01.1, RPB1.21, RPB1.NC3, SB1.COM3, TP1.1, VMH1.0, VMH2.0, X1.1, XP1.4
unnamed: A.C1.2, A.D1.5, A.D1.7
unnamed: A.C2.1, A.D1.8, A.R4.2, A.R5.1, A.R6.1
unnamed: A.C2.2, A.D1.10, A.D1.12
unnamed: A.D1.1, A.R3.2
unnamed: A.D1.4, A.R1.2, A.R2.1, A.R4.1
unnamed: A.D1.16, A.R8.2
unnamed: B.C1.2, B.D1.5, B.D1.7
unnamed: B.C2.1, B.D1.8, B.R4.2, B.R5.1, B.R6.1
unnamed: B.C2.2, B.D1.10, B.D1.12
unnamed: B.D1.1, B.R3.2
unnamed: B.D1.4, B.R1.2, B.R2.1, B.R4.1
unnamed: B.D1.13, B.R6.2, B.R7.1, B.R9.1
unnamed: B.D1.16, B.R8.2
unnamed: FB.C1.2, FB.R1.2, FB.R2.2, RPB1.23, RPB1.NC4
unnamed: FB.C2.1, FB.R2.1, FB.R3.2, RPB1.22
unnamed: FB.C2.2, FB.R4.1
unnamed: HL1.C, IND.R1.2
unnamed: IB.C1.1, IB.C2.1, IB.R1.2
unnamed: IB.C2.2, IB.R2.2, IB.VD1.A, IB.VD2.C, IO.D1.3
unnamed: IO.D1.6, OM.R1.1, OM.R2.2, OM.R3.1
unnamed: IO.D1.7, OM.C1.1, OM.R3.2
unnamed: LA.C1.1, LA.D1.3, LA.D1.14, LA.R1.1, LA.R2.2, LA.R4.1
unnamed: LA.C2.2, LA.C3.-, LA.D1.10, LA.D1.12
unnamed: LA.D1.1, LA.R3.1
unnamed: LA.D1.5, LA.D1.7, LA.D1.8, LA.R4.2
unnamed: LA.D1.4, LA.D1.9, LA.D1.13, LA.R5.2, LA.R6.1
unnamed: LB.C1.2, LB.C2.+, LB.D1.2, LB.R1.1
unnamed: LB.C3.1, LB.C4.+, LB.D1.6, LB.R5.2, LB.R8.1
unnamed: LB.C3.2, LB.C4.-, LB.D1.7, LB.R8.2, LB.R9.1
unnamed: LB.D1.3, LB.R2.2, LB.R3.2, LB.R4.1
unnamed: LB.D1.5, LB.R6.1, LB.R7.2
unnamed: SB1.NC1, SB1.NC2
V: A.D1.11, B.D1.11, HL1.A, IB.VD1.C, IO.D1.8, LA.C2.1, LA.C3.+, LA.D1.11, LA.R1.2, LA.R3.2, LB.D1.8, LB.R2.1, LB.R6.2, PS.R1.2, TP2.1, XP1.1
VREF: A.D1.3, A.D1.14, A.R2.2, A.R7.2, B.D1.3, B.D1.14, B.R2.2, B.R7.2, IB.R2.1, IO.D1.5, PS.C1.+, PS.R1.1, PS.R2.2, TP3.1
