Adept666/stompboxes/PCBS-PCAS/ТКП-3.21.A/ТКП-1.21.A-1/ТКП-1.21.A-1.kicad_pcb

## KiCad design PCBS-PCAS/ТКП-3.21.A/ТКП-1.21.A-1/ТКП-1.21.A-1.kicad_pcb (2025-06-24)

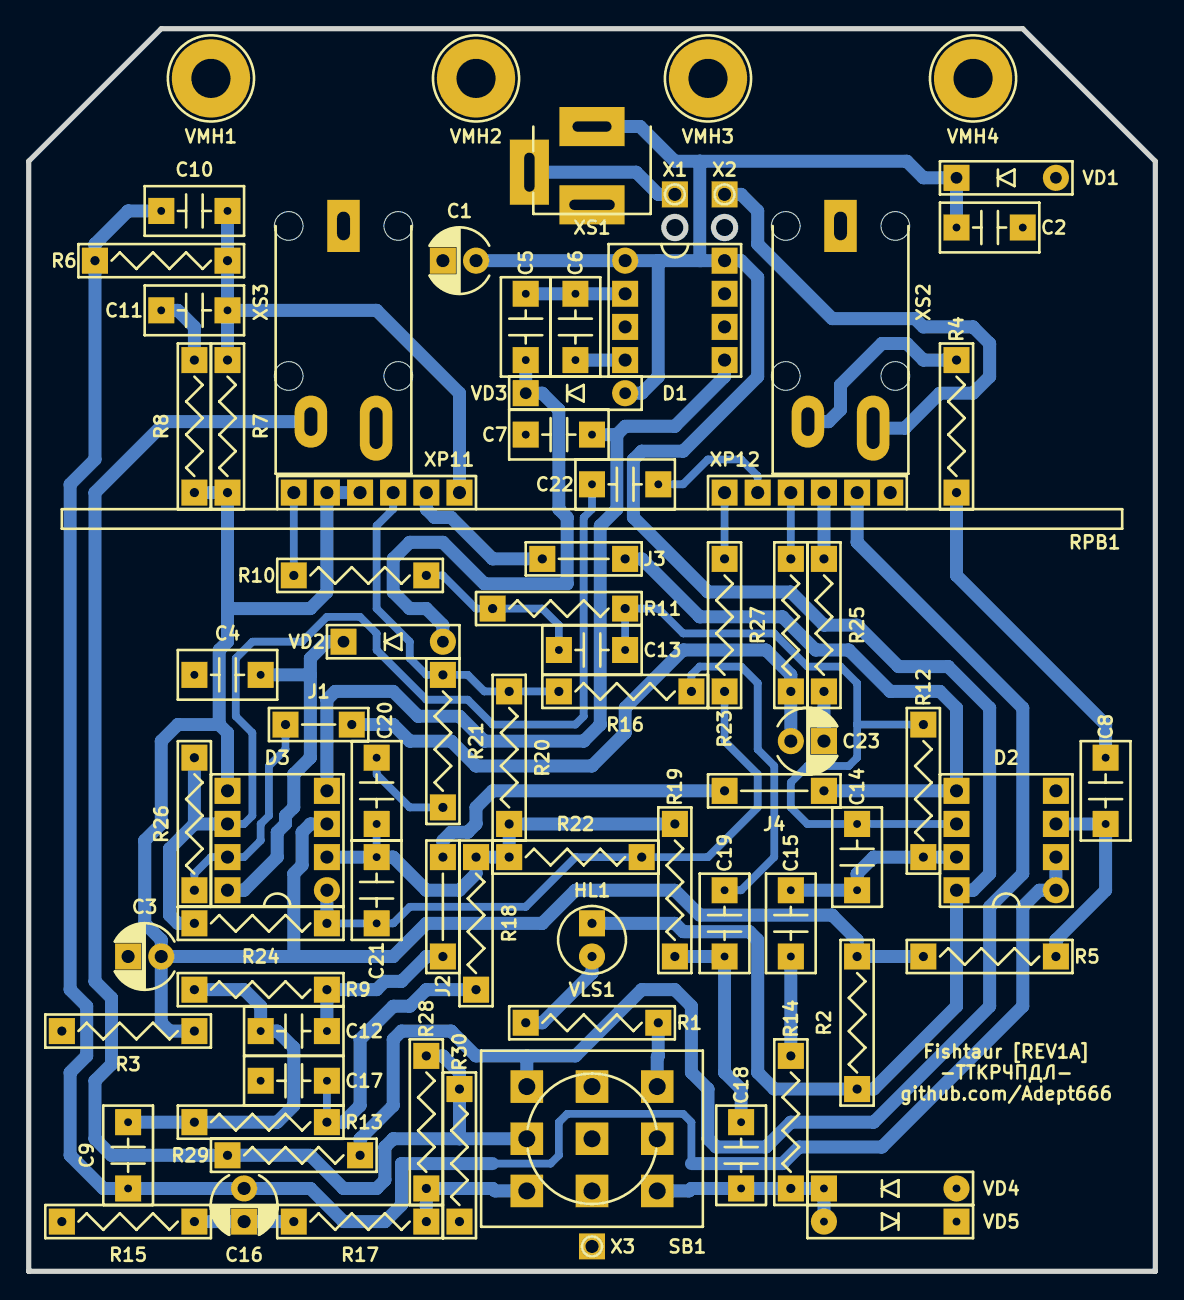
[picture p129: board ТКП-1.21.A-1.kicad_pcb from above]

Board: 2 copper layers, 86.4 x 95.3 mm, 81 parts (0 on the bottom side), 44 nets.

Parts:
C1, C3: 476; CP-RADIAL-D05.0-P02.0-CLS
C2, C8, C9: 104; C-DISK-D04.2-T03.0-P05.08-d0.5
C4, C5, C6, C7, C15, C17, C18: 105; C-DISK-D04.2-T03.0-P05.08-d0.5
C10, C12: 683; C-DISK-D04.2-T03.0-P05.08-d0.5
C11: 334; C-DISK-D04.2-T03.0-P05.08-d0.5
C13: 823; C-DISK-D04.2-T03.0-P05.08-d0.5
C14: 391; C-DISK-D04.2-T03.0-P05.08-d0.5
C16, C23: 475; CP-RADIAL-D05.0-P02.0-CLS
C19: 222; C-DISK-D04.2-T03.0-P05.08-d0.5
C20: 223; C-DISK-D04.2-T03.0-P05.08-d0.5
C21: 821; C-DISK-D04.2-T03.0-P05.08-d0.5
C22: 392; C-DISK-D04.2-T03.0-P05.08-d0.5
D1: 7660S; P-DIP-08
D2, D3: 072; P-DIP-08
GB1: PP3; B-PP3-HV
HL1: FYL-5013UWC; LED-ROUND-05.0-UNI-SH-SPACER-PNL-5.3
J1: 0.6; J-TH-d0.6-P05.08
J2, J4: 0.6; J-TH-d0.6-P07.62
J3: 0.6; J-TH-d0.6-P06.35
R1, R4, R9: 103; R-MFR-25
R2, R3, R20: 273; R-MFR-25
R5: 105; R-MFR-25
R6: 512; R-MFR-25
R7, R13: 152; R-MFR-25
R8, R14: 102; R-MFR-25
R10: 202; R-MFR-25
R11, R18: 153; R-MFR-25
R12: 434; R-MFR-25
R15, R24, R26, R30: 104; R-MFR-25
R16: 223; R-MFR-25
R17, R25: 561; R-MFR-25
R19: 473; R-MFR-25
R21: 123; R-MFR-25
R22: 394; R-MFR-25
R23: 182; R-MFR-25
R27: 472; R-MFR-25
R28, R29: 683; R-MFR-25
RPB1: B100K-B10K-B10K; RPB-1590BB-18-3x17-DUAL-SINGLE-SINGLE-1.5-PNL-7.4-2.8
SB1: PBS-24-302SP; SW-PBS-24-302SP-2.5-PNL-13.0
VD1: 4742A; P-DO-41
VD2, VD3: 4001; P-DO-41
VD4, VD5: Д9Б; P-DO-7
VE1: 1590BB; 1590BB_B1
VLS1: BR-12.7; VLS-BR
VMH1, VMH2, VMH3, VMH4: DI5M3x18; VMH-STA-DA5-PNL-3.0
X1: +; CON-PAD-S-1.0-2.0
X2: -; CON-PAD-S-1.0-2.0
X3: COM; CON-PAD-S-1.0-2.0
XS1: DC-005; CON-DC-005
XS2: ST-008S-04; CON-ST-008X-04-OR-ST-008X-05
XS3: ST-008S-05; CON-ST-008X-04-OR-ST-008X-05

Connections:
/BYPASS: R17.2, R28.1, SB1.NC1
/EFFECT: R29.1, RPB1.32, SB1.NO1
/IN: R4.1, XS2.T
/J1: C23.+, D3.7, J1.J, R26.2, R27.2
/J2: C12.2, D2.5, J2.J, J3.J, J4.J, R9.2, RPB1.11
/LED: R1.1, SB1.NO3
/LED-CIR: C18.1, R14.2, SB1.NC3, VD4.C, VD5.A
/OUT: R28.2, R29.2, R30.2, SB1.COM1, XS3.T
/PP3-NEG: X2.1, XS2.R/TN
/PP3-POS: X1.1, XS1.SN
COM: C1.-, C2.2, C3.-, C4.2, C7.1, C17.2, D1.3, D2.4, R3.1, R15.1, R30.1, RPB1.31, SB1.COM2, SB1.COM3, SB1.NC2, VD1.A, VD4.A, VD5.C, VMH1.0, VMH2.0, VMH3.0, VMH4.0, X3.1, XS1.C, XS2.S, XS3.S
unnamed: C5.1, VD2.A, VD3.C
unnamed: C5.2, C6.1, D1.2
unnamed: C6.2, D1.4
unnamed: C8.1, R4.2
unnamed: C8.2, D2.3, R5.2
unnamed: C9.1, C10.1, C16.+, D2.1, D2.2, R6.2
unnamed: C10.2, C11.1, R6.1, R7.2, RPB1.14
unnamed: C11.2, R8.2
unnamed: C9.2, C12.1, R9.1, R13.1
unnamed: C13.1, R10.1, R11.1
unnamed: C13.2, C14.1, D2.6, R11.2, R12.1
unnamed: C14.2, C15.1, D2.7, R12.2
unnamed: C15.2, R14.1
unnamed: C16.-, R15.2, R17.1
unnamed: C17.1, R13.2, R18.1
unnamed: C18.2, C19.1, R19.1
unnamed: C19.2, R16.2
unnamed: C20.1, C21.1, D3.2, R18.2, R19.2, R20.2, R22.1
unnamed: C20.2, R21.2
unnamed: C21.2, D3.1, R22.2, R23.1, R24.1
unnamed: C22.1, RPB1.22
unnamed: C22.2, D3.6, R24.2, R26.1
unnamed: C23.-, R25.1
unnamed: HL1.C, R1.2
unnamed: R10.2, RPB1.13
unnamed: R16.1, R20.1, R21.1, RPB1.15
unnamed: R23.2, RPB1.23
unnamed: R25.2, RPB1.33
unnamed: R27.1, RPB1.21
VA: C1.+, C2.1, D1.1, D1.8, D2.8, HL1.A, R2.2, VD1.C, VD3.A, XS1.S
VB: C4.1, D3.8, VD2.C
VC: C7.2, D1.5, D3.4
VREF: C3.+, D3.3, D3.5, R2.1, R3.2, R5.1, R7.1, R8.1, RPB1.12, RPB1.16
