Adept666/stompboxes/PCBS-PCAS/ТКП-3.30.B/ТКП-1.30.B-6/ТКП-1.30.B-6.kicad_pcb

## KiCad design PCBS-PCAS/ТКП-3.30.B/ТКП-1.30.B-6/ТКП-1.30.B-6.kicad_pcb (2025-06-21)

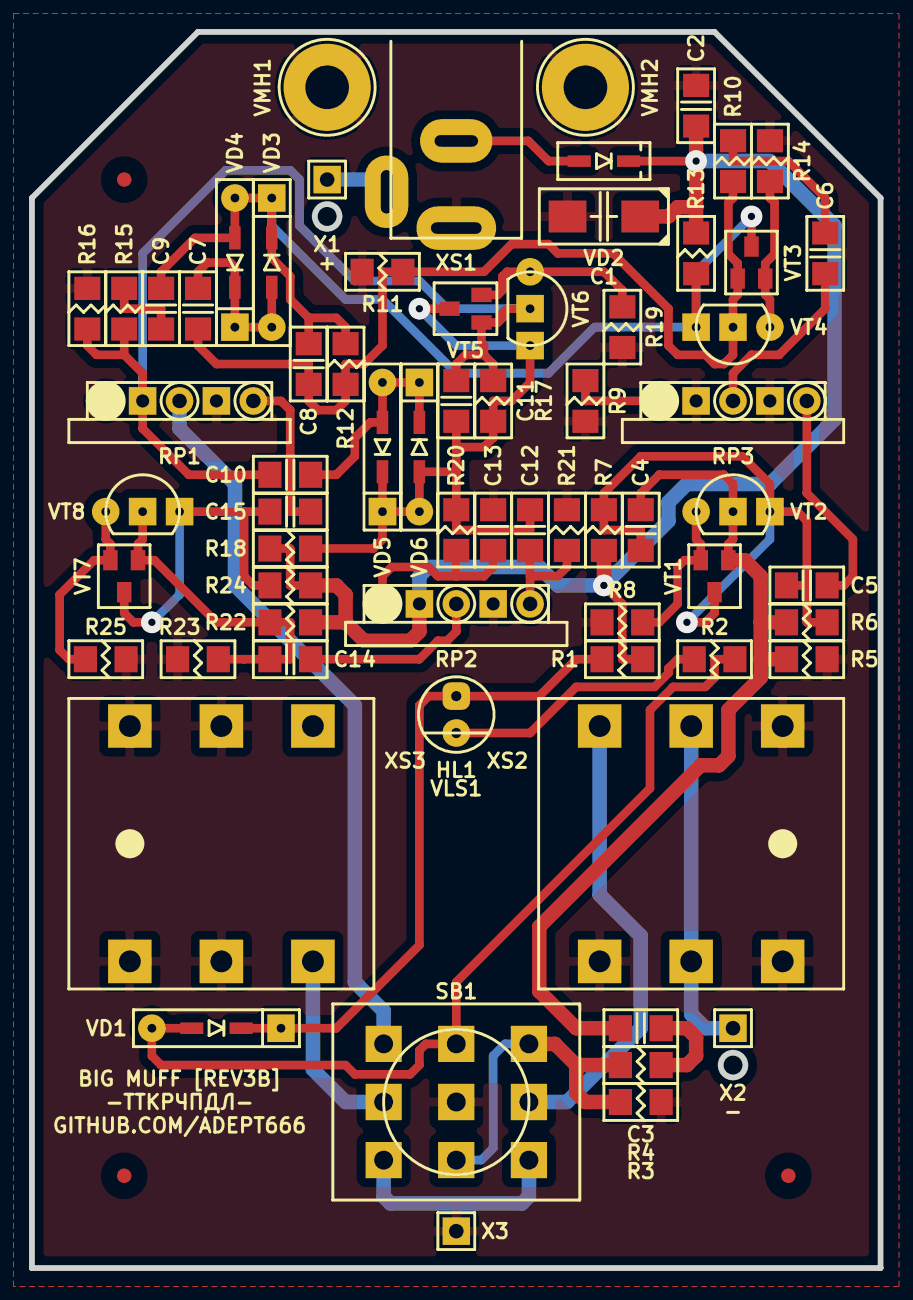
[picture p130: board ТКП-1.30.B-6.kicad_pcb from above]

Board: 2 copper layers, 58.4 x 85.1 mm, 74 parts (0 on the bottom side), 37 nets.

Parts:
C1: 106; CP-CTSMD-C
C2, C5, C6, C9, C15: 104; C-SM-1206
C3, C14: 105; C-SM-1206
C4, C8, C11: 471; C-SM-1206
C7, C10: 683; C-SM-1206
C12: 332; C-SM-1206
C13: 103; C-SM-1206
GB1: X; B-PP3-HV
HL1: FYL-3014UWC; LED-ROUND-05.0-UNI-SH-SPACER-PNL-5.3
R1: 0; R-SM-1206
R2: 433; R-SM-1206
R3: 105; R-SM-1206
R4: 393; R-SM-1206
R5, R11, R16, R23: 104; R-SM-1206
R6, R12, R17, R22: 474; R-SM-1206
R7, R13, R18: 123; R-SM-1206
R8, R14, R19: 391; R-SM-1206
R9: 102; R-SM-1206
R10, R15, R24: 103; R-SM-1206
R20, R21: 223; R-SM-1206
R25: 272; R-SM-1206
RP1, RP3: A100K; RPB-18-1x17-1.6-PNL-7.2
RP2: B100K; RPB-18-1x17-1.6-PNL-7.2
SB1: PBS-24-302SP; SW-PBS-24-302SP-2.5-PNL-12.0
VD1: X; P-SOD-123-OR-DO-35-V2
VD2: 0520; P-SOD-123
VD3, VD4, VD5, VD6: 4148; P-SOD-123-OR-DO-35-V2
VE1: ТКП-6.3.1.A2.A1.A.1-1; ТКП-6.3.1.A2.A1.A
VE2: ТКП-6.3.3.A1.A1.3-1.A1.00; ТКП-6.3.3.A1
VFM1, VFM2, VFM3: 1.0; VFM-1.0-3.0-SL
VLS1: 2xBR-7.7; VLS-BR-P
VMH1, VMH2: DI5M3x20; VMH-STA-DA5-PNL-3.0
VT1, VT3, VT5, VT7: 847; P-SOT-23-B-E-C
VT2, VT4, VT6, VT8: 547; P-TO-92-E-B-C
X1, X2, X3: X; CON-PAD-S-1.0-1.9
XS1: DC-005; CON-DC-005-9V-OVAL
XS2, XS3: PJ-644C; CON-PJ-644C-IN-OR-OUT

Connections:
/1B: C3.2, C4.1, R5.2, R6.1, VT1.B, VT2.B
/1C: C4.2, C5.1, R6.2, R7.1, VT1.C, VT2.C
/1E: R8.2, VT1.E, VT2.E
/2B: C7.1, C8.1, R10.2, R11.2, R12.1, VT3.B, VT4.B
/2C: C8.2, C9.1, R12.2, R13.1, VD3.C, VD4.A, VT3.C, VT4.C
/2E: R14.2, VT3.E, VT4.E
/3B: C10.1, C11.1, R15.2, R16.2, R17.1, RP1.NC1, VT5.B, VT6.B
/3C: C11.2, C12.1, R17.2, R18.1, R20.1, VD5.C, VD6.A, VT5.C, VT6.C
/3E: R19.2, VT5.E, VT6.E
/4B: C14.2, R22.1, R23.2, VT7.B, VT8.B
/4C: C15.1, R24.1, VT7.C, VT8.C
/4E: R25.2, VT7.E, VT8.E
/IN-CIR: R3.2, R4.1, SB1.NC2, SB1.NO3
/IN-CON: SB1.COM3, XS2.T
/LED: R2.1, SB1.NO2, VD1.A
/OUT-CIR: RP1.2, SB1.NO1
/OUT-CON: SB1.COM1, XS3.T
/PP3-NEG: X2.1, XS2.R, XS2.RN
/PP3-POS: X1.1, XS1.SN
COM: C1.-, C2.2, C13.2, R3.1, R5.1, R8.1, R9.1, R11.1, R14.1, R16.1, R19.1, R21.2, R23.1, R25.1, RP1.1, RP1.NC2, RP2.NC2, RP3.NC1, RP3.NC2, SB1.COM2, VMH1.0, VMH2.0, X3.1, XS1.C, XS2.S, XS2.SN, XS2.TN, XS3.R, XS3.RN, XS3.S, XS3.SN
unnamed: C3.1, R4.2
unnamed: C5.2, RP3.3
unnamed: C6.1, RP3.2
unnamed: C6.2, R10.1
unnamed: C7.2, VD3.A, VD4.C
unnamed: C9.2, R15.1
unnamed: C10.2, VD5.A, VD6.C
unnamed: C12.2, R21.1, RP2.3
unnamed: C13.1, R20.2, RP2.1
unnamed: C14.1, RP2.2
unnamed: C15.2, RP1.3
unnamed: HL1.A, R1.2, VD1.C
unnamed: HL1.C, R2.2
unnamed: R9.2, RP3.1
unnamed: SB1.NC1, SB1.NC3
unnamed: VD2.A, XS1.S
V: C1.+, C2.1, R1.1, R7.2, R13.2, R18.2, R22.2, R24.2, RP2.NC1, VD2.C
