Adept666/stompboxes/PCBS-PCAS/ТКП-3.30.A/ТКП-1.30.A-5/ТКП-1.30.A-5.kicad_pcb

## KiCad design PCBS-PCAS/ТКП-3.30.A/ТКП-1.30.A-5/ТКП-1.30.A-5.kicad_pcb (2025-06-21)

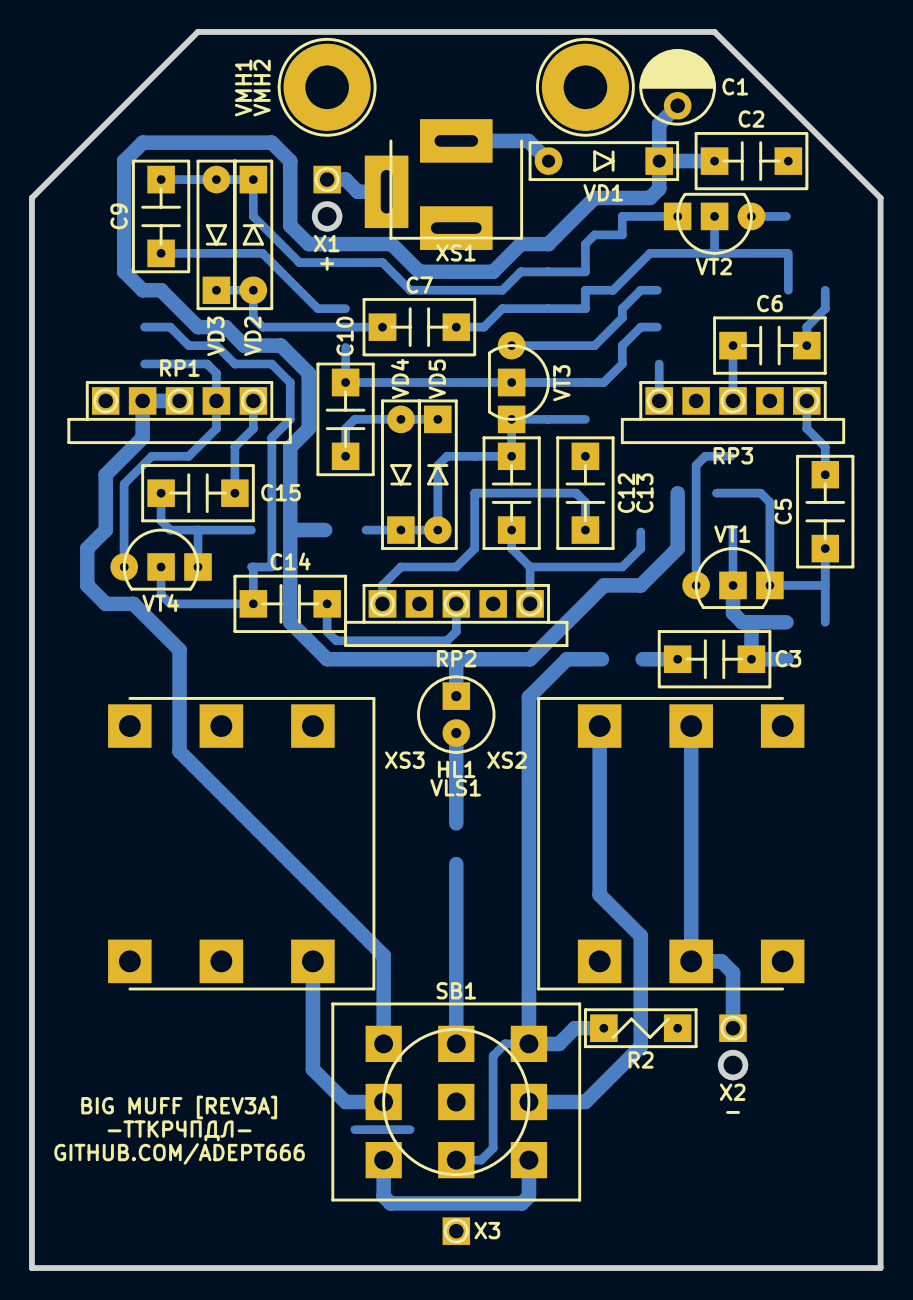
[picture p131: board ТКП-1.30.A-5.kicad_pcb from above]

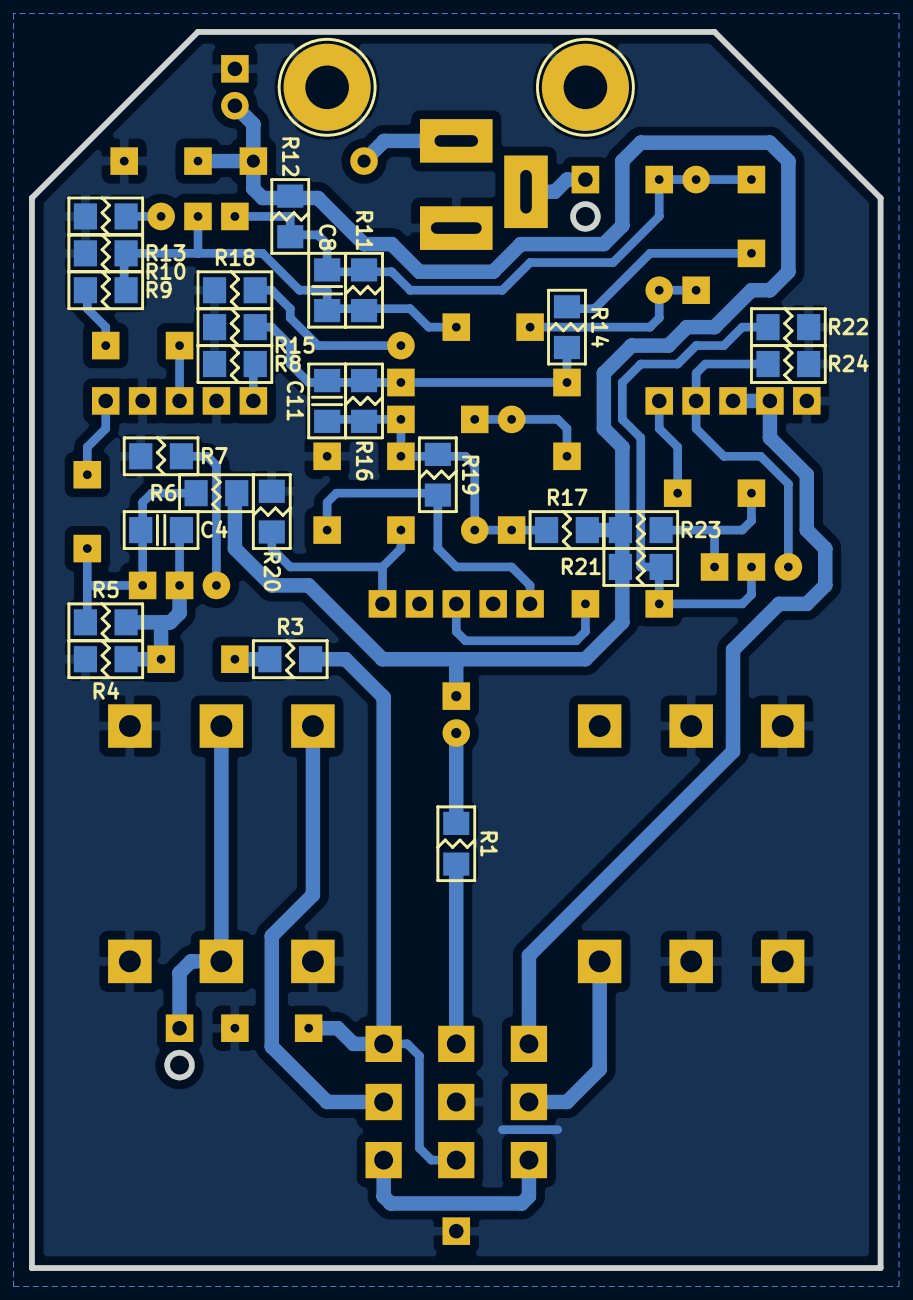
[picture p132: board ТКП-1.30.A-5.kicad_pcb from below]

Board: 2 copper layers, 58.4 x 85.1 mm, 65 parts (26 on the bottom side), 36 nets.

Parts:
C1: 106; CP-RADIAL-D05.0-P02.0-CLS
C2: 104; C-DISK-D04.2-T03.0-P05.08-d0.5
C3, C5, C6, C7, C9, C10, C14, C15: 105; C-DISK-D04.2-T03.0-P05.08-d0.5
C4, C8, C11: 471; C-SM-1206
C12: 392; C-DISK-D04.2-T03.0-P05.08-d0.5
C13: 103; C-DISK-D04.2-T03.0-P05.08-d0.5
GB1: X; B-PP3-HV
HL1: FYL-3014UWC; LED-ROUND-05.0-UNI-SH-SPACER-PNL-5.3
R1: 433; R-SM-1206
R2: 105; R-MFR-12
R3: 393; R-SM-1206
R4, R10, R15, R22: 104; R-SM-1206
R5: 514; R-SM-1206
R6, R9, R12, R14, R17, R23: 103; R-SM-1206
R7: 101; R-SM-1206
R8: 182; R-SM-1206
R11, R16, R21: 474; R-SM-1206
R13, R18: 391; R-SM-1206
R19, R20: 223; R-SM-1206
R24: 202; R-SM-1206
RP1, RP3: A100K; RPB-18-1x17-1.6-PNL-7.2
RP2: B100K; RPB-18-1x17-1.6-PNL-7.2
SB1: PBS-24-302SP; SW-PBS-24-302SP-2.5-PNL-12.0
VD1: 5817; P-DO-41
VD2, VD3, VD4, VD5: 6263; P-DO-35
VE1: ТКП-6.3.1.A2.A1.A.1-1; ТКП-6.3.1.A2.A1.A
VE2: ТКП-6.3.3.A1.A1.3-1.A1.00; ТКП-6.3.3.A1
VLS1: 2xBR-7.7; VLS-BR
VMH1, VMH2: DI5M3x20; VMH-STA-DA5-PNL-3.0
VT1, VT2, VT3, VT4: 5088; P-TO-92-E-B-C
X1, X2, X3: X; CON-PAD-S-1.0-1.9
XS1: DC-005; CON-DC-005
XS2, XS3: PJ-644C; CON-PJ-644C

Connections:
/IN-CIR: R2.2, R3.1, SB1.NC2, SB1.NO3
/IN-CON: SB1.COM3, XS2.T
/LED: R1.1, SB1.NO2
/OUT-CIR: RP1.2, RP1.NC1, SB1.NO1
/OUT-CON: SB1.COM1, XS3.T
/PP3-NEG: X2.1, XS2.R, XS2.RN
/PP3-POS: X1.1, XS1.SN
COM: C1.-, C2.2, C13.2, R2.1, R4.1, R7.1, R8.1, R10.1, R13.1, R15.1, R18.1, R20.2, R22.1, R24.1, RP1.1, RP3.NC1, RP3.NC2, SB1.COM2, VMH1.0, VMH2.0, X3.1, XS1.C, XS2.S, XS2.SN, XS2.TN, XS3.R, XS3.RN, XS3.S, XS3.SN
unnamed: C3.1, R3.2
unnamed: C3.2, C4.1, R4.2, R5.1, VT1.B
unnamed: C4.2, C5.1, R5.2, R6.1, VT1.C
unnamed: C5.2, RP3.3
unnamed: C6.1, RP3.2
unnamed: C6.2, R9.1
unnamed: C7.1, C8.1, R9.2, R10.2, R11.1, VT2.B
unnamed: C7.2, VD2.A, VD3.C
unnamed: C8.2, C9.1, R11.2, R12.1, VD2.C, VD3.A, VT2.C
unnamed: C9.2, R14.1
unnamed: C10.1, C11.1, R14.2, R15.2, R16.1, VT3.B
unnamed: C10.2, VD4.A, VD5.C
unnamed: C11.2, C12.1, R16.2, R17.1, R19.1, VD4.C, VD5.A, VT3.C
unnamed: C12.2, R20.1, RP2.3
unnamed: C13.1, R19.2, RP2.1
unnamed: C14.1, RP2.2
unnamed: C14.2, R21.1, R22.2, VT4.B
unnamed: C15.1, R23.1, VT4.C
unnamed: C15.2, RP1.3
unnamed: HL1.C, R1.2
unnamed: R7.2, VT1.E
unnamed: R8.2, RP3.1
unnamed: R13.2, VT2.E
unnamed: R18.2, VT3.E
unnamed: R24.2, RP1.NC2, VT4.E
unnamed: SB1.NC1, SB1.NC3
unnamed: VD1.A, XS1.S
V: C1.+, C2.1, HL1.A, R6.2, R12.2, R17.2, R21.2, R23.2, VD1.C
