Adept666/stompboxes/PCBS-PCAS/ТКП-3.17.B/ТКП-1.17.B-2/ТКП-1.17.B-2.kicad_pcb

## KiCad design PCBS-PCAS/ТКП-3.17.B/ТКП-1.17.B-2/ТКП-1.17.B-2.kicad_pcb (2025-06-17)

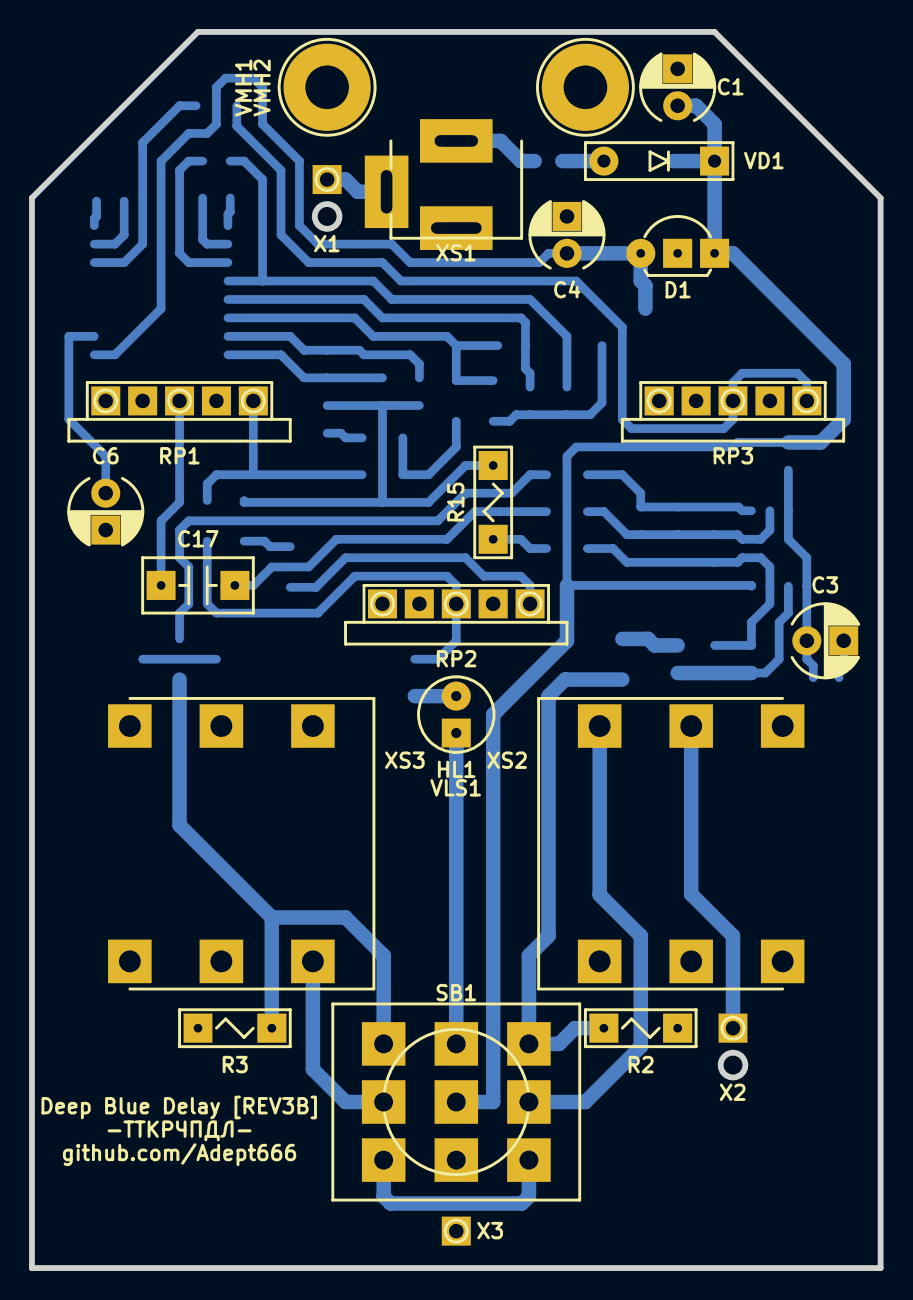
[picture p133: board ТКП-1.17.B-2.kicad_pcb from above]

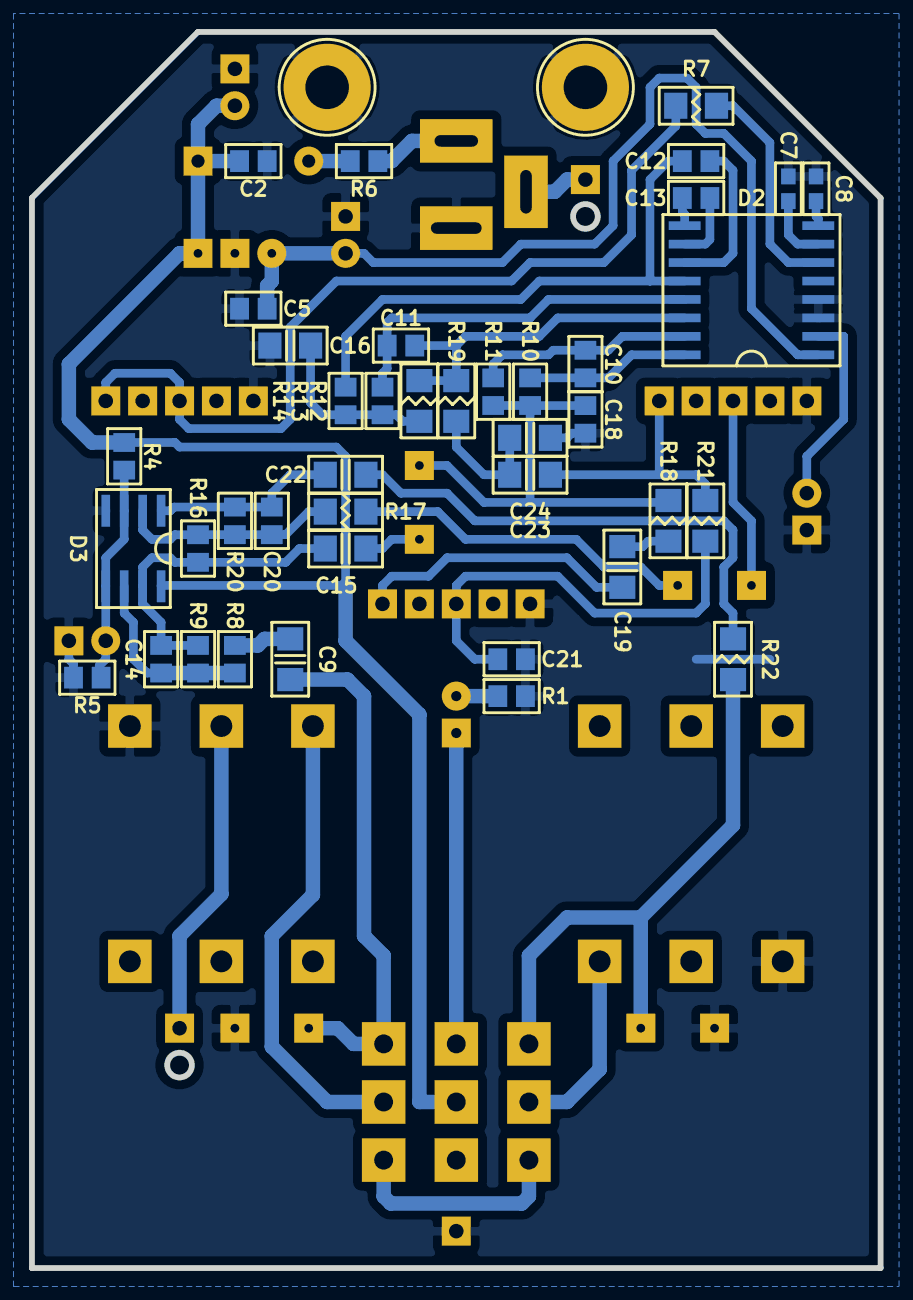
[picture p134: board ТКП-1.17.B-2.kicad_pcb from below]

Board: 2 copper layers, 58.4 x 85.1 mm, 67 parts (40 on the bottom side), 44 nets.

Parts:
C1: 107; CP-RADIAL-D05.0-P02.0-CLS
C2, C5, C12, C13: 104; C-SM-0805
C3, C4, C6: 476; CP-RADIAL-D05.0-P02.0-CLS
C7, C8: 104; C-SM-0603
C9, C19: 223; C-SM-1206
C10, C11: 222; C-SM-0805
C14: 470; C-SM-0805
C15, C22, C23: 105; C-SM-1206
C16: 153; C-SM-1206
C17: 105; C-DISK-D04.2-T03.0-P05.08-d0.5
C18: 472; C-SM-0805
C20: 101; C-SM-0805
C21: 473; C-SM-0805
C24: 103; C-SM-1206
D1: 78L05; P-TO-92-OUT-GND-IN
D2: 8970; P-SO-16W
D3: 5532; P-SO-08
GB1: X; B-PP3-HV
HL1: FYL-5013UWC; LED-ROUND-05.0-UNI-SH-SPACER-PNL-5.3
R1, R4, R5, R10, R11, R13, R14: 103; R-SM-0805
R2: 105; R-MFR-12
R3: 104; R-MFR-12
R6: 0; R-SM-0805
R7: 272; R-SM-1206
R8: 184; R-SM-0805
R9: 364; R-SM-0805
R12, R17: 203; R-SM-1206
R15: 103; R-MFR-12
R16: 223; R-SM-0805
R18: 512; R-SM-1206
R19, R22: 102; R-SM-1206
R20: 123; R-SM-0805
R21: 202; R-SM-1206
RP1, RP2, RP3: B50K; RPB-18-1x17-1.5-PNL-7.2
SB1: PBS-24-302SP; SW-PBS-24-302SP-3.0-PNL-12.0
VD1: 5817; P-DO-41
VE1: ТКП-6.3.1.A2.A1.A.1-1; ТКП-6.3.1.A2.A1.A
VE2: ТКП-6.3.3.A1.A1.3-1.A1.00; ТКП-6.3.3.A1
VLS1: BR-17.8; VLS-BR
VMH1, VMH2: DI5M3x20; VMH-STA-DA5-PNL-3.0
X1, X2, X3: X; CON-PAD-S-1.0-2.0
XS1: DC-005; CON-DC-005
XS2, XS3: PJ-644C; CON-PJ-644C

Connections:
/IN-CIR: C9.1, R2.2, SB1.NO3
/IN-CON: SB1.COM3, XS2.T
/LED: HL1.A, SB1.NO2
/OUT-CIR: R3.2, R22.2, SB1.NO1
/OUT-CON: SB1.COM1, XS3.T
/PP3-NEG: X2.1, XS2.R
/PP3-POS: X1.1, XS1.SN
COM: C1.-, C2.2, C3.-, C4.-, C5.2, C6.-, C7.1, C8.1, C16.2, C18.2, C21.2, C24.2, D1.GND, D2.3, D2.4, D3.4, R1.1, R2.1, R3.1, R5.1, RP1.1, RP2.1, RP3.1, VMH1.0, VMH2.0, X3.1, XS1.C, XS2.S, XS3.S
unnamed: C6.+, D2.2
unnamed: C7.2, D2.7
unnamed: C8.2, D2.8
unnamed: C9.2, R8.1
unnamed: C10.1, D2.16, R10.1
unnamed: C10.2, D2.15, R11.1
unnamed: C11.1, D2.14, R12.1, R19.1
unnamed: C11.2, D2.13, R13.1
unnamed: C12.1, D2.12, R14.1
unnamed: C12.2, D2.11
unnamed: C13.1, D2.10
unnamed: C13.2, D2.9
unnamed: C14.1, D3.6, R8.2, R9.1
unnamed: C14.2, C15.1, D3.7, R9.2, R16.1
unnamed: C15.2, R15.2
unnamed: C16.1, R12.2, R13.2, R14.2
unnamed: C17.1, R17.1
unnamed: C17.2, RP1.2
unnamed: C18.1, R10.2, R11.2, R15.1, R18.2
unnamed: C19.1, R18.1
unnamed: C19.2, RP2.3
unnamed: C20.1, D3.2, R16.2, R17.2, R20.1
unnamed: C20.2, C22.1, D3.1, R20.2
unnamed: C21.1, R21.1, RP2.2
unnamed: C22.2, R22.1
unnamed: C23.1, R21.2, RP1.3
unnamed: C23.2, C24.1, R19.2
unnamed: D2.6, R7.2
unnamed: HL1.C, R1.2
unnamed: R6.1, XS1.S
unnamed: R6.2, VD1.A
unnamed: R7.1, RP3.2, RP3.3
unnamed: SB1.NC1, SB1.NC3
V: C1.+, C2.1, D1.IN, D3.8, R4.2, SB1.COM2, VD1.C
VA: C4.+, C5.1, D1.OUT, D2.1
VB: C3.+, D3.3, D3.5, R4.1, R5.2
