Adept666/stompboxes/PCBS-PCAS/ТКП-3.37.A/ТКП-1.35.A-3/ТКП-1.35.A-3.kicad_pcb

## KiCad design PCBS-PCAS/ТКП-3.37.A/ТКП-1.35.A-3/ТКП-1.35.A-3.kicad_pcb (2025-06-12)

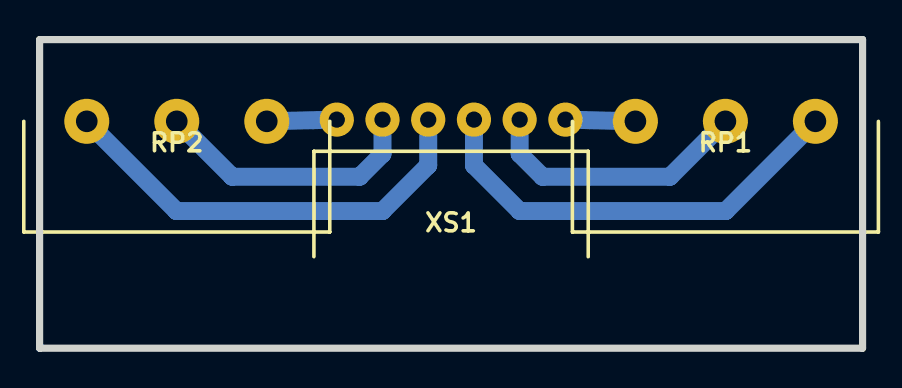
[picture p135: board ТКП-1.35.A-3.kicad_pcb from above]

Board: 2 copper layers, 45.7 x 17.1 mm, 3 parts (0 on the bottom side), 6 nets.

Parts:
RP1: RP1: C50K; RP-PDB181-K-20-P-CIRCULAR
RP2: RP2: C50K; RP-PDB181-K-20-P-CIRCULAR
XS1: PBS-06R; CON-PBS-06R-CIRCULAR

Connections:
unnamed: RP1.1, XS1.4
unnamed: RP1.2, XS1.5
unnamed: RP1.3, XS1.6
unnamed: RP2.1, XS1.1
unnamed: RP2.2, XS1.2
unnamed: RP2.3, XS1.3
