Adept666/stompboxes/PCBS-PCAS/ТКП-3.39.A/ТКП-1.37.A-2/ТКП-1.37.A-2.kicad_pcb

## KiCad design PCBS-PCAS/ТКП-3.39.A/ТКП-1.37.A-2/ТКП-1.37.A-2.kicad_pcb (2025-05-08)

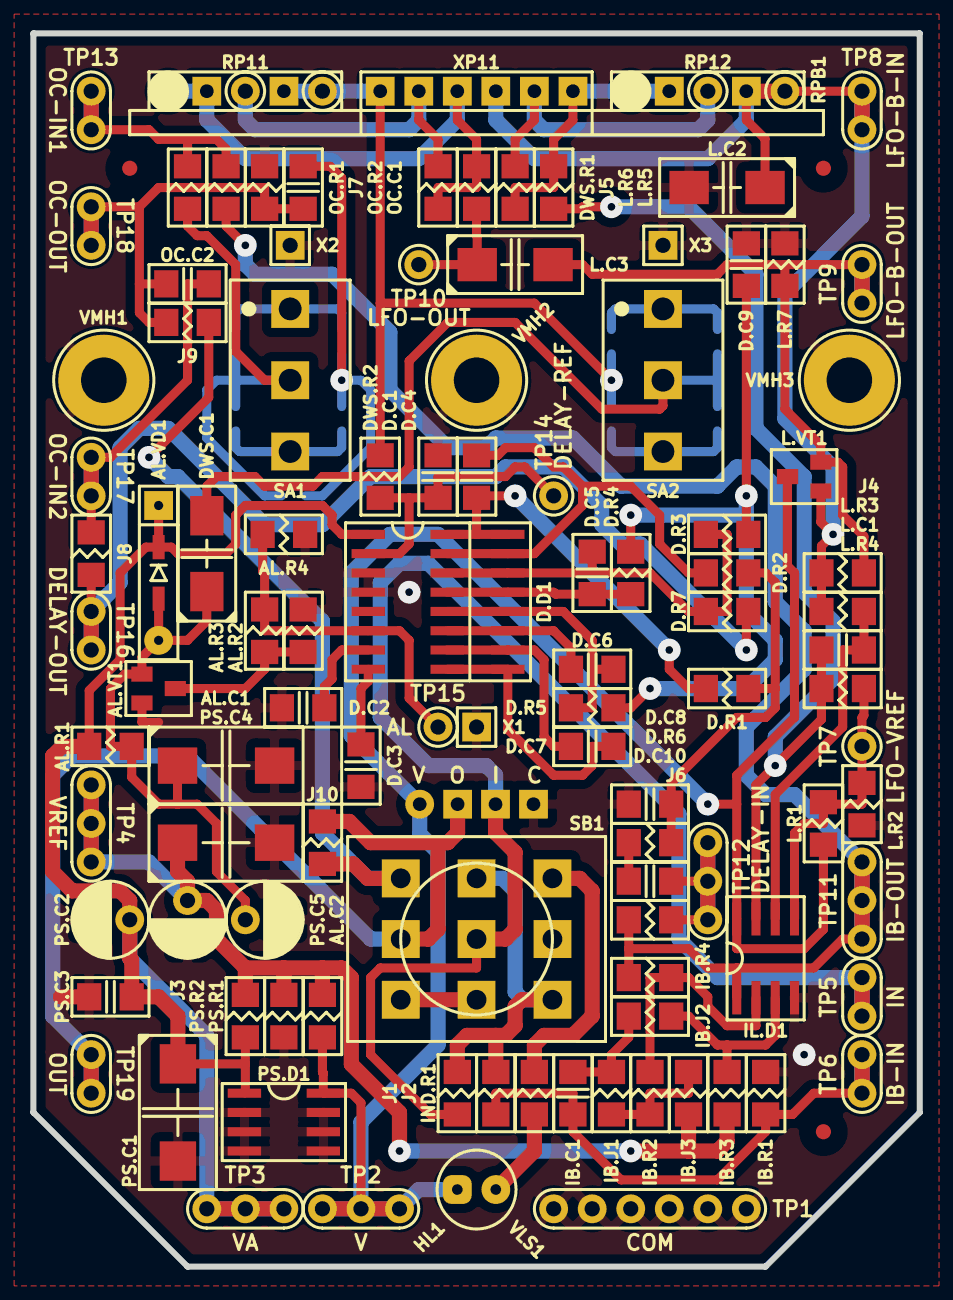
[picture p136: board ТКП-1.37.A-2.kicad_pcb from above]

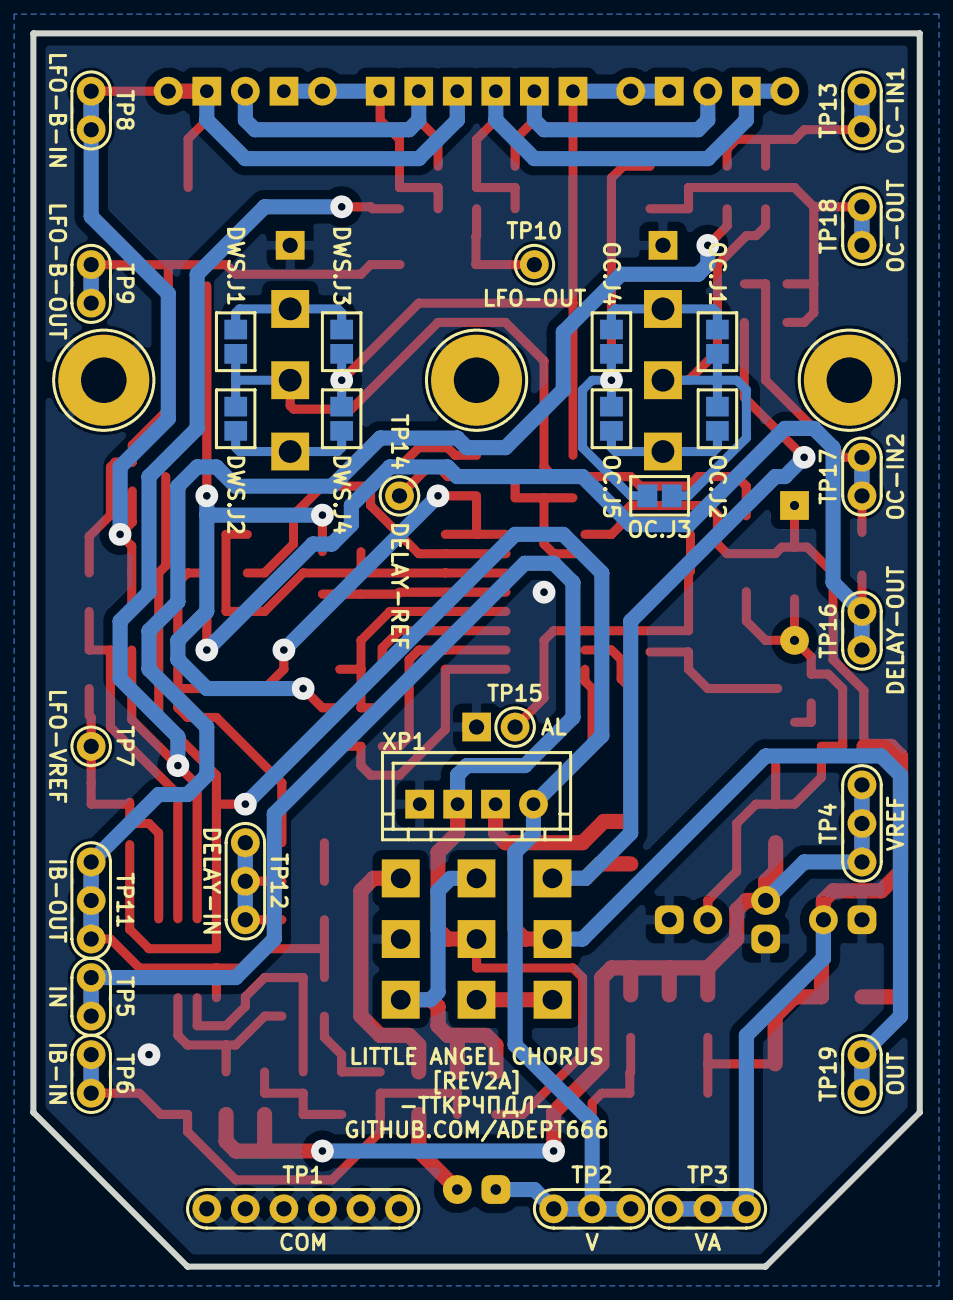
[picture p137: board ТКП-1.37.A-2.kicad_pcb from below]

Board: 2 copper layers, 58.4 x 81.3 mm, 118 parts (10 on the bottom side), 57 nets.

Parts:
AL.C1: 476; CP-CTSMD-D
AL.C2: 476; CP-RADIAL-D05.0-P02.0-CLS
AL.R1: 683; R-SM-1206
AL.R2: X; R-SM-1206
AL.R3: 101; R-SM-1206
AL.R4: 222; R-SM-1206
AL.VD1: 4148; P-SOD-123-OR-DO-35-V2
AL.VT1: 3904; P-SOT-23-B-E-C
D.C1: 105; C-SM-1206
D.C2, D.C3, D.C10: 104; C-SM-1206
D.C4, D.C8, D.C9: 332; C-SM-1206
D.C5: 102; C-SM-1206
D.C6, D.C7: 103; C-SM-1206
D.D1: 8970; P-SO-16-OR-SO-16W
D.R1, D.R2, D.R3, D.R4, D.R5, D.R6, D.R7: 103; R-SM-1206
DWS.C1: X; CP-CTSMD-C
DWS.J1: DWS.J1; J-SB-0805-2
DWS.J2: DWS.J2; J-SB-0805-2
DWS.J3: DWS.J3; J-SB-0805-2
DWS.J4: DWS.J4; J-SB-0805-2
DWS.R1: 0; R-SM-1206
DWS.R2: 333; R-SM-1206
HL1: FYL-5013UWC; LED-ROUND-05.0-UNI-SH-SPACER-PNL-5.3
IB.C1: 104; C-SM-1206
IB.J1: X; R-SM-1206
IB.J2, IB.J3: 0; R-SM-1206
IB.R1: 105; R-SM-1206
IB.R2, IB.R4: 223; R-SM-1206
IB.R3: 474; R-SM-1206
IL.D1: 5532; P-SO-08
IND.R1: 103; R-SM-1206
J1, J3, J4, J7, J10: X; R-SM-1206
J2, J5, J6, J8, J9: 0; R-SM-1206
L.C1: 103; C-SM-1206
L.C2, L.C3: 106; CP-CTSMD-C
L.R1: 104; R-SM-1206
L.R2: 473; R-SM-1206
L.R3, L.R4: 224; R-SM-1206
L.R5: 472; R-SM-1206
L.R6: 0; R-SM-1206
L.R7: 103; R-SM-1206
L.VT1: 3904; P-SOT-23-B-E-C
OC.C1: X; C-SM-1206
OC.C2: 104; C-SM-1206
OC.J1: OC.J1; J-SB-0805-2
OC.J2: OC.J2; J-SB-0805-2
OC.J3: OC.J3; J-SB-0805-2
OC.J4: OC.J4; J-SB-0805-2
OC.J5: OC.J5; J-SB-0805-2
OC.R1: X; R-SM-1206
OC.R2: 104; R-SM-1206
PS.C1, PS.C4: 476; CP-CTSMD-D
PS.C2, PS.C5: 476; CP-RADIAL-D05.0-P02.0-CLS
PS.C3: 104; C-SM-1206
PS.D1: 78L05; P-SO-08-OUT-GND-GND-NC-NC-GND-GND-IN
PS.R1, PS.R2: 103; R-SM-1206
RPB1: C50K-C50K; RPB-1590N1-18-2x17-OR-2x1x17-1.6-PNL-7.4-2.8
SA1, SA2: X; SW-MTS-102-A2-2.5
SB1: PBS-24-302SP; SW-PBS-24-302SP-2.5-PNL-13.0
TP1: COM; TP-6-1.0-1.9
TP2: V; TP-3-1.0-1.9
TP3: VA; TP-3-1.0-1.9
TP4: VREF; TP-3-1.0-1.9
TP5: IN; TP-2-1.0-1.9
TP6: IB-IN; TP-2-1.0-1.9
TP7: LFO-VREF; TP-1-1.0-1.9
TP8: LFO-B-IN; TP-2-1.0-1.9
TP9: LFO-B-OUT; TP-2-1.0-1.9
TP10: LFO-OUT; TP-1-1.0-1.9
TP11: IB-OUT; TP-3-1.0-1.9
TP12: DELAY-IN; TP-3-1.0-1.9
TP13: OC-IN1; TP-2-1.0-1.9
TP14: DELAY-REF; TP-1-1.0-1.9
TP15: AL; TP-1-1.0-1.9
TP16: DELAY-OUT; TP-2-1.0-1.9
TP17: OC-IN2; TP-2-1.0-1.9
TP18: OC-OUT; TP-2-1.0-1.9
TP19: OUT; TP-2-1.0-1.9
VE1: 1590N1; 1590N1_A1
VFM1, VFM2, VFM3: 1.0; VFM-1.0-3.0-SL
VLS1: BR-12.7; VLS-BR
VMH1, VMH3: DI5M3x18; VMH-STA-DA5-PNL-3.0
VMH2: X; VMH-STA-DA5
X1: COM; CON-PAD-S-1.0-1.9
X2, X3: X; CON-PAD-S-1.0-1.9
XB1: 1590N1 Connector Board; XB-1590N1
XP1: B4B-XH-A; CON-XH-B4B-A

Connections:
/AL: AL.R3.2, AL.R4.2, D.D1.6, TP15.1
/CIR-IN: J1.2, J2.1, SB1.NC3, SB1.NO2
/CIR-OUT: J9.2, J10.1, SB1.NO1
/DELAY-IN: D.C10.2, J6.2, TP12.1
/DELAY-OUT: D.R7.2, J8.1, TP16.1
/DELAY-REF: D.C1.1, D.D1.2, DWS.R2.2, TP14.1
/DEPTH-IN: DWS.R1.1, J5.2, RPB1.11, RPB1.NC1
/IB-IN: IB.C1.1, IB.R1.2, J2.2, TP6.1
/IB-OUT: IB.R4.2, IL.D1.1, J6.1, J7.1, TP11.1
/IN: J1.1, SB1.COM2, TP5.1, XP1.3
/LED: IND.R1.1, SB1.NO3
/LFO-B-IN: J4.1, L.C2.+, L.R3.2, L.VT1.B, RPB1.23, RPB1.NC4, TP8.1
/LFO-B-OUT: J4.2, L.C3.-, L.R7.2, L.VT1.E, TP9.1
/LFO-OUT: J5.1, L.C3.+, TP10.1
/LFO-VREF: IL.D1.5, L.R1.1, L.R2.2, L.R4.1, TP7.1
/OC-IN1: J7.2, OC.R1.1, TP13.1
/OC-IN2: J8.2, OC.C2.1, TP17.1
/OC-OUT: J9.1, OC.C1.2, OC.C2.2, OC.R2.2, TP18.1
/OUT: J10.2, SB1.COM1, TP19.1, XP1.2
/WS: AL.C1.+, AL.C2.+, AL.R1.1, AL.VD1.A, AL.VT1.B, DWS.C1.+
COM: AL.C1.-, AL.C2.-, AL.R2.1, AL.R4.1, AL.VT1.E, D.C1.2, D.C2.1, D.C3.1, D.C8.1, D.C9.2, D.D1.3, D.D1.4, IB.R1.1, IL.D1.4, L.C2.-, L.R2.1, L.R7.1, OC.R2.1, PS.C1.-, PS.C2.-, PS.C3.2, PS.C4.-, PS.C5.-, PS.D1.GND, PS.D1.NC, PS.R2.1, SB1.COM3, TP1.1, VMH1.0, VMH2.0, VMH3.0, X1.1, X2.1, X3.1, XP1.4
unnamed: AL.R2.2, AL.R3.1, AL.VT1.C
unnamed: D.C2.2, D.D1.7
unnamed: D.C3.2, D.D1.8
unnamed: D.C4.1, D.D1.16, D.R1.1
unnamed: D.C4.2, D.D1.15, D.R2.1
unnamed: D.C5.1, D.D1.14, D.R3.1, D.R7.1
unnamed: D.C5.2, D.D1.13, D.R4.1
unnamed: D.C6.1, D.D1.12, D.R5.1
unnamed: D.C6.2, D.D1.11
unnamed: D.C7.1, D.D1.10
unnamed: D.C7.2, D.D1.9
unnamed: D.C8.2, D.R1.2, D.R2.2, D.R6.1
unnamed: D.C9.1, D.R3.2, D.R4.2, D.R5.2
unnamed: D.C10.1, D.R6.2
unnamed: DWS.C1.-, DWS.J1.1, DWS.J2.1, SA2.COM
unnamed: DWS.J1.2, DWS.J3.1, SA2.NC
unnamed: DWS.J2.2, DWS.J4.1, SA2.NO
unnamed: DWS.J3.2, DWS.J4.2, DWS.R2.1, RPB1.13, RPB1.NC2
unnamed: DWS.R1.2, RPB1.12
unnamed: HL1.C, IND.R1.2
unnamed: IB.C1.2, IB.J1.1, IB.J2.1
unnamed: IB.J1.2, IB.J3.2, IB.R2.1
unnamed: IB.J2.2, IB.R3.2, IL.D1.3
unnamed: IB.R2.2, IB.R4.1, IL.D1.2
unnamed: IL.D1.6, L.C1.1, L.R3.1
unnamed: IL.D1.7, L.C1.2, L.R4.2, L.R5.1
unnamed: L.R5.2, L.R6.1, RPB1.21, RPB1.NC3
unnamed: L.R6.2, RPB1.22
unnamed: OC.C1.1, OC.J3.2, OC.J4.2, OC.J5.2
unnamed: OC.J1.1, OC.J2.1, OC.J3.1, OC.R1.2, SA1.COM
unnamed: OC.J1.2, OC.J4.1, SA1.NC
unnamed: OC.J2.2, OC.J5.1, SA1.NO
unnamed: SB1.NC1, SB1.NC2
V: HL1.A, IL.D1.8, L.R1.2, L.VT1.C, PS.D1.IN, PS.R1.2, TP2.1, XP1.1
VA: AL.R1.2, AL.VD1.C, D.D1.1, J3.1, PS.C1.+, PS.C2.+, PS.C3.1, PS.D1.OUT, TP3.1
VREF: IB.J3.1, IB.R3.1, J3.2, PS.C4.+, PS.C5.+, PS.R1.1, PS.R2.2, TP4.1
