Adept666/stompboxes/PCBS-PCAS/ТКП-3.26.C/ТКП-1.26.C-2/ТКП-1.26.C-2.kicad_pcb

## KiCad design PCBS-PCAS/ТКП-3.26.C/ТКП-1.26.C-2/ТКП-1.26.C-2.kicad_pcb (2025-01-27)

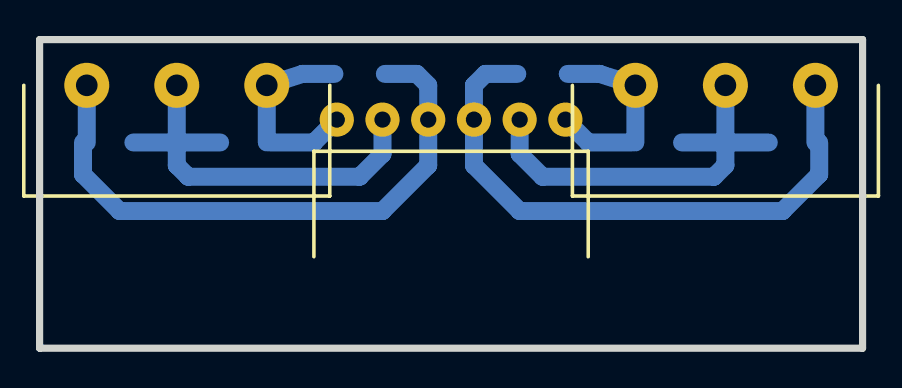
[picture p138: board ТКП-1.26.C-2.kicad_pcb from above]

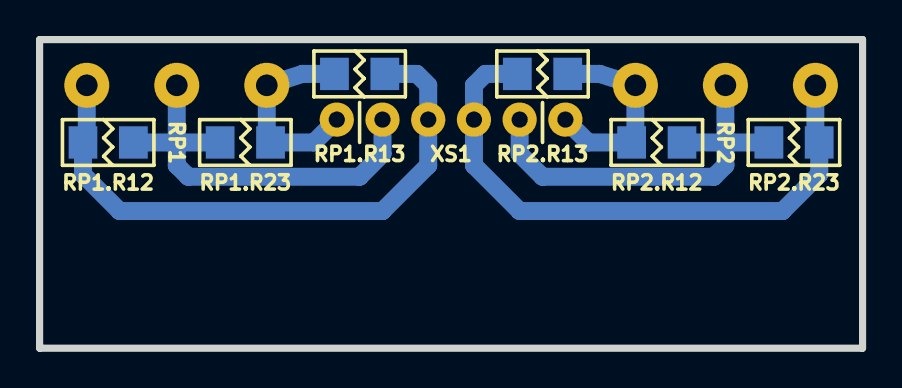
[picture p139: board ТКП-1.26.C-2.kicad_pcb from below]

Board: 2 copper layers, 45.7 x 17.1 mm, 9 parts (6 on the bottom side), 6 nets.

Parts:
RP1, RP2: B50K; RP-PDB181-K-20-P-CIRCULAR
RP1.R12, RP1.R13, RP1.R23, RP2.R12, RP2.R13, RP2.R23: X; R-SM-1206
XS1: PBS-06R; CON-PBS-06R-CIRCULAR

Connections:
unnamed: RP1.1, RP1.R12.2, RP1.R13.2, XS1.4
unnamed: RP1.2, RP1.R12.1, RP1.R23.2, XS1.5
unnamed: RP1.3, RP1.R13.1, RP1.R23.1, XS1.6
unnamed: RP2.1, RP2.R12.2, RP2.R13.2, XS1.1
unnamed: RP2.2, RP2.R12.1, RP2.R23.2, XS1.2
unnamed: RP2.3, RP2.R13.1, RP2.R23.1, XS1.3
