Adept666/stompboxes/PCBS-PCAS/ТКП-3.23.A/ТКП-1.23.A-1/ТКП-1.23.A-1.kicad_pcb

## KiCad design PCBS-PCAS/ТКП-3.23.A/ТКП-1.23.A-1/ТКП-1.23.A-1.kicad_pcb (2025-01-04)

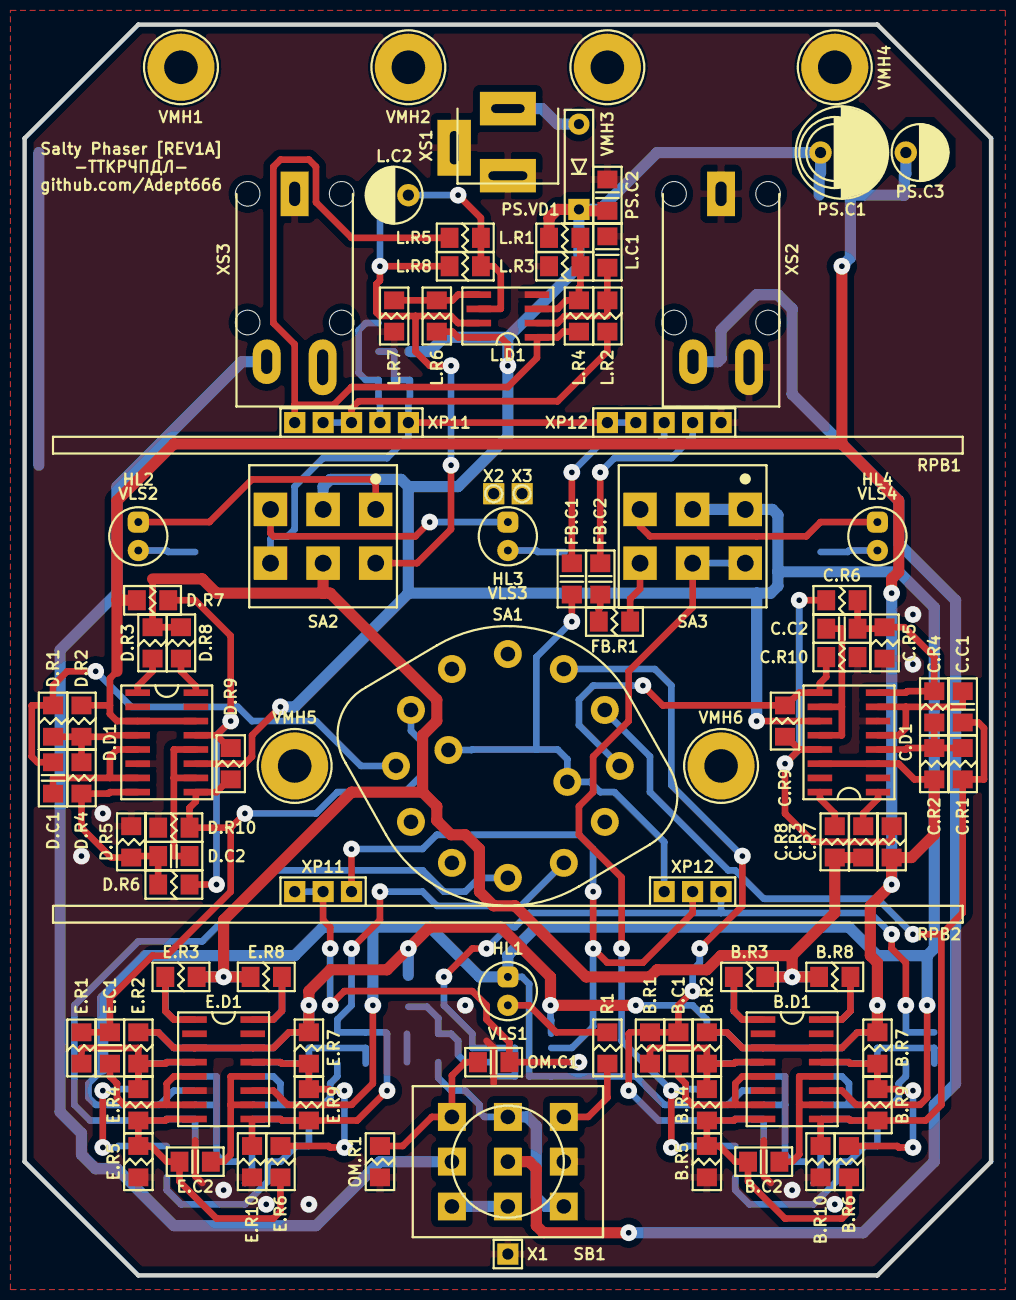
[picture p140: board ТКП-1.23.A-1.kicad_pcb from above]

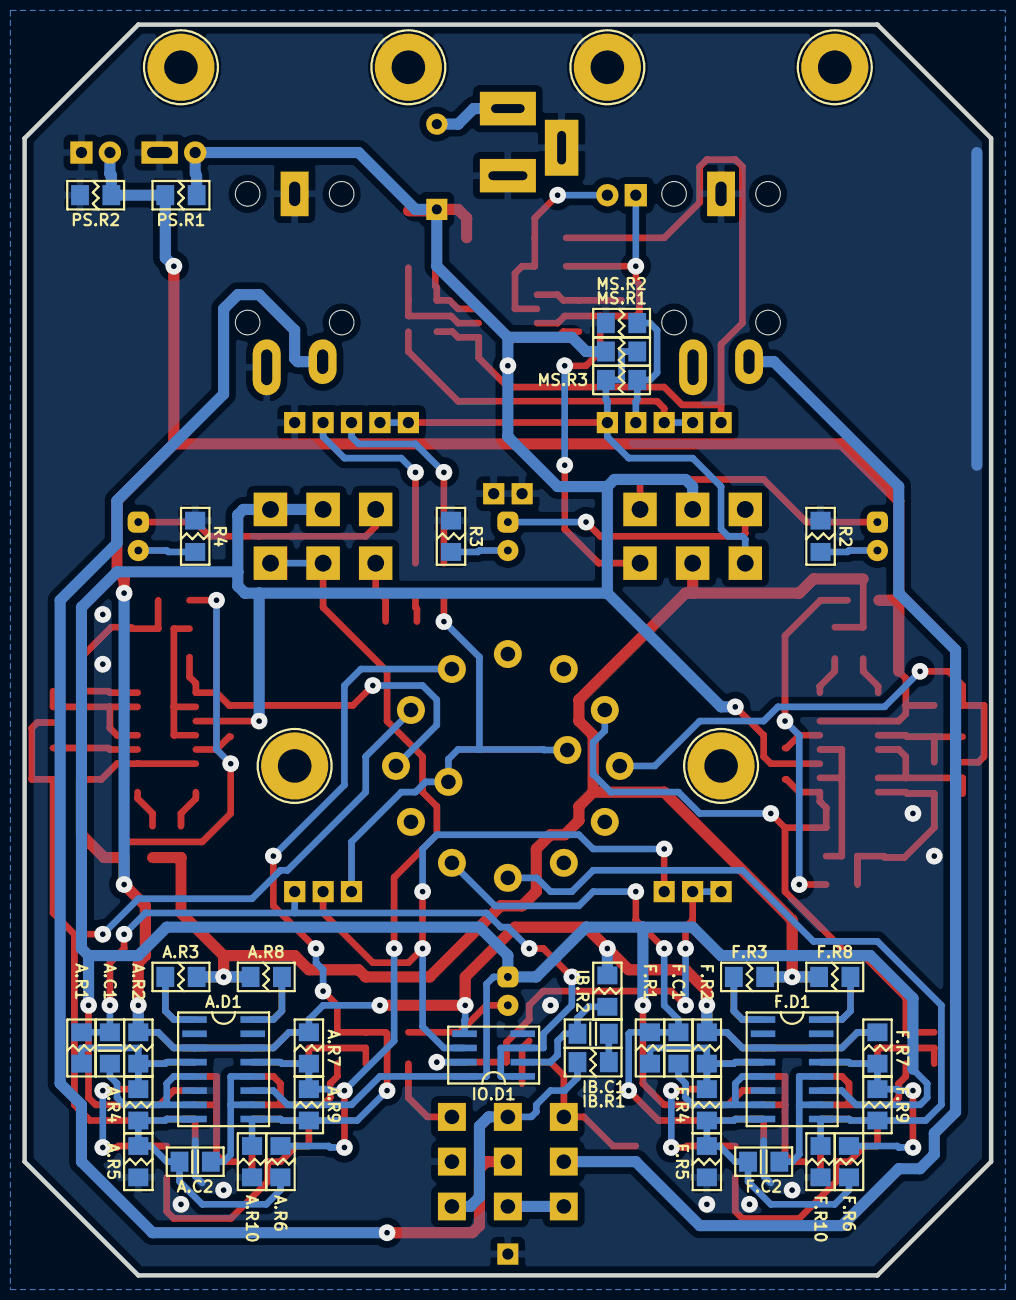
[picture p141: board ТКП-1.23.A-1.kicad_pcb from below]

Board: 2 copper layers, 86.4 x 111.8 mm, 160 parts (50 on the bottom side), 85 nets.

Parts:
*R1, *R2: 473; R-SM-0805
*R3: 2612; R-SM-0805
A.C1, A.C2: X; C-SM-1206
A.D1: X; P-SO-16
A.R1, A.R2, A.R3, A.R4, A.R5, A.R6, A.R7, A.R8, A.R9, A.R10: X; R-SM-1206
B.C1, B.C2: X; C-SM-1206
B.D1: X; P-SO-16
B.R1, B.R2, B.R3, B.R4, B.R5, B.R6, B.R7, B.R8, B.R9, B.R10: X; R-SM-1206
C.C1, C.C2: 332; C-SM-1206
C.D1: 13700; P-SO-16
C.R1, C.R4, C.R6, C.R9: 273; R-SM-1206
C.R2, C.R7: 182; R-SM-1206
C.R3, C.R5, C.R8, C.R10: 103; R-SM-1206
D.C1, D.C2: 332; C-SM-1206
D.D1: 13700; P-SO-16
D.R1, D.R4, D.R6, D.R9: 273; R-SM-1206
D.R2, D.R7: 182; R-SM-1206
D.R3, D.R5, D.R8, D.R10: 103; R-SM-1206
E.C1, E.C2: X; C-SM-1206
E.D1: X; P-SO-16
E.R1, E.R2, E.R3, E.R4, E.R5, E.R6, E.R7, E.R8, E.R9, E.R10: X; R-SM-1206
F.C1, F.C2: X; C-SM-1206
F.D1: X; P-SO-16
F.R1, F.R2, F.R3, F.R4, F.R5, F.R6, F.R7, F.R8, F.R9, F.R10: X; R-SM-1206
FB.C1, FB.C2: X; C-SM-1206
FB.R1: X; R-SM-1206
HL1: FYL-5013UWC; LED-ROUND-05.0-UNI-SH-SPACER-PNL-5.3
HL2, HL3, HL4: X; LED-ROUND-05.0-UNI-SH-SPACER-PNL-5.3
IB.C1: 472; C-SM-1206
IB.R1: 103; R-SM-1206
IB.R2: 105; R-SM-1206
IO.D1: 4558; P-SO-08
L.C1: 474; C-SM-1206
L.C2: 475; CP-RADIAL-D05.0-P02.0-CLS
L.D1: 4558; P-SO-08
L.R1, L.R3, L.R4: 364; R-SM-1206
L.R2: 154; R-SM-1206
L.R5, L.R6, L.R8: 103; R-SM-1206
L.R7: 622; R-SM-1206
MS.R1: 331; R-SM-1206
MS.R2: 680; R-SM-1206
MS.R3: 470; R-SM-1206
OM.C1: 473; C-SM-1206
OM.R1: X; R-SM-1206
PS.C1: 107; CP-RADIAL-D05.0-P02.0-CLS-OR-D06.3-P02.5-CLS-OR-D08.0-P03.5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
PS.C2: 104; C-SM-1206
PS.C3: 106; CP-RADIAL-D05.0-P02.0-CLS
PS.R1, PS.R2: 103; R-SM-1206
PS.VD1: 5817; P-DO-41
R1: 103; R-SM-1206
R2, R3, R4: X; R-SM-1206
RPB1: B500K-A1K-B100K; RPB-1590BB-18-3x17-1.5-PNL-7.4-2.8
RPB2: X; RPB-1590BB-18-2x17-1.5-PNL-7.4-2.8
SA1: X; SW-RBS-1-2P6W-VP-PNL-9.5
SA2: MTS-202-A2; SW-MTS-202-A2-3.0-PNL-6.0
SA3: X; SW-MTS-202-A2-3.0-PNL-6.0
SB1: PBS-24-302SP; SW-PBS-24-302SP-2.5-PNL-13.0
VE1: 1590BB; 1590BB_B1
VE2: ТКП-6.1.4.A1.A1.2-1.A1; ТКП-6.1.4.A1.A1
VJ1.1, VJ1.2, VJ3.1, VJ3.2, VJ3.3, VJ3.4: BOTTOM; VJ
VJ2.1, VJ2.2, VJ6.1, VJ6.2, VJ7.1, VJ7.2, VJ8.1, VJ8.2: TOP; VJ
VLS1: BR-12.7; VLS-BR
VLS2, VLS3, VLS4: X; VLS-BR
VMH1, VMH2, VMH3, VMH4, VMH5, VMH6: DI5M3x18; VMH-STA-DA5-PNL-3.0
VTC1, VTC2, VTC3: BOTTOM; VTC
VTC4: TOP; VTC
X1, X2: COM; CON-PAD-S-1.0-1.9
X3: X; CON-PAD-S-1.0-1.9
XS1: DC-005; CON-DC-005
XS2, XS3: ST-008S-05; CON-ST-008X-04-OR-ST-008X-05

Connections:
/DRY: A.C1.1, A.R1.1, IO.D1.1, IO.D1.3, RPB2.31, VJ1.1.1, VJ3.1.1, VJ3.4.1, VTC1.1, VTC3.1
/FB: A.D1.13, A.R6.2, A.R7.1, A.R9.1, SA3.COM2, SA3.NC2
/FB-ON: FB.R1.2, SA3.NO2
/IN-CIR: IB.R1.1, SB1.NC3, SB1.NO2
/IN-CON: SB1.COM2, XS2.T
/LED: R1.1, SB1.NO3
/LED-FB: HL4.A, SA3.NO1
/LED-MS: HL3.A, SA2.NO1
/LED-SPEED: HL2.A, SA2.NC1
/LFO: A.R3.1, A.R8.1, B.R3.1, B.R8.1, C.R3.1, C.R8.1, D.R3.1, D.R8.1, E.R3.1, E.R8.1, F.R3.1, F.R8.1, SA2.COM2
/LFO-AUTO: L.C2.-, L.D1.7, L.R8.2, SA2.NC2
/LFO-MANUAL: MS.R1.1, MS.R3.2, RPB1.22, RPB1.23, SA2.NO2
/OUT2: A.D1.9, A.R9.2, A.R10.1, B.C1.1, B.R1.1, SA1.1-1
/OUT4: B.D1.9, B.R9.2, B.R10.1, C.C1.1, C.R1.1, SA1.1-2, VJ3.3.1
/OUT6: C.D1.9, C.R9.2, C.R10.1, D.C1.1, D.R1.1, SA1.1-3, SA1.2-3, VJ6.1.1, VJ6.2.1
/OUT8: D.D1.9, D.R9.2, D.R10.1, E.C1.1, E.R1.1, SA1.2-4, VJ2.2.1
/OUT10: E.D1.9, E.R9.2, E.R10.1, F.C1.1, F.R1.1, SA1.1-5
/OUT12: F.D1.9, F.R9.2, F.R10.1, SA1.1-6
/OUT-CIR: OM.C1.2, OM.R1.2, SB1.NO1, VJ7.2.1, VJ8.2.1, VTC4.1
/OUT-CON: SB1.COM1, XS3.T
/WET: FB.C1.1, RPB2.33, SA1.COM1, SA1.COM2, VJ2.1.1
COM: A.D1.6, A.R5.2, A.R10.2, B.D1.6, B.R5.2, B.R10.2, C.D1.6, C.R5.2, C.R10.2, D.D1.6, D.R5.2, D.R10.2, E.D1.6, E.R5.2, E.R10.2, F.D1.6, F.R5.2, F.R10.2, IO.D1.4, L.C1.1, L.D1.4, L.R3.1, L.R7.1, MS.R2.1, OM.R1.1, PS.C1.-, PS.C2.2, PS.C3.-, PS.R2.1, R2.1, R3.1, R4.1, RPB1.31, SB1.COM3, VMH1.0, VMH2.0, VMH3.0, VMH4.0, X1.1, X2.1, X3.1, XS1.C, XS1.SN, XS2.R/TN, XS2.S, XS3.S
unnamed: A.C1.2, A.D1.5, A.D1.7
unnamed: A.C2.1, A.D1.8, A.R4.2, A.R5.1, A.R6.1
unnamed: A.C2.2, A.D1.10, A.D1.12
unnamed: A.D1.1, A.R3.2
unnamed: A.D1.4, A.R1.2, A.R2.1, A.R4.1
unnamed: A.D1.16, A.R8.2
unnamed: B.C1.2, B.D1.5, B.D1.7
unnamed: B.C2.1, B.D1.8, B.R4.2, B.R5.1, B.R6.1
unnamed: B.C2.2, B.D1.10, B.D1.12
unnamed: B.D1.1, B.R3.2
unnamed: B.D1.4, B.R1.2, B.R2.1, B.R4.1
unnamed: B.D1.13, B.R6.2, B.R7.1, B.R9.1
unnamed: B.D1.16, B.R8.2
unnamed: C.C1.2, C.D1.5, C.D1.7
unnamed: C.C2.1, C.D1.8, C.R4.2, C.R5.1, C.R6.1
unnamed: C.C2.2, C.D1.10, C.D1.12
unnamed: C.D1.1, C.R3.2
unnamed: C.D1.4, C.R1.2, C.R2.1, C.R4.1
unnamed: C.D1.13, C.R6.2, C.R7.1, C.R9.1
unnamed: C.D1.16, C.R8.2
unnamed: D.C1.2, D.D1.5, D.D1.7
unnamed: D.C2.1, D.D1.8, D.R4.2, D.R5.1, D.R6.1
unnamed: D.C2.2, D.D1.10, D.D1.12
unnamed: D.D1.1, D.R3.2
unnamed: D.D1.4, D.R1.2, D.R2.1, D.R4.1
unnamed: D.D1.13, D.R6.2, D.R7.1, D.R9.1
unnamed: D.D1.16, D.R8.2
unnamed: E.C1.2, E.D1.5, E.D1.7
unnamed: E.C2.1, E.D1.8, E.R4.2, E.R5.1, E.R6.1
unnamed: E.C2.2, E.D1.10, E.D1.12
unnamed: E.D1.1, E.R3.2
unnamed: E.D1.4, E.R1.2, E.R2.1, E.R4.1
unnamed: E.D1.13, E.R6.2, E.R7.1, E.R9.1
unnamed: E.D1.16, E.R8.2
unnamed: F.C1.2, F.D1.5, F.D1.7
unnamed: F.C2.1, F.D1.8, F.R4.2, F.R5.1, F.R6.1
unnamed: F.C2.2, F.D1.10, F.D1.12
unnamed: F.D1.1, F.R3.2
unnamed: F.D1.4, F.R1.2, F.R2.1, F.R4.1
unnamed: F.D1.13, F.R6.2, F.R7.1, F.R9.1
unnamed: F.D1.16, F.R8.2
unnamed: FB.C1.2, RPB1.33, VJ7.1.1
unnamed: FB.C2.1, RPB1.32, VJ8.1.1
unnamed: FB.C2.2, FB.R1.1
unnamed: HL1.C, R1.2
unnamed: HL2.C, R2.2
unnamed: HL3.C, R3.2
unnamed: HL4.C, R4.2
unnamed: IB.C1.1, IB.R1.2
unnamed: IB.C1.2, IB.R2.2, IO.D1.2, VJ1.2.1, VJ3.2.1, VTC2.1
unnamed: IO.D1.6, RPB2.11, RPB2.32
unnamed: IO.D1.7, OM.C1.1, RPB2.12, RPB2.13
unnamed: L.C1.2, L.D1.2, L.R2.1
unnamed: L.C2.+, L.D1.6, L.R5.2, L.R8.1
unnamed: L.D1.1, L.R4.2, L.R5.1, RPB1.13
unnamed: L.D1.3, L.R1.2, L.R3.2, L.R4.1
unnamed: L.D1.5, L.R6.2, L.R7.2
unnamed: L.R2.2, RPB1.11, RPB1.12
unnamed: MS.R2.2, MS.R3.1, RPB1.21
unnamed: PS.VD1.A, XS1.S
unnamed: SB1.NC1, SB1.NC2
V: A.D1.11, B.D1.11, C.D1.11, D.D1.11, E.D1.11, F.D1.11, HL1.A, IO.D1.8, L.D1.8, L.R1.1, L.R6.1, MS.R1.2, PS.C1.+, PS.C2.1, PS.R1.2, PS.VD1.C, SA2.COM1, SA3.COM1, SA3.NC1
VREF: A.D1.3, A.D1.14, A.R2.2, A.R7.2, B.D1.3, B.D1.14, B.R2.2, B.R7.2, C.D1.3, C.D1.14, C.R2.2, C.R7.2, D.D1.3, D.D1.14, D.R2.2, D.R7.2, E.D1.3, E.D1.14, E.R2.2, E.R7.2, F.D1.3, F.D1.14, F.R2.2, F.R7.2, IB.R2.1, IO.D1.5, PS.C3.+, PS.R1.1, PS.R2.2
