Adept666/stompboxes/PCBS-PCAS/ТКП-3.24.B/ТКП-1.24.B-4/ТКП-1.24.B-4.kicad_pcb

## KiCad design PCBS-PCAS/ТКП-3.24.B/ТКП-1.24.B-4/ТКП-1.24.B-4.kicad_pcb (2025-01-02)

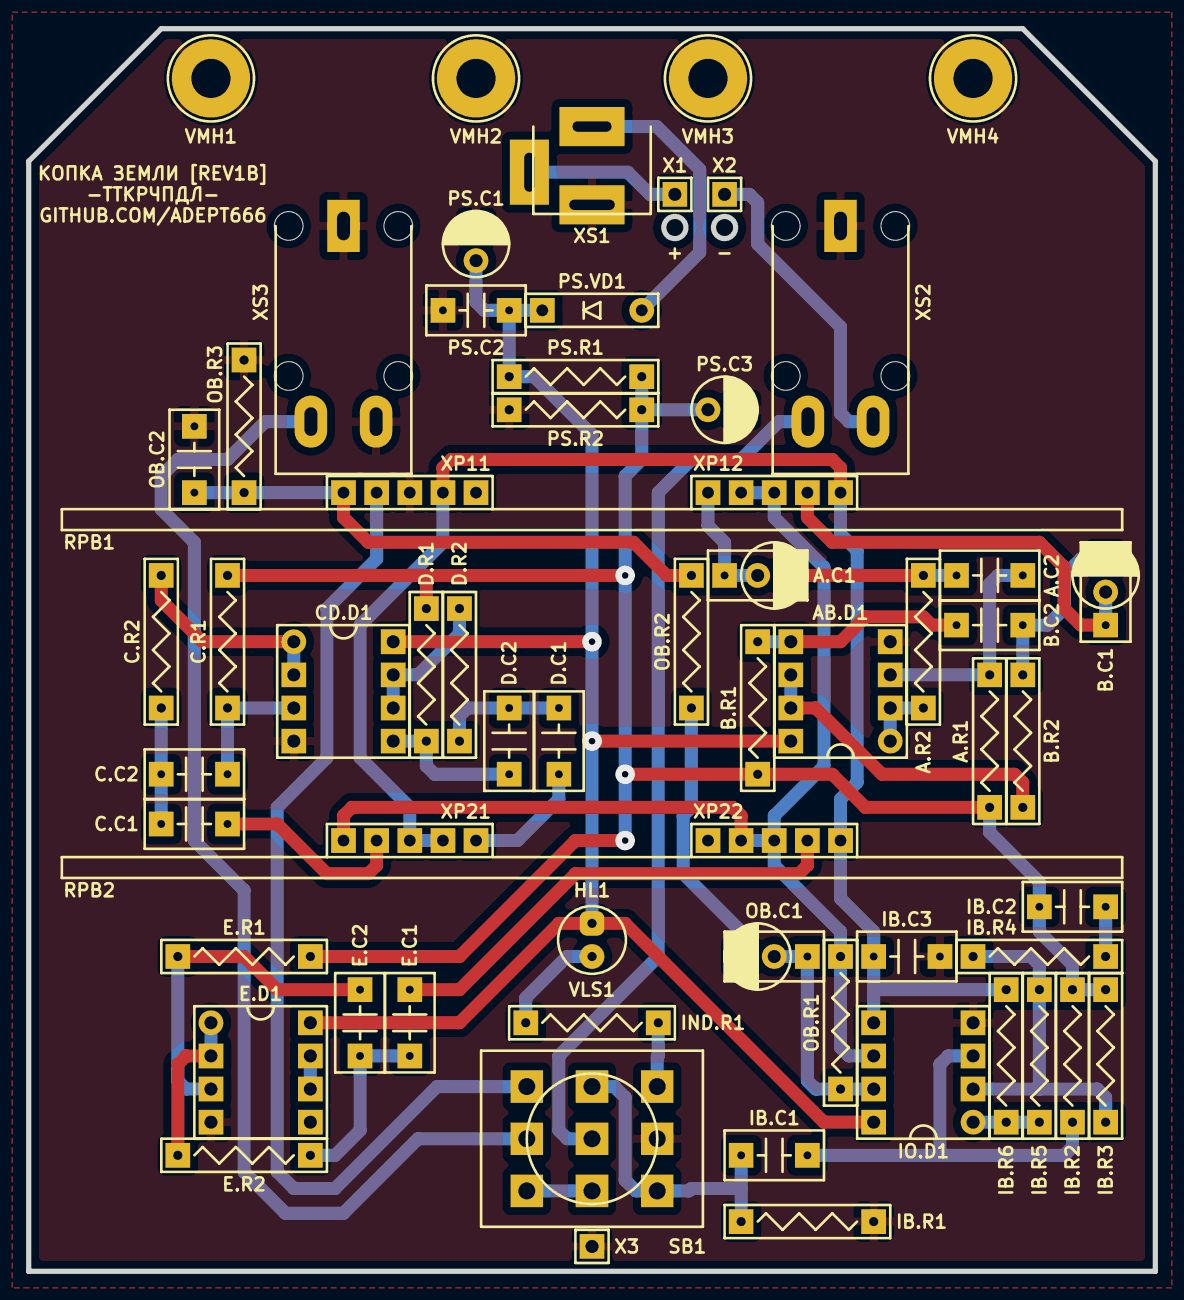
[picture p142: board ТКП-1.24.B-4.kicad_pcb from above]

Board: 2 copper layers, 86.4 x 95.3 mm, 63 parts (0 on the bottom side), 43 nets.

Parts:
A.C1: 105; C-DISK-D04.2-T03.0-P05.08-d0.5-OR-CP-RADIAL-D05.0-P02.0-CLS
A.C2: 473; C-DISK-D04.2-T03.0-P05.08-d0.5
A.R1: 104; R-MFR-25
A.R2: 471; R-MFR-25
AB.D1: 4558; P-DIP-08
B.C1: 105; C-DISK-D04.2-T03.0-P05.08-d0.5-OR-CP-RADIAL-D05.0-P02.0-CLS
B.C2: 682; C-DISK-D04.2-T03.0-P05.08-d0.5
B.R1: 124; R-MFR-25
B.R2: 471; R-MFR-25
C.C1: 224; C-DISK-D04.2-T03.0-P05.08-d0.5
C.C2: 472; C-DISK-D04.2-T03.0-P05.08-d0.5
C.R1: 124; R-MFR-25
C.R2: 511; R-MFR-25
CD.D1: 4558; P-DIP-08
D.C1: 333; C-DISK-D04.2-T03.0-P05.08-d0.5
D.C2: 332; C-DISK-D04.2-T03.0-P05.08-d0.5
D.R1: 104; R-MFR-25
D.R2: 821; R-MFR-25
E.C1: 223; C-DISK-D04.2-T03.0-P05.08-d0.5
E.C2: 681; C-DISK-D04.2-T03.0-P05.08-d0.5
E.D1: 4558; P-DIP-08
E.R1: 124; R-MFR-25
E.R2: 511; R-MFR-25
GB1: X; B-PP3-HV
HL1: FYL-5013UWC; LED-ROUND-05.0-UNI-SH-SPACER-PNL-5.3
IB.C1, IB.C2: 103; C-DISK-D04.2-T03.0-P05.08-d0.5
IB.C3: 151; C-DISK-D04.2-T03.0-P05.08-d0.5
IB.R1: 225; R-MFR-25
IB.R2: 474; R-MFR-25
IB.R3, IB.R5, IB.R6: 103; R-MFR-25
IB.R4: 102; R-MFR-25
IND.R1: 103; R-MFR-25
IO.D1: 4558; P-DIP-08
OB.C1: 105; C-DISK-D04.2-T03.0-P05.08-d0.5-OR-CP-RADIAL-D05.0-P02.0-CLS
OB.C2: 103; C-DISK-D04.2-T03.0-P05.08-d0.5
OB.R1, OB.R2, OB.R3: 103; R-MFR-25
PS.C1: 107; CP-RADIAL-D05.0-P02.0-CLS
PS.C2: 104; C-DISK-D04.2-T03.0-P05.08-d0.5
PS.C3: 476; CP-RADIAL-D05.0-P02.0-CLS
PS.R1, PS.R2: 473; R-MFR-25
PS.VD1: 5817; P-DO-41
RPB1, RPB2: B50K-B50K-B50K; RPB-1590BB-18-3x17-1.6-PNL-7.2
SB1: PBS-24-302SP; SW-PBS-24-302SP-2.5-PNL-12.0
VE1: ТКП-6.1.1.A1.A1.A.1-1; ТКП-6.1.1.A1.A1.A
VE2: ТКП-6.1.3.A1.C1.2-1.B1.D1; ТКП-6.1.3.A1
VLS1: BR-17.8; VLS-BR
VMH1, VMH2, VMH3, VMH4: DI5M3x20; VMH-STA-DA5-PNL-3.0
X1, X2: X; CON-PAD-S-1.0-1.9
X3: COM; CON-PAD-S-1.0-1.9
XS1: DC-005; CON-DC-005
XS2, XS3: PJ-309; CON-ST-008X-04

Connections:
/BOOST-RAIL: IO.D1.6, OB.R1.1, RPB1.23, RPB1.33, RPB2.13, RPB2.23, RPB2.33
/CUT-RAIL: IB.C3.1, IB.R6.2, IO.D1.5, RPB1.21, RPB1.31, RPB2.11, RPB2.21, RPB2.31
/IN-CIR: IB.C1.1, IB.R1.2, SB1.NC3, SB1.NO2
/IN-CON: SB1.COM2, XS2.T
/LED: IND.R1.1, SB1.NO3
/OUT-CIR: RPB1.12, SB1.NO1
/OUT-CON: SB1.COM1, XS3.T
/PP3-NEG: X2.1, XS2.R
/PP3-POS: X1.1, XS1.SN
COM: AB.D1.4, CD.D1.4, E.D1.4, IB.C3.2, IB.R1.1, IO.D1.4, OB.C2.2, OB.R3.1, PS.C1.-, PS.C2.2, PS.C3.-, PS.R2.1, RPB1.11, SB1.COM3, VMH1.0, VMH2.0, VMH3.0, VMH4.0, X3.1, XS1.C, XS2.S, XS3.R, XS3.S
unnamed: A.C1.+, RPB1.22
unnamed: A.C1.-, A.C2.1, A.R2.1
unnamed: A.C2.2, A.R1.2, AB.D1.3
unnamed: A.R2.2, AB.D1.1, AB.D1.2
unnamed: AB.D1.5, B.C2.2, B.R1.2
unnamed: AB.D1.6, AB.D1.7, B.R2.2
unnamed: B.C1.+, RPB1.32
unnamed: B.C1.-, B.C2.1, B.R2.1
unnamed: C.C1.1, RPB2.12
unnamed: C.C1.2, C.C2.1, C.R2.1
unnamed: C.C2.2, C.R1.2, CD.D1.3
unnamed: C.R2.2, CD.D1.1, CD.D1.2
unnamed: CD.D1.5, D.C2.2, D.R1.2
unnamed: CD.D1.6, CD.D1.7, D.R2.2
unnamed: D.C1.1, RPB2.22
unnamed: D.C1.2, D.C2.1, D.R2.1
unnamed: E.C1.1, RPB2.32
unnamed: E.C1.2, E.C2.1, E.R2.1
unnamed: E.C2.2, E.D1.3, E.R1.2
unnamed: E.D1.1, E.D1.2, E.R2.2
unnamed: E.D1.6, E.D1.7
unnamed: HL1.C, IND.R1.2
unnamed: IB.C1.2, IB.R2.2, IO.D1.3
unnamed: IB.C2.2, IB.R4.1
unnamed: IB.R3.2, IB.R4.2, IB.R5.1, IO.D1.2
unnamed: IB.R5.2, IB.R6.1, IO.D1.1
unnamed: IO.D1.7, OB.C1.+, OB.R1.2
unnamed: OB.C1.-, OB.R2.1
unnamed: OB.C2.1, OB.R2.2, OB.R3.2, RPB1.13
unnamed: PS.VD1.A, XS1.S
unnamed: SB1.NC1, SB1.NC2
V: AB.D1.8, CD.D1.8, E.D1.8, HL1.A, IO.D1.8, PS.C1.+, PS.C2.1, PS.R1.2, PS.VD1.C
VREF: A.R1.1, B.R1.1, C.R1.1, D.R1.1, E.R1.1, IB.C2.1, IB.R2.1, IB.R3.1, PS.C3.+, PS.R1.1, PS.R2.2
