Adept666/stompboxes/PCBS-PCAS/ТКП-3.19.B/ТКП-1.19.B-1/ТКП-1.19.B-1.kicad_pcb

## KiCad design PCBS-PCAS/ТКП-3.19.B/ТКП-1.19.B-1/ТКП-1.19.B-1.kicad_pcb (2025-01-02)

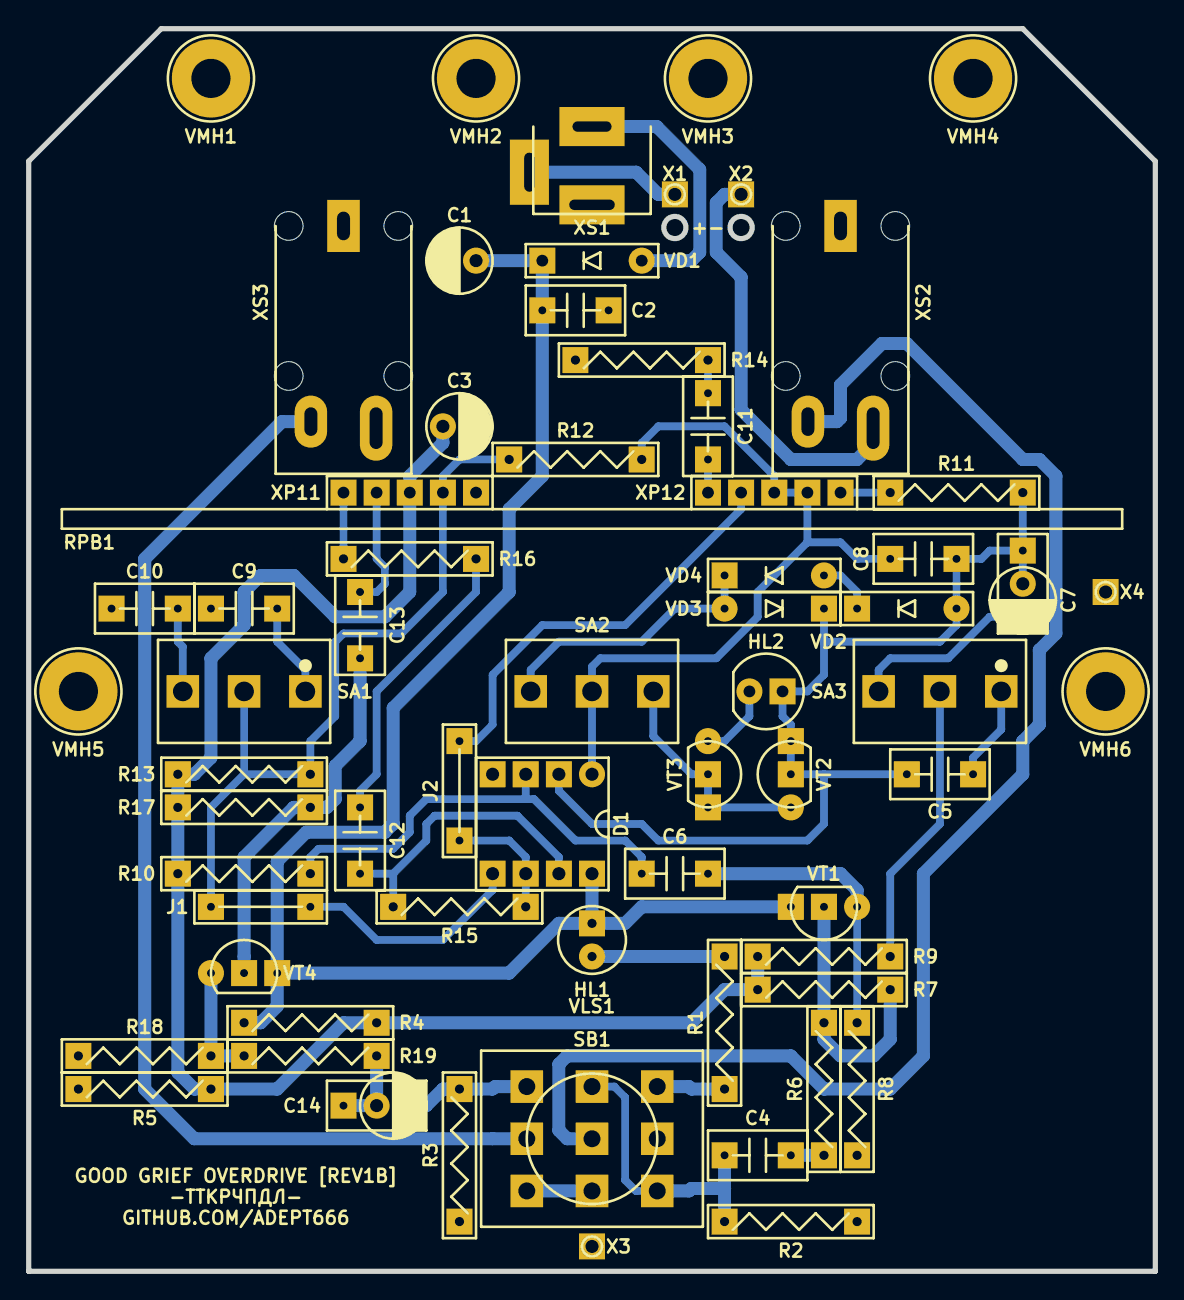
[picture p143: board ТКП-1.19.B-1.kicad_pcb from above]

Board: 2 copper layers, 86.4 x 95.3 mm, 67 parts (0 on the bottom side), 40 nets.

Parts:
C1, C3: 476; CP-RADIAL-D05.0-P02.0-CLS
C2, C4, C13: 104; C-DISK-D04.2-T03.0-P05.08-d0.5
C5: 224; C-DISK-D04.2-T03.0-P05.08-d0.5
C6, C12: 105; C-DISK-D04.2-T03.0-P05.08-d0.5
C7, C14: 106; C-DISK-D04.2-T03.0-P05.08-d0.5-OR-CP-RADIAL-D05.0-P02.0-CLS
C8: 470; C-DISK-D04.2-T03.0-P05.08-d0.5
C9: 154; C-DISK-D04.2-T03.0-P05.08-d0.5
C10: 683; C-DISK-D04.2-T03.0-P05.08-d0.5
C11: 334; C-DISK-D04.2-T03.0-P05.08-d0.5
D1: 4558; P-DIP-08
GB1: PP3; B-PP3-HV
HL1: FYL-5013URC; LED-ROUND-05.0-UNI-SH-SPACER-PNL-5.3
HL2: FYL-5013URC; LED-ROUND-05.0-UNI-BH
J1, J2: 0.5; J-TH-d0.5-P07.62
R1: 472; R-MFR-25
R2: 105; R-MFR-25
R3, R4, R5, R8, R13, R18: 103; R-MFR-25
R6, R9, R12, R15, R16: 102; R-MFR-25
R7, R17: 564; R-MFR-25
R10, R11: 223; R-MFR-25
R14: 331; R-MFR-25
R19: 101; R-MFR-25
RPB1: B100K-B5K-A500K; RPB-1590BB-18-3x17-1.5-PNL-7.4-2.8
SA1, SA3: MTS-102-A2; SW-MTS-102-A2-2.5-PNL-6.0
SA2: MTS-103-A2; SW-MTS-103-A2-2.5-PNL-6.0
SB1: PBS-24-302SP; SW-PBS-24-302SP-2.5-PNL-13.0
VD1: 5817; P-DO-41
VD2, VD3, VD4: 4148; P-DO-35
VE1: 1590BB; 1590BB_B1
VLS1: BR-12.7; VLS-BR
VMH1, VMH2, VMH3, VMH4, VMH5, VMH6: DI5M3x18; VMH-STA-DA5-PNL-3.0
VT1, VT4: MPSA18; P-TO-92-E-B-C
VT2, VT3: 7000; P-TO-92-S-G-D
X1: +; CON-PAD-S-1.0-2.0
X2: -; CON-PAD-S-1.0-2.0
X3, X4: COM; CON-PAD-S-1.0-2.0
XS1: DC-005; CON-DC-005
XS2: ST-008S-04; CON-ST-008X-04-OR-ST-008X-05
XS3: ST-008S-05; CON-ST-008X-04-OR-ST-008X-05

Connections:
/IN-CIR: C4.1, R2.2, SB1.NC3, SB1.NO2
/IN-CON: SB1.COM2, XS2.T
/LED: R1.1, SB1.NO3
/OUT-CIR: C14.-, R3.2, SB1.NO1
/OUT-CON: SB1.COM1, XS3.T
/PP3-NEG: X2.1, XS2.R/TN
/PP3-POS: X1.1, XS1.SN
/RP21: D1.5, J1.J, R12.2, R13.1, RPB1.21, SA1.COM
/RP23: D1.6, J2.J, R15.1, RPB1.23
COM: C1.-, C2.2, C3.-, C9.2, C10.2, D1.4, R2.1, R3.1, R5.1, R8.1, R14.1, R18.1, SB1.COM3, VMH1.0, VMH2.0, VMH3.0, VMH4.0, VMH5.0, VMH6.0, X3.1, X4.1, XS1.C, XS2.S, XS3.S
unnamed: C4.2, R6.1
unnamed: C5.1, C7.+, C8.1, D1.2, HL2.A, R11.1, VD2.A, VD3.C, VT2.D, VT2.G
unnamed: C5.2, SA3.NC
unnamed: C6.1, R8.2, VT1.E
unnamed: C6.2, D1.3, R10.2
unnamed: C7.-, SA3.NO
unnamed: C8.2, D1.1, R12.1, RPB1.32, RPB1.33, SA2.COM
unnamed: C9.1, SA1.NC
unnamed: C10.1, SA1.NO
unnamed: C11.1, RPB1.22
unnamed: C11.2, R14.2
unnamed: C12.1, D1.7, R15.2
unnamed: C12.2, R16.1
unnamed: C13.1, RPB1.12
unnamed: C13.2, R17.2, VT4.B
unnamed: C14.+, R19.2
unnamed: HL1.C, R1.2
unnamed: HL2.C, VT3.S
unnamed: R6.2, R7.2, VT1.B
unnamed: R9.2, SA3.COM
unnamed: R11.2, RPB1.31
unnamed: R16.2, RPB1.13
unnamed: R18.2, R19.1, VT4.E
unnamed: SA2.NO_1, VT2.S, VT3.D, VT3.G
unnamed: SA2.NO_2, VD3.A, VD4.C
unnamed: SB1.NC1, SB1.NC2
unnamed: VD1.A, XS1.S
unnamed: VD2.C, VD4.A
V: C1.+, C2.1, D1.8, HL1.A, R4.2, VD1.C, VT1.C, VT4.C
VREF: C3.+, R4.1, R5.2, R7.1, R9.1, R10.1, R13.2, R17.1, RPB1.11
