Adept666/stompboxes/PCBS-PCAS/ТКП-3.25.A/ТКП-1.25.A-1/ТКП-1.25.A-1.kicad_pcb

## KiCad design PCBS-PCAS/ТКП-3.25.A/ТКП-1.25.A-1/ТКП-1.25.A-1.kicad_pcb (2024-12-16)

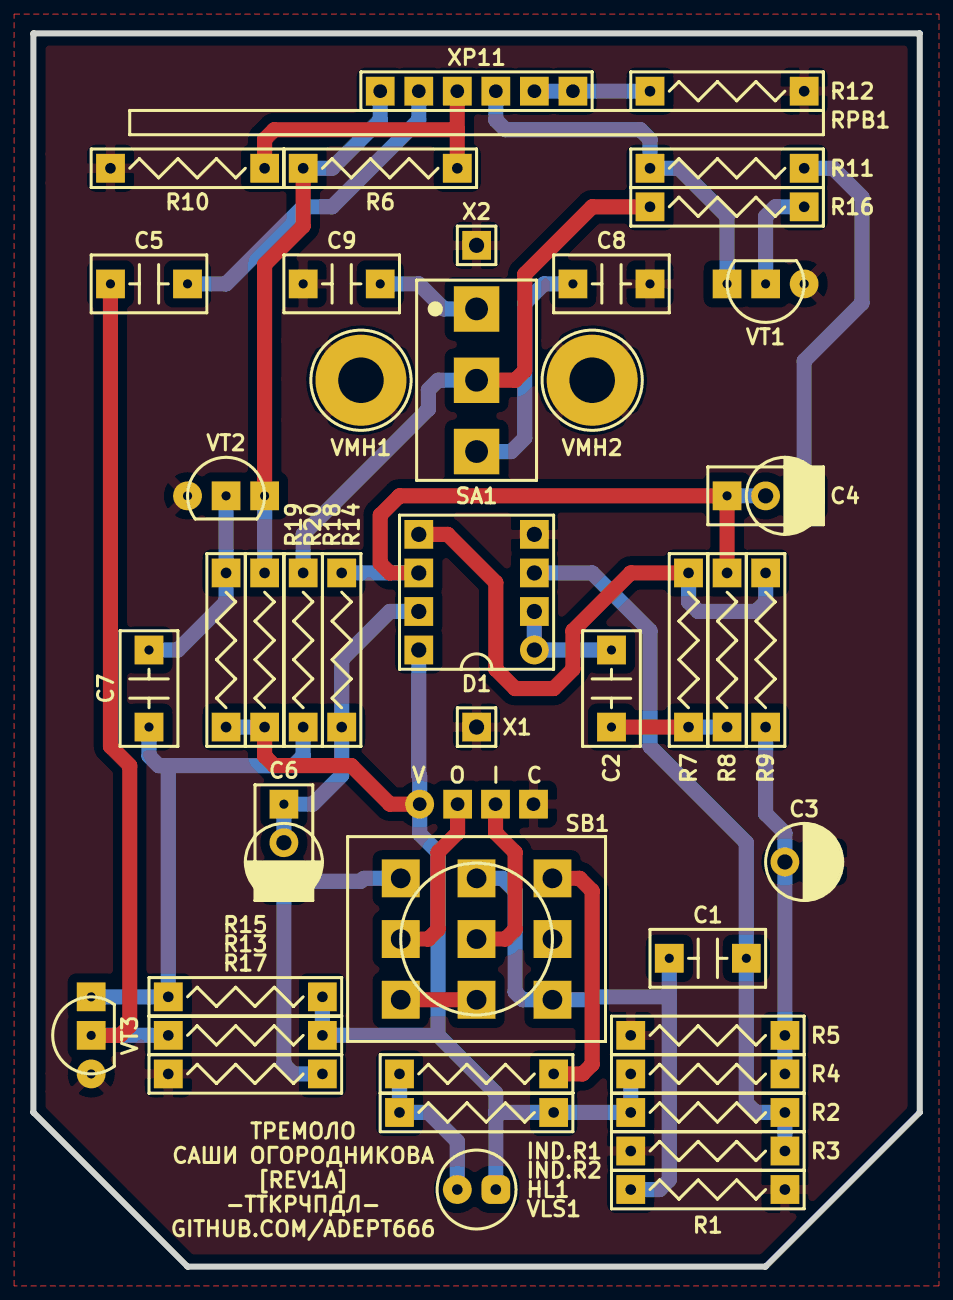
[picture p144: board ТКП-1.25.A-1.kicad_pcb from above]

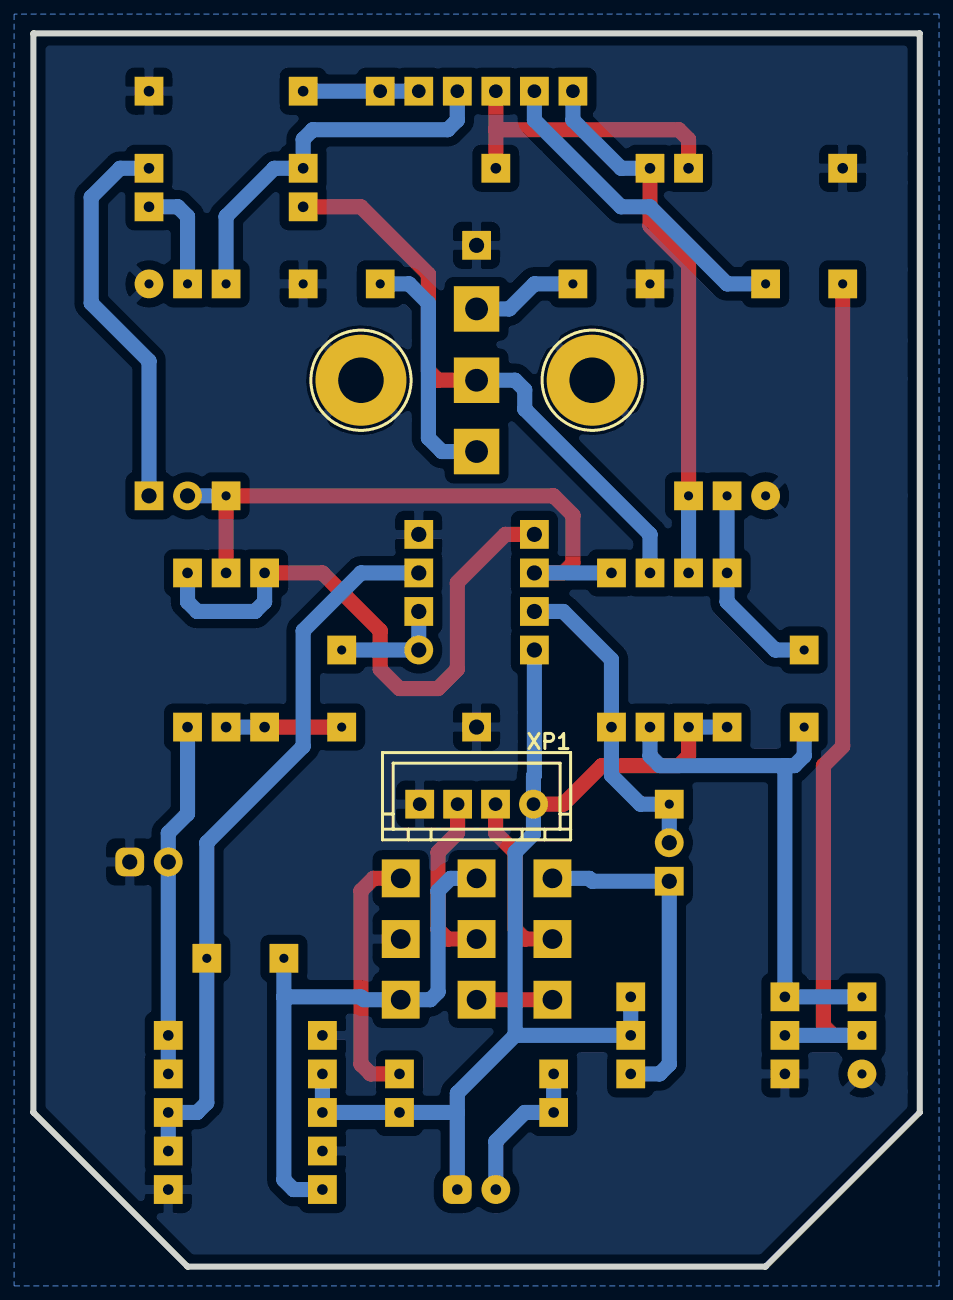
[picture p145: board ТКП-1.25.A-1.kicad_pcb from below]

Board: 2 copper layers, 58.4 x 81.3 mm, 61 parts (14 on the bottom side), 29 nets.

Parts:
C1, C2: 104; C-DISK-D04.2-T03.0-P05.08-d0.5
C3: 226; CP-RADIAL-D05.0-P02.0-CLS
C4: 475; C-DISK-D04.2-T03.0-P05.08-d0.5-OR-CP-RADIAL-D05.0-P02.0-CLS
C5, C7: 474; C-DISK-D04.2-T03.0-P05.08-d0.5
C6: 105; C-DISK-D04.2-T03.0-P05.08-d0.5-OR-CP-RADIAL-D05.0-P02.0-CLS
C8: 224; C-DISK-D04.2-T03.0-P05.08-d0.5
C9: 223; C-DISK-D04.2-T03.0-P05.08-d0.5
D1: 4558; P-DIP-08
HL1: FYL-5013URC; LED-ROUND-05.0-UNI-SH-SPACER-PNL-5.3
IND.R1: 472; R-MFR-25
IND.R2: X; R-MFR-25
R1, R13: 225; R-MFR-25
R2, R3: 105; R-MFR-25
R4: 273; R-MFR-25
R5, R8: 303; R-MFR-25
R6: 683; R-MFR-25
R7, R15, R17, R20: 473; R-MFR-25
R9: 393; R-MFR-25
R10: 112; R-MFR-25
R11, R12: 103; R-MFR-25
R14: 333; R-MFR-25
R16, R18: 204; R-MFR-25
R19: 334; R-MFR-25
RPB1: A100K-A100K; RPB-1590N1-18-2x17-1.6-PNL-7.4-2.8
SA1: MTS-102-A2; SW-MTS-102-A2-3.0-PNL-6.0
SB1: PBS-24-302SP; SW-PBS-24-302SP-2.5-PNL-13.0
VE1: 1590N1; 1590N1_A1
VJ1.1, VJ1.2, VJ2.1, VJ2.2, VJ3.1, VJ3.2, VJ4.1, VJ4.2, VJ4.3: BOTTOM; VJ
VLS1: BR-12.7; VLS-BR
VMH1, VMH2: DI5M3x18; VMH-STA-DA5-PNL-3.0
VT1, VT2, VT3: 5088; P-TO-92-E-B-C
VTC1, VTC3, VTC4, VTC5: BOTTOM; VTC
VTC2: TOP; VTC
X1, X2: COM; CON-PAD-S-1.0-1.9
XB1: 1590N1 Connector Board; XB-1590N1
XP1: B4B-XH-A; CON-XH-B4B-A

Connections:
/IN-CIR: C1.1, R1.2, SB1.NC3, SB1.NO2
/IN-CON: SB1.COM2, XP1.3
/LED: IND.R1.1, SB1.NO3
/OUT-CIR: C6.-, R17.2, SB1.NO1
/OUT-CON: SB1.COM1, XP1.2
COM: C3.-, C8.2, C9.2, D1.4, R1.1, R3.1, R5.1, R10.1, R12.1, R17.1, SB1.COM3, VMH1.0, VMH2.0, VT1.E, VT2.E, VT3.E, X1.1, X2.1, XP1.4
unnamed: C1.2, D1.3, R2.1, R3.2
unnamed: C2.1, D1.1, D1.2
unnamed: C2.2, R7.1, R8.1
unnamed: C3.+, R4.1, R5.2, R9.1
unnamed: C4.+, D1.6, R8.2, R14.1
unnamed: C4.-, R11.2
unnamed: C5.1, RPB1.12
unnamed: C5.2, R13.1, VT3.B
unnamed: C6.+, D1.7, R14.2
unnamed: C7.1, R15.1, R18.1, VT3.C
unnamed: C7.2, R19.1, VT2.B
unnamed: C8.1, SA1.NO
unnamed: C9.1, SA1.NC
unnamed: D1.5, R7.2, R9.2
unnamed: HL1.C, IND.R1.2, IND.R2.1
unnamed: R6.1, R10.2, RPB1.11, VJ1.2.1, VJ2.1.1, VTC2.1
unnamed: R11.1, RPB1.23, VJ3.1.1, VJ4.1.1, VT1.C, VTC3.1
unnamed: R12.2, RPB1.21, RPB1.22, VJ3.2.1, VJ4.2.1, VJ4.3.1, VTC4.1, VTC5.1
unnamed: R16.1, VT1.B
unnamed: R16.2, R18.2, SA1.COM
unnamed: R6.2, R20.1, RPB1.13, VJ1.1.1, VJ2.2.1, VT2.C, VTC1.1
unnamed: SB1.NC1, SB1.NC2
V: D1.8, HL1.A, IND.R2.2, R2.2, R4.2, R13.2, R15.2, R19.2, R20.2, XP1.1
