Adept666/stompboxes/1590BB_potentiometer_board_18_3x17_dual-single-single_r1a/1590BB_potentiometer_board_18_3x17_dual-single-single_r1a.sch

## KiCad design 1590BB_potentiometer_board_18_3x17_dual-single-single_r1a/1590BB_potentiometer_board_18_3x17_dual-single-single_r1a.sch (2022-07-16)

Schematic: 1590BB_potentiometer_board_18_3x17_dual-single-single_r1a.sch

Parts:
RP1: RP1: DUAL 16/17; RP-PDB182-K-20-P
RP2: RP2: 16/17; RP-PDB181-K-20-P
RP3: RP3: 16/17; RP-PDB181-K-20-P
XS1, XS2: PBS-06R; CON-PBS-06R
