Adept666/stompboxes/1590N1_connector_board_r1/1590N1_connector_board_r1.sch

## KiCad design 1590N1_connector_board_r1/1590N1_connector_board_r1.sch (2022-01-01)

Schematic: 1590N1_connector_board_r1.sch

Parts:
C1: 107; CP-RADIAL-D05.0-P02.0-CLS; Tolerance 20%; Voltage 16 В
C2: 104; C-DISK-D04.2-T03.0-P05.08-d0.5; Tolerance 10%; Voltage 50 В
C3: 104; C-SM-1206; Tolerance 10%; Voltage 50 В
GB1: PP3; B-PP3-HV; Voltage 9 В
J1: J1; J-SB-1206-2
J2: J2; J-SB-1206-2
J3: J3; J-SB-1206-2
J4: J4; J-SB-1206-2
R1: 330; R-SM-1206; Tolerance 1%
VD1: 5817; P-DO-41
X1: +; CON-PAD-S-1.0-1.9
X2: -; CON-PAD-S-1.0-1.9
XP1: B4B-XH-A; CON-XH-B4B-A
XS1: DC-005; CON-DC-005-9V-OVAL
XS2: PJ-651A-01; CON-PJ-651A-01-IN-OVAL
XS3: PJ-651A-01; CON-PJ-651A-01-OUT-OVAL
