Adept666/stompboxes/1590N1_potentiometer_board_18_2x17_r1a/1590N1_potentiometer_board_18_2x17_r1a.sch

## KiCad design 1590N1_potentiometer_board_18_2x17_r1a/1590N1_potentiometer_board_18_2x17_r1a.sch (2022-07-16)

Schematic: 1590N1_potentiometer_board_18_2x17_r1a.sch

Parts:
RP1: RP1: 16/17; RP-PDB181-K-20-P
RP2: RP2: 16/17; RP-PDB181-K-20-P
XS1: PBS-06R; CON-PBS-06R
