Adept666/stompboxes/1590N1_potentiometer_board_18_2x17_r1c/1590N1_potentiometer_board_18_2x17_r1c.sch

## KiCad design 1590N1_potentiometer_board_18_2x17_r1c/1590N1_potentiometer_board_18_2x17_r1c.sch (2023-03-19)

Schematic: 1590N1_potentiometer_board_18_2x17_r1c.sch

Parts:
RP1: RP1: 16/17; RP-PDB181-K-20-P-CIRCULAR
RP1.R12, RP1.R13, RP1.R23, RP2.R12, RP2.R13, RP2.R23: X; R-SM-1206
RP2: RP2: 16/17; RP-PDB181-K-20-P-CIRCULAR
XS1: PBS-06R; CON-PBS-06R-CIRCULAR
