Adept666/stompboxes/1590N1_potentiometer_board_18_3x17_r1/1590N1_potentiometer_board_18_3x17_r1.sch

## KiCad design 1590N1_potentiometer_board_18_3x17_r1/1590N1_potentiometer_board_18_3x17_r1.sch (2022-01-01)

Schematic: 1590N1_potentiometer_board_18_3x17_r1.sch

Parts:
RP1: RP1: 16/17; RP-PDB181-K-20-P-CIRCULAR
RP2: RP2: 16/17; RP-PDB181-K-20-P-CIRCULAR
RP3: RP3: 16/17; RP-PDB181-K-20-P-CIRCULAR
XS1, XS2, XS3: PBS-03R; CON-PBS-03R-CIRCULAR
