Adept666/stompboxes/crumbwave_multiplexer_r1a/crumbwave_multiplexer_r1a.sch

## KiCad design crumbwave_multiplexer_r1a/crumbwave_multiplexer_r1a.sch (2023-05-11)

Schematic: crumbwave_multiplexer_r1a.sch

Parts:
C1: 336; CP-RADIAL-D05.0-P02.0-CLS; Tolerance 20%; Voltage 16 В
C2, C5, C6, C9, C10, C18, C19: 104; C-DISK-D04.2-T03.0-P05.08-d0.5; Tolerance 10%; Voltage 50 В
C3, C4, C8, C13, C15, C16, C17: 223; C-DISK-D04.2-T03.0-P05.08-d0.5; Tolerance 10%; Voltage 50 В
C7: 477; CP-RADIAL-D08.0-P03.5-d0.6; Tolerance 20%; Voltage 16 В
C11, C12: 154; C-DISK-D04.2-T03.0-P05.08-d0.5; Tolerance 10%; Voltage 50 В
C14: 473; C-DISK-D04.2-T03.0-P05.08-d0.5; Tolerance 10%; Voltage 50 В
D1: 324; P-DIP-14
D2, D3: 4558; P-DIP-08
D4: 4013; P-DIP-14
HL1: FYL-5013URC; LED-ROUND-05.0-UNI-SH-SPACER-PNL-5.3
IND.R1: 472; R-MFR-25; Tolerance 1%
R1, R10, R11, R12, R16, R22: 103; R-MFR-25; Tolerance 1%
R2, R14, R25, R27: 104; R-MFR-25; Tolerance 1%
R3, R19: 183; R-MFR-25; Tolerance 1%
R4, R13, R23, R24: 153; R-MFR-25; Tolerance 1%
R5: 334; R-MFR-25; Tolerance 1%
R6: 471; R-MFR-25; Tolerance 1%
R7: 184; R-MFR-25; Tolerance 1%
R8, R9, R15: 273; R-MFR-25; Tolerance 1%
R17, R18: 472; R-MFR-25; Tolerance 1%
R20, R21: 473; R-MFR-25; Tolerance 1%
R26: 681; R-MFR-25; Tolerance 1%
R28, R31: 225; R-MFR-25; Tolerance 1%
R29: 154; R-MFR-25; Tolerance 1%
R32: 102; R-MFR-25; Tolerance 1%
RPB1: A100K-B100K-B100K; RPB-1590BB2-18-3x17-1.6-PNL-7.4-2.8
SA1: MTS-202-A2; SW-MTS-202-A2-2.5-PNL-6.0
SB1: PBS-24-302SP; SW-PBS-24-302SP-2.5-PNL-13.0
VD1, VD2, VD3: 4148; P-SOD-123-OR-DO-35-V1
VE1: 1590BB2; 1590BB2_A1
VLS1: BR-12.7; VLS-BR
VMH1, VMH2: DI5M3x18; VMH-STA-DA5-PNL-3.0
VT1: 5457; P-SOT-23-D-S-G-OR-TO-92-D-S-G
X1, X2: COM; CON-PAD-S-1.0-1.9
XB1: 1590BB2 Connector Board Extended; XB-1590BB2-EXTENDED
XP1: B4B-XH-A; CON-XH-B4B-A
