Adept666/stompboxes/deep_blue_delay_r3/deep_blue_delay_r3.sch

## KiCad design deep_blue_delay_r3/deep_blue_delay_r3.sch (2021-05-09)

Schematic: deep_blue_delay_r3.sch

Parts:
C1: 107; CP-RADIAL-D05.0-P02.0-CLS; Tolerance 20%; Voltage 16 В
C2, C5, C12, C13: 104; C-SM-0805; Tolerance 10%; Voltage 50 В
C3, C4, C6: 476; CP-RADIAL-D05.0-P02.0-CLS; Tolerance 20%; Voltage 16 В
C7, C8: 104; C-SM-0603; Tolerance 10%; Voltage 16 В
C9, C19: 223; C-SM-1206; Tolerance 10%; Voltage 50 В
C10, C11: 222; C-SM-0805; Tolerance 10%; Voltage 50 В
C14: 470; C-SM-0805; Tolerance 5%; Voltage 50 В
C15, C22, C23: 105; C-SM-1206; Tolerance 10%; Voltage 50 В
C16: 153; C-SM-1206; Tolerance 10%; Voltage 50 В
C17: 105; C-DISK-D04.2-T03.0-P05.08-d0.5; Tolerance 10%; Voltage 50 В
C18: 472; C-SM-0805; Tolerance 10%; Voltage 50 В
C20: 101; C-SM-0805; Tolerance 5%; Voltage 50 В
C21: 473; C-SM-0805; Tolerance 5%; Voltage 100 В
C24: 103; C-SM-1206; Tolerance 10%; Voltage 50 В
D1: 78L05; P-TO-92-OUT-GND-IN
D2: 8970; P-SO-16W
D3: 5532; P-SO-08
GB1: PP3; B-PP3-HV; Voltage 9 В
HL1: FYL-5013UWC; LED-ROUND-05.0-UNI-SH-SPACER
R1, R4, R5, R10, R11, R13, R14: 103; R-SM-0805; Tolerance 1%
R2: 105; R-MFR-12; Tolerance 1%
R3: 104; R-MFR-12; Tolerance 1%
R6: 330; R-SM-0805; Tolerance 1%
R7: 272; R-SM-1206; Tolerance 1%
R8: 184; R-SM-0805; Tolerance 1%
R9: 364; R-SM-0805; Tolerance 5%
R12, R17: 203; R-SM-1206; Tolerance 1%
R15: 103; R-MFR-12; Tolerance 5%
R16: 223; R-SM-0805; Tolerance 1%
R18: 512; R-SM-1206; Tolerance 1%
R19, R22: 102; R-SM-1206; Tolerance 1%
R20: 123; R-SM-0805; Tolerance 1%
R21: 202; R-SM-1206; Tolerance 1%
RP1, RP2, RP3: B50K; RP-PDB181-K-F-PCB-RND
SB1: PBS-24-302SP; SW-PBS-24-302SP
VD1: 5817; P-DO-41
VE1: B013; B013_deep_blue_delay_r3a
VLS1: BR-17.8; VLS-BR
VMH1, VMH2: DI5M3x20; VMH-STA-DA5
X1: +; CON-PAD-S-1.0-2.0
X2: -; CON-PAD-S-1.0-2.0
X3: COM; CON-PAD-S-1.0-2.0
XS1: DC-005; CON-DC-005
XS2, XS3: PJ-644C; CON-PJ-644C
