Adept666/stompboxes/distortion_+_r2/distortion_+_r2.sch

## KiCad design distortion_+_r2/distortion_+_r2.sch (2021-05-09)

Schematic: distortion_+_r2.sch

Parts:
C1: 107; CP-RADIAL-D05.0-P02.0-d0.5-L11-HU; Tolerance 20%; Voltage 16 В
C2: 104; C-DISK-D04.2-T03.0-P05.08-d0.5; Tolerance 10%; Voltage 50 В
C3, C7: 105; C-DISK-D04.2-T03.0-P05.08-d0.5; Tolerance 10%; Voltage 50 В
C4, C8: 102; C-DISK-D04.2-T03.0-P05.08-d0.5; Tolerance 5%; Voltage 50 В
C5: 103; C-DISK-D04.2-T03.0-P05.08-d0.5; Tolerance 10%; Voltage 50 В
C6: 473; C-DISK-D04.2-T03.0-P05.08-d0.5; Tolerance 10%; Voltage 50 В
D1: 741; P-DIP-08
GB1: PP3; B-PP3-HV; Voltage 9 В
HL1: FYL-5013UWC; LED-ROUND-05.0-UNI-SH-SPACER
R1: 103; R-MFR-12; Tolerance 5%
R2: 105; R-MFR-12; Tolerance 1%
R3, R4, R7, R8: 105; R-MFR-25; Tolerance 5%
R5, R9: 103; R-MFR-25; Tolerance 1%
R6: 472; R-MFR-25; Tolerance 5%
RP1: A10K; RP-PDB181-K-F-PCB
RP2: C1M; RP-PDB181-K-F-PCB
SB1: PBS-24-302SP; SW-PBS-24-302SP
VD1: 400x; P-DO-41
VD2, VD3: 34A; P-DO-7
VE1: B013; B013_distortion_+_r2a
VLS1: BR-17.8; VLS-BR
X1: +; CON-PAD-S-1.0-2.0
X2: -; CON-PAD-S-1.0-2.0
X3: COM; CON-PAD-S-1.0-2.0
XP1: 722RA; CON-(L)7X2RA(H)
XS1: NYS215; CON-NYS-215
XS2: NYS2152; CON-NYS-2152
