Adept666/stompboxes/edamamer_r1a/edamamer_r1a.sch

## KiCad design edamamer_r1a/edamamer_r1a.sch (2023-03-05)

Schematic: edamamer_r1a.sch

Parts:
C1: 223; C-DISK-D04.2-T03.0-P05.08-d0.5; Tolerance 10%; Voltage 50 В
C2: 336; CP-RADIAL-D05.0-P02.0-CLS; Tolerance 20%; Voltage 16 В
C3, C6: 471; C-DISK-D04.2-T03.0-P05.08-d0.5; Tolerance 10%; Voltage 50 В
C4, C5, C8: 472; C-DISK-D04.2-T03.0-P05.08-d0.5; Tolerance 10%; Voltage 50 В
C7, C9: 103; C-DISK-D04.2-T03.0-P05.08-d0.5; Tolerance 10%; Voltage 50 В
C10, C11: 332; C-DISK-D04.2-T03.0-P05.08-d0.5; Tolerance 10%; Voltage 50 В
HL1: FYL-5013URC; LED-ROUND-05.0-UNI-SH-SPACER-PNL-5.3
IND.R1: 472; R-MFR-25; Tolerance 1%
IND.R2: X; R-MFR-25; Tolerance 1%
PS.C1, PS.C2: 105; C-DISK-D04.2-T03.0-P05.08-d0.5-OR-CP-RADIAL-D05.0-P02.0-CLS; Tolerance К10-Э20%; Voltage 50 В
PS.D1: 7660S; P-DIP-08
PS.VD1, PS.VD2: 400x; P-DO-41
R1, R2: 105; R-MFR-25; Tolerance 1%
R3: 152; R-MFR-25; Tolerance 1%
R4, R7: 474; R-MFR-25; Tolerance 1%
R5: 272; R-MFR-25; Tolerance 1%
R6: 124; R-MFR-25; Tolerance 1%
R8: 221; R-MFR-25; Tolerance 1%
R9, R10: 123; R-MFR-25; Tolerance 1%
RP1, RP2: 100K; RP-3296W
RP3: 50K; RP-3296W
RPB1: A100K-A500K-A500K; RPB-1590N1-18-3x17-1.6-PNL-7.4-2.8
SA1: MTS-102-A2; SW-MTS-102-A2-3.0-PNL-6.0
SB1: PBS-24-302SP; SW-PBS-24-302SP-2.5-PNL-13.0
VE1: 1590N1; 1590N1_A1
VLS1: BR-12.7; VLS-BR
VMH1, VMH2: DI5M3x18; VMH-STA-DA5-PNL-3.0
VT1, VT2: J201; P-SOT-23-D-S-G-OR-TO-92-D-S-G
VT3: 5457; P-SOT-23-D-S-G-OR-TO-92-D-S-G
X1, X2: COM; CON-PAD-S-1.0-1.9
XB1: 1590N1 Connector Board; XB-1590N1
XP1: B4B-XH-A; CON-XH-B4B-A
