Adept666/stompboxes/fuzz_factory_r1b_r1b/fuzz_factory_r1b_r1b.sch

## KiCad design fuzz_factory_r1b_r1b/fuzz_factory_r1b_r1b.sch (2022-01-08)

Schematic: fuzz_factory_r1b_r1b.sch

Parts:
C1: 107; CP-RADIAL-D05.0-P02.0-CLS; Tolerance 20%; Voltage 16 В
C2, C4: 104; C-DISK-D04.2-T03.0-P05.08-d0.5; Tolerance 10%; Voltage 50 В
C3, C5, C6: 106; CP-RADIAL-D05.0-P02.0-CLS; Tolerance 20%; Voltage 16 В
GB1: PP3; B-PP3-HV; Voltage 9 В
HL1: FYL-5013UWC; LED-ROUND-05.0-UNI-SH-SPACER-PNL-5.3
R1: 103; R-MFR-12; Tolerance 5%
R2: 105; R-MFR-12; Tolerance 1%
R3: 224; R-MFR-12; Tolerance 5%
R4: 224; R-MFR-25; Tolerance 1%
R5: 103; R-MFR-25; Tolerance 1%
R6: 471; R-MFR-25; Tolerance 1%
R7: 473; R-MFR-25; Tolerance 1%
R8: 512; R-MFR-25; Tolerance 1%
RP1, RP5: B5K; RP-RK1233N1-L15-KC
RP2, RP3, RP4: B10K; RP-RK1233N1-L15-KC
SB1: PBS-24-302SP; SW-PBS-24-302SP
VD1: 5817; P-DO-41
VE1: B013; B013_C1
VLS1: BR-17.8; VLS-BR
VT1: 3904; P-TO-92-E-B-C
VT2, VT3: МП40; P-КТЮ-3-6
X1: +; CON-PAD-S-1.0-2.0
X2: -; CON-PAD-S-1.0-2.0
X3: COM; CON-PAD-S-1.0-2.0
XP11, XP12, XP13, XP14: PLS-03; CON-PLS-03
XS1: DC-005; CON-DC-005
XS2, XS3: PJ-644C; CON-PJ-644C
XS11, XS12, XS13, XS14: PBS-03R; CON-PBS-03R

Notes on the sheet:
1. XP11...14: PLS-03. 2. XS11...14: PBS-03R.
