Adept666/stompboxes/good_grief_overdrive_r1a/good_grief_overdrive_r1a.sch

## KiCad design good_grief_overdrive_r1a/good_grief_overdrive_r1a.sch (2022-03-20)

Schematic: good_grief_overdrive_r1a.sch

Parts:
C1, C3: 476; CP-RADIAL-D05.0-P02.0-CLS; Tolerance 20%; Voltage 16 В
C2, C4, C13: 104; C-DISK-D04.2-T03.0-P05.08-d0.5; Tolerance 10%; Voltage 50 В
C5: 224; C-DISK-D04.2-T03.0-P05.08-d0.5; Tolerance 10%; Voltage 50 В
C6, C12: 105; C-DISK-D04.2-T03.0-P05.08-d0.5; Tolerance 10%; Voltage 50 В
C7, C14: 106; CP-RADIAL-D05.0-P02.0-CLS; Tolerance 20%; Voltage 16 В
C8: 470; C-DISK-D04.2-T03.0-P05.08-d0.5; Tolerance 5%; Voltage 50 В
C9: 154; C-DISK-D04.2-T03.0-P05.08-d0.5; Tolerance 10%; Voltage 50 В
C10: 683; C-DISK-D04.2-T03.0-P05.08-d0.5; Tolerance 20%; Voltage 50 В
C11: 334; C-DISK-D04.2-T03.0-P05.08-d0.5; Tolerance 10%; Voltage 50 В
D1: 833; P-DIP-08
GB1: PP3; B-PP3-HV; Voltage 9 В
HL1: FYL-5013UWC; LED-ROUND-05.0-UNI-SH-SPACER-PNL-5.3
HL2: FYL-5013URC; LED-ROUND-05.0-UNI-SH-SPACER-PNL-5.3
J1: 0.6; J-TH-d0.6-P05.08
J2, J3: 0.5; J-TH-d0.5-P07.62
R1, R3, R4, R5, R8, R13, R18: 103; R-MFR-25; Tolerance 1%
R2: 105; R-MFR-25; Tolerance 5%
R6, R9, R12, R15, R16: 102; R-MFR-25; Tolerance 1%
R7, R17: 564; R-MFR-25; Tolerance 1%
R10, R11: 223; R-MFR-25; Tolerance 5%
R14: 331; R-MFR-25; Tolerance 1%
R19: 101; R-MFR-25; Tolerance 1%
RPB1: B100K-B5K-A500K; RPB-1590BB-18-3x17-1.5-PNL-7.4-2.6
SA1, SA3: MTS-102-A2; SW-MTS-102-A2-2.5-PNL-6.4
SA2: MTS-103-A2; SW-MTS-103-A2-2.5-PNL-6.4
SB1: PBS-24-302SP; SW-PBS-24-302SP-2.5-PNL-13.0
VD1: 5817; P-DO-41
VD2, VD3, VD4: 4148; P-DO-35
VE1: 1590BB; 1590BB_A1
VLS1, VLS2: BR-12.7; VLS-BR
VMH1, VMH2, VMH3, VMH4, VMH5, VMH6: DI5M3x18; VMH-STA-DA5-PNL-3.0
VT1, VT4: MPSA18; P-TO-92-E-B-C
VT2, VT3: 7000; P-TO-92-S-G-D
X1: +; CON-PAD-S-1.0-2.0
X2: -; CON-PAD-S-1.0-2.0
X3, X4: COM; CON-PAD-S-1.0-2.0
XS1: DC-005; CON-DC-005
XS2: ST-008S-04; CON-ST-008X-04
XS3: ST-008S-05; CON-ST-008X-05
