Adept666/stompboxes/little_angel_chorus_r1/little_angel_chorus_r1.sch

## KiCad design little_angel_chorus_r1/little_angel_chorus_r1.sch (2021-05-09)

Schematic: little_angel_chorus_r1.sch

Parts:
C1: 107; CP-RADIAL-D05.0-P02.0-d0.5-L11-HU; Tolerance 20%; Voltage 16 В
C2, C5, C11, C12: 104; C-DISK-D04.2-T03.0-P05.08-d0.5; Tolerance 10%; Voltage 50 В
C3, C4, C8: 476; CP-AXIAL-D06-L13-d0.6; Tolerance 20%; Voltage 16 В
C6, C15, C16: 103; C-RECT-L07.3-W02.5-P05.08-d0.5; Tolerance 10%; Voltage 250 В
C7: 106; CP-RADIAL-D05.0-P02.0-d0.5-L11-HD; Tolerance 20%; Voltage 16 В
C9, C10: 106; CP-RADIAL-D05.0-P02.0-d0.5-L11-HU; Tolerance 20%; Voltage 16 В
C13: 332; C-RECT-L07.3-W02.5-P05.08-d0.5; Tolerance 5%; Voltage 400 В
C14: 102; C-RECT-L07.3-W02.5-P05.08-d0.5; Tolerance 5%; Voltage 100 В
C17, C18, C19, C20: 104; C-RECT-L07.3-W02.5-P05.08-d0.5; Tolerance 10%; Voltage 63 В
D1: 78L05; P-TO-92-OUT-GND-IN
D2: 5532; P-SO-08
D3: 2399; P-DIP-16
GB1: PP3; B-PP3-HV; Voltage 9 В
HL1: FYL-5013UWC; LED-ROUND-05.0-UNI-SH-SPACER
R1: 103; R-MFR-12; Tolerance 5%
R2.1: 105; R-MFR-12; Tolerance 1%
R2.2, R24: 105; R-SM-1206; Tolerance 1%
R3.1: 104; R-MFR-12; Tolerance 1%
R3.2, R6: 104; R-SM-1206; Tolerance 1%
R4, R5, R15, R16, R17, R18, R19, R20, R21, R25: 103; R-SM-1206; Tolerance 1%
R7: 473; R-SM-1206; Tolerance 1%
R8, R11: 224; R-SM-1206; Tolerance 1%
R9: 683; R-SM-1206; Tolerance 1%
R10: 472; R-SM-1206; Tolerance 1%
R12: 101; R-SM-1206; Tolerance 1%
R13: 222; R-SM-1206; Tolerance 1%
R14: 333; R-SM-1206; Tolerance 1%
R22: 474; R-SM-1206; Tolerance 1%
R23: 334; R-SM-1206; Tolerance 1%
RP1, RP2: B50K; RP-RK1233N1-KC-PCB
SA1, SA2: KN3-1; SW-KN3-1-PCB
SB1: PBS-24-302SP; SW-PBS-24-302SP
VD1.1: 400x; P-DO-41
VD1.2: 4001; P-SOD-87
VD2: 5817; P-DO-41
VD3: 4148; P-DO-35
VE1: G0473; G0473_little_angel_chorus_r1a
VLS1: BR-17.8; VLS-BR
VT1: 3904; P-TO-92-C-B-E
X1: +; CON-PAD-S-1.0-2.0
X2: -; CON-PAD-S-1.0-2.0
X3: COM; CON-PAD-S-1.0-2.0
XP1: 722RA; CON-(L)7X2RA(H)
XS1: NYS215; CON-NYS-215
XS2: NYS2152; CON-NYS-2152
