Adept666/stompboxes/potentiometer_board_18_1x17_r1a/potentiometer_board_18_1x17_r1a.sch

## KiCad design potentiometer_board_18_1x17_r1a/potentiometer_board_18_1x17_r1a.sch (2022-07-30)

Schematic: potentiometer_board_18_1x17_r1a.sch

Parts:
J1: J1; J-SB-0805-2
J2: J2; J-SB-0805-2
RP1: 16/17; RP-PDB181-K-20-P-CIRCULAR
XS1: PBS-05R; CON-PBS-05R-CIRCULAR
