Adept666/stompboxes/potentiometer_board_20_1x17_r1a/potentiometer_board_20_1x17_r1a.sch

## KiCad design potentiometer_board_20_1x17_r1a/potentiometer_board_20_1x17_r1a.sch (2022-07-16)

Schematic: potentiometer_board_20_1x17_r1a.sch

Parts:
RP1: 16/17; RP-PDB181-K-20-P
XS1: PBS-05R; CON-PBS-05R
