Adept666/stompboxes/тремоло_саши_огородникова_r1a/тремоло_саши_огородникова_r1a.sch

## KiCad design тремоло_саши_огородникова_r1a/тремоло_саши_огородникова_r1a.sch (2023-03-05)

Schematic: тремоло_саши_огородникова_r1a.sch

Parts:
C1, C2: 104; C-DISK-D04.2-T03.0-P05.08-d0.5; Tolerance 10%; Voltage 50 В
C3: 226; CP-RADIAL-D05.0-P02.0-CLS; Tolerance 20%; Voltage 16 В
C4: 475; C-DISK-D04.2-T03.0-P05.08-d0.5-OR-CP-RADIAL-D05.0-P02.0-CLS; Tolerance К10-Э20%; Voltage 50 В
C5, C7: 474; C-DISK-D04.2-T03.0-P05.08-d0.5; Tolerance 10%; Voltage 50 В
C6: 105; C-DISK-D04.2-T03.0-P05.08-d0.5-OR-CP-RADIAL-D05.0-P02.0-CLS; Tolerance К10-Э20%; Voltage 50 В
C8: 224; C-DISK-D04.2-T03.0-P05.08-d0.5; Tolerance 10%; Voltage 50 В
C9: 223; C-DISK-D04.2-T03.0-P05.08-d0.5; Tolerance 10%; Voltage 50 В
D1: 4558; P-DIP-08
HL1: FYL-5013URC; LED-ROUND-05.0-UNI-SH-SPACER-PNL-5.3
IND.R1: 472; R-MFR-25; Tolerance 1%
IND.R2: X; R-MFR-25; Tolerance 1%
R1, R13: 225; R-MFR-25; Tolerance 1%
R2, R3: 105; R-MFR-25; Tolerance 1%
R4: 273; R-MFR-25; Tolerance 1%
R5, R8: 303; R-MFR-25; Tolerance 1%
R6: 683; R-MFR-25; Tolerance 1%
R7, R15, R17, R20: 473; R-MFR-25; Tolerance 1%
R9: 393; R-MFR-25; Tolerance 1%
R10: 112; R-MFR-25; Tolerance 1%
R11, R12: 103; R-MFR-25; Tolerance 1%
R14: 333; R-MFR-25; Tolerance 1%
R16, R18: 204; R-MFR-25; Tolerance 1%
R19: 334; R-MFR-25; Tolerance 1%
RPB1: A100K-A100K; RPB-1590N1-18-2x17-1.6-PNL-7.4-2.8
SA1: MTS-102-A2; SW-MTS-102-A2-3.0-PNL-6.0
SB1: PBS-24-302SP; SW-PBS-24-302SP-2.5-PNL-13.0
VE1: 1590N1; 1590N1_A1
VLS1: BR-12.7; VLS-BR
VMH1, VMH2: DI5M3x18; VMH-STA-DA5-PNL-3.0
VT1, VT2, VT3: 5088; P-TO-92-E-B-C
X1, X2: COM; CON-PAD-S-1.0-1.9
XB1: 1590N1 Connector Board; XB-1590N1
XP1: B4B-XH-A; CON-XH-B4B-A
