Adept666/stompboxes/big_muff_r2a/bass/big_muff_r2a_bass.sch

## KiCad design big_muff_r2a/bass/big_muff_r2a_bass.sch (2022-07-21)

Schematic: big_muff_r2a_bass.sch

Parts:
C1: 106; CP-RADIAL-D05.0-P02.0-CLS; Tolerance 20%; Voltage 16 В
C2, C5, C6, C9, C15: 104; C-DISK-D04.2-T03.0-P05.08-d0.5; Tolerance 10%; Voltage 50 В
C3, C14: 105; C-DISK-D04.2-T03.0-P05.08-d0.5; Tolerance 10%; Voltage 50 В
C4, C8, C11: 471; C-SM-1206; Tolerance 5%; Voltage 50 В
C7, C10: 683; C-DISK-D04.2-T03.0-P05.08-d0.5; Tolerance +80-20%; Voltage 50 В
C12: 332; C-DISK-D04.2-T03.0-P05.08-d0.5; Tolerance 10%; Voltage 50 В
C13: 103; C-DISK-D04.2-T03.0-P05.08-d0.5; Tolerance 10%; Voltage 50 В
GB1: PP3; B-PP3-HV; Voltage 9 В
HL1: FYL-5013UWC; LED-ROUND-05.0-UNI-SH-SPACER-PNL-5.3
R1: 103; R-MFR-12; Tolerance 5%
R2: 105; R-MFR-12; Tolerance 1%
R3: X; R-MFR-12; Tolerance 1%
R4: 393; R-SM-1206; Tolerance 1%
R5, R11, R16, R23: 104; R-SM-1206; Tolerance 1%
R6, R12, R17, R22: 474; R-SM-1206; Tolerance 1%
R7, R13, R18: 123; R-SM-1206; Tolerance 1%
R8, R14, R19: 391; R-SM-1206; Tolerance 1%
R9: 102; R-SM-1206; Tolerance 1%
R10, R15, R24: 103; R-SM-1206; Tolerance 1%
R20, R21: 223; R-SM-1206; Tolerance 1%
R25: 272; R-SM-1206; Tolerance 1%
RP1, RP3: A100K; RPB-20-1x17-1.5-PNL-7.4-2.8
RP2: B100K; RPB-20-1x17-1.5-PNL-7.4-2.8
SB1: PBS-24-302SP; SW-PBS-24-302SP
VD1: 5817; P-DO-41
VD2, VD3, VD4, VD5: 4148; P-DO-35
VE1: B013; B013_B1
VLS1: BR-17.8; VLS-BR
VT1, VT2, VT3, VT4: 547; P-TO-92-E-B-C
X1: +; CON-PAD-S-1.0-2.0
X2: -; CON-PAD-S-1.0-2.0
X3: COM; CON-PAD-S-1.0-2.0
XP1: DC-005S; CON-DC-005S
XS1, XS2: PJ-644C; CON-PJ-644C
