Adept666/stompboxes/PCBS-PCAS/ТКП-3.18.A/ТКП-1.18.A-1/ТКП-1.18.A-1.sch

## KiCad design PCBS-PCAS/ТКП-3.18.A/ТКП-1.18.A-1/ТКП-1.18.A-1.sch (2024-05-19)

Schematic: ТКП-1.18.A-1.sch

Parts:
RP1: B50K; RP-PDB181-K-20-P
XS1: PBS-05R; CON-PBS-05R
