Adept666/stompboxes/PCBS-PCAS/ТКП-3.20.A/ТКП-1.20.A-2/ТКП-1.20.A-2.sch

## KiCad design PCBS-PCAS/ТКП-3.20.A/ТКП-1.20.A-2/ТКП-1.20.A-2.sch (2023-12-09)

Schematic: ТКП-1.20.A-2.sch

Parts:
RP1: RP1: B50K; RP-PDB181-K-20-P
RP2: RP2: B50K; RP-PDB181-K-20-P
RP3: RP3: B50K; RP-PDB181-K-20-P
XS1, XS2: PBS-05R; CON-PBS-05R
