Adept666/stompboxes/PCBS-PCAS/ТКП-3.20.A/ТКП-1.20.A-3/ТКП-1.20.A-3.sch

## KiCad design PCBS-PCAS/ТКП-3.20.A/ТКП-1.20.A-3/ТКП-1.20.A-3.sch (2023-12-09)

Schematic: ТКП-1.20.A-3.sch

Parts:
RP1: RP1: B500K; RP-PDB181-K-20-P
RP2: RP2: A1K; RP-PDB181-K-20-P
RP3: RP3: B100K; RP-PDB181-K-20-P
XS1, XS2: PBS-05R; CON-PBS-05R
