Adept666/stompboxes/PCBS-PCAS/ТКП-3.22.A/ТКП-1.22.A-1/ТКП-1.22.A-1.sch

## KiCad design PCBS-PCAS/ТКП-3.22.A/ТКП-1.22.A-1/ТКП-1.22.A-1.sch (2024-10-09)

Schematic: ТКП-1.22.A-1.sch

Parts:
RP1: RP1: B100K; RP-PDB182-K-20-P
RP2: RP2: B10K; RP-PDB181-K-20-P
RP3: RP3: B10K; RP-PDB181-K-20-P
XS1, XS2: PBS-06R; CON-PBS-06R
