Adept666/stompboxes/PCBS-PCAS/ТКП-3.24.A/ТКП-1.24.A-2/ТКП-1.24.A-2.sch

## KiCad design PCBS-PCAS/ТКП-3.24.A/ТКП-1.24.A-2/ТКП-1.24.A-2.sch (2024-06-20)

Schematic: ТКП-1.24.A-2.sch

Parts:
A.C1: 105; C-DISK-D04.2-T03.0-P05.08-d0.5-OR-CP-RADIAL-D05.0-P02.0-CLS; Tolerance К10-Э20%; Voltage 50 В
A.C2: 473; C-DISK-D04.2-T03.0-P05.08-d0.5; Tolerance 10%; Voltage 50 В
A.R1: 104; R-MFR-25; Tolerance 1%
A.R2: 471; R-MFR-25; Tolerance 1%
AB.D1: 4558; P-DIP-08
B.C1: 105; C-DISK-D04.2-T03.0-P05.08-d0.5-OR-CP-RADIAL-D05.0-P02.0-CLS; Tolerance К10-Э20%; Voltage 50 В
B.C2: 682; C-DISK-D04.2-T03.0-P05.08-d0.5; Tolerance 10%; Voltage 50 В
B.R1: 124; R-MFR-25; Tolerance 1%
B.R2: 471; R-MFR-25; Tolerance 1%
C.C1: 224; C-DISK-D04.2-T03.0-P05.08-d0.5; Tolerance 10%; Voltage 50 В
C.C2: 472; C-DISK-D04.2-T03.0-P05.08-d0.5; Tolerance 10%; Voltage 50 В
C.R1: 124; R-MFR-25; Tolerance 1%
C.R2: 511; R-MFR-25; Tolerance 1%
CD.D1: 4558; P-DIP-08
D.C1: 333; C-DISK-D04.2-T03.0-P05.08-d0.5; Tolerance 10%; Voltage 50 В
D.C2: 332; C-DISK-D04.2-T03.0-P05.08-d0.5; Tolerance 10%; Voltage 50 В
D.R1: 104; R-MFR-25; Tolerance 1%
D.R2: 821; R-MFR-25; Tolerance 1%
E.C1: 223; C-DISK-D04.2-T03.0-P05.08-d0.5; Tolerance 10%; Voltage 50 В
E.C2: 681; C-DISK-D04.2-T03.0-P05.08-d0.5; Tolerance 10%; Voltage 50 В
E.D1: 4558; P-DIP-08
E.R1: 124; R-MFR-25; Tolerance 1%
E.R2: 511; R-MFR-25; Tolerance 1%
GB1: PP3; B-PP3-HV; Voltage 9 В
HL1: FYL-5013UWC; LED-ROUND-05.0-UNI-SH-SPACER-PNL-5.3
IB.C1, IB.C2: 103; C-DISK-D04.2-T03.0-P05.08-d0.5; Tolerance 10%; Voltage 50 В
IB.C3: 151; C-DISK-D04.2-T03.0-P05.08-d0.5; Tolerance 20%; Voltage 50 В
IB.R1: 225; R-MFR-25; Tolerance 1%
IB.R2: 474; R-MFR-25; Tolerance 1%
IB.R3, IB.R5, IB.R6: 103; R-MFR-25; Tolerance 1%
IB.R4: 102; R-MFR-25; Tolerance 1%
IO.D1: 4558; P-DIP-08
OB.C1: 105; C-DISK-D04.2-T03.0-P05.08-d0.5-OR-CP-RADIAL-D05.0-P02.0-CLS; Tolerance К10-Э20%; Voltage 50 В
OB.C2: 103; C-DISK-D04.2-T03.0-P05.08-d0.5; Tolerance 10%; Voltage 50 В
OB.R1, OB.R2, OB.R3: 103; R-MFR-25; Tolerance 1%
PS.C1: 107; CP-RADIAL-D05.0-P02.0-CLS; Tolerance 20%; Voltage 16 В
PS.C2: 104; C-DISK-D04.2-T03.0-P05.08-d0.5; Tolerance 10%; Voltage 50 В
PS.C3: 476; CP-RADIAL-D05.0-P02.0-CLS; Tolerance 20%; Voltage 16 В
PS.R1, PS.R2: 473; R-MFR-25; Tolerance 1%
PS.VD1: 5817; P-DO-41
R1: 103; R-MFR-25; Tolerance 1%
R2: X; R-MFR-25
RPB1, RPB2: B50K-B50K-B50K; RPB-1590BB-18-3x17-1.5-PNL-7.4-2.8
SB1: PBS-24-302SP; SW-PBS-24-302SP-2.5-PNL-13.0
VE1: 1590BB; 1590BB_B1
VLS1: BR-12.7; VLS-BR
VMH1, VMH2, VMH3, VMH4: DI5M3x18; VMH-STA-DA5-PNL-3.0
X1: +; CON-PAD-S-1.0-1.9
X2: -; CON-PAD-S-1.0-1.9
X3: COM; CON-PAD-S-1.0-1.9
XS1: DC-005; CON-DC-005
XS2, XS3: PJ-309; CON-ST-008X-04

Notes on the sheet:
INPUT BUFFER
OUTPUT BUFFER
GYRATOR STAGES
ENCLOSURE
SIGNAL JACKS & BYPASS CONTROL
POWER SUPPLY
