Adept666/stompboxes/PCBS-PCAS/ТКП-3.27.B/ТКП-1.27.B-2/ТКП-1.27.B-2.sch

## KiCad design PCBS-PCAS/ТКП-3.27.B/ТКП-1.27.B-2/ТКП-1.27.B-2.sch (2023-11-13)

Schematic: ТКП-1.27.B-2.sch

Parts:
C1: 476; CP-RADIAL-D05.0-P02.0-CLS; Tolerance 20%; Voltage 16 В
C2: 476; CP-CTSMD-D; Tolerance 10%; Voltage 16 В
C3: 104; C-DISK-D04.2-T03.0-P05.08-d0.5; Tolerance 10%; Voltage 50 В
C4: 104; C-SM-1206; Tolerance 10%; Voltage 50 В
GB1: X; B-PP3-HV
J1: J1; J-SB-1206-2
J2: J2; J-SB-1206-2
J3: J3; J-SB-1206-2
J4: J4; J-SB-1206-2
R1: X; R-SM-1206
VD1: 5817; P-DO-41
X1, X2: X; CON-PAD-S-1.0-1.9
XP1: B4B-XH-A; CON-XH-B4B-A
XS1: DC-005; CON-DC-005-9V-OVAL
XS2: PJ-651A-01; CON-PJ-651A-01-IN-OVAL
XS3: PJ-651A-01; CON-PJ-651A-01-OUT-OVAL

Notes on the sheet:
1. Установить либо C1, либо C2. 2. Установить либо C3, либо C4. 3. J2 оставить разомкнутой. 4. J1, J3 и J4 замкнуть.
