Adept666/stompboxes/PCBS-PCAS/ТКП-3.29.A/ТКП-1.29.A-1/ТКП-1.29.A-1.sch

## KiCad design PCBS-PCAS/ТКП-3.29.A/ТКП-1.29.A-1/ТКП-1.29.A-1.sch (2023-12-20)

Schematic: ТКП-1.29.A-1.sch

Parts:
RP1: RP1: A100K; RP-PDB181-K-20-P-CIRCULAR
RP2: RP2: A500K; RP-PDB181-K-20-P-CIRCULAR
RP3: RP3: A500K; RP-PDB181-K-20-P-CIRCULAR
XS1, XS2, XS3: PBS-03R; CON-PBS-03R-CIRCULAR
