Adept666/stompboxes/PCBS-PCAS/ТКП-3.33.A/ТКП-1.33.A-1/ТКП-1.33.A-1.sch

## KiCad design PCBS-PCAS/ТКП-3.33.A/ТКП-1.33.A-1/ТКП-1.33.A-1.sch (2024-01-19)

Schematic: ТКП-1.33.A-1.sch

Parts:
RP1: RP1: A100K; RP-PDB181-K-20-P
RP2: RP2: B100K; RP-PDB181-K-20-P
RP3: RP3: B100K; RP-PDB181-K-20-P
XS1, XS2: PBS-05R; CON-PBS-05R
