Adept666/stompboxes/PCBS-PCAS/ТКП-3.41.A/ТКП-1.39.A-1/ТКП-1.39.A-1.sch

## KiCad design PCBS-PCAS/ТКП-3.41.A/ТКП-1.39.A-1/ТКП-1.39.A-1.sch (2024-03-02)

Schematic: ТКП-1.39.A-1.sch

Parts:
RP1: B500K; RP-PDB181-K-20-P-FIRST-CIRCULAR
RP1.R12, RP1.R13, RP1.R23, RP2.R12, RP2.R13, RP2.R23, RP3.R12, RP3.R13, RP3.R23: X; R-SM-1206
RP2: A1K; RP-PDB181-K-20-P-CENTRAL-CIRCULAR
RP3: B100K; RP-PDB181-K-20-P-LAST-CIRCULAR
XS1, XS2: PBS-05R; CON-PBS-05R-RPB
