Adept666/stompboxes/PCBS-PCAS/ТКП-3.41.A/ТКП-1.39.A-3/ТКП-1.39.A-3.sch

## KiCad design PCBS-PCAS/ТКП-3.41.A/ТКП-1.39.A-3/ТКП-1.39.A-3.sch (2024-06-15)

Schematic: ТКП-1.39.A-3.sch

Parts:
RP1: B50K; RP-PDB181-K-20-P-FIRST-CIRCULAR
RP1.R12, RP1.R13, RP1.R23, RP2.R12, RP2.R13, RP2.R23, RP3.R12, RP3.R13, RP3.R23: X; R-SM-1206
RP2: B50K; RP-PDB181-K-20-P-CENTRAL-CIRCULAR
RP3: B50K; RP-PDB181-K-20-P-LAST-CIRCULAR
XS1, XS2: PBS-05R; CON-PBS-05R-RPB
