Adept666/stompboxes/(commit log)

2020-06-28 Distortion + [REV2] and Little Angel Chorus [REV1] files were added
    [distortion_+_r2.kicad_pcb, distortion_+_r2.sch, little_angel_chorus_r1.kicad_pcb, little_angel_chorus_r1.sch]
2020-07-31 Distortion + [REV2]: potentiometers were changed
    [distortion_+_r2.sch]
2020-07-31 Little Angel Chorus [REV1]: potentiometers were changed
    [little_angel_chorus_r1.kicad_pcb, little_angel_chorus_r1.sch]
2020-07-31 Distortion + [REV2]: potentiometers' values were changed
    [distortion_+_r2.kicad_pcb, distortion_+_r2.sch]
2020-09-17 Little Angel Chorus [REV1]: the schematic was neatly redrawn
    [little_angel_chorus_r1.sch]
2020-09-17 Distortion + [REV2] and Little Angel Chorus [REV1]: the position of some designators and references was corrected
    [distortion_+_r2.kicad_pcb, little_angel_chorus_r1.kicad_pcb]
2020-10-07 Distortion + [REV2] and Little Angel Chorus [REV1]: output pdf files were added
    [distortion_+_r2.kicad_pcb, distortion_+_r2.sch, little_angel_chorus_r1.kicad_pcb, little_angel_chorus_r1.sch]
2020-10-08 Distortion + [REV2]: power symbols were changed
    [distortion_+_r2.kicad_pcb, distortion_+_r2.sch]
2020-10-08 Big Muff (NYC) [REV2] files were added
    [big_muff_r2.kicad_pcb, big_muff_r2.sch]
2020-10-08 Little Angel Chorus [REV1]: SM resistors' packages were specified
    [little_angel_chorus_r1.sch]
2020-10-09 Big Muff (NYC) [REV2]: minor changes
    [big_muff_r2.sch]
2020-10-10 Big Muff (NYC) [REV2] and Little Angel Chorus [REV1]: minor changes
    [big_muff_r2.sch, little_angel_chorus_r1.sch]
2020-11-07 Fuzz Factory [REV1] files were added
    [fuzz_factory_r1.kicad_pcb, fuzz_factory_r1.sch]
2020-11-12 Big Muff [REV2] (Bass) files were added
    [big_muff_r2_bass.kicad_pcb, big_muff_r2_bass.sch, big_muff_r2_nyc.kicad_pcb, big_muff_r2_nyc.sch]
2020-11-13 Big Muff [REV2] (Bass) and Fuzz Factory [REV1]: minor changes
    [big_muff_r2_bass.kicad_pcb, fuzz_factory_r1.sch]
2020-11-13 Little Angel Chorus [REV1]: technical requirements were added
    [little_angel_chorus_r1.kicad_pcb]
2021-01-16 SBKCL: potentiometer board footprints modified
2021-01-16 Deep Blue Delay [REV3] files added
    [deep_blue_delay_r3.kicad_pcb, deep_blue_delay_r3.sch, potentiometer_board_20_17_r1.kicad_pcb, potentiometer_board_20_17_r1.sch]
2021-04-03 Fuzz Factory [REV1]: minor changes
    [fuzz_factory_r1.kicad_pcb, fuzz_factory_r1.sch]
2021-04-03 Deep Blue Delay [REV3]: minor changes
    [deep_blue_delay_r3.kicad_pcb, deep_blue_delay_r3.sch]
2021-04-03 Distortion + [REV2]: minor changes
    [distortion_+_r2.kicad_pcb]
2021-04-03 Little Angel Chorus [REV1]: minor changes
    [little_angel_chorus_r1.kicad_pcb, little_angel_chorus_r1.sch]
2021-04-03 Big Muff [REV2]: minor changes
    [big_muff_r2_bass.kicad_pcb, big_muff_r2_nyc.kicad_pcb]
2021-05-09 Distortion + [REV2], Fuzz Factory [REV1], and Little Angel Chorus [REV1]: LED circuit redrawn correctly
    [distortion_+_r2.sch, fuzz_factory_r1.sch, little_angel_chorus_r1.sch]
2021-05-19 SBKCL: switches' footprints added
2021-05-19 StompBoxes' Enclosure Library (SBEL) created
2021-05-19 StompBoxes' SilkScreen Library (SBSSL) created
2021-05-23 Silkscreen files added
2021-06-23 Good Grief Overdrive [REV1] files added
    [good_grief_overdrive_r1a.kicad_pcb, good_grief_overdrive_r1a.sch]
2021-06-24 SBKCL: RPB-18-3x17-DUAL-SINGLE-SINGLE footprint added
2021-06-24 Potentiometer boards files added
    [potentiometer_board_18_3x17_dual-single-single_r1.kicad_pcb, potentiometer_board_18_3x17_dual-single-single_r1.sch, potentiometer_board_18_3x17_r1.kicad_pcb, potentiometer_board_18_3x17_r1.sch]
2021-07-04 SBKCL: universal symbol and footprint for ST-008x-04/05 added
2021-07-04 Fishtaur [REV1] files added
    [fishtaur_r1a.kicad_pcb, fishtaur_r1a.sch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]
2021-07-04 Fuzz Factory Main Board [REV1C] files added
    [fuzz_factory_r1c_r1b.kicad_pcb, fuzz_factory_r1c_r1b.sch]
2021-07-04 Fuzz Factory [REV1]: technical requirements added
    [fuzz_factory_r1.kicad_pcb]
2021-07-04 Fuzz Factory [REV1]: files renamed
    [fuzz_factory_r1b_r1b.kicad_pcb, fuzz_factory_r1b_r1b.sch]
2021-07-04 Distortion + [REV2]: files renamed, gerber added, minor changes
    [distortion_+_r2a.kicad_pcb, distortion_+_r2a.sch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]
2021-07-04 Fuzz Factory [REV1]: gerber added
    [fuzz_factory_main_board_r1b-B_Cu.gbr, fuzz_factory_main_board_r1b-B_Mask.gbr, fuzz_factory_main_board_r1b-Edge_Cuts.gbr, fuzz_factory_main_board_r1b-F_SilkS.gbr, fuzz_factory_main_board_r1b.drl, fuzz_factory_main_board_r1c-B_Cu.gbr, fuzz_factory_main_board_r1c-B_Mask.gbr, fuzz_factory_main_board_r1c-Edge_Cuts.gbr]
2021-07-05 Good Grief Overdrive [REV1]: minor changes
    [good_grief_overdrive_r1a.sch]
2021-07-06 Fishtaur [REV1]: minor changes
    [fishtaur_r1a.sch]
2021-07-11 XLR A/B Footswitch [REV1]: silkscreen files added
2021-07-29 Little Angel Chorus [REV1]: files renamed, gerber added, minor changes
    [little_angel_chorus_r1a.kicad_pcb, little_angel_chorus_r1a.sch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]
2021-07-29 Deep Blue Delay [REV3]: files renamed, gerber added, minor changes
    [deep_blue_delay_r3b.kicad_pcb, deep_blue_delay_r3b.sch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]
2021-08-17 SBKCL: Through-Hole MultiLayer footprint library (SBKCL-TH-ML) created
2021-08-19 SBKCL: capacitors' footprints added
2021-08-20 Salty Phaser [REV1] files added
    [salty_phaser_r1a.kicad_pcb, salty_phaser_r1a.sch]
2021-08-21 Salty Phaser [REV1]: minor changes
    [salty_phaser_r1a.kicad_pcb, salty_phaser_r1a.sch]
2021-08-21 Salty Phaser [REV1]: output files added
    [salty_phaser_r1a-B_Cu.gbr, salty_phaser_r1a-B_Mask.gbr, salty_phaser_r1a-B_SilkS.gbr, salty_phaser_r1a-Edge_Cuts.gbr, salty_phaser_r1a-F_Cu.gbr, salty_phaser_r1a-F_Mask.gbr, salty_phaser_r1a-F_SilkS.gbr, salty_phaser_r1a.drl]
2021-08-21 Potentiometer Board 18 3x17 [REV1]: gerber added
    [potentiometer_board_18_3x17_r1-B_Cu.gbr, potentiometer_board_18_3x17_r1-B_Mask.gbr, potentiometer_board_18_3x17_r1-Edge_Cuts.gbr, potentiometer_board_18_3x17_r1.drl]
2021-08-31 Salty Phaser [REV1]: silkscreen files added
2021-09-11 Fishtaur [REV1]: silkscreen files added
2021-12-30 SBKCL: connectors' footprints added
2021-12-31 SBKCL: connector footprint added
2022-01-01 SBKCL: CONNECTOR_M_004_10_CONNECTOR-BOARD symbol added
2022-01-01 1590N1 Connector Board [REV1] files added
    [1590N1_connector_board_r1.kicad_pcb, 1590N1_connector_board_r1.sch]
2022-01-01 1590N1 Potentiometer Board 18 2x17 [REV1] files added
    [1590N1_potentiometer_board_18_2x17_r1.kicad_pcb, 1590N1_potentiometer_board_18_2x17_r1.sch]
2022-01-01 SBKCL: footprints moved from SBKCL.pretty to SBKCL-TH-SL.pretty
2022-01-01 1590N1 Potentiometer Board 18 3x17 [REV1] files added
    [1590N1_potentiometer_board_18_3x17_r1.kicad_pcb, 1590N1_potentiometer_board_18_3x17_r1.sch]
2022-01-01 1590N1 Potentiometer Boards: minor changes
    [1590N1_potentiometer_board_18_2x17_r1.kicad_pcb, 1590N1_potentiometer_board_18_2x17_r1.sch, 1590N1_potentiometer_board_18_3x17_r1.kicad_pcb]
2022-01-01 SBKCL: 1590N1 potentiometer boards' footprints added
2022-01-03 SBKCL: C-DISK-D04.2-T03.0-P05.08-d0.5-OR-CP-RADIAL-D05.0-P02.0-CLS footprint added
2022-01-04 SBKCL: CONNECTOR_M_004_10_CONNECTOR-BOARD_INVERTED symbol added
2022-01-04 SBKCL: 1590N1 Connector Board symbol and footprint added
2022-01-05 Тремоло Саши Огородникова [REV1] files added
    [тремоло_саши_огородникова_r1a.kicad_pcb, тремоло_саши_огородникова_r1a.sch]
2022-01-05 SBKCL: P-SOT-23-D-S-G-OR-TO-92-D-S-G footprint added
2022-01-06 Edamamer [REV1] files added
    [edamamer_r1a.kicad_pcb, edamamer_r1a.sch]
2022-01-06 Тремоло Саши Огородникова [REV1]: minor changes
    [тремоло_саши_огородникова_r1a.kicad_pcb]
2022-01-06 Edamamer [REV1]: minor changes
    [edamamer_r1a.kicad_pcb]
2022-01-08 Fuzz Factory [MB:REV1D/PB:REV1C] files added
    [fuzz_factory_r1d_r1c.kicad_pcb, fuzz_factory_r1d_r1c.sch]
2022-01-08 SBKCL: SW-PBS-24-302SP footprints removed
2022-01-08 Fuzz Factory [MB:REV1D/PB:REV1C]: universal capacitor footprints implemented
    [fuzz_factory_r1d_r1c.kicad_pcb, fuzz_factory_r1d_r1c.sch]
2022-01-08 Fuzz Factory [MB:REV1D/PB:REV1C]: potentiometer board text objects flipped
    [fuzz_factory_r1d_r1c.kicad_pcb]
2022-01-08 Fuzz Factory [MB:REV1D/PB:REV1C]: minor changes
    [fuzz_factory_r1d_r1c.kicad_pcb]
2022-01-08 Fuzz Factory [MB:REV1D/PB:REV1C]: R9 added
    [fuzz_factory_r1d_r1c.kicad_pcb, fuzz_factory_r1d_r1c.sch]
2022-01-09 1590N1 Connector Board [REV1]: minor changes
    [1590N1_connector_board_r1.kicad_pcb]
2022-01-09 Gerbers added
    [1590N1_connector_board_r1-B_Cu.gbr, 1590N1_connector_board_r1-B_Mask.gbr, 1590N1_connector_board_r1-B_SilkS.gbr, 1590N1_connector_board_r1-Edge_Cuts.gbr, 1590N1_connector_board_r1-F_Cu.gbr, 1590N1_connector_board_r1-F_Mask.gbr, 1590N1_connector_board_r1-F_SilkS.gbr, 1590N1_connector_board_r1.drl]
2022-01-10 SBKCL: CON-ST-008X-04 multilayer footprint added
2022-01-11 Копка Земли [REV1] (Down-Tuned) files added
    [копка_земли_r1a_down-tuned.kicad_pcb, копка_земли_r1a_down-tuned.sch]
2022-01-11 Копка Земли [REV1] (Down-Tuned): minor changes
    [копка_земли_r1a_down-tuned.kicad_pcb]
2022-01-15 Копка Земли [REV1]: silkscreen files added
2022-01-15 Копка Земли [REV1] (Standard-Tuned) files added
    [копка_земли_r1a_standard-tuned.kicad_pcb, копка_земли_r1a_standard-tuned.sch]
2022-01-15 Копка Земли [REV1]: output files added
2022-01-15 Копка Земли [REV1]: gerber added
    [копка_земли_r1a-B_Cu.gbr, копка_земли_r1a-B_Mask.gbr, копка_земли_r1a-Edge_Cuts.gbr, копка_земли_r1a-F_Cu.gbr, копка_земли_r1a-F_Mask.gbr, копка_земли_r1a-F_SilkS.gbr, копка_земли_r1a.drl]
2022-01-15 Big Muff [REV2]: files renamed
    [big_muff_r2a_bass.kicad_pcb, big_muff_r2a_bass.sch, big_muff_r2a_nyc.kicad_pcb, big_muff_r2a_nyc.sch]
2022-01-15 Big Muff [REV2]: gerber added
    [big_muff_r2a-B_Cu.gbr, big_muff_r2a-B_Mask.gbr, big_muff_r2a-B_SilkS.gbr, big_muff_r2a-Edge_Cuts.gbr, big_muff_r2a-F_SilkS.gbr, big_muff_r2a.drl]
2022-02-06 Тремоло Саши Огородникова [REV1]: silkscreen files added
2022-02-20 Edamamer [REV1]: silkscreen files added
2022-02-20 Копка Земли [REV1]: minor changes
    [копка_земли_r1a_down-tuned.kicad_pcb, копка_земли_r1a_down-tuned.sch, копка_земли_r1a_standard-tuned.kicad_pcb, копка_земли_r1a_standard-tuned.sch]
2022-03-19 SBKCL: SW-MTS footprints removed
2022-03-19 Good Grief Overdrive [REV1]: many footprints replaced with single-layer footprints
    [good_grief_overdrive_r1a.kicad_pcb, good_grief_overdrive_r1a.sch]
2022-03-19 Good Grief Overdrive [REV1]: all remaining footprints replaced with single-layer footprints
    [good_grief_overdrive_r1a.kicad_pcb, good_grief_overdrive_r1a.sch]
2022-03-19 Good Grief Overdrive [REV1]: silkscreen edited
    [good_grief_overdrive_r1a.kicad_pcb]
2022-03-19 Good Grief Overdrive [REV1B] files added
    [good_grief_overdrive_r1b.kicad_pcb, good_grief_overdrive_r1b.sch]
2022-03-19 Good Grief Overdrive [REV1B]: J1 deleted
    [good_grief_overdrive_r1b.kicad_pcb, good_grief_overdrive_r1b.sch]
2022-03-20 Good Grief Overdrive [REV1B]: connector footprints replaced
    [good_grief_overdrive_r1b.kicad_pcb, good_grief_overdrive_r1b.sch]
2022-03-20 Good Grief Overdrive [REV1B]: VLS2 deleted
    [good_grief_overdrive_r1b.kicad_pcb, good_grief_overdrive_r1b.sch]
2022-03-20 Good Grief Overdrive [REV1B]: enclosure replaced with 1590BB_B1_D1
    [good_grief_overdrive_r1b.kicad_pcb, good_grief_overdrive_r1b.sch]
2022-03-20 Good Grief Overdrive [REV1A]: minor changes
    [good_grief_overdrive_r1a.sch]
2022-03-20 Good Grief Overdrive [REV1B]: minor changes
    [good_grief_overdrive_r1b.kicad_pcb, good_grief_overdrive_r1b.sch]
2022-03-20 Good Grief Overdrive [REV1B]: silkscreen edited
    [good_grief_overdrive_r1b.kicad_pcb]
2022-03-20 Good Grief Overdrive [REV1]: output files added
    [good_grief_overdrive_r1a-B_Cu.gbr, good_grief_overdrive_r1a-B_Mask.gbr, good_grief_overdrive_r1a-Edge_Cuts.gbr, good_grief_overdrive_r1a-F_SilkS.gbr, good_grief_overdrive_r1a.drl, good_grief_overdrive_r1b-B_Cu.gbr, good_grief_overdrive_r1b-B_Mask.gbr, good_grief_overdrive_r1b-Edge_Cuts.gbr]
2022-03-29 Big Muff [REV2A]: minor changes
    [big_muff_r2a_bass.kicad_pcb, big_muff_r2a_nyc.kicad_pcb]
2022-03-29 Deep Blue Delay [REV3B]: minor changes
    [deep_blue_delay_r3b.kicad_pcb, deep_blue_delay_r3b.sch]
2022-03-29 New revisions of some PCBs added
    [big_muff_r3a_nyc.kicad_pcb, big_muff_r3a_nyc.sch, копка_земли_r1b_down-tuned.kicad_pcb, копка_земли_r1b_down-tuned.sch, тремоло_саши_огородникова_r1b.kicad_pcb, тремоло_саши_огородникова_r1b.sch]
2022-03-29 Копка Земли [REV1B] (Down-Tuned): minor changes
    [копка_земли_r1b_down-tuned.kicad_pcb, копка_земли_r1b_down-tuned.sch]
2022-03-31 1590N1 Potentiometer Board 18 2x17 [REV1B] files added
    [1590N1_potentiometer_board_18_2x17_r1a.kicad_pcb, 1590N1_potentiometer_board_18_2x17_r1a.sch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]
2022-03-31 Big Muff [REV3A]: minor changes
    [big_muff_r3a_nyc.kicad_pcb]
2022-03-31 Potentiometer Board 18 1x17 [REV1A] files added
    [potentiometer_board_18_1x17_r1a.kicad_pcb, potentiometer_board_18_1x17_r1a.sch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]
2022-03-31 Minor changes
    [potentiometer_board_18_1x17_r1a.kicad_pcb, potentiometer_board_20_1x17_r1a.kicad_pcb]
2022-05-10 Good Grief Overdrive [REV1]: silkscreen V2 added
2022-05-10 Big Muff [REV2]: silkscreen V2 added
2022-05-21 Deep Blue Delay [REV3B]: R6 value changed
    [deep_blue_delay_r3b.kicad_pcb, deep_blue_delay_r3b.sch]
2022-05-28 Good Grief Overdrive [REV1B]: HL1 changed, R1 value changed
    [good_grief_overdrive_r1b.kicad_pcb, good_grief_overdrive_r1b.sch]
2022-06-12 Deep Blue Delay [REV3]: silkscreen V2 added
2022-06-12 Копка Земли [REV1B] (Standard-Tuned) files added
    [копка_земли_r1b_standard-tuned.kicad_pcb, копка_земли_r1b_standard-tuned.sch]
2022-06-12 Копка Земли [REV1B]: output files added
2022-06-12 Тремоло Саши Огородникова [REV1B]: output files added
2022-06-12 Big Muff [REV3A]: C1 value changed
    [big_muff_r3a_nyc.kicad_pcb, big_muff_r3a_nyc.sch]
2022-07-12 1590N1 Connector Board [REV1A]: PJ-651A-01 footprint modified
    [1590N1_connector_board_r1a-B_Cu.gbr, 1590N1_connector_board_r1a-B_Mask.gbr, 1590N1_connector_board_r1a-B_SilkS.gbr, 1590N1_connector_board_r1a-Edge_Cuts.gbr, 1590N1_connector_board_r1a-F_Cu.gbr, 1590N1_connector_board_r1a-F_Mask.gbr, 1590N1_connector_board_r1a-F_SilkS.gbr, 1590N1_connector_board_r1a.drl]
2022-07-12 1590N1 Connector Board [REV1B] files added
    [1590N1_connector_board_r1b.kicad_pcb, 1590N1_connector_board_r1b.sch]
2022-07-12 Potentiometer Board 18 1x17 [REV1A]: F_Mask layer added
    [potentiometer_board_18_1x17_r1a.kicad_pcb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]
2022-07-12 Big Muff [REV3A]: F_Mask layer added
    [big_muff_r3a_nyc.kicad_pcb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]
2022-07-15 1590N1 Connector Board [REV1B]: PJ-651A-01 footprint modified
    [1590N1_connector_board_r1b.kicad_pcb]
2022-07-16 1590BB2 Connector Board Extended [REV1A] files added
    [1590BB2_connector_board_extended_r1a.kicad_pcb, 1590BB2_connector_board_extended_r1a.sch]
2022-07-16 Board thickness increased to 1.6 mm
    [big_muff_r2a_bass.kicad_pcb, big_muff_r2a_nyc.kicad_pcb, deep_blue_delay_r3b.kicad_pcb, distortion_+_r2a.kicad_pcb, fishtaur_r1a.kicad_pcb, fuzz_factory_r1b_r1b.kicad_pcb, fuzz_factory_r1c_r1b.kicad_pcb, good_grief_overdrive_r1a.kicad_pcb]
2022-07-16 1590BB2 Potentiometer Board 18 3x17 [REV1A] files added
    [1590BB2_potentiometer_board_18_3x17_r1a.kicad_pcb, 1590BB2_potentiometer_board_18_3x17_r1a.sch]
2022-07-19 SBKCL: P-SOD-123-OR-DO-35 footprint added
2022-07-21 1590BB2 Connector Board Extended [REV1A]: buffer circuit added
    [1590BB2_connector_board_extended_r1a.kicad_pcb, 1590BB2_connector_board_extended_r1a.sch]
2022-07-21 1590BB2 Connector Board Extended [REV1A]: minor changes
    [1590BB2_connector_board_extended_r1a.kicad_pcb, 1590BB2_connector_board_extended_r1a.sch]
2022-07-21 Crumbwave Multiplexer [REV1A] files added
    [crumbwave_multiplexer_r1a.kicad_pcb, crumbwave_multiplexer_r1a.sch]
2022-07-21 Edamamer [REV1A]: potentiometers changed to R16K1-L15KC
    [edamamer_r1a.sch]
2022-07-21 Fishtaur [REV1A]: 2.6 mm holes increased to 2.8 mm
    [fishtaur_r1a.kicad_pcb, fishtaur_r1a.sch]
2022-07-21 Salty Phaser [REV1A]: 2.6 mm holes increased to 2.8 mm
    [salty_phaser_r1a.kicad_pcb, salty_phaser_r1a.sch]
2022-07-21 Big Muff [REV2A]: 3.0 mm holes decreased to 2.8 mm
    [big_muff_r2a_bass.kicad_pcb, big_muff_r2a_bass.sch, big_muff_r2a_nyc.kicad_pcb, big_muff_r2a_nyc.sch]
2022-07-29 1590N1 Connector Board [REV1A]: minor changes
    [1590N1_connector_board_r1a.kicad_pcb, 1590N1_connector_board_r1a.sch]
2022-07-29 1590N1 Connector Board [REV1B]: tantalum capacitor added
    [1590N1_connector_board_r1b.kicad_pcb, 1590N1_connector_board_r1b.sch]
2022-07-29 1590BB2 Connector Board Extended [REV1A]: toggle switch added, tantalum capacitor added
    [1590BB2_connector_board_extended_r1a.kicad_pcb, 1590BB2_connector_board_extended_r1a.sch]
2022-07-30 Potentiometer Board 18 1x17 [REV1A]: solder bridge jumpers added
    [potentiometer_board_18_1x17_r1a.kicad_pcb, potentiometer_board_18_1x17_r1a.sch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]
2022-08-04 1590BB2 Connector Board Extended [REV1A]: keepout areas added
    [1590BB2_connector_board_extended_r1a.kicad_pcb]
2022-09-04 Crumbwave Multiplexer [REV1A]: minor changes
    [crumbwave_multiplexer_r1a.kicad_pcb]
2022-10-16 Latest boards: solder mask clearance, solder mask minimum width, and gerbers modified
    [1590BB2_connector_board_extended_r1a.kicad_pcb, 1590BB2_potentiometer_board_18_3x17_r1a.kicad_pcb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]
2022-10-16 Тремоло Саши Огородникова, Edamamer: 9.0 mm holes increased to 9.4 mm
    [edamamer_r1a.kicad_pcb, тремоло_саши_огородникова_r1a.kicad_pcb, тремоло_саши_огородникова_r1b.kicad_pcb]
2022-11-17 Big Muff [REV3A]: VLS1, VMH1, VMH2 changed
    [big_muff_r3a_nyc.kicad_pcb, big_muff_r3a_nyc.sch]
2022-11-17 Копка Земли [REV1B]: minor changes
    [копка_земли_r1b_down-tuned.kicad_pcb, копка_земли_r1b_standard-tuned.kicad_pcb]
2022-11-17 Big Muff [REV3A] (Bass) files added
    [big_muff_r3a_bass.kicad_pcb, big_muff_r3a_bass.sch]
2022-11-18 Big Muff [REV3]: some silkscreen files added
2022-11-19 Big Muff [REV3]: remaining silkscreen files added
2022-12-04 SBKCL: P-SOD-123-OR-DO-41 footprint added
2022-12-09 Fishtaur [REV1A]: minor changes
    [fishtaur_r1a.sch]
2023-01-30 Spacer PBS-24-302SP [REV1A] and Spacer MTS-1xx-A2 [REV1A] files added
    [spacer_MTS-1xx-A2_r1a.kicad_pcb, spacer_MTS-1xx-A2_r1a.sch, spacer_PBS-24-302SP_r1a.kicad_pcb, spacer_PBS-24-302SP_r1a.sch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]
2023-01-30 Spacer MTS-1xx-A2 [REV1A]: minor changes
    [spacer_MTS-1xx-A2_r1a.kicad_pcb]
2023-01-30 1590N1 Potentiometer Board 18 2x17 [REV2A] files added
    [1590N1_potentiometer_board_18_2x17_r2a.kicad_pcb, 1590N1_potentiometer_board_18_2x17_r2a.sch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]
2023-02-04 SBKCL: CON-PJ-644C-IN-OR-OUT footprint added
2023-02-04 SBKCL: RP-EXTERNAL footprint added
2023-02-06 Копка Земли [REV2A] files added
    [копка_земли_r2a_down-tuned-B_Cu.gbr, копка_земли_r2a_down-tuned-B_Mask.gbr, копка_земли_r2a_down-tuned-B_SilkS.gbr, копка_земли_r2a_down-tuned-Edge_Cuts.gbr, копка_земли_r2a_down-tuned-F_Cu.gbr, копка_земли_r2a_down-tuned-F_Mask.gbr, копка_земли_r2a_down-tuned-F_SilkS.gbr, копка_земли_r2a_down-tuned.drl]
2023-02-09 Копка Земли [REV2A]: minor changes
    [копка_земли_r2a_down-tuned.sch]
2023-02-09 Big Muff [REV3A]: VE1 changed from B013_D1 to B013_E1
    [big_muff_r3a_bass.kicad_pcb, big_muff_r3a_bass.sch, big_muff_r3a_nyc.kicad_pcb, big_muff_r3a_nyc.sch]
2023-02-09 1590BB Potentiometer Board 18 3x17 [REV1B] and 1590BB Potentiometer Board 18 3x17 Dual-Single-Single [REV1B] files added
    [1590BB_potentiometer_board_18_3x17_dual-single-single_r1b.kicad_pcb, 1590BB_potentiometer_board_18_3x17_dual-single-single_r1b.sch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]
2023-02-26 SBKCL: RPB-1590N1-18-2x17-OR-2x1x17-1.6-PNL-7.4-2.8 footprint added
2023-02-27 Little Angel Chorus [REV1A]: minor changes
    [little_angel_chorus_r1a.kicad_pcb]
2023-02-28 1590BB2 Connector Board Extended [REV1A]: B.R1 value changed to X
    [1590BB2_connector_board_extended_r1a.kicad_pcb, 1590BB2_connector_board_extended_r1a.sch]
2023-02-28 1590BB2 Potentiometer Board 18 3x17 [REV1A]: output files added
2023-02-28 1590N1 Connector Board [REV1B]: output files added
2023-02-28 Тремоло Саши Огородникова [REV1A]: RPB1.1 and RPB1.2 shaft length changed to 15 mm
    [тремоло_саши_огородникова_r1a.sch]
2023-02-28 Crumbwave Multiplexer [REV1A]: RPB1.1…RPB1.3 changed
    [crumbwave_multiplexer_r1a.kicad_pcb, crumbwave_multiplexer_r1a.sch]
2023-03-01 Crumbwave Multiplexer [REV1A]: XB1 symbol updated
    [crumbwave_multiplexer_r1a.sch]
2023-03-08 SBKCL: RPB-1590N1-18-2x17-OR-2x1x17-1.6-PNL-7.4-2.8 footprint changed
2023-03-12 Little Angel Chorus [REV2A] files added
    [big_devil_vibrato_r2a.kicad_pcb, big_devil_vibrato_r2a.sch, little_angel_chorus-vibrato_r2a.kicad_pcb, little_angel_chorus-vibrato_r2a.sch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]
2023-03-12 Little Angel Chorus [REV2A]: some output files added
    [big_devil_vibrato_r2a.sch, little_angel_chorus-vibrato_r2a.sch, little_angel_chorus_r2a.sch]
2023-03-13 Little Angel Chorus [REV2A]: remaining output files added
    [big_devil_vibrato_r2a.kicad_pcb, little_angel_chorus-vibrato_r2a.kicad_pcb, little_angel_chorus_r2a.kicad_pcb]
2023-03-14 Копка Земли [REV2A] (Standard-Tuned) files added
    [копка_земли_r2a_standard-tuned.kicad_pcb, копка_земли_r2a_standard-tuned.sch]
2023-03-19 Little Angel Chorus [REV2A]: purposes and values of DWS.R1 and L.R6 changed
    [big_devil_vibrato_r2a.kicad_pcb, big_devil_vibrato_r2a.sch, little_angel_chorus-vibrato_r2a.kicad_pcb, little_angel_chorus-vibrato_r2a.sch, little_angel_chorus_r2a.kicad_pcb, little_angel_chorus_r2a.sch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]
2023-03-19 1590N1 Potentiometer Board 18 2x17 [REV1C] files added
    [1590N1_potentiometer_board_18_2x17_r1c.kicad_pcb, 1590N1_potentiometer_board_18_2x17_r1c.sch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]
2023-03-21 Little Angel Chorus [REV2A]: PS.C5 rotated
    [big_devil_vibrato_r2a.kicad_pcb, little_angel_chorus-vibrato_r2a.kicad_pcb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]
2023-03-25 Salty Phaser [REV1A]: many values changed based on debugging results
    [salty_phaser_r1a.kicad_pcb, salty_phaser_r1a.sch]
2023-04-01 SBKCL: VIRTUAL_BOARD_CONNECTOR-BOARD-V2_C symbol added
2023-04-05 Phaser A [REV1A] files added
    [phaser_a_r1a.kicad_pcb, phaser_a_r1a.sch]
2023-04-09 Phaser A [REV1A]: minor changes
    [phaser_a_r1a.kicad_pcb, phaser_a_r1a.sch]
2023-04-09 Phaser A [REV1A]: gerbers added
    [phaser_a_r1a-B_Cu.gbr, phaser_a_r1a-B_Mask.gbr, phaser_a_r1a-B_SilkS.gbr, phaser_a_r1a-Edge_Cuts.gbr, phaser_a_r1a-F_Cu.gbr, phaser_a_r1a-F_Mask.gbr, phaser_a_r1a-F_SilkS.gbr, phaser_a_r1a.drl]
2023-04-09 Crumbwave Multiplexer [REV1]: some silkscreen files added
2023-04-16 Fishtaur [REV1A]: R25 and R27 are interchanged on the schematic due to an error on the silkscreen layer
    [fishtaur_r1a.kicad_pcb, fishtaur_r1a.sch]
2023-05-11 Crumbwave Multiplexer [REV1]: remaining silkscreen files added
2023-05-11 Crumbwave Multiplexer [REV1A]: HL1 changed to FYL-5013URC, IND.R1 value changed to 4.7 kOhm
    [crumbwave_multiplexer_r1a.kicad_pcb, crumbwave_multiplexer_r1a.sch]
2023-05-12 Копка Земли [REV2]: some silkscreen files added
2023-05-12 Fuzz Factory [REV2]: some silkscreen files added
2023-05-18 Crumbwave Multiplexer [REV1]: minor changes
    [crumbwave_multiplexer_r1a.kicad_pcb]
2023-06-01 Копка Земли [REV2]: remaining silkscreen files added
2023-06-01 Little Angel Chorus [REV2]: some silkscreen files added
2023-06-06 Тремоло Саши Огородникова [REV1SM]: some silkscreen files added
2023-06-06 Fishtaur [REV1SM]: some silkscreen files added
2023-06-07 Копка Земли [REV1SM]: some silkscreen files added
2023-06-07 Good Grief Overdrive [REV1SM]: some silkscreen files added
2023-06-11 Тремоло Саши Огородникова [REV1SM]: engraving files added
    [тремоло_саши_огородникова_r1sm_1.dxf]
2023-06-21 Good Grief Overdrive [REV1SM]: remaining engraving files added
    [good_grief_overdrive_r1sm_1.dxf]
2023-06-22 Fishtaur [REV1SM]: remaining engraving files added
    [fishtaur_r1sm_1.dxf]
2023-06-22 Копка Земли [REV1SM]: remaining engraving files added
    [копка_земли_r1sm_down-tuned_1.dxf, копка_земли_r1sm_standard-tuned_1.dxf]
2023-06-22 Some bottom-side engraving files added
    [fishtaur_r1sm_bottom.dxf, good_grief_overdrive_r1sm_bottom.dxf, копка_земли_r1sm_bottom.dxf, тремоло_саши_огородникова_r1sm_bottom.dxf]
2023-06-24 Salty Phaser [REV1]: silkscreen files changed, some engraving files added
2023-06-24 Salty Phaser [REV1]: some silkscreen files changed, some engraving files added
2023-06-25 Salty Phaser [REV1]: remaining engraving files added
    [salty_phaser_r1_panel_1.dxf]
2023-06-25 Salty Phaser [REV1]: engraving files renamed
    [salty_phaser_r1_plate_1.dxf]
2023-06-25 Enclosure parts: ТКП-6.1.3.A1, ТКП-6.1.3.B1, and ТКП-6.1.3.C1 added
    [ТКП-6.1.3.A1_1590BB_Panel_A_V1.FCStd, ТКП-6.1.3.B1_1590BB_Panel_B_V1.FCStd, ТКП-6.1.3.C1_1590BB_Panel_C_V1.FCStd]
2023-07-01 Enclosure parts: ТКП-6.1.2.A1 added
    [ТКП-6.1.2.A1_1590BB_Spacer_A_V1.FCStd]
2023-07-01 Enclosure parts: minor changes
    [ТКП-6.1.3.A1_1590BB_Panel_A_V1.FCStd, ТКП-6.1.3.B1_1590BB_Panel_B_V1.FCStd, ТКП-6.1.3.C1_1590BB_Panel_C_V1.FCStd]
2023-07-01 Enclosure parts: ТКП-6.1.4.A1 added
    [ТКП-6.1.4.A1_1590BB_Plate_A_V1.FCStd]
2023-07-01 Enclosure parts: draft versions of ТКП-6.1.1.A1 and ТКП-6.2.1.A1 added
    [ТКП-6.1.1.A1_1590BB_Box_A_V1.FCStd, ТКП-6.2.1.A1_1590N1_Box_A_V1.FCStd]
2023-07-01 Enclosure parts: ТКП-6.1.1.A1 and ТКП-6.2.1.A1 modified
    [ТКП-6.1.1.A1_1590BB_Box_A_V1.FCStd, ТКП-6.2.1.A1_1590N1_Box_A_V1.FCStd]
2023-07-02 Enclosure parts: ТКП-6.2.2.A1, ТКП-6.2.3.A1, and ТКП-6.2.4.A1 added
    [ТКП-6.2.2.A1_1590N1_Panel_bottom_A_V1.FCStd, ТКП-6.2.3.A1_1590N1_Spacer_A_V1.FCStd, ТКП-6.2.4.A1_1590N1_Panel_top_A_V1.FCStd]
2023-07-08 ТКП-1.19.B-1 Good Grief Overdrive [REV1B]: project files are duplicated in a new experimental cipher-based storage directory. ТКП-1.19.B-2 Good Grief Overdrive [REV1B] SM files added
    [ТКП-1.19.B-1.kicad_pcb, ТКП-1.19.B-1.sch, ТКП-1.19.B-2.kicad_pcb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]
2023-07-08 ТКП-1.24.B Копка Земли [REV1B]: project files are duplicated in a new experimental cipher-based storage directory. ТКП-1.24.B-3 Копка Земли [REV1B] Down-Tuned SM and ТКП-1.24.B-4 Копка Земли [REV1B] 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
    [ТКП-1.24.B-1.kicad_pcb, ТКП-1.24.B-1.sch, ТКП-1.24.B-2.kicad_pcb, ТКП-1.24.B-2.sch, ТКП-1.24.B-3.kicad_pcb, ТКП-1.24.B-3.sch, ТКП-1.24.B-4.kicad_pcb, ТКП-1.24.B-4.sch]
2023-07-15 ТКП-1.21.A-1 Fishtaur [REV1A]: project files are duplicated in a new experimental cipher-based storage directory. ТКП-1.21.A-2 Fishtaur [REV1A] SM files added
    [ТКП-1.21.A-1.kicad_pcb, ТКП-1.21.A-1.sch, ТКП-1.21.A-2.kicad_pcb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]
2023-07-15 ТКП-1.21.A Fishtaur [REV1A]: minor changes
    [ТКП-1.21.A-1.kicad_pcb, ТКП-1.21.A-1.sch, ТКП-1.21.A-2.kicad_pcb, ТКП-1.21.A-2.sch]
2023-07-26 ТКП-1.17.B-1 Deep Blue Delay [REV3B]: project files are duplicated in a new experimental cipher-based storage directory
    [ТКП-1.17.B-1.kicad_pcb, ТКП-1.17.B-1.sch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]
2023-08-01 Salty Phaser [REV1A]: minor changes
    [salty_phaser_r1a.kicad_pcb, salty_phaser_r1a.sch]
2023-08-03 ТКП-1.23.A-1 Salty Phaser [REV1A]: project files are duplicated in a new experimental cipher-based storage directory
    [salty_phaser_r1a-B_Cu.gbr, salty_phaser_r1a-B_Mask.gbr, salty_phaser_r1a-B_SilkS.gbr, salty_phaser_r1a-Edge_Cuts.gbr, salty_phaser_r1a-F_Cu.gbr, salty_phaser_r1a-F_Mask.gbr, salty_phaser_r1a-F_SilkS.gbr, salty_phaser_r1a.drl]
2023-08-03 ТКП-1.23.A-1 Salty Phaser [REV1A]: minor changes
    [ТКП-1.23.A-1.kicad_pcb]
2023-08-04 ТКП-1.23.A-1 Salty Phaser [REV1A]: VTC1…4 added
    [ТКП-1.23.A-1.kicad_pcb, ТКП-1.23.A-1.sch]
2023-08-05 ТКП-1.23.A-1 Salty Phaser [REV1A]: jumpers VJx added
    [ТКП-1.23.A-1.kicad_pcb, ТКП-1.23.A-1.sch]
2023-08-05 ТКП-1.23.A-1 Salty Phaser [REV1A]: virtual resistors *R1…3 added
    [ТКП-1.23.A-1.kicad_pcb, ТКП-1.23.A-1.sch]
2023-08-05 ТКП-1.23.B-1 Salty Phaser [REV1B] files added
    [ТКП-1.23.B-1.kicad_pcb, ТКП-1.23.B-1.sch]
2023-08-06 ТКП-1.23.B-1 Salty Phaser [REV1B]: some single-layer footprints replaced with multi-layer footprints
    [ТКП-1.23.B-1.kicad_pcb, ТКП-1.23.B-1.sch]
2023-08-06 ТКП-1.23.B-1 Salty Phaser [REV1B]: remaining single-layer footprints replaced with multi-layer footprints
    [ТКП-1.23.B-1.kicad_pcb, ТКП-1.23.B-1.sch]
2023-08-06 ТКП-1.23.B-1 Salty Phaser [REV1B]: some changes
    [ТКП-1.23.B-1.kicad_pcb, ТКП-1.23.B-1.sch]
2023-08-06 ТКП-1.23.B-1 Salty Phaser [REV1B]: all footprints updated
    [ТКП-1.23.B-1.kicad_pcb, ТКП-1.23.B-1.sch]
2023-08-06 ТКП-1.23.B-1 Salty Phaser [REV1B]: potentiometer boards' thickness changed from 1.5 to 1.6 mm
    [ТКП-1.23.B-1.kicad_pcb, ТКП-1.23.B-1.sch]
2023-08-06 ТКП-1.23.B-1 Salty Phaser [REV1B]: input buffer circuit corrected
    [ТКП-1.23.B-1.kicad_pcb, ТКП-1.23.B-1.sch]
2023-08-06 ТКП-1.23.B-1 Salty Phaser [REV1B]: output mixer circuit corrected
    [ТКП-1.23.B-1.kicad_pcb, ТКП-1.23.B-1.sch]
2023-08-06 ТКП-1.23.B-1 Salty Phaser [REV1B]: IB.J1…3, SC.J1…4, and TP1 added
    [ТКП-1.23.B-1.kicad_pcb, ТКП-1.23.B-1.sch]
2023-08-07 ТКП-1.23.B-1 Salty Phaser [REV1B]: OM.J1, OM.J2, FB.J1, and FB.J2 added
    [ТКП-1.23.B-1.kicad_pcb, ТКП-1.23.B-1.sch]
2023-08-18 SBEL: ТКП-6.1.1.A1, ТКП-6.1.3, ТКП-6.1.3.A1, ТКП-6.1.3.B1, and ТКП-6.1.3.C1 added
2023-08-20 ТКП-1.19.B-2, ТКП-1.21.A-2, ТКП-1.24.B-3, and ТКП-1.24.B-4: 1590BB enclosures changed to custom enclosures
    [ТКП-1.19.B-2.kicad_pcb, ТКП-1.19.B-2.sch, ТКП-1.21.A-2.kicad_pcb, ТКП-1.21.A-2.sch, ТКП-1.24.B-3.kicad_pcb, ТКП-1.24.B-3.sch, ТКП-1.24.B-4.kicad_pcb, ТКП-1.24.B-4.sch]
2023-08-20 SBKCL: new RPBs' footprints added
2023-08-20 ТКП-1.19.B-2, ТКП-1.21.A-2, ТКП-1.24.B-3, and ТКП-1.24.B-4: hole diameters changed
    [ТКП-1.19.B-2.kicad_pcb, ТКП-1.19.B-2.sch, ТКП-1.21.A-2.kicad_pcb, ТКП-1.21.A-2.sch, ТКП-1.24.B-3.kicad_pcb, ТКП-1.24.B-3.sch, ТКП-1.24.B-4.kicad_pcb, ТКП-1.24.B-4.sch]
2023-08-20 ТКП-1.23.B-1 Salty Phaser [REV1B]: VE1 changed from 1590BB to ТКП-6.1.1.A1-2, VE2 added
    [ТКП-1.23.B-1.kicad_pcb, ТКП-1.23.B-1.sch]
2023-08-20 ТКП-1.23.B-1 Salty Phaser [REV1B]: board outline changed
    [ТКП-1.23.B-1.kicad_pcb]
2023-08-20 ТКП-1.23.B-1 Salty Phaser [REV1B]: VFM1…3 added
    [ТКП-1.23.B-1.kicad_pcb, ТКП-1.23.B-1.sch]
2023-08-20 ТКП-1.23.B-1 Salty Phaser [REV1B]: HL2…4 circuit corrected
    [ТКП-1.23.B-1.kicad_pcb, ТКП-1.23.B-1.sch]
2023-08-20 ТКП-1.23.B-1 Salty Phaser [REV1B]: L.C3, L.C4, PS.C5, TP2, and TP3 added, L.C2 changed to CTSMD-C
    [ТКП-1.23.B-1.kicad_pcb, ТКП-1.23.B-1.sch]
2023-08-21 Old projects' files and directories deleted
    [deep_blue_delay_r3b.kicad_pcb, deep_blue_delay_r3b.sch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]
2023-08-21 ТКП-1.36.A Копка Земли [REV2A]: project files are moved to cipher-based storage directory
    [ТКП-1.36.A-1.kicad_pcb, ТКП-1.36.A-1.sch, ТКП-1.36.A-2.kicad_pcb, ТКП-1.36.A-2.sch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]
2023-08-21 ТКП-1.36.A Копка Земли [REV2A]: minor changes
    [ТКП-1.36.A-1.kicad_pcb, ТКП-1.36.A-1.sch, ТКП-1.36.A-2.kicad_pcb, ТКП-1.36.A-2.sch]
2023-08-25 Little Angel Chorus [REV2A]: minor changes
    [big_devil_vibrato_r2a.kicad_pcb, big_devil_vibrato_r2a.sch, little_angel_chorus_r2a.kicad_pcb, little_angel_chorus_r2a.sch]
2023-08-25 ТКП-1.37.A Little Angel Chorus [REV2A]: project files are moved to cipher-based storage directory
    [little_angel_chorus_r2a-B_Cu.gbr, little_angel_chorus_r2a-B_Mask.gbr, little_angel_chorus_r2a-B_SilkS.gbr, little_angel_chorus_r2a-Edge_Cuts.gbr, little_angel_chorus_r2a-F_Cu.gbr, little_angel_chorus_r2a-F_Mask.gbr, little_angel_chorus_r2a-F_SilkS.gbr, little_angel_chorus_r2a.drl]
2023-08-25 ТКП-1.37.A Little Angel Chorus [REV2A]: minor changes
    [ТКП-1.37.A-1.kicad_pcb, ТКП-1.37.A-2.kicad_pcb, ТКП-1.37.A-3.kicad_pcb]
2023-09-01 ТКП-1.23.A-1 Salty Phaser [REV1A]: remaining output files added
2023-09-18 Enclosure parts: ТКП-6.3.2.A1 added
    [ТКП-6.3.2.A1_B013_Spacer_A_V1.FCStd]
2023-09-19 Enclosure parts: draft version of ТКП-6.3.1.A1 added
    [ТКП-6.3.1.A1_B013_Base_A_V1.FCStd]
2023-09-19 Enclosure parts: ТКП-6.3.1.A1 modified
    [ТКП-6.3.1.A1_B013_Base_A_V1.FCStd]
2023-09-24 Enclosure parts: ТКП-6.3.1.B1 added
    [ТКП-6.3.1.B1_B013_Base_B_V1.FCStd]
2023-09-24 Enclosure parts: draft version of ТКП-6.3.3.A1 added
    [ТКП-6.3.3.A1_B013_Cover_A_V1.FCStd]
2023-09-24 Enclosure parts: ТКП-6.3.3.A1 modified
    [ТКП-6.3.3.A1_B013_Cover_A_V1.FCStd]
2023-09-24 Enclosure parts: ТКП-6.3.1.B1 modified
    [ТКП-6.3.1.B1_B013_Base_B_V1.FCStd]
2023-09-24 Enclosure parts: ТКП-6.3.3.B1 added
    [ТКП-6.3.3.B1_B013_Cover_B_V1.FCStd]
2023-10-03 SBEL: ТКП-6.2.2.A1 added
2023-10-07 SBKCL: CP-RADIAL-D05.0-P02.0-CLS-OR-D06.3-P02.5-CLS-OR-D08.0-P03.5-CLS footprints modified
2023-10-07 ТКП-1.23.B-1 Salty Phaser [REV1B]: PS.C4 added, PS.C1 footprint updated
    [ТКП-1.23.B-1.kicad_pcb, ТКП-1.23.B-1.sch]
2023-10-07 ТКП-1.23.B-1 Salty Phaser [REV1B]: technical requirements added
    [ТКП-1.23.B-1.kicad_pcb, ТКП-1.23.B-1.sch]
2023-10-07 ТКП-1.23.B-1 Salty Phaser [REV1B]: TP4…7 added
    [ТКП-1.23.B-1.kicad_pcb, ТКП-1.23.B-1.sch]
2023-10-08 ТКП-1.23.B-1 Salty Phaser [REV1B]: MS.R4 and MS.R5 added
    [ТКП-1.23.B-1.kicad_pcb, ТКП-1.23.B-1.sch]
2023-10-08 ТКП-1.23.B-1 Salty Phaser [REV1B]: PS.VD2 added
    [ТКП-1.23.B-1.kicad_pcb, ТКП-1.23.B-1.sch]
2023-10-08 ТКП-1.23.B-1 Salty Phaser [REV1B]: XS2 and XS3 footprints changed
    [ТКП-1.23.B-1.kicad_pcb, ТКП-1.23.B-1.sch]
2023-10-08 ТКП-1.23.B-1 Salty Phaser [REV1B]: J1, J2, TP8, and TP9 added
    [ТКП-1.23.B-1.kicad_pcb, ТКП-1.23.B-1.sch]
2023-10-08 ТКП-1.23.B-1 Salty Phaser [REV1B]: J3…5 added
    [ТКП-1.23.B-1.kicad_pcb, ТКП-1.23.B-1.sch]
2023-10-08 ТКП-1.23.B-1 Salty Phaser [REV1B]: L.R9 added
    [ТКП-1.23.B-1.kicad_pcb, ТКП-1.23.B-1.sch]
2023-10-08 ТКП-1.23.B-1 Salty Phaser [REV1B]: FB.J2, FB.R2, FB.R3 added
    [ТКП-1.23.B-1.kicad_pcb, ТКП-1.23.B-1.sch]
2023-10-08 ТКП-1.23.B-1 Salty Phaser [REV1B]: L.R10 added
    [ТКП-1.23.B-1.kicad_pcb, ТКП-1.23.B-1.sch]
2023-10-09 ТКП-1.23.B-1 Salty Phaser [REV1B]: resistors around RPB2.1 and RPB2.3 added
    [ТКП-1.23.B-1.kicad_pcb, ТКП-1.23.B-1.sch]
2023-10-09 ТКП-1.23.B-1 Salty Phaser [REV1B]: J6, J7, and L.J1 added
    [ТКП-1.23.B-1.kicad_pcb, ТКП-1.23.B-1.sch]
2023-10-10 ТКП-1.23.B-1 Salty Phaser [REV1B]: L.C5…8, X4…6 added
    [ТКП-1.23.B-1.kicad_pcb, ТКП-1.23.B-1.sch]
2023-10-15 ТКП-1.23.B-1 Salty Phaser [REV1B]: PS.C6, PS.D1, PS.R3, PS.R4, PS.VD3, and PS.VD4 added
    [ТКП-1.23.B-1.kicad_pcb, ТКП-1.23.B-1.sch]
2023-10-15 ТКП-1.23.B-1 Salty Phaser [REV1B]: MS.R6…8 added
    [ТКП-1.23.B-1.kicad_pcb, ТКП-1.23.B-1.sch]
2023-10-25 ТКП-1.23.B-1 Salty Phaser [REV1B]: MS.R9 and MS.R10 added
    [ТКП-1.23.B-1.kicad_pcb, ТКП-1.23.B-1.sch]
2023-10-28 ТКП-1.23.B-1 Salty Phaser [REV1B]: minor changes
    [ТКП-1.23.B-1.kicad_pcb]
2023-10-29 ТКП-1.23.B-1 Salty Phaser [REV1B]: TP11 added
    [ТКП-1.23.B-1.kicad_pcb, ТКП-1.23.B-1.sch]
2023-10-30 ТКП-1.38.A Phaser A [REV1A]: project files are moved to cipher-based storage directory
    [phaser_a_r1a-B_Cu.gbr, phaser_a_r1a-B_Mask.gbr, phaser_a_r1a-B_SilkS.gbr, phaser_a_r1a-Edge_Cuts.gbr, phaser_a_r1a-F_Cu.gbr, phaser_a_r1a-F_Mask.gbr, phaser_a_r1a-F_SilkS.gbr, phaser_a_r1a.drl]
2023-10-30 ТКП-1.38.A Phaser A [REV1A]: some changes
    [ТКП-1.38.A-1.kicad_pcb, ТКП-1.38.A-1.sch]
2023-10-30 ТКП-1.38.A Phaser A [REV1A]: remaining output files added
2023-10-30 ТКП-1.27.B 1590N1 Connector Board [REV1B]: project files are moved to cipher-based storage directory
    [1590N1_connector_board_r1b-B_Cu.gbr, 1590N1_connector_board_r1b-B_Mask.gbr, 1590N1_connector_board_r1b-B_SilkS.gbr, 1590N1_connector_board_r1b-Edge_Cuts.gbr, 1590N1_connector_board_r1b-F_Cu.gbr, 1590N1_connector_board_r1b-F_Mask.gbr, 1590N1_connector_board_r1b-F_SilkS.gbr, 1590N1_connector_board_r1b.drl]
2023-11-05 ТКП-1.37.A Little Angel Chorus [REV2A]: DWS.R1 and L.R6 values changed to X
    [ТКП-1.37.A-1.kicad_pcb, ТКП-1.37.A-1.sch, ТКП-1.37.A-2.kicad_pcb, ТКП-1.37.A-2.sch, ТКП-1.37.A-3.kicad_pcb, ТКП-1.37.A-3.sch]
2023-11-07 ТКП-1.27.B-1 1590N1 Connector Board [REV1B] A: minor changes
    [ТКП-1.27.B-1.kicad_pcb, ТКП-1.27.B-1.sch]
2023-11-09 ТКП-1.27.B-1 1590N1 Connector Board [REV1B] A: technical requirements added
    [ТКП-1.27.B-1.kicad_pcb, ТКП-1.27.B-1.sch]
2023-11-13 ТКП-1.23.B-1 Salty Phaser [REV1B]: VLS1…4 footprints changed
    [ТКП-1.23.B-1.kicad_pcb, ТКП-1.23.B-1.sch]
2023-11-13 ТКП-1.23.B-1 Salty Phaser [REV1B]: output files added
    [salty_phaser_r1b-B_Cu.gbr, salty_phaser_r1b-B_Mask.gbr, salty_phaser_r1b-B_SilkS.gbr, salty_phaser_r1b-Edge_Cuts.gbr, salty_phaser_r1b-F_Cu.gbr, salty_phaser_r1b-F_Mask.gbr, salty_phaser_r1b-F_SilkS.gbr, salty_phaser_r1b.drl]
2023-11-13 ТКП-1.27.B-1 1590N1 Connector Board [REV1B] A: output files updated
2023-11-13 ТКП-1.27.B-2 1590N1 Connector Board [REV1B] B files added
    [ТКП-1.27.B-2.kicad_pcb, ТКП-1.27.B-2.sch]
2023-11-14 ТКП-1.27.B-3 1590N1 Connector Board [REV1B] C files added
    [ТКП-1.27.B-3.kicad_pcb, ТКП-1.27.B-3.sch]
2023-11-14 ТКП-1.38.A-1 Phaser A [REV1A] Исполнение 1: minor changes
    [ТКП-1.38.A-1.sch]
2023-11-23 SBEL: ТКП-6.3.3, ТКП-6.3.3.A1, and ТКП-6.3.3.B1 added
2023-11-24 Big Muff [REV3SM]: remaining engraving files added
    [big_muff_r3sm_bottom.dxf]
2023-11-26 Enclosure parts: ТКП-6.1.1.B1 added
    [ТКП-6.1.1.B1_1590BB_Box_B_V1.FCStd]
2023-12-09 ТКП-1.20.A 1590BB Potentiometer Board 18 3x17 [REV1A]: project files are moved to cipher-based storage directory
    [ТКП-1.20.A-1.kicad_pcb, ТКП-1.20.A-1.sch, ТКП-1.20.A-2.kicad_pcb, ТКП-1.20.A-2.sch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]
2023-12-09 ТКП-1.20.B 1590BB Potentiometer Board 18 3x17 [REV1B]: project files are moved to cipher-based storage directory
    [ТКП-1.20.B-1.kicad_pcb, ТКП-1.20.B-1.sch, ТКП-1.20.B-2.kicad_pcb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]
2023-12-09 ТКП-1.26.B 1590N1 Potentiometer Board 18 2x17 [REV1B]: project files are moved to cipher-based storage directory
    [ТКП-1.26.B-1.kicad_pcb, ТКП-1.26.B-1.sch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]
2023-12-09 ТКП-1.26.C 1590N1 Potentiometer Board 18 2x17 [REV1C]: project files are moved to cipher-based storage directory
    [ТКП-1.26.C-1.kicad_pcb, ТКП-1.26.C-1.sch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]
2023-12-10 ТКП-1.26.C-1 Тремоло Саши Огородникова Potentiometer Board [REV1C]: some changes
    [ТКП-1.26.C-1.kicad_pcb, ТКП-1.26.C-1.sch]
2023-12-17 ТКП-1.39.A-1 Salty Phaser Potentiometer Board [REV2A] files added
    [ТКП-1.39.A-1.kicad_pcb, ТКП-1.39.A-1.sch]
2023-12-17 ТКП-1.39.A-1 Salty Phaser Potentiometer Board [REV2A]: some changes
    [ТКП-1.39.A-1.kicad_pcb, ТКП-1.39.A-1.sch]
2023-12-18 ТКП-3.42.A Spacer PJ-644C [REV1A] files added
    [ТКП-3.42.A.kicad_pcb, ТКП-3.42.A.sch]
2023-12-19 ТКП-3.35.A Spacer PBS-24-302SP [REV1A]: project files are moved to cipher-based storage directory
    [spacer_PBS-24-302SP_r1a.sch, ТКП-3.35.A.kicad_pcb, ТКП-3.35.A.sch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]
2023-12-19 ТКП-3.36.A Spacer MTS-1xx-A2 [REV1A]: project files are moved to cipher-based storage directory
    [spacer_MTS-1xx-A2_r1a.sch, ТКП-3.36.A.kicad_pcb, ТКП-3.36.A.sch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]
2023-12-19 ТКП-1.35.A 1590N1 Potentiometer Board 18 2x17 [REV2A]: project files are moved to cipher-based storage directory
    [ТКП-1.35.A-1.kicad_pcb, ТКП-1.35.A-1.sch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]
2023-12-19 ТКП-1.35.A-1 Тремоло Саши Огородникова Potentiometer Board [REV2A]: some changes
    [ТКП-1.35.A-1.kicad_pcb, ТКП-1.35.A-1.sch]
2023-12-19 ТКП-1.29.A 1590N1 Potentiometer Board 18 3x17 [REV1A]: project files are moved to cipher-based storage directory
    [ТКП-1.29.A-1.kicad_pcb, ТКП-1.29.A-1.sch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]
2023-12-20 ТКП-1.29.A-1 Edamamer Potentiometer Board [REV1A]: some changes
    [ТКП-1.29.A-1.kicad_pcb, ТКП-1.29.A-1.sch]
2023-12-20 ТКП-1.23.A-1 Salty Phaser [REV1A]: VE2 added, some screws changed from M3x6 to M3x8, other minor changes
    [ТКП-1.23.A-1.kicad_pcb, ТКП-1.23.A-1.sch]
2023-12-20 ТКП-1.23.B-1 Salty Phaser [REV1B]: VE1 changed from ТКП-6.1.1.A1-2 to ТКП-6.1.1.B1-1, other minor changes
    [ТКП-1.23.B-1.kicad_pcb, ТКП-1.23.B-1.sch]
2023-12-22 ТКП-1.23.B-1 Salty Phaser [REV1B]: VE2 changed to ТКП-6.1.5.A1-1
    [ТКП-1.23.B-1.kicad_pcb, ТКП-1.23.B-1.sch]
2023-12-23 Enclosure parts: ТКП-6.1.5.A1 added
    [ТКП-6.1.5.A1_1590BB_Panel_A_V1.FCStd]
2023-12-24 Salty Phaser [REV1SM]: some engraving files added
    [salty_phaser_r1sm_bottom.dxf]
2024-01-07 ТКП-1.23.B-1 Salty Phaser [REV1B]: X1 changed to X
    [ТКП-1.23.B-1.kicad_pcb, ТКП-1.23.B-1.sch]
2024-01-13 ТКП-1.27.A 1590N1 Connector Board [REV1A]: project files are moved to cipher-based storage directory
    [1590N1_connector_board_r1a-B_Cu.gbr, 1590N1_connector_board_r1a-B_Mask.gbr, 1590N1_connector_board_r1a-B_SilkS.gbr, 1590N1_connector_board_r1a-Edge_Cuts.gbr, 1590N1_connector_board_r1a-F_Cu.gbr, 1590N1_connector_board_r1a-F_Mask.gbr, 1590N1_connector_board_r1a-F_SilkS.gbr, 1590N1_connector_board_r1a.drl]
2024-01-13 ТКП-1.27.A-1 1590N1 Connector Board [REV1A] A: minor changes
    [ТКП-1.27.A-1.kicad_pcb, ТКП-1.27.A-1.sch]
2024-01-13 ТКП-1.27.A-1 1590N1 Connector Board [REV1A] A: technical requirements added
    [ТКП-1.27.A-1.kicad_pcb, ТКП-1.27.A-1.sch]
2024-01-13 ТКП-1.27.A-1 1590N1 Connector Board [REV1A] A: output files updated
2024-01-13 ТКП-1.27.A-2 1590N1 Connector Board [REV1A] B files added
    [ТКП-1.27.A-2.kicad_pcb, ТКП-1.27.A-2.sch]
2024-01-14 ТКП-1.34.A 1590BB2 Connector Board Extended [REV1A]: project files are moved to cipher-based storage directory
    [1590BB2_connector_board_extended_r1a-B_Cu.gbr, 1590BB2_connector_board_extended_r1a-B_Mask.gbr, 1590BB2_connector_board_extended_r1a-B_SilkS.gbr, 1590BB2_connector_board_extended_r1a-Edge_Cuts.gbr, 1590BB2_connector_board_extended_r1a-F_Cu.gbr, 1590BB2_connector_board_extended_r1a-F_Mask.gbr, 1590BB2_connector_board_extended_r1a-F_SilkS.gbr, 1590BB2_connector_board_extended_r1a.drl]
2024-01-14 ТКП-1.34.A-1 1590BB2 Connector Board Extended [REV1A] A: minor changes
    [ТКП-1.34.A-1.kicad_pcb, ТКП-1.34.A-1.sch]
2024-01-14 ТКП-1.34.A-1 1590BB2 Connector Board Extended [REV1A] A: some changes, technical requirements added, output files updated
    [ТКП-1.34.A-1.kicad_pcb, ТКП-1.34.A-1.sch]
2024-01-14 ТКП-1.33.A 1590BB2 Potentiometer Board 18 3x17 [REV1A]: project files are moved to cipher-based storage directory
    [ТКП-1.33.A-1.kicad_pcb, ТКП-1.33.A-1.sch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]
2024-01-16 ТКП-3.41.A 1590BB Potentiometer Board 18 3x17 [REV2A]: gerbers added
    [1590BB_potentiometer_board_18_3x17_r2a-B_Cu.gbr, 1590BB_potentiometer_board_18_3x17_r2a-B_Mask.gbr, 1590BB_potentiometer_board_18_3x17_r2a-B_SilkS.gbr, 1590BB_potentiometer_board_18_3x17_r2a-Edge_Cuts.gbr, 1590BB_potentiometer_board_18_3x17_r2a-F_Mask.gbr, 1590BB_potentiometer_board_18_3x17_r2a-F_SilkS.gbr, 1590BB_potentiometer_board_18_3x17_r2a.drl]
2024-01-19 ТКП-1.33.A-1 Crumbwave Multiplexer Potentiometer Board [REV1A]: some changes, output files updated
    [ТКП-1.33.A-1.kicad_pcb, ТКП-1.33.A-1.sch]
2024-01-19 ТКП-1.30.A Big Muff [REV3A]: project files are moved to cipher-based storage directory
    [ТКП-1.30.A-1.kicad_pcb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]
2024-01-21 ТКП-1.30.A Big Muff [REV3A]: minor changes
    [ТКП-1.30.A-1.kicad_pcb, ТКП-1.30.A-1.sch, ТКП-1.30.A-2.kicad_pcb, ТКП-1.30.A-2.sch]
2024-01-21 ТКП-1.30.A Big Muff [REV3A]: output files updated
2024-01-21 ТКП-1.17.B-1 Deep Blue Delay [REV3B]: minor changes
    [ТКП-1.17.B-1.kicad_pcb]
2024-01-29 ТКП-1.30.A-3 and ТКП-1.30.A-4 files added
    [ТКП-1.30.A-3.kicad_pcb, ТКП-1.30.A-3.sch, ТКП-1.30.A-4.kicad_pcb, ТКП-1.30.A-4.sch]
2024-01-30 SBEL: ТКП-6.3.1.A1 and ТКП-6.3.1.B1 added
2024-01-31 ТКП-1.30.A-3 and ТКП-1.30.A-4: VE1 changed, VE2 added, washers removed, remaining output files added
    [ТКП-1.30.A-3.kicad_pcb, ТКП-1.30.A-3.sch, ТКП-1.30.A-4.kicad_pcb, ТКП-1.30.A-4.sch]
2024-02-03 ТКП-3.42.A Spacer PJ-644C [REV1A]: gerbers added
    [spacer_PJ-644C_r1a-Edge_Cuts.gbr]
2024-02-04 Fuzz Factory [REV1SM]: some engraving files added
    [fuzz_factory_r1sm_1.dxf]
2024-02-05 Fuzz Factory [REV1SM]: some engraving files corrected
    [fuzz_factory_r1sm_1.dxf]
2024-02-06 Fuzz Factory [REV1SM]: remaining engraving files added
    [fuzz_factory_r1sm_bottom.dxf]
2024-02-10 Salty Phaser [REV1SM]: remaining engraving files added
    [salty_phaser_r1sm_1.dxf]
2024-02-15 Fuzz Factory [REV1SM]: some engraving files modified
    [fuzz_factory_r1sm_bottom.dxf]
2024-03-02 Enclosure parts: ТКП-6.4.1.A1 added
    [ТКП-6.4.1.A1_B013-H_Base_A1.FCStd]
2024-03-02 Enclosure parts: ТКП-6.4.2.A1.A1 added
    [ТКП-6.4.2.A1.A1_B013-H_Box_A1-A1.FCStd]
2024-03-02 ТКП-1.39.A-1 Salty Phaser Potentiometer Board [REV2A]: some changes, remaining output files added
    [ТКП-1.39.A-1.kicad_pcb, ТКП-1.39.A-1.sch]
2024-03-02 ТКП-1.23.B-1 Salty Phaser [REV1B]: RPB1.1…3 changed from R16K1-L20KC to PDB181-K420K
    [ТКП-1.23.B-1.sch]
2024-04-29 ТКП-1.31.A Potentiometer Board 18 1x17 [REV1A]: project files are moved to cipher-based storage directory
    [ТКП-1.31.A-1.kicad_pcb, ТКП-1.31.A-1.sch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]
2024-04-29 ТКП-1.31.A-1 Potentiometer Board 18 1x17 [REV1A] R16K1-20KC-A100K: some changes, output files updated
    [ТКП-1.31.A-1.kicad_pcb, ТКП-1.31.A-1.sch]
2024-04-29 ТКП-1.31.A-3 Potentiometer Board 18 1x17 [REV1A] R16K1-20F-B50K files added
    [ТКП-1.31.A-3.kicad_pcb, ТКП-1.31.A-3.sch]
2024-04-29 ТКП-1.31.A-2 Potentiometer Board 18 1x17 [REV1A] R16K1-20KC-B100K Trimmed files added
    [ТКП-1.31.A-2.kicad_pcb, ТКП-1.31.A-2.sch]
2024-05-11 SBEL: ТКП-6.4.1.A1 added
2024-05-19 ТКП-1.18.A Potentiometer Board 20 1x17 [REV1A]: project files are moved to cipher-based storage directory
    [ТКП-1.18.A-1.kicad_pcb, ТКП-1.18.A-1.sch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]
2024-05-19 ТКП-1.18.A-1 Potentiometer Board 20 1x17 [REV1A] R16K1-20F-B50K: some changes, output files updated
    [ТКП-1.18.A-1.kicad_pcb, ТКП-1.18.A-1.sch]
2024-05-19 ТКП-1.18.A-2 Potentiometer Board 20 1x17 [REV1A] R16K1-20F-B50K Trimmed files added
    [ТКП-1.18.A-2.kicad_pcb, ТКП-1.18.A-2.sch]
2024-05-20 ТКП-1.13.A Big Muff [REV2A]: project files are moved to cipher-based storage directory
    [ТКП-1.13.A-1.kicad_pcb, ТКП-1.13.A-1.sch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]
2024-05-20 ТКП-1.13.A Big Muff [REV2A]: minor changes
    [ТКП-1.13.A-1.kicad_pcb, ТКП-1.13.A-1.sch, ТКП-1.13.A-2.kicad_pcb, ТКП-1.13.A-2.sch]
2024-05-24 ТКП-1.13.A Big Muff [REV2A]: output files updated
2024-05-25 ТКП-1.11.A-1 Distortion + [REV2A]: project files are moved to cipher-based storage directory
    [ТКП-1.11.A-1.kicad_pcb, ТКП-1.11.A-1.sch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]
2024-05-25 ТКП-1.11.A-1 Distortion + [REV2A]: minor changes
    [ТКП-1.11.A-1.kicad_pcb, ТКП-1.11.A-1.sch]
2024-05-26 ТКП-1.11.A-1 Distortion + [REV2A]: minor changes, output files updated
    [ТКП-1.11.A-1.kicad_pcb]
2024-05-26 ТКП-1.12.A-1 Little Angel Chorus [REV1A]: project files are moved to cipher-based storage directory
    [ТКП-1.12.A-1.kicad_pcb, ТКП-1.12.A-1.sch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]
2024-06-02 Enclosure parts: ТКП-6.1.5.B1 added
    [ТКП-6.1.5.B1_1590BB_Panel_B_V1.FCStd]
2024-06-02 Enclosure parts: ТКП-6.1.5.C1 added
    [ТКП-6.1.5.C1_1590BB_Panel_C_V1.FCStd]
2024-06-02 SBEL: ТКП-6.1.5.B1 and ТКП-6.1.5.C1 added
2024-06-06 Good Grief Overdrive [REV1SM] and Копка Земли [REV1SM]: new versions of engraving files added
    [good_grief_overdrive_r1sm_bottom_2.dxf, копка_земли_r1sm_bottom_2.dxf]
2024-06-08 ТКП-1.19.B-1 Good Grief Overdrive [REV1B]: minor changes
    [ТКП-1.19.B-1.kicad_pcb, ТКП-1.19.B-1.sch]
2024-06-08 ТКП-1.19.B-2 Good Grief Overdrive [REV1B] SM: RPB1.1…3 changed from R16K1-L20KC to PDB181-K420K, VE1 changed from ТКП-6.1.1.A1-1 to ТКП-6.1.1.B1-2, VE2 changed from ТКП-6.1.3.A1-1 to ТКП-6.1.5.B1-1, 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
    [ТКП-1.19.B-2.kicad_pcb, ТКП-1.19.B-2.sch]
2024-06-08 ТКП-1.19.B-2 Good Grief Overdrive [REV1B] SM: VLS1 changed from BR-17.8 to BR-12.7
    [ТКП-1.19.B-2.kicad_pcb, ТКП-1.19.B-2.sch]
2024-06-09 ТКП-1.19.A-1 Good Grief Overdrive [REV1A]: project files are moved to cipher-based storage directory
    [ТКП-1.19.A-1.kicad_pcb, ТКП-1.19.A-1.sch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]
2024-06-09 ТКП-1.19.A-1 Good Grief Overdrive [REV1A]: minor changes, output files updated
    [ТКП-1.19.A-1.kicad_pcb]
2024-06-15 ТКП-1.39.A-2 Good Grief Overdrive Potentiometer Board [REV2A] files added
    [ТКП-1.39.A-2.kicad_pcb, ТКП-1.39.A-2.sch]
2024-06-15 ТКП-1.39.A-3 Копка Земли Potentiometer Board [REV2A] files added
    [ТКП-1.39.A-3.kicad_pcb, ТКП-1.39.A-3.sch]
2024-06-16 ТКП-1.12.A-1 Little Angel Chorus [REV1A]: minor changes
    [ТКП-1.12.A-1.kicad_pcb, ТКП-1.12.A-1.sch]
2024-06-16 ТКП-1.12.A-1 Little Angel Chorus [REV1A]: minor changes, output files updated
    [ТКП-1.12.A-1.kicad_pcb]
2024-06-17 ТКП-1.24.A Копка Земли [REV1A]: project files are moved to cipher-based storage directory
    [ТКП-1.24.A-1.kicad_pcb, ТКП-1.24.A-1.sch, ТКП-1.24.A-2.kicad_pcb, ТКП-1.24.A-2.sch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]
2024-06-19 ТКП-1.24.A Копка Земли [REV1A]: minor changes
    [ТКП-1.24.A-1.kicad_pcb, ТКП-1.24.A-1.sch, ТКП-1.24.A-2.kicad_pcb, ТКП-1.24.A-2.sch]
2024-06-20 ТКП-1.24.A Копка Земли [REV1A]: output files updated
2024-06-21 Fuzz Factory [MB:REV1C/PB:REV1B]: minor changes
    [fuzz_factory_r1c_r1b.kicad_pcb]
2024-06-26 SBKCL-TH-ML: RPB-18-1x17-1.6-PNL-7.4-2.8 footprint modified
2024-06-27 SBKCL-TH-ML: RPB-20-1x17-1.6-PNL-7.4-2.8 footprint added
2024-07-07 ТКП-1.30.B-1 Big Muff [REV3B] NYC files added
    [ТКП-1.30.B-1.kicad_pcb, ТКП-1.30.B-1.sch]
2024-07-07 ТКП-1.17.C-1 Deep Blue Delay [REV3C] files added
    [ТКП-1.17.C-1.kicad_pcb, ТКП-1.17.C-1.sch]
2024-07-09 ТКП-1.24.B-3 Копка Земли [REV1B] Down-Tuned SM: VE2 changed from ТКП-6.1.3.C1-1 to ТКП-6.1.5.C1-1, X3 changed to X, other minor changes
    [ТКП-1.24.B-3.kicad_pcb, ТКП-1.24.B-3.sch]
2024-07-21 ТКП-1.17.B-1 Deep Blue Delay [REV3B]: VE1 changed from B013_D1 to B013_E1, VLS1 changed from BR-17.8 to BR-12.7, VMH1 and VMH2 changed from DI5M3x20 to DI5M3x18, screws DIN 965 changed to DIN 7985
    [ТКП-1.17.B-1.kicad_pcb, ТКП-1.17.B-1.sch]
2024-07-27 ТКП-1.17.B-2 Deep Blue Delay [REV3B] SM files added
    [ТКП-1.17.B-2.kicad_pcb, ТКП-1.17.B-2.sch]
2024-07-27 ТКП-1.30.A-3 and ТКП-1.30.A-4: spacer ТКП-3.35.A removed, other minor changes
    [ТКП-1.30.A-3.kicad_pcb, ТКП-1.30.A-3.sch, ТКП-1.30.A-4.kicad_pcb, ТКП-1.30.A-4.sch]
2024-08-01 ТКП-1.31.A-4, ТКП-1.31.A-5, and ТКП-1.31.A-6 files added
    [ТКП-1.31.A-4.kicad_pcb, ТКП-1.31.A-4.sch, ТКП-1.31.A-5.kicad_pcb, ТКП-1.31.A-5.sch, ТКП-1.31.A-6.kicad_pcb, ТКП-1.31.A-6.sch]
2024-08-04 Копка Земли [REV2SM] Down-Tuned: some engraving files added
2024-08-04 Копка Земли [REV2SM] Down-Tuned: remaining engraving files added
    [копка_земли_r2sm_bottom_1.dxf, копка_земли_r2sm_down-tuned_1.dxf]
2024-08-07 ТКП-3.30.B Big Muff [REV3B]: gerbers added
    [big_muff_r3b-B_Cu.gbr, big_muff_r3b-B_Mask.gbr, big_muff_r3b-Edge_Cuts.gbr, big_muff_r3b-F_Cu.gbr, big_muff_r3b-F_Mask.gbr, big_muff_r3b-F_Paste.gbr, big_muff_r3b-F_SilkS.gbr, big_muff_r3b.drl]
2024-08-07 ТКП-3.17.C Deep Blue Delay [REV3C]: gerbers added
    [deep_blue_delay_r3c-B_Cu.gbr, deep_blue_delay_r3c-B_Mask.gbr, deep_blue_delay_r3c-B_SilkS.gbr, deep_blue_delay_r3c-Edge_Cuts.gbr, deep_blue_delay_r3c-F_Cu.gbr, deep_blue_delay_r3c-F_Mask.gbr, deep_blue_delay_r3c-F_Paste.gbr, deep_blue_delay_r3c-F_SilkS.gbr]
2024-08-09 ТКП-3.43.A Spacer PBS-24-302SP [REV2A] files added
    [ТКП-3.43.A.kicad_pcb, ТКП-3.43.A.sch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]
2024-08-10 Fishtaur [REV1SM]: new versions of engraving files added
    [fishtaur_r1sm_bottom_2.dxf]
2024-08-11 Enclosure parts: ТКП-6.1.5.D1 added
    [ТКП-6.1.5.D1_1590BB_Panel_D_V1.FCStd]
2024-08-24 ТКП-1.28.A-1 Edamamer [REV1A]: project files are moved to cipher-based storage directory
    [edamamer_r1a-B_Cu.gbr, edamamer_r1a-B_Mask.gbr, edamamer_r1a-B_SilkS.gbr, edamamer_r1a-Edge_Cuts.gbr, edamamer_r1a-F_Cu.gbr, edamamer_r1a-F_Mask.gbr, edamamer_r1a-F_SilkS.gbr, edamamer_r1a.drl]
2024-08-24 ТКП-1.28.A-1 Edamamer [REV1A]: minor changes
    [ТКП-1.28.A-1.kicad_pcb, ТКП-1.28.A-1.sch]
2024-08-25 ТКП-1.28.A-1 Edamamer [REV1A]: output files updated
2024-08-31 Fuzz Factory [MB:REV1D/PB:REV1C]: project files are moved to cipher-based storage directory
    [fuzz_factory_main_board_r1d-B_Cu.gbr, fuzz_factory_main_board_r1d-B_Mask.gbr, fuzz_factory_main_board_r1d-Edge_Cuts.gbr, fuzz_factory_main_board_r1d-F_SilkS.gbr, fuzz_factory_main_board_r1d.drl, fuzz_factory_potentiometer_board_r1c-B_Cu.gbr, fuzz_factory_potentiometer_board_r1c-B_Mask.gbr, fuzz_factory_potentiometer_board_r1c-Edge_Cuts.gbr]
2024-09-01 Fuzz Factory [MB:REV1D/PB:REV1C]: minor changes, output files updated
    [ТКП-1.14.D-1-ТКП-1.15.C-1.kicad_pcb, ТКП-1.14.D-1-ТКП-1.15.C-1.sch]
2024-09-01 Fuzz Factory [MB:REV1C/PB:REV1B]: project files are moved to cipher-based storage directory
    [ТКП-1.14.C-1-ТКП-1.15.B-1.kicad_pcb, ТКП-1.14.C-1-ТКП-1.15.B-1.sch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]
2024-09-01 Fuzz Factory [MB:REV1C/PB:REV1B]: minor changes, output files updated
    [ТКП-1.14.C-1-ТКП-1.15.B-1.kicad_pcb]
2024-09-01 Fuzz Factory [MB:REV1B/PB:REV1B]: project files are moved to cipher-based storage directory
    [fuzz_factory_main_board_r1b-B_Cu.gbr, fuzz_factory_main_board_r1b-B_Mask.gbr, fuzz_factory_main_board_r1b-Edge_Cuts.gbr, fuzz_factory_main_board_r1b-F_SilkS.gbr, fuzz_factory_main_board_r1b.drl, fuzz_factory_potentiometer_board_r1b-B_Cu.gbr, fuzz_factory_potentiometer_board_r1b-B_Mask.gbr, fuzz_factory_potentiometer_board_r1b-Edge_Cuts.gbr]
2024-09-01 Fuzz Factory [MB:REV1B/PB:REV1B]: minor changes
    [ТКП-1.14.B-1-ТКП-1.15.B-1.sch]
2024-09-03 Fuzz Factory [MB:REV1B/PB:REV1B]: jumpers VJ1, VJ2 and trace cuts VTC1, VTC2 added
    [ТКП-1.14.B-1-ТКП-1.15.B-1.kicad_pcb, ТКП-1.14.B-1-ТКП-1.15.B-1.sch]
2024-09-04 Fuzz Factory [MB:REV1B/PB:REV1B]: minor changes, output files updated
    [ТКП-1.14.B-1-ТКП-1.15.B-1.kicad_pcb]
2024-09-14 ТКП-3.35.A Spacer PBS-24-302SP [REV1A]: minor changes
    [ТКП-3.35.A.kicad_pcb]
2024-09-14 ТКП-3.42.A Spacer PJ-644C [REV1A]: minor changes
    [ТКП-3.42.A.kicad_pcb]
2024-09-14 ТКП-3.36.A Spacer MTS-1xx-A2 [REV1A]: minor changes
    [ТКП-3.36.A.kicad_pcb]
2024-10-09 ТКП-1.22.A-1 Fishtaur Potentiometer Board [REV1A]: project files are moved to cipher-based storage directory
    [ТКП-1.22.A-1.kicad_pcb, ТКП-1.22.A-1.sch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]
2024-10-09 ТКП-1.22.B-1 Fishtaur Potentiometer Board [REV1B]: project files are moved to cipher-based storage directory
    [ТКП-1.22.B-1.kicad_pcb, ТКП-1.22.B-1.sch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]
2024-10-09 ТКП-1.22.A-1 Fishtaur Potentiometer Board [REV1A]: minor changes
    [ТКП-1.22.A-1.kicad_pcb, ТКП-1.22.A-1.sch]
2024-10-09 ТКП-1.22.B-1 Fishtaur Potentiometer Board [REV1B]: minor changes
    [ТКП-1.22.B-1.kicad_pcb, ТКП-1.22.B-1.sch]
2024-10-09 ТКП-1.22.A-1 Fishtaur Potentiometer Board [REV1A]: minor changes, output files updated
    [ТКП-1.22.A-1.kicad_pcb, ТКП-1.22.A-1.sch]
2024-10-09 ТКП-1.22.B-1 Fishtaur Potentiometer Board [REV1B]: minor changes, output files updated
    [ТКП-1.22.B-1.kicad_pcb, ТКП-1.22.B-1.sch]
2024-10-11 ТКП-1.23.B-1 Salty Phaser [REV1B]: MS.R1 value changed from 330 to 300 Ohm, MS.R2 value changed from 68 to 62 Ohm, MS.R9 value changed from 47 to 220 Ohm
    [ТКП-1.23.B-1.kicad_pcb, ТКП-1.23.B-1.sch]
2024-11-25 StompBoxes' Enclosure Part Library (SBEPL) created
2024-11-29 SBEL: ТКП-6.3.1.A2 added
2024-11-29 ТКП-1.36.A-3 and ТКП-1.36.A-4 files added
    [ТКП-1.36.A-3.kicad_pcb, ТКП-1.36.A-3.sch, ТКП-1.36.A-4.kicad_pcb, ТКП-1.36.A-4.sch]
2024-11-30 ТКП-1.36.A-3 and ТКП-1.36.A-4: some changes
    [ТКП-1.36.A-3.kicad_pcb, ТКП-1.36.A-3.sch, ТКП-1.36.A-4.kicad_pcb, ТКП-1.36.A-4.sch]
2024-11-30 ТКП-1.36.A-3 and ТКП-1.36.A-4: some output files added
2024-12-01 SBEL: ТКП-6.3.1 parts moved to SBEPL
2024-12-01 ТКП-1.36.A-3 and ТКП-1.36.A-4: some changes, remaining output files added
    [ТКП-1.36.A-3.kicad_pcb, ТКП-1.36.A-3.sch, ТКП-1.36.A-4.kicad_pcb, ТКП-1.36.A-4.sch]
2024-12-06 ТКП-1.17.C-1 Deep Blue Delay [REV3C]: output files added
2024-12-06 ТКП-1.17.C-2 Deep Blue Delay [REV3C] SM files added
    [ТКП-1.17.C-2.kicad_pcb, ТКП-1.17.C-2.sch]
2024-12-07 ТКП-1.17.C-2 Deep Blue Delay [REV3C] SM: some changes, output files added
    [ТКП-1.17.C-2.kicad_pcb, ТКП-1.17.C-2.sch]
2024-12-08 SBEL: ТКП-6.1.1, ТКП-6.1.3, and ТКП-6.1.5 parts moved to SBEPL
2024-12-10 ТКП-1.17.C Deep Blue Delay [REV3C]: minor changes
    [ТКП-1.17.C-1.sch, ТКП-1.17.C-2.sch]
2024-12-12 ТКП-1.32.A-1 Crumbwave Multiplexer [REV1A]: project files are moved to cipher-based storage directory
    [crumbwave_multiplexer_r1a-B_Cu.gbr, crumbwave_multiplexer_r1a-B_Mask.gbr, crumbwave_multiplexer_r1a-B_SilkS.gbr, crumbwave_multiplexer_r1a-Edge_Cuts.gbr, crumbwave_multiplexer_r1a-F_Cu.gbr, crumbwave_multiplexer_r1a-F_Mask.gbr, crumbwave_multiplexer_r1a-F_SilkS.gbr, crumbwave_multiplexer_r1a.drl]
2024-12-13 ТКП-1.32.A-1 Crumbwave Multiplexer [REV1A]: minor changes
    [ТКП-1.32.A-1.kicad_pcb, ТКП-1.32.A-1.sch]
2024-12-14 ТКП-1.32.A-1 Crumbwave Multiplexer [REV1A]: output files updated
2024-12-14 ТКП-1.25.B-1 Тремоло Саши Огородникова [REV1B]: project files are moved to cipher-based storage directory
    [ТКП-1.25.B-1.kicad_pcb, ТКП-1.25.B-1.sch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]
2024-12-14 ТКП-1.25.B-1 Тремоло Саши Огородникова [REV1B]: minor changes
    [ТКП-1.25.B-1.kicad_pcb]
2024-12-14 ТКП-1.25.B-1 Тремоло Саши Огородникова [REV1B]: output files updated
2024-12-15 ТКП-1.25.A-1 Тремоло Саши Огородникова [REV1A]: project files are moved to cipher-based storage directory
    [ТКП-1.25.A-1.kicad_pcb, ТКП-1.25.A-1.sch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]
2024-12-15 ТКП-1.25.A-1 Тремоло Саши Огородникова [REV1A]: minor changes
    [ТКП-1.25.A-1.kicad_pcb]
2024-12-15 ТКП-1.25.A-1 Тремоло Саши Огородникова [REV1A]: jumpers VJ1…4 and trace cuts VTC1…5 added
    [ТКП-1.25.A-1.kicad_pcb, ТКП-1.25.A-1.sch]
2024-12-15 ТКП-1.25.A-1 Тремоло Саши Огородникова [REV1A]: technical requirements added
    [ТКП-1.25.A-1.kicad_pcb]
2024-12-16 ТКП-1.25.A-1 Тремоло Саши Огородникова [REV1A]: some changes
    [ТКП-1.25.A-1.sch]
2024-12-17 ТКП-1.25.A-1 Тремоло Саши Огородникова [REV1A]: some changes, output files updated
    [ТКП-1.25.A-1.sch]
2024-12-17 ТКП-1.25.A-1 Тремоло Саши Огородникова [REV1A]: remaining output files added
2024-12-18 ТКП-1.26.A 1590N1 Potentiometer Board 18 2x17 [REV1A]: project files are moved to cipher-based storage directory
    [ТКП-1.26.A-1.kicad_pcb, ТКП-1.26.A-1.sch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]
2024-12-18 ТКП-1.26.A-1 Тремоло Саши Огородникова Potentiometer Board [REV1A]: some changes, output files updated
    [ТКП-1.26.A-1.kicad_pcb, ТКП-1.26.A-1.sch]
2024-12-27 SBEL: ТКП-6.2.2.A1 part moved to SBEPL
2024-12-29 ТКП-1.35.A-1 Тремоло Саши Огородникова Potentiometer Board [REV2A]: RP1 and RP2 replaced from R16K1-L20KC with PDB181-K420K
    [ТКП-1.35.A-1.sch]
2024-12-30 ТКП-1.17.B-2 Deep Blue Delay [REV3B] SM: VE1 replaced from ТКП-6.3.1.A1-1 with ТКП-6.3.1.A2.A1.A.1-1, VE2 cipher changed from ТКП-6.3.3.A1-1 to ТКП-6.3.3.A1.A1.2-1.A1.00
    [ТКП-1.17.B-2.kicad_pcb, ТКП-1.17.B-2.sch]
2024-12-30 ТКП-1.30.A-3 Big Muff [REV3A] NYC SM: RP1…3 replaced from R16K1-L20KC with PDB181-K420K, VE1 replaced from ТКП-6.3.1.A1-1 with ТКП-6.3.1.A2.A1.A.1-1, VE2 cipher changed from ТКП-6.3.3.A1-1 to ТКП-6.3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
    [ТКП-1.30.A-3.kicad_pcb, ТКП-1.30.A-3.sch]
2024-12-30 ТКП-1.30.A-4 Big Muff [REV3A] Bass SM: RP1…3 replaced from R16K1-L20KC with PDB181-K420K, VE1 replaced from ТКП-6.3.1.A1-1 with ТКП-6.3.1.A2.A1.A.1-1, VE2 cipher changed from ТКП-6.3.3.A1-1 to ТКП-6.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
    [ТКП-1.30.A-4.kicad_pcb, ТКП-1.30.A-4.sch]
2024-12-31 ТКП-1.23.B-1 Salty Phaser [REV1B]: VE1 cipher changed from ТКП-6.1.1.B1-1 to ТКП-6.1.1.A1.B1.A.1-1, VE2 cipher changed from ТКП-6.1.5.A1-1 to ТКП-6.1.3.A2.D1.2-1.D1.E1
    [ТКП-1.23.B-1.kicad_pcb, ТКП-1.23.B-1.sch]
2025-01-01 ТКП-1.19.B-2 Good Grief Overdrive [REV1B] SM: VE1 cipher changed from ТКП-6.1.1.B1-2 to ТКП-6.1.1.A1.B1.A.1-2, VE2 cipher changed from ТКП-6.1.5.B1-1 to ТКП-6.1.3.A2.A1.2-2.C1.A1
    [ТКП-1.19.B-2.kicad_pcb, ТКП-1.19.B-2.sch]
2025-01-02 ТКП-1.19.B-2 Good Grief Overdrive [REV1B] SM: D1 replaced from LM833N with RC4558P, R10 and R11 tolerance changed from 5% to 1%
    [ТКП-1.19.B-2.kicad_pcb, ТКП-1.19.B-2.sch]
2025-01-02 ТКП-1.19.B-1 Good Grief Overdrive [REV1B]: D1 replaced from LM833N with RC4558P, R10 and R11 tolerance changed from 5% to 1%
    [ТКП-1.19.B-1.kicad_pcb, ТКП-1.19.B-1.sch]
2025-01-02 ТКП-1.24.B-3 Копка Земли [REV1B] Down-Tuned SM: VE1 cipher changed from ТКП-6.1.1.A1-2 to ТКП-6.1.1.A1.A1.A.1-1, VE2 cipher changed from ТКП-6.1.5.C1-1 to ТКП-6.1.3.A2.C1.2-1.B2.C1
    [ТКП-1.24.B-3.kicad_pcb, ТКП-1.24.B-3.sch]
2025-01-02 ТКП-1.24.B-4 Копка Земли [REV1B] Standard-Tuned SM: VE1 cipher changed from ТКП-6.1.1.A1-2 to ТКП-6.1.1.A1.A1.A.1-1, VE2 cipher changed from ТКП-6.1.3.C1-2 to ТКП-6.1.3.A1.C1.2-1.B1.D1
    [ТКП-1.24.B-4.kicad_pcb, ТКП-1.24.B-4.sch]
2025-01-03 ТКП-1.21.A-2 Fishtaur [REV1A] SM: VE1 cipher changed from ТКП-6.1.1.A1-2 to ТКП-6.1.1.A1.A1.A.1-1, VE2 cipher changed from ТКП-6.1.3.B1-1 to ТКП-6.1.3.A1.B1.2-1.A1.B1
    [ТКП-1.21.A-2.kicad_pcb, ТКП-1.21.A-2.sch]
2025-01-03 SBEL: ТКП-6.1.4.A1 part moved to SBEPL
2025-01-04 ТКП-1.23.A-1 Salty Phaser [REV1A]: VE2 cipher changed from ТКП-6.1.4.A1-1 to ТКП-6.1.4.A1.A1.2-1.A1, XS2 and XS3 replaced from PJ-309 with ST-008S-05/04
    [ТКП-1.23.A-1.kicad_pcb, ТКП-1.23.A-1.sch]
2025-01-04 SBEL: ТКП-6.4.1.A1 part moved to SBEPL
2025-01-05 Graphic layouts storage method transformed (in progress)
    [good_grief_overdrive_r1sm_bottom.dxf, ТКП-6.1.3-B-A1.3_dxf_outline.dxf, ТКП-6.1.3-B-A2.3_dxf_outline.dxf, ТКП-6.1.3-B-B1.3_dxf_outline.dxf, ТКП-6.1.3-B-B2.3_dxf_outline.dxf, ТКП-6.1.3-B-C1.3_dxf_outline.dxf, ТКП-6.1.3-B-D1.3_dxf_outline.dxf, ТКП-6.1.3-T-A1.4_dxf_outline.dxf]
2025-01-23 Great Depression Phaser [REV1SM]: some engraving files added
    [ТКП-6.2.4-B-A2.3_dxf_outline.dxf]
2025-01-24 Great Depression Phaser [REV1SM]: remaining engraving files added
    [ТКП-6.2.4-T-B1.4_dxf_outline.dxf]
2025-01-25 Great Depression Phaser [REV1]: some UV-printing files added
2025-01-25 Great Depression Phaser [REV1]: remaining UV-printing files added
2025-01-26 ТКП-1.38.A-1 Great Depression Phaser [REV1A]: title changed, FB.R2 value changed from X to 27 kOhm, L.R3 value changed from X to 0, LA.R5 value changed from 4.7 to 6.8 kOhm, RPB1.1 and RPB1.2 replace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
    [ТКП-1.38.A-1.kicad_pcb, ТКП-1.38.A-1.sch]
2025-01-27 ТКП-1.26.B-2 Great Depression Phaser Potentiometer Board [REV1B] files added
    [ТКП-1.26.B-2.kicad_pcb, ТКП-1.26.B-2.sch]
2025-01-27 ТКП-1.26.C-2 Great Depression Phaser Potentiometer Board [REV1C] files added
    [ТКП-1.26.C-2.kicad_pcb, ТКП-1.26.C-2.sch]
2025-02-19 Great Depression Phaser [REV1SM]: engraving files updated
    [ТКП-6.2.4-T-B1.4_dxf_outline.dxf]
2025-02-19 Great Depression Phaser [REV1]: UV-printing files updated
2025-05-04 ТКП-1.38.A-2 Great Depression Phaser [REV1A] SM files added
    [ТКП-1.38.A-2.kicad_pcb, ТКП-1.38.A-2.sch]
2025-05-04 ТКП-1.30.B-3 Big Muff [REV3B] NYC SM files added
    [ТКП-1.30.B-3.kicad_pcb, ТКП-1.30.B-3.sch]
2025-05-05 ТКП-1.30.B-4 Big Muff [REV3B] Bass SM files added
    [ТКП-1.30.B-4.kicad_pcb, ТКП-1.30.B-4.sch]
2025-05-08 ТКП-1.37.A-3 Little Angel Chorus/Vibrato [REV2A]: DWS.R1 and L.R6 values changed from X to 0, RPB1.1 and RPB1.2 replaced from R16K1-L15KC B50K to RV16AF-20-15K C50K
    [ТКП-1.37.A-3.kicad_pcb, ТКП-1.37.A-3.sch]
2025-05-08 ТКП-1.37.A-1 Little Angel Chorus [REV2A]: DWS.R1 and L.R6 values changed from X to 0, RPB1.1 and RPB1.2 replaced from R16K1-L15KC B50K to RV16AF-20-15K C50K
    [ТКП-1.37.A-1.kicad_pcb, ТКП-1.37.A-1.sch]
2025-05-08 ТКП-1.37.A-2 Big Devil Vibrato [REV2A]: DWS.R1 and L.R6 values changed from X to 0, RPB1.1 and RPB1.2 replaced from R16K1-L15KC B50K to RV16AF-20-15K C50K
    [ТКП-1.37.A-2.kicad_pcb, ТКП-1.37.A-2.sch]
2025-06-07 Big Muff [REV3SM] NYC: remaining engraving files added
    [ТКП-6.3.3-T-A1.4_dxf_outline.dxf]
2025-06-07 Big Muff [REV3SM] Bass: remaining engraving files added
    [ТКП-6.3.3-T-B1.4_dxf_outline.dxf]
2025-06-12 Deep Blue Delay [REV3SM]: remaining engraving files added
    [ТКП-6.3.3-T-C1.4_dxf_outline.dxf]
2025-06-12 ТКП-1.31.A-7 and ТКП-1.31.A-8 files added
    [ТКП-1.31.A-7.kicad_pcb, ТКП-1.31.A-7.sch, ТКП-1.31.A-8.kicad_pcb, ТКП-1.31.A-8.sch]
2025-06-12 ТКП-1.35.A-2 Great Depression Phaser Potentiometer Board [REV2A] files added
    [ТКП-1.35.A-2.kicad_pcb, ТКП-1.35.A-2.sch]
2025-06-12 ТКП-1.35.A-3 Little Angel Chorus Potentiometer Board [REV2A] files added
    [ТКП-1.35.A-3.kicad_pcb, ТКП-1.35.A-3.sch]
2025-06-17 ТКП-1.17.B-2 Deep Blue Delay [REV3B] SM: RP1…3 replaced from R16K1-L20F with PDB181-K415F, VE2 cipher changed from ТКП-6.3.3.A1.A1.2-1.A1.00 to ТКП-6.3.3.A1.A1.3-1.A1.00
    [ТКП-1.17.B-2.kicad_pcb, ТКП-1.17.B-2.sch]
2025-06-17 ТКП-1.17.C-2 Deep Blue Delay [REV3C] SM: VE2 cipher changed from ТКП-6.3.3.A1.A1.2-1.A1.00 to ТКП-6.3.3.A1.A1.3-1.A1.00
    [ТКП-1.17.C-2.kicad_pcb, ТКП-1.17.C-2.sch]
2025-06-19 ТКП-1.30.B-4 Big Muff [REV3B] Bass SM: remaining output files added
    [ТКП-1.30.B-4.kicad_pcb]
2025-06-19 ТКП-1.30.B-3 and ТКП-1.30.B-4: VE2 cipher changed from ТКП-6.3.3.A1.A1.2-1.A1.00 to ТКП-6.3.3.A1.A1.3-1.A1.00
    [ТКП-1.30.B-3.kicad_pcb, ТКП-1.30.B-3.sch, ТКП-1.30.B-4.kicad_pcb, ТКП-1.30.B-4.sch]
2025-06-21 ТКП-1.30.A-3 and ТКП-1.30.A-4: VE2 cipher changed from ТКП-6.3.3.A1.A1.2-1.A1.00 to ТКП-6.3.3.A1.A1.3-1.A1.00
    [ТКП-1.30.A-3.kicad_pcb, ТКП-1.30.A-3.sch, ТКП-1.30.A-4.kicad_pcb, ТКП-1.30.A-4.sch]
2025-06-21 ТКП-1.30.B-1 Big Muff [REV3B] NYC: some changes, output files added
    [ТКП-1.30.B-1.sch]
2025-06-21 ТКП-1.30.B-2 Big Muff [REV3B] Bass files added
    [ТКП-1.30.B-2.kicad_pcb, ТКП-1.30.B-2.sch]
2025-06-21 ТКП-1.30.A-5 and ТКП-1.30.A-6 files added
    [ТКП-1.30.A-5.kicad_pcb, ТКП-1.30.A-5.sch, ТКП-1.30.A-6.kicad_pcb, ТКП-1.30.A-6.sch]
2025-06-21 ТКП-1.30.B-5 and ТКП-1.30.B-6 files added
    [ТКП-1.30.B-5.kicad_pcb, ТКП-1.30.B-5.sch, ТКП-1.30.B-6.kicad_pcb, ТКП-1.30.B-6.sch]
2025-06-24 ТКП-1.21.A-2 Fishtaur [REV1A] SM: some changes
    [ТКП-1.21.A-2.kicad_pcb, ТКП-1.21.A-2.sch]
2025-06-24 ТКП-1.21.A-3 Fishtaur [REV1A] SM LC5-8 files added
    [ТКП-1.21.A-3.kicad_pcb, ТКП-1.21.A-3.sch]
2025-06-24 ТКП-1.21.A-1 Fishtaur [REV1A]: some changes
    [ТКП-1.21.A-1.kicad_pcb, ТКП-1.21.A-1.sch]
2025-08-09 SBEPL: ТКП-6.2.1.A1.A1.A added
2025-08-09 ТКП-1.38.A-2 Great Depression Phaser [REV1A] SM: minor changes
    [ТКП-1.38.A-2.kicad_pcb, ТКП-1.38.A-2.sch]
2025-08-10 ТКП-1.17.C-3 Deep Blue Delay [REV3C] SM LC5-8 files added
    [ТКП-1.17.C-3.kicad_pcb, ТКП-1.17.C-3.sch]
2025-11-02 ТКП-1.19.B-2 Good Grief Overdrive [REV1B] SM: top screws replaced from DIN 7985 with DIN 7380-1, washers removed
    [ТКП-1.19.B-2.sch]
2025-11-02 ТКП-1.21.A-2 Fishtaur [REV1A] SM: top screws replaced from DIN 7985 with DIN 7380-1, washers removed
    [ТКП-1.21.A-2.sch]
2025-11-02 ТКП-1.21.A-3 Fishtaur [REV1A] SM LC5-8: top screws replaced from DIN 7985 with DIN 7380-1, washers removed
    [ТКП-1.21.A-3.sch]
2025-11-04 ТКП-1.17.B-2 Deep Blue Delay [REV3B] SM: top screws replaced from DIN 7985 with DIN 7380-1
    [ТКП-1.17.B-2.sch]
2025-11-04 ТКП-1.17.C-2 Deep Blue Delay [REV3C] SM: top screws replaced from DIN 7985 with DIN 7380-1
    [ТКП-1.17.C-2.sch]
2025-11-04 ТКП-1.17.C-3 Deep Blue Delay [REV3C] SM LC5-8: top screws replaced from DIN 7985 with DIN 7380-1
    [ТКП-1.17.C-3.sch]
2025-11-04 ТКП-1.38.A-2 Great Depression Phaser [REV1A] SM: top screws replaced from DIN 7985 with DIN 7380-1
    [ТКП-1.38.A-2.sch]
2025-11-07 ТКП-1.31.A-9 Potentiometer Board 18 1x17 [REV1A] R16K1-15KC-B50K files added
    [ТКП-1.31.A-9.kicad_pcb, ТКП-1.31.A-9.sch]
2025-11-07 ТКП-1.36.A-3 Копка Земли [REV2A] Down-Tuned SM: RP1…6 replaced from R16K1-L20F with R16K1-L15KC, top screws replaced from DIN 7985 with DIN 7380-1
    [ТКП-1.36.A-3.sch]
2025-11-09 ТКП-1.30.A-3 Big Muff [REV3A] NYC SM: top screws replaced from DIN 7985 with DIN 7380-1
    [ТКП-1.30.A-3.sch]
2025-11-09 ТКП-1.30.A-4 Big Muff [REV3A] Bass SM: top screws replaced from DIN 7985 with DIN 7380-1
    [ТКП-1.30.A-4.sch]
2025-11-09 ТКП-1.30.B-3 Big Muff [REV3B] NYC SM: top screws replaced from DIN 7985 with DIN 7380-1
    [ТКП-1.30.B-3.sch]
2025-11-09 ТКП-1.30.B-4 Big Muff [REV3B] Bass SM: top screws replaced from DIN 7985 with DIN 7380-1
    [ТКП-1.30.B-4.sch]
2025-11-15 ТКП-1.30.A-5 Big Muff [REV3A] NYC SM LC5-8: top screws replaced from DIN 7985 with DIN 7380-1
    [ТКП-1.30.A-5.sch]
2025-11-15 ТКП-1.30.A-6 Big Muff [REV3A] Bass SM LC5-8: top screws replaced from DIN 7985 with DIN 7380-1
    [ТКП-1.30.A-6.sch]
2025-11-15 ТКП-1.30.B-5 Big Muff [REV3B] NYC SM LC5-8: top screws replaced from DIN 7985 with DIN 7380-1
    [ТКП-1.30.B-5.sch]
2025-11-15 ТКП-1.30.B-6 Big Muff [REV3B] Bass SM LC5-8: top screws replaced from DIN 7985 with DIN 7380-1
    [ТКП-1.30.B-6.sch]
2026-05-03 ТКП-1.12.A-1 Little Angel Chorus [REV1A]: some changes
    [ТКП-1.12.A-1.sch]
2026-05-05 SBKCL-TH-SL: SW-KN3-1-OR-MTS-101 and SW-KN3-1-OR-MTS-101-PNL-13.0 footprints added
2026-05-27 ТКП-1.36.A-5 Копка Земли [REV2A] Down-Tuned SM LC5-8 files added
    [ТКП-1.36.A-5.kicad_pcb, ТКП-1.36.A-5.sch]
2026-06-07 SBKCL-TH-ML: C-RECT-L18.0-W07.0-P15.24-d0.8-OR-CP-RADIAL-D05.0-P02.0-CLS and C-RECT-L18.0-W09.0-P15.24-d0.8-OR-CP-RADIAL-D05.0-P02.0-CLS footprints added
2026-06-07 SBKCL-TH-ML: RPB-18-1x17-1.6 footprint added
2026-06-09 ТКП-1.40.A-1 Clipper A [REV1A] files added
    [ТКП-1.40.A-1.kicad_pcb, ТКП-1.40.A-1.sch]
2026-06-10 ТКП-1.40.A-1 Clipper A [REV1A]: some changes
    [ТКП-1.40.A-1.kicad_pcb]
2026-06-11 ТКП-3.44.A Clipper A [REV1A]: some changes, gerbers added
    [clipper_a_r1a-B_Cu.gbr, clipper_a_r1a-B_Mask.gbr, clipper_a_r1a-B_SilkS.gbr, clipper_a_r1a-Edge_Cuts.gbr, clipper_a_r1a-F_Cu.gbr, clipper_a_r1a-F_Mask.gbr, clipper_a_r1a-F_Paste.gbr, clipper_a_r1a-F_SilkS.gbr]
2026-07-03 ТКП-1.41.A-1 OCD [REV4A] files added
    [ТКП-1.41.A-1.kicad_pcb, ТКП-1.41.A-1.sch]
2026-07-04 ТКП-1.40.A-1 Clipper A [REV1A]: minor changes
    [ТКП-1.40.A-1.sch]
2026-07-15 ТКП-3.45.A OCD [REV4A]: some changes, gerbers added
    [ocd_r4a-B_Cu.gbr, ocd_r4a-B_Mask.gbr, ocd_r4a-B_SilkS.gbr, ocd_r4a-Edge_Cuts.gbr, ocd_r4a-F_Cu.gbr, ocd_r4a-F_Mask.gbr, ocd_r4a-F_Paste.gbr, ocd_r4a-F_SilkS.gbr]
2026-07-21 ТКП-1.40.A-1 Clipper A [REV1A]: LED voltage regulator added
    [ТКП-1.40.A-1.kicad_pcb, ТКП-1.40.A-1.sch]
2026-08-02 Little Angel Chorus/Vibrato [REV2]: some UV-printing files added
2026-08-19 Крыса [REV1]: UV-DTF-sticker master file added
2026-08-31 ТКП-1.41.A-1 OCD [REV4A]: LED voltage regulator added, output files added
2026-10-19 ТКП-1.40.A-2 Крыса [REV1A] files added
2026-10-19 ТКП-1.40.A-1 Крыса [REV1A]: some changes
2026-10-19 ТКП-1.40.A-1 Крыса [REV1A]: output files added
